nunosousa/TelescopeMirrorTester/CAD/CAD files/UM90S.png

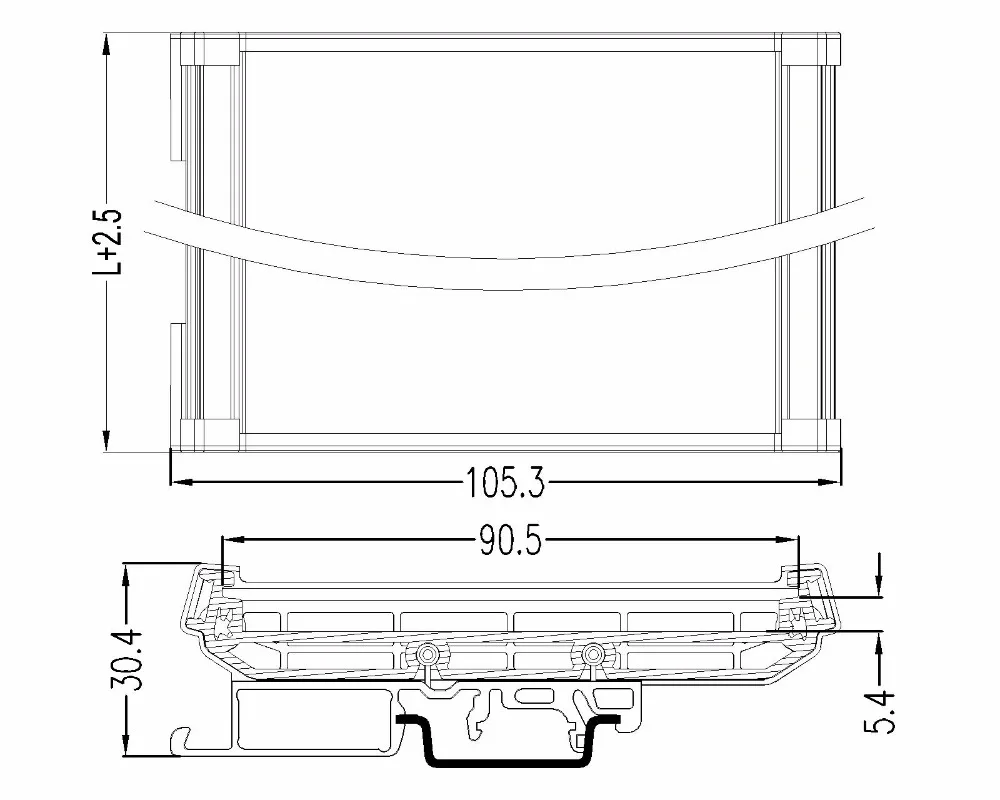
CAD/CAD files/UM90S.png
