nunosousa/TelescopeMirrorTester/CAD/Rail support/H54447d9d5b0a41b6863aeb1bf7cac8f4W.webp

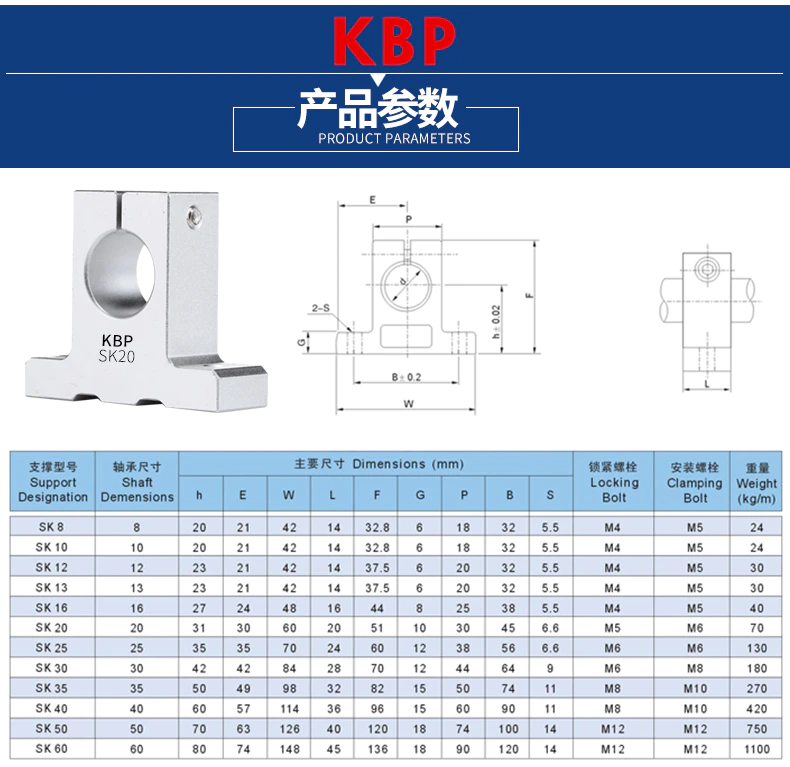
CAD/Rail support/H54447d9d5b0a41b6863aeb1bf7cac8f4W.webp
