nunosousa/TelescopeMirrorTester/CAD/Rail support/HTB1I.vIcCWD3KVjSZSgq6ACxVXax.webp

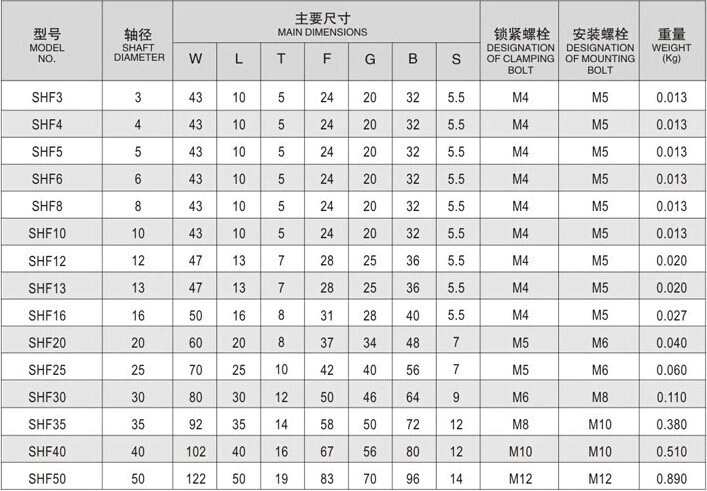
CAD/Rail support/HTB1I.vIcCWD3KVjSZSgq6ACxVXax.webp
