nunosousa/TelescopeMirrorTester/CAD/Rail support/HTB1lkTEcvWG3KVjSZPcq6zkbXXaa.webp

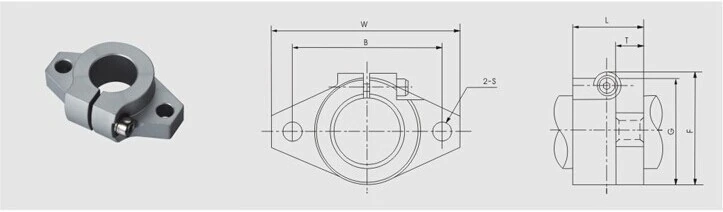
CAD/Rail support/HTB1lkTEcvWG3KVjSZPcq6zkbXXaa.webp
