nunosousa/TelescopeMirrorTester/Software/Jupyter Notebooks/Shadowgram analysis/Datasets/(165) 13_06_2019/1/Image_0.3.png

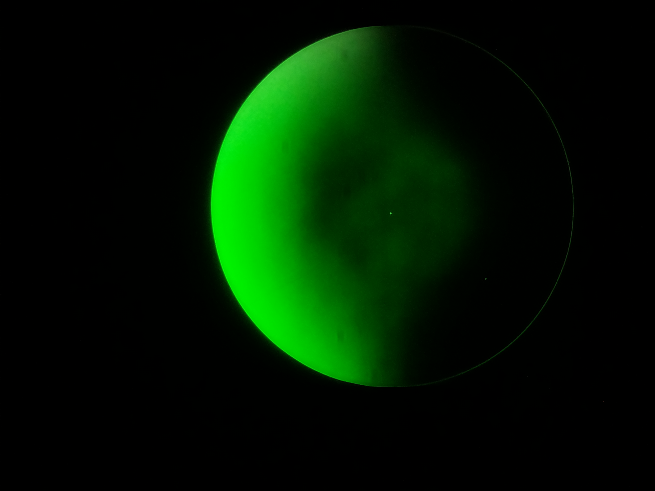
Software/Jupyter Notebooks/Shadowgram analysis/Datasets/(165) 13_06_2019/1/Image_0.3.png
