nunosousa/TelescopeMirrorTester/Tester/CAD/3D_Stage_Assembly.FCStd

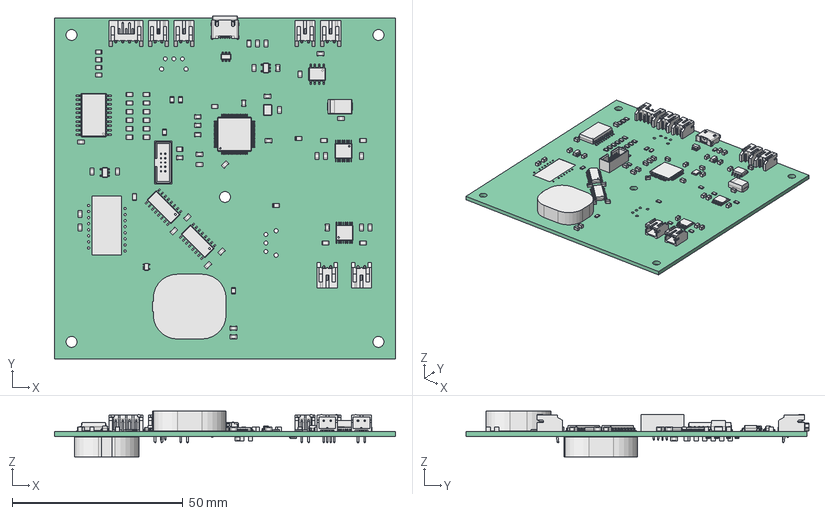
[picture p14: CAD file, 2021-06-24]
Tester/CAD/3D_Stage_Assembly.FCStd
100.0 x 100.5 x 13.4 mm
Pcb_7b95
U9_Body_5EACCE19 x 2
J6_3220-10-0100-00_5EB1DA68
J9_629105150521_5EAFFDDF[2]
U15_TQFP_64_10x10mm_P05mm_5EB077FD
R32_R_0805_2012Metric_5EACCCC9 x 32
Y2_Crystal_SMD_3225-4Pin_3.2x2.5mm_HandSoldering_5EACF838
C44_C_0805_2012Metric_5EACF763 x 44
U14_TSSOP_16_44x5mm_P065mm_5EACCE9F x 2
U13_SOT_353_SC_70_5_5EACCE7F
U12_SOIC_16_39x99mm_P127mm_5EAE1148 x 2
U11_SOT_23_5_5EACCE48 x 2
U6_SOIC_8_39x49mm_P127mm_5EACCDB5
U5_SO_20_128x75mm_P127mm_5EAE9272
U2_SOT_23_6_5EB04936
J13_JST_S4B_PH_K_5EACCA7D
J12_JST_S2B_PH_K_5EACCA4C x 6
FB2_L_0805_2012Metric_5EACF6C7 x 2
C11_CP_EIA_7343_31_Kemet_D_5EACC65A
