nunosousa/TelescopeMirrorTester/CAD/Assemblies/Elevation_Plate_Assembly.FCStd

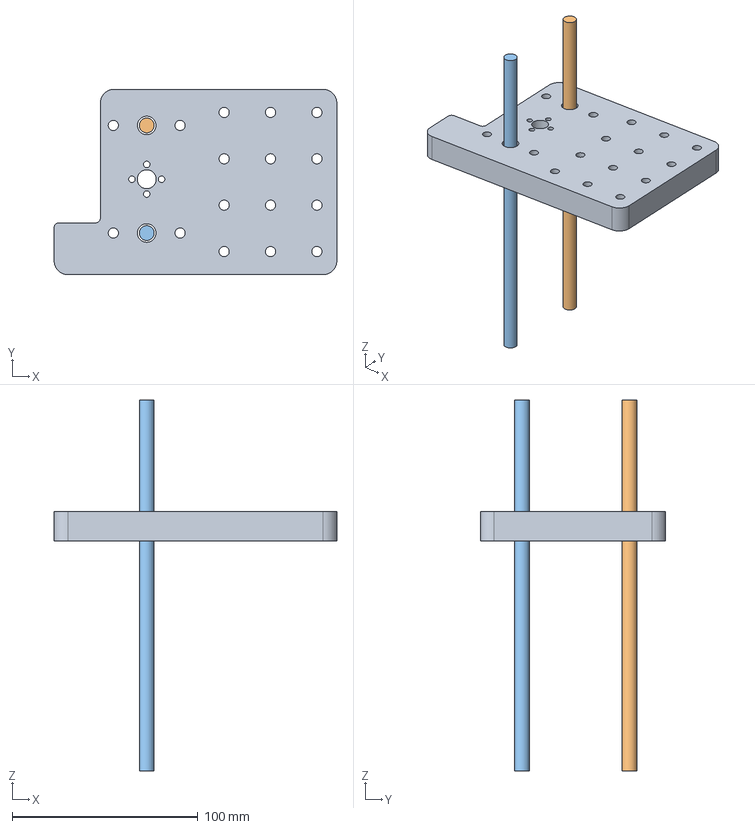
[picture p15: CAD file, 2025-04-18]
CAD/Assemblies/Elevation_Plate_Assembly.FCStd
152.4 x 100.0 x 200.0 mm
Translation_Stage_XYZ_b-Elevation_PlatePad003_001
Rod_200mm_001
Rod_200mm_002
