nunosousa/TelescopeMirrorTester/CAD/Micrometer/Micrometer_Assembly_25mm.FCStd

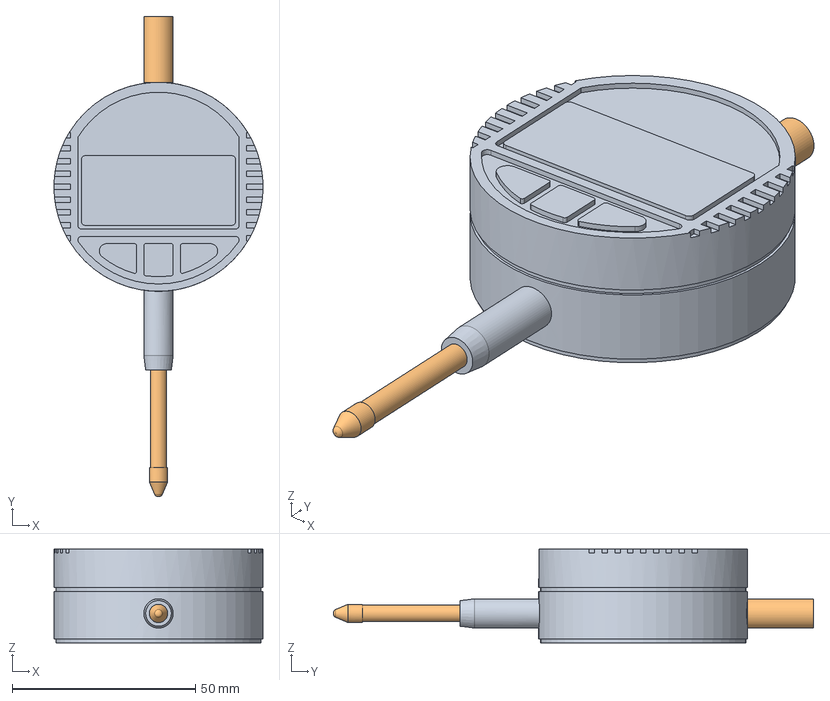
[picture p16: CAD file, 2022-04-01]
CAD/Micrometer/Micrometer_Assembly_25mm.FCStd
57.0 x 131.0 x 25.5 mm
Micrometer_Body_001
Micrometer_Plunger_001
