nunosousa/TelescopeMirrorTester/CAD/Assemblies/Z_Translation_Assembly.FCStd

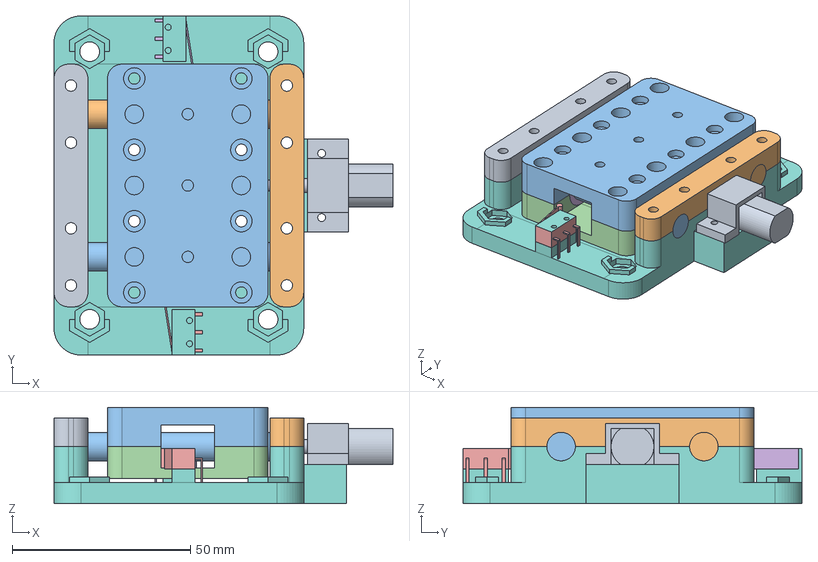
[picture p17: CAD file, 2022-08-31]
CAD/Assemblies/Z_Translation_Assembly.FCStd
95.0 x 95.0 x 27.0 mm
DC_Motor_Assembly_001
Rod_70mm_001
Rod_70mm_002
Bushing_001
Bushing_002
Bushing_003
Bushing_004
Base
Brace_front
Brace_back
Top
Brace_top
Limit_Switch_001
Limit_Switch_002
