nunosousa/TelescopeMirrorTester/CAD/Assemblies/Foucault_Assembly.FCStd

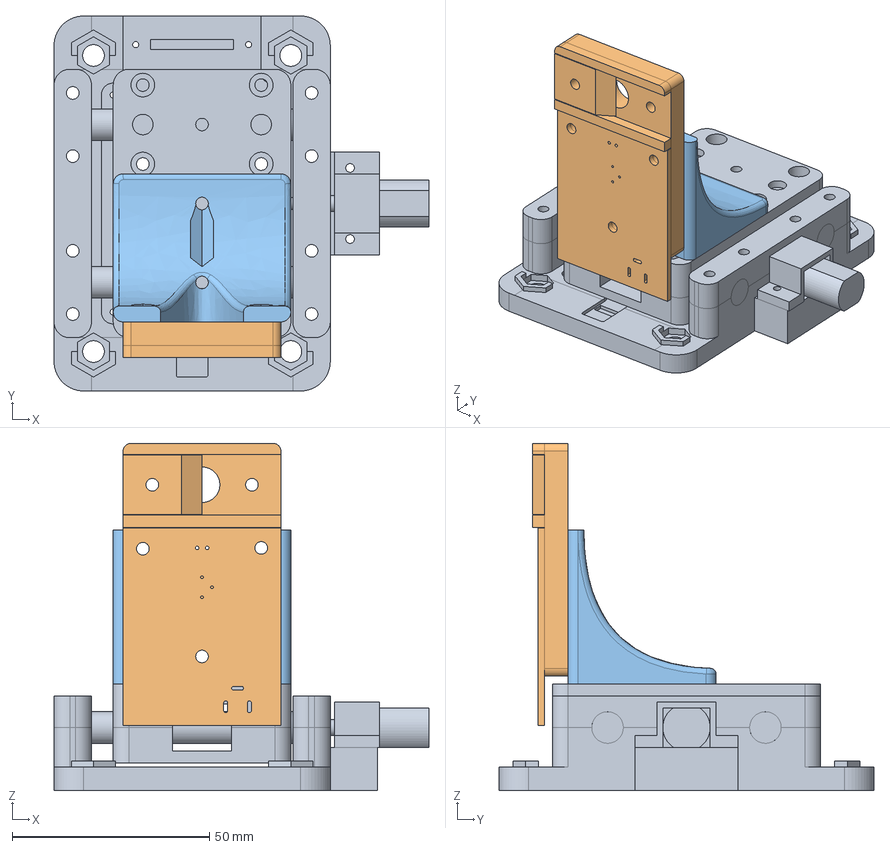
[picture p18: CAD file, 2022-07-24]
CAD/Assemblies/Foucault_Assembly.FCStd
95.0 x 95.0 x 88.0 mm
Z_Translation_Assembly_001
Foucault_test_head_001
Test_head_support
