nunosousa/TelescopeMirrorTester/CAD/Assemblies/X_Translation_Assembly_w_Micrometer.FCStd

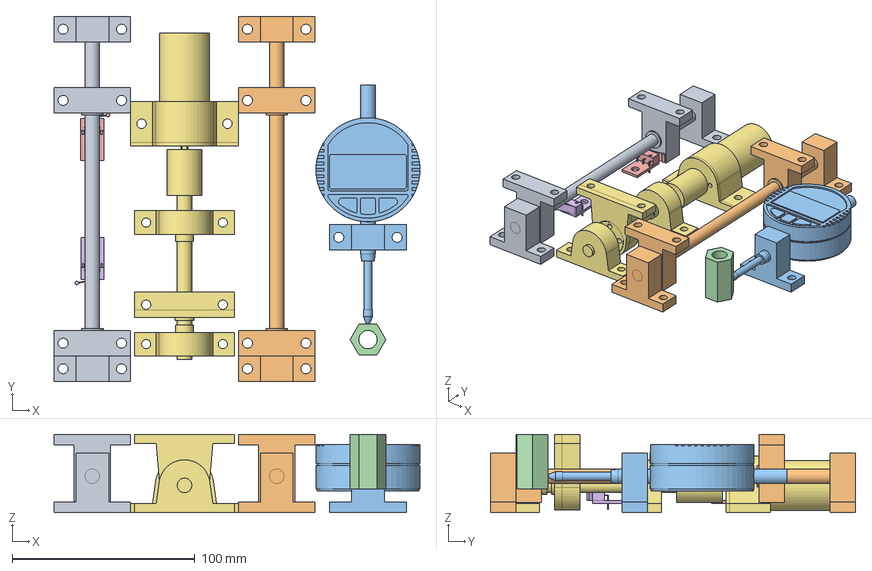
[picture p19: CAD file, 2022-06-13]
CAD/Assemblies/X_Translation_Assembly_w_Micrometer.FCStd
200.5 x 200.0 x 43.0 mm
Translation_axis_200mm_25mm_001
Translation_axis_200mm_25mm_002
Monted_Micrometer_001
Hex_Spacer_Nut_001
Limit_Switch_Board_001
Limit_Switch_Board_002
Position_screw_assembly_w_Motor_001
