nunosousa/TelescopeMirrorTester/CAD/Assemblies/Y_Translation_Assembly.FCStd

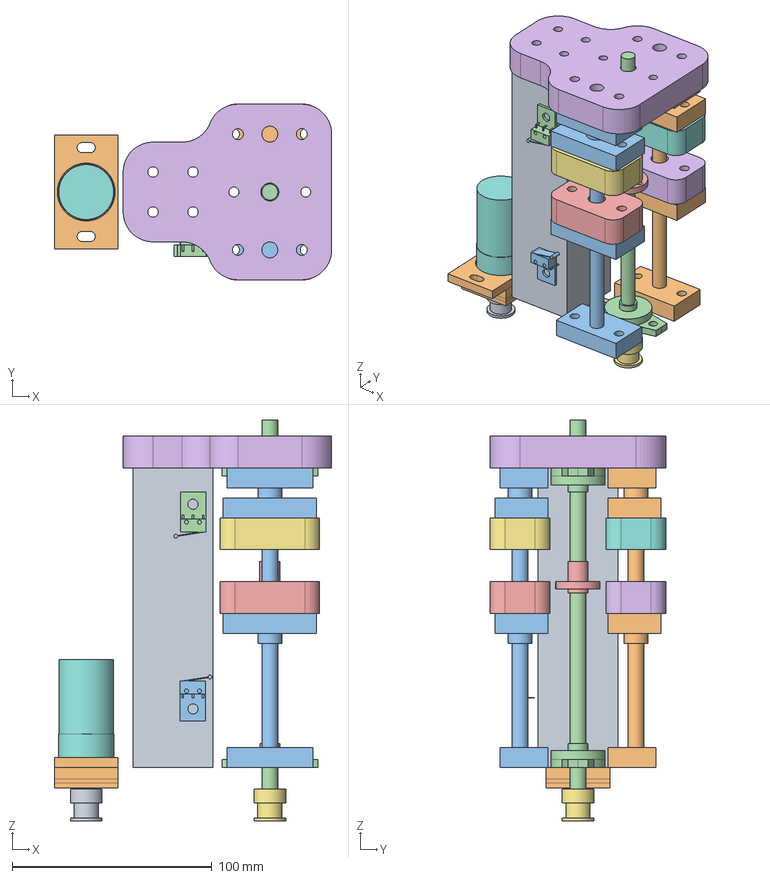
[picture p20: CAD file, 2022-06-13]
CAD/Assemblies/Y_Translation_Assembly.FCStd
139.0 x 88.0 x 200.9 mm
4040_profile_001
Translation_axis_150mm_vertical_001
Translation_axis_150mm_vertical_002
Position_screw_assembly_vertical_001
T8_nut_001
Top
GT2_20_pulley_001
DC_Motor_001
GT2_20_pulley_002
Motor_Mount
Limit_Switch_Board_001
Limit_Switch_Board_002
Stabilizer
Stabilizer001
Stabilizer002
Stabilizer003
