nunosousa/TelescopeMirrorTester/CAD/CAD files/Y_Translation_Assembly-Stabilizer003.iges

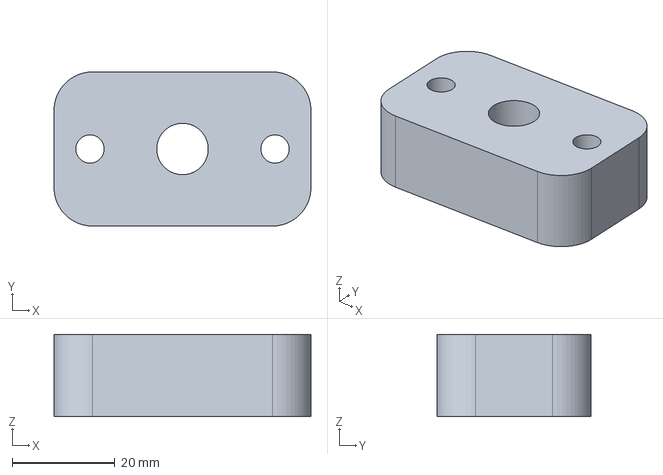
[picture p21: CAD file, 2022-06-13]
CAD/CAD files/Y_Translation_Assembly-Stabilizer003.iges
50.0 x 30.0 x 16.0 mm
