nunosousa/TelescopeMirrorTester/CAD/Assemblies/Base_X_Translation_Assembly_w_Motor.FCStd

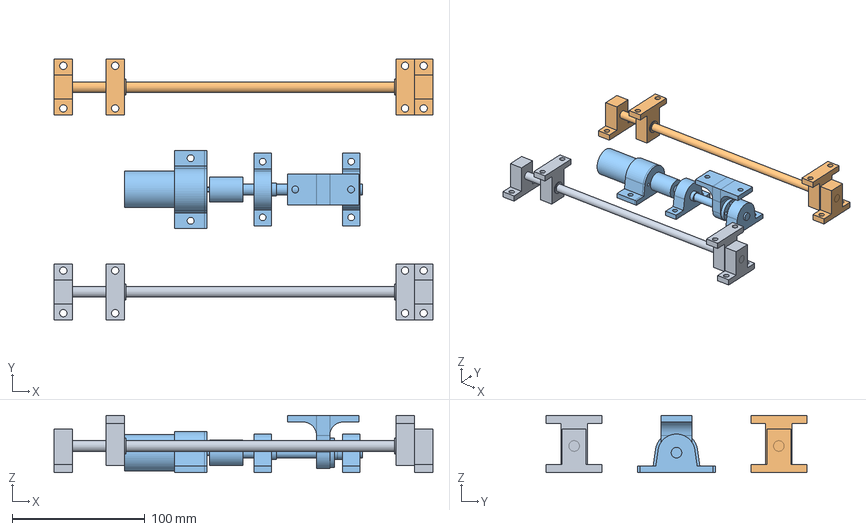
[picture p22: CAD file, 2022-06-04]
CAD/Assemblies/Base_X_Translation_Assembly_w_Motor.FCStd
285.0 x 196.0 x 43.0 mm
Translation_axis_285mm_25mm_001
Translation_axis_285mm_25mm_002
Position_screw_assembly_001
