nunosousa/TelescopeMirrorTester/CAD/Assemblies/DC_Motor_Assembly.FCStd

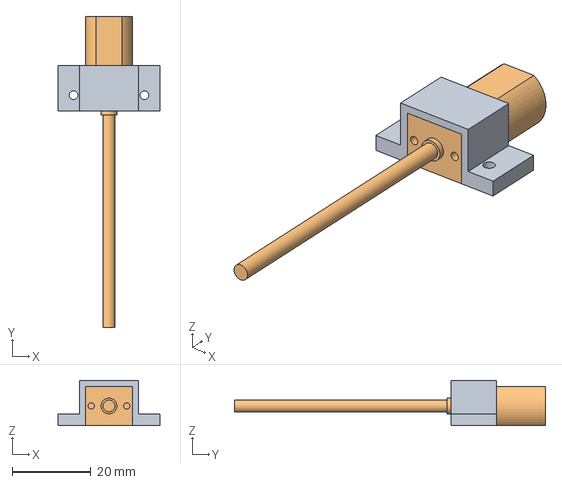
[picture p23: CAD file, 2022-05-07]
CAD/Assemblies/DC_Motor_Assembly.FCStd
26.0 x 79.0 x 11.5 mm
Motor mount
Motor
