nunosousa/TelescopeMirrorTester/CAD/CAD files/Y_Translation_Assembly-Motor_Mount.iges

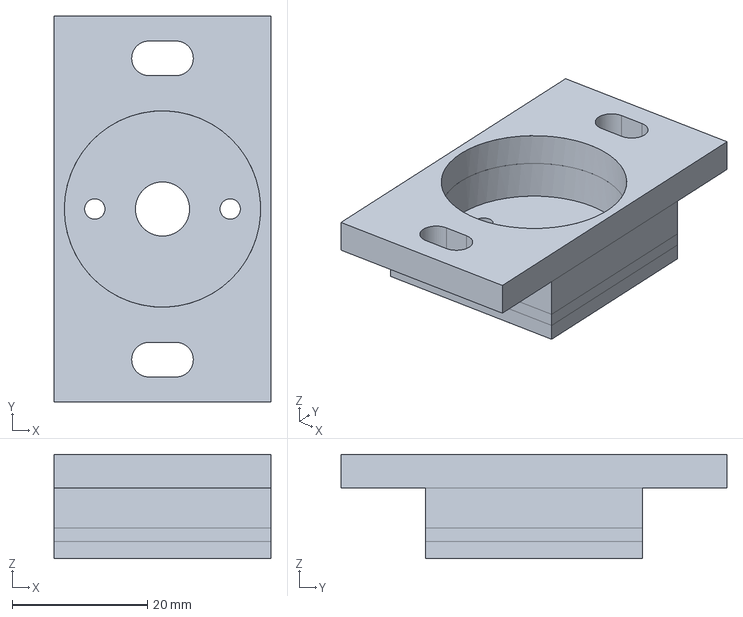
[picture p24: CAD file, 2022-06-13]
CAD/CAD files/Y_Translation_Assembly-Motor_Mount.iges
32.0 x 57.0 x 15.4 mm
