nunosousa/TelescopeMirrorTester/CAD/CAD files/Y_Translation_Assembly-Top.iges

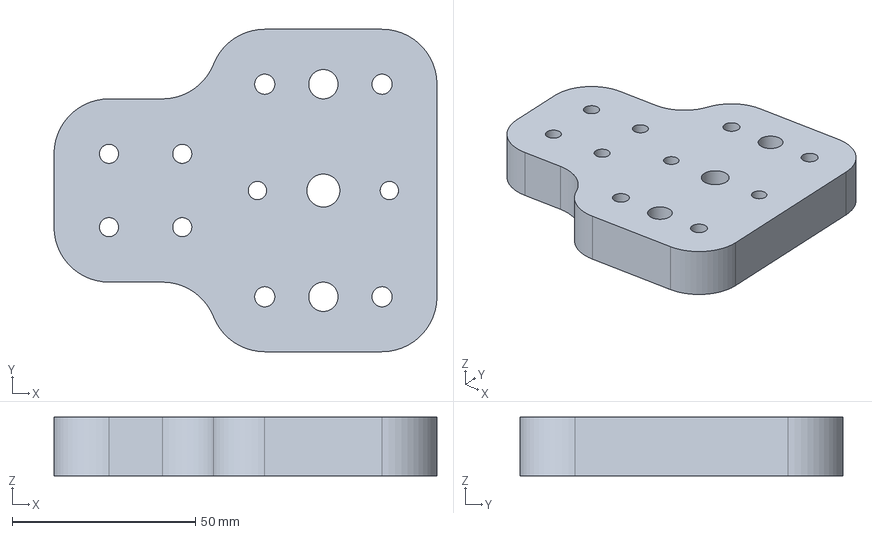
[picture p25: CAD file, 2022-06-13]
CAD/CAD files/Y_Translation_Assembly-Top.iges
104.5 x 88.0 x 16.0 mm
