nunosousa/TelescopeMirrorTester/CAD/Assemblies/Arduino_Mega_mount.FCStd

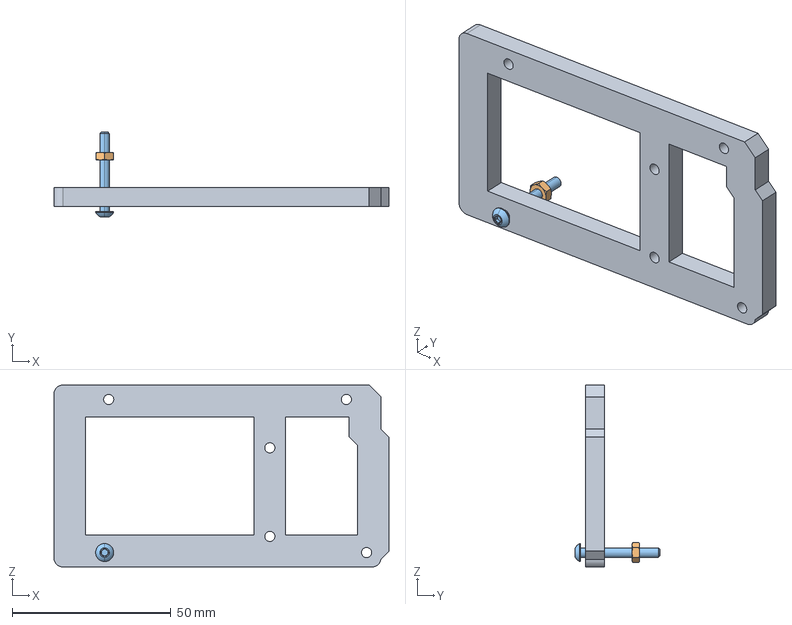
[picture p26: CAD file, 2025-05-03]
CAD/Assemblies/Arduino_Mega_mount.FCStd
105.6 x 26.7 x 57.3 mm
ArduinoMount
90591A250_NO THREADS_Zinc-Plated Steel Hex Nut1_001
97763A457_NO THREADS_18-8 Stainless Steel Button Head Hex Drive Screws1_001
