nunosousa/TelescopeMirrorTester/CAD/CAD files/Connectors/EP501A.STEP

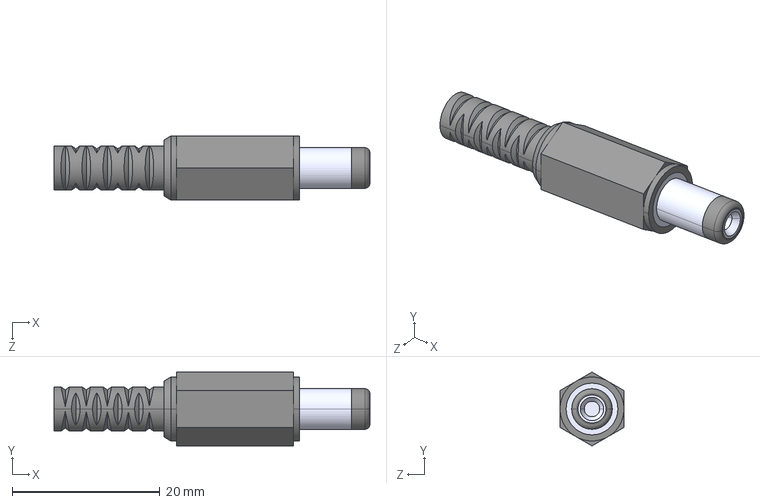
[picture p27: CAD file, 2025-05-03]
CAD/CAD files/Connectors/EP501A.STEP
42.8 x 10.0 x 8.66 mm
