nunosousa/TelescopeMirrorTester/CAD/CAD files/Couplers/CXJJ-D-D16-d3-e8.step

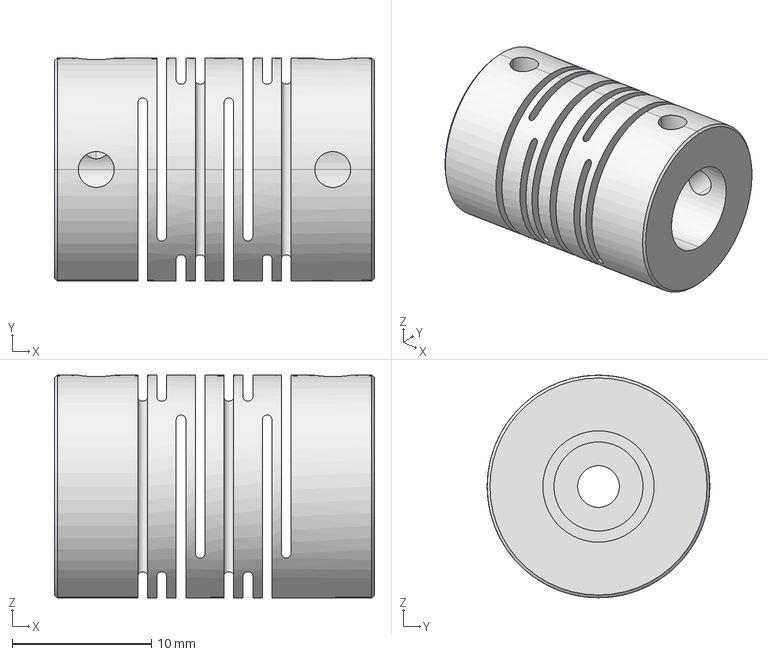
[picture p28: CAD file, 2025-05-02]
CAD/CAD files/Couplers/CXJJ-D-D16-d3-e8.step
23.0 x 16.0 x 16.0 mm
