nunosousa/TelescopeMirrorTester/CAD/CAD files/Motors/Micro_DC_Gearmotor-90_Degree.step

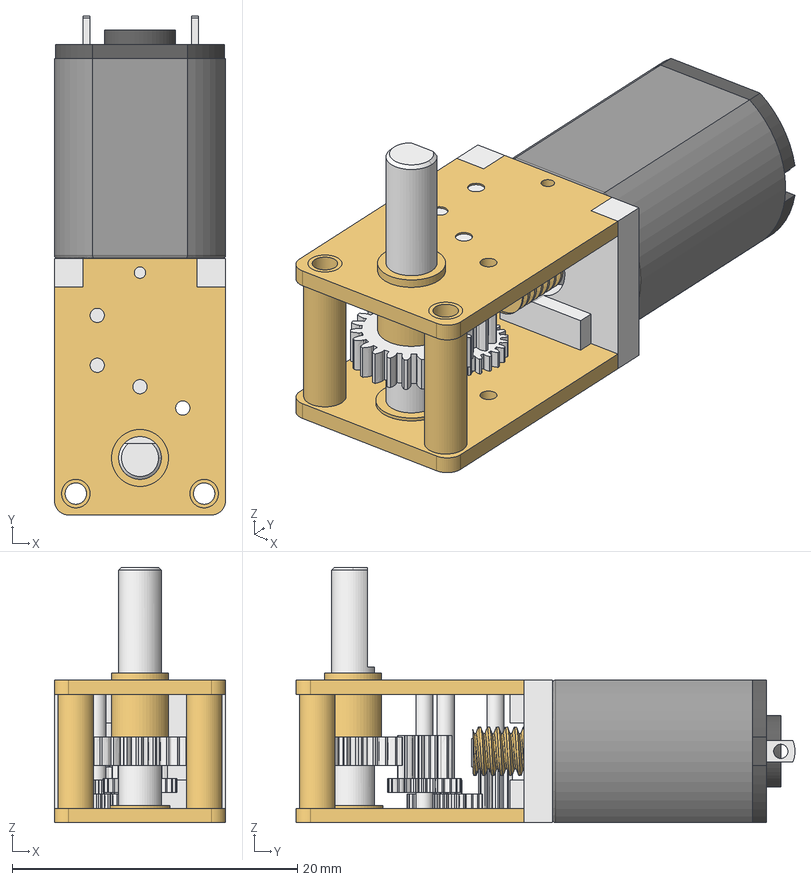
[picture p29: CAD file, 2025-05-03]
CAD/CAD files/Motors/Micro_DC_Gearmotor-90_Degree.step
12.0 x 35.0 x 17.9 mm
Körper
Lager
Kontakt
Kontakt001
MotorPlate
GearCase_Top
GearCase_Bot
Welle
Welle_001
Welle_002
Welle_003
WormGear
InvoluteGear
InvoluteGear001
InvoluteGear002
InvoluteGear003
InvoluteGear004
InvoluteGear005
InvoluteGear006
Huelse
Huelse001
Tube006
