nunosousa/TelescopeMirrorTester/CAD/Micrometer/Micrometer_Plunger.FCStd

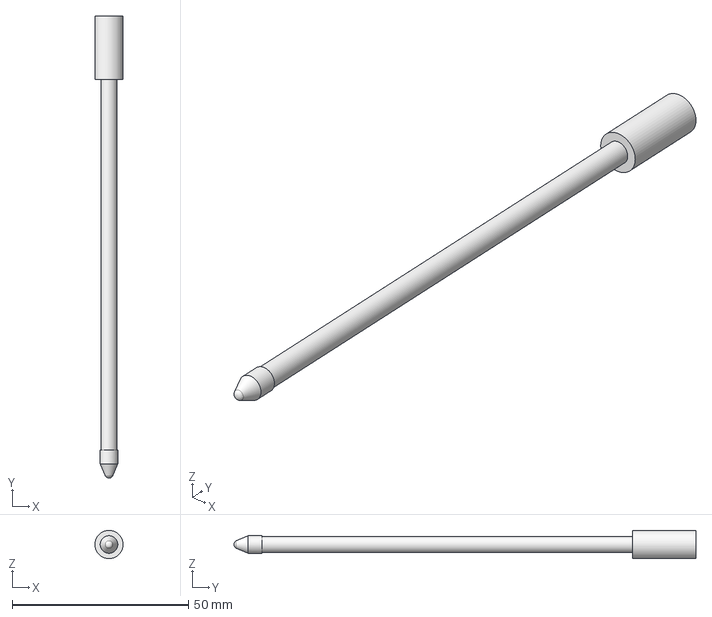
[picture p30: CAD file, 2022-04-01]
CAD/Micrometer/Micrometer_Plunger.FCStd
7.99 x 131.0 x 8.00 mm
