nunosousa/TelescopeMirrorTester/CAD/Misc/Disc_Magnet_6x3.FCStd

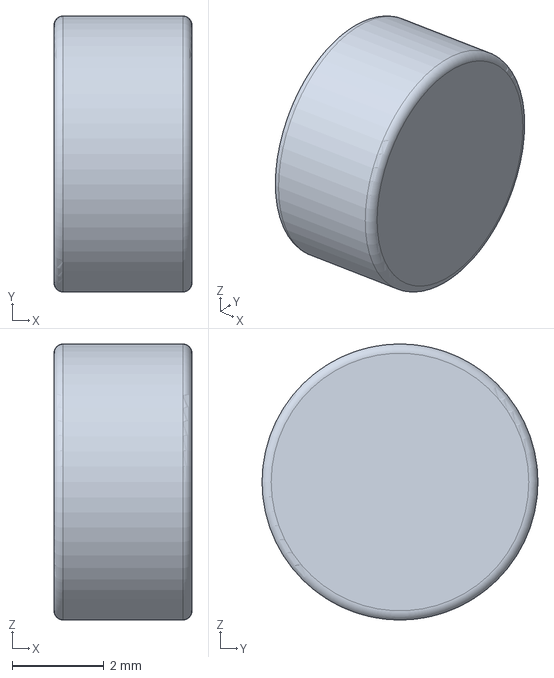
[picture p31: CAD file, 2025-04-09]
CAD/Misc/Disc_Magnet_6x3.FCStd
3.00 x 6.00 x 6.00 mm
