nunosousa/TelescopeMirrorTester/CAD/Rail support/Rod_70mm.FCStd

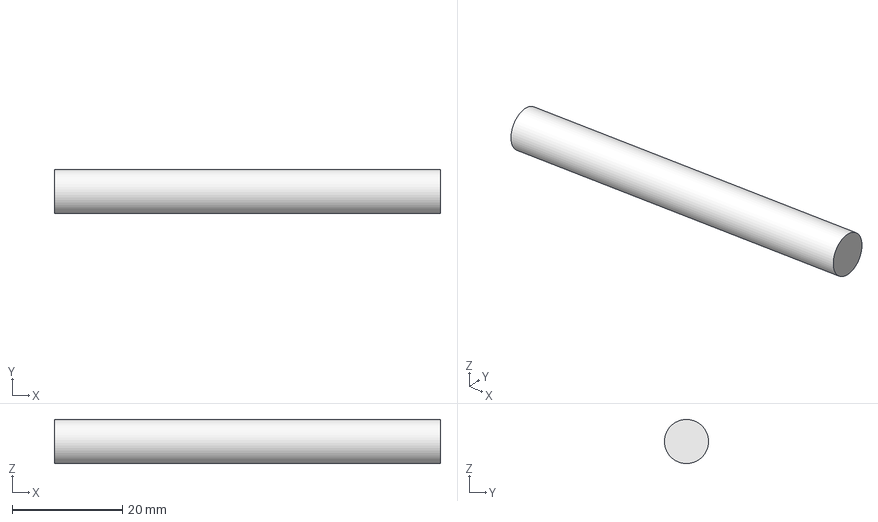
[picture p32: CAD file, 2022-07-12]
CAD/Rail support/Rod_70mm.FCStd
70.0 x 7.99 x 8.00 mm
