nunosousa/TelescopeMirrorTester/CAD/Translation_Stage_XYZ.FCStd

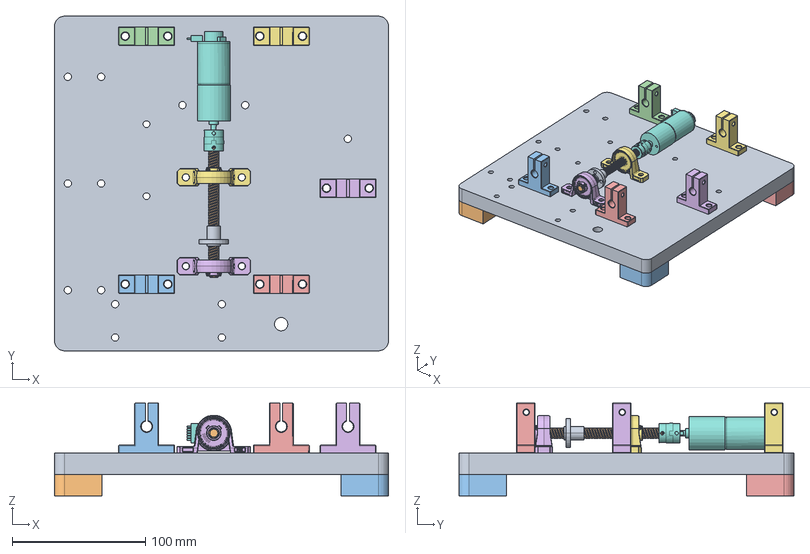
[picture p33: CAD file, 2025-05-02]
CAD/Translation_Stage_XYZ.FCStd
250.5 x 251.0 x 69.5 mm
Translation_Stage_XYZ_b-Base_Plate1_001
Translation_Stage_XYZ_b-Foot1_001
Translation_Stage_XYZ_b-Foot1_002
Translation_Stage_XYZ_b-Foot1_003
Translation_Stage_XYZ_b-Foot1_004
KP08_001
KP08_002
JGA25-371_12VDC_18RPM1_001
T8 nut1_001
Linear_rod_100mm1_001
SK8_001
SK8_002
SK8_003
SK8_004
SK8_005
CXHY-15-d4-e9_001
