nunosousa/TelescopeMirrorTester/ECAD/BDCMotorControlBoard/BDCMotorControlBoard.step

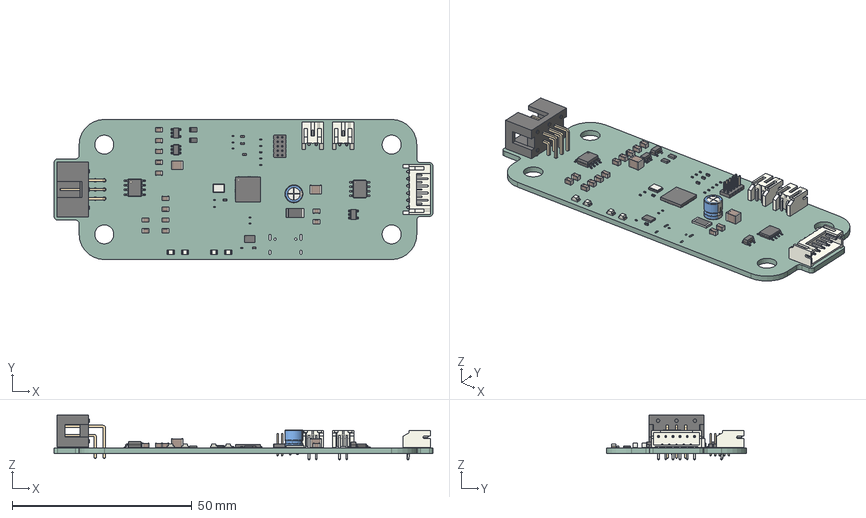
[picture p34: CAD file, 2025-05-23]
ECAD/BDCMotorControlBoard/BDCMotorControlBoard.step
105.5 x 39.0 x 12.5 mm
C_0805_2012Metric x 13
JST_PH_S2B-PH-K_1x02_P2.00mm_Horizontal x 2
C_0201_0603Metric x 11
Crystal_SMD_3225-4Pin_3.2x2.5mm
C_0402_1005Metric x 4
PinHeader_2x05_P1.27mm_Vertical
C_1210_3225Metric x 2
SOIC-8_3.9x4.9mm_P1.27mm
R_2010_5025Metric
R_0201_0603Metric x 2
IDC-Header_2x03_P2.54mm_Horizontal
LED_0805_2012Metric x 4
SOT-23-5 x 2
Texas_HTSOP-8-1EP_3.9x4.9mm_P1.27mm_EP2.85x4.9mm_Mask2.4x3.1mm_ ThermalVias
R_0805_2012Metric x 2
JST_PH_S6B-PH-K_1x06_P2.00mm_Horizontal
CP_Radial_D5.0mm_P2.00mm
R_0402_1005Metric
SOT-23-6
Winbond_USON-8-1EP_3x2mm_P0.5mm_EP0.2x1.6mm
QFN-56-1EP_7x7mm_P0.4mm_EP3.2x3.2mm
BDCMotorControlBoard_PCB
