nunosousa/TelescopeMirrorTester/ECAD/LightSource/LightSource.step

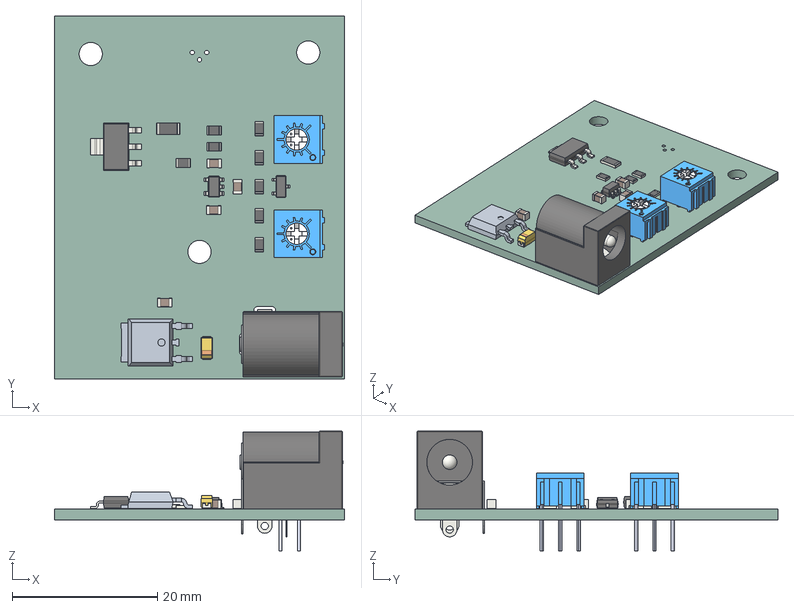
[picture p35: CAD file, 2025-04-15]
ECAD/LightSource/LightSource.step
40.0 x 50.0 x 16.5 mm
C_0805_2012Metric x 4
CP_EIA-3216-18_Kemet-A
BarrelJack_Horizontal
R_0805_2012Metric x 8
R_1206_3216Metric
3362P-1-501LF x 2
LightSource 1.10.1
SOT-223
SOT-23
SOT-23-5
LightSource_PCB
