nunosousa/TelescopeMirrorTester/ECAD/LimitSwitchBoard/LimitSwitchBoard.step

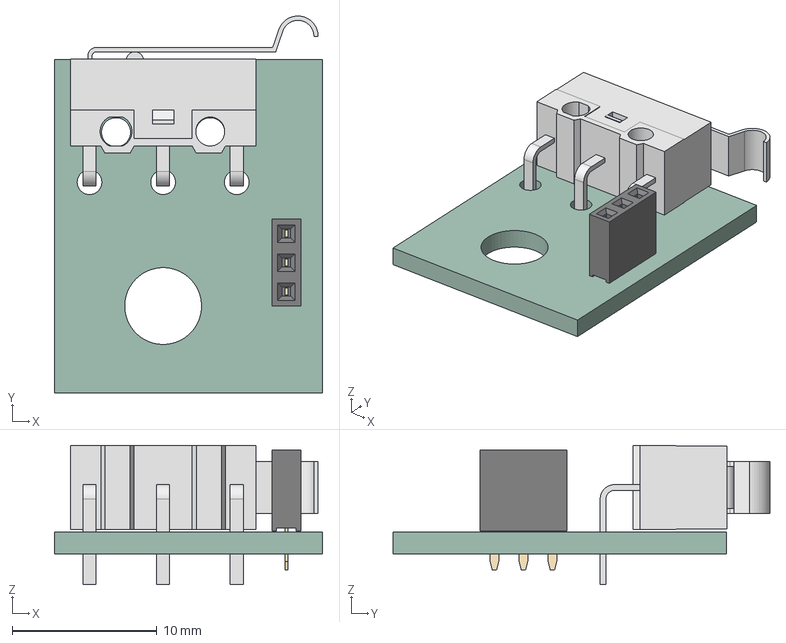
[picture p36: CAD file, 2025-04-19]
ECAD/LimitSwitchBoard/LimitSwitchBoard.step
18.5 x 26.0 x 9.60 mm
PinSocket_1x03_P2.00mm_Vertical
LimitSwitchBoard_PCB
