nunosousa/TelescopeMirrorTester/ECAD/PowerDeliveryBoard/PowerDeliveryBoard.step

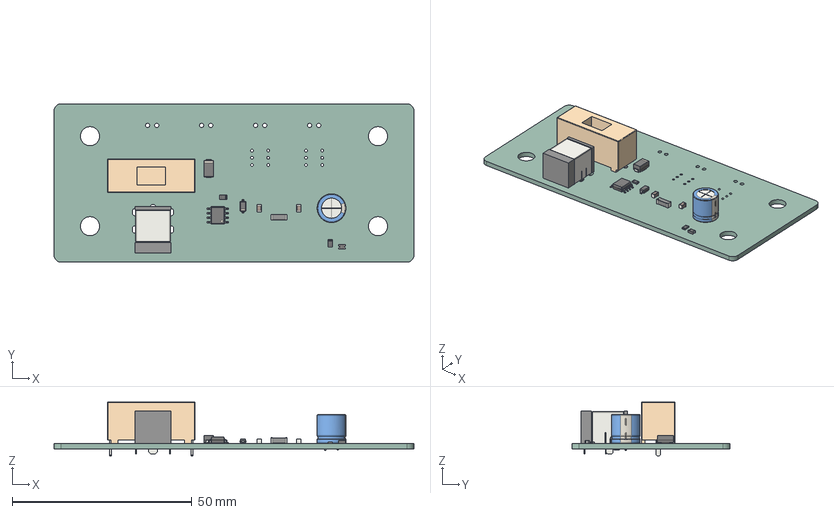
[picture p37: CAD file, 2025-05-01]
ECAD/PowerDeliveryBoard/PowerDeliveryBoard.step
100.0 x 44.0 x 15.0 mm
C_0805_2012Metric x 2
D_0805_2012Metric
CP_Radial_D8.0mm_P3.50mm
Fuseholder_Cylinder-5x20mm_Stelvio-Kontek_PTF78_Horizontal_Open
R_0805_2012Metric x 2
BarrelJack_CUI_PJ-063AH_Horizontal
D_SMA
L_1806_4516Metric
SOIC-8_3.9x4.9mm_P1.27mm
D_SOD-123
PowerDeliveryBoard_PCB
