nunosousa/TelescopeMirrorTester/ECAD/RotationEncoder/RotationEncoder.step

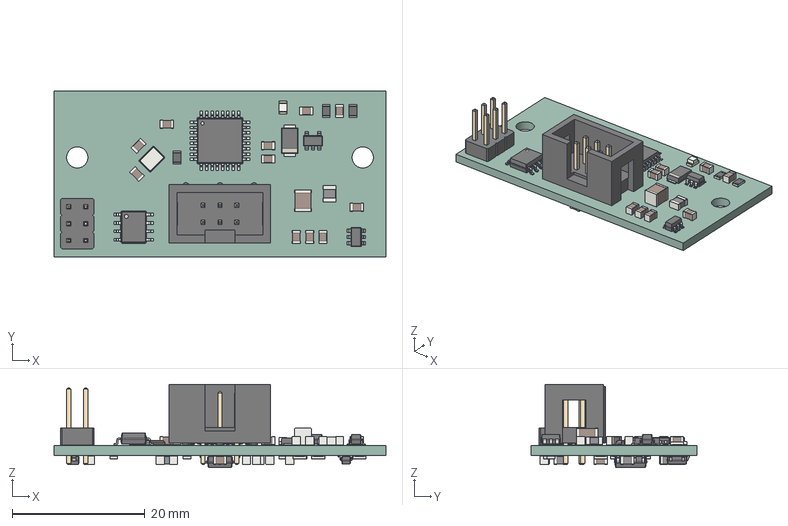
[picture p38: CAD file, 2025-04-09]
ECAD/RotationEncoder/RotationEncoder.step
50.0 x 25.0 x 12.5 mm
C_0805_2012Metric x 17
LED_0805_2012Metric
SOT-23-6
L_1008_2520Metric
SOIC-8_3.9x4.9mm_P1.27mm x 2
IDC-Header_2x03_P2.54mm_Vertical
SOT-23-5
R_0805_2012Metric x 11
TQFP-32_7x7mm_P0.8mm
D_SOD-128
Crystal_SMD_3225-4Pin_3.2x2.5mm
PinHeader_2x03_P2.54mm_Vertical
C_1210_3225Metric
L_0805_2012Metric x 4
SOT-23
D_SOD-123
RotationEncoder_PCB
