nunosousa/TelescopeMirrorTester/ECAD/RS232Board/RS232Board.step

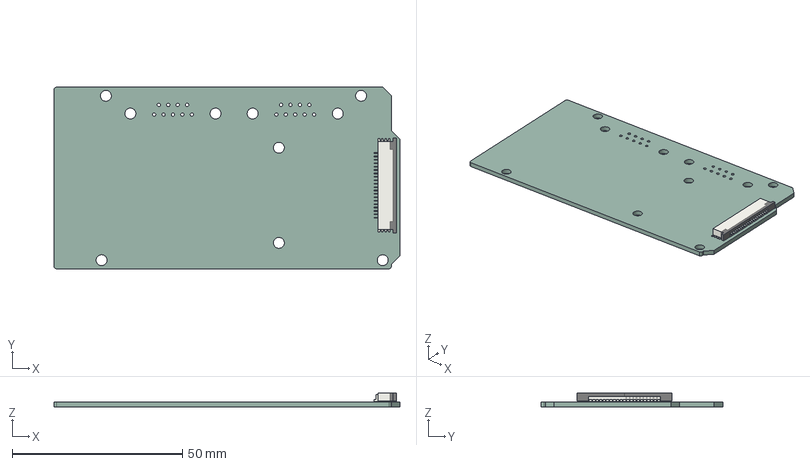
[picture p39: CAD file, 2025-05-01]
ECAD/RS232Board/RS232Board.step
101.6 x 53.3 x 4.16 mm
TE_2-84952-0_1x20-1MP_P1.0mm_Horizontal
RS232Board_PCB
