nunosousa/TelescopeMirrorTester/CAD/ArduinoMount.FCStd

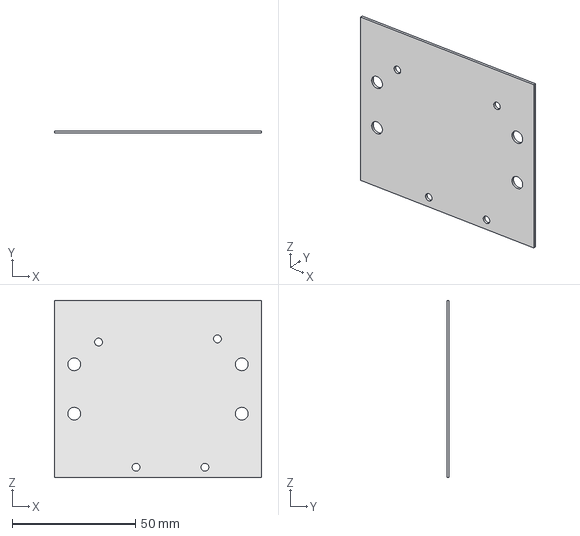
[picture p40: CAD file, 2023-01-05]
CAD/ArduinoMount.FCStd
84.0 x 1.00 x 72.0 mm
