nunosousa/TelescopeMirrorTester/CAD/CAD files/Couplers/CXHY-15-d4-e8.step

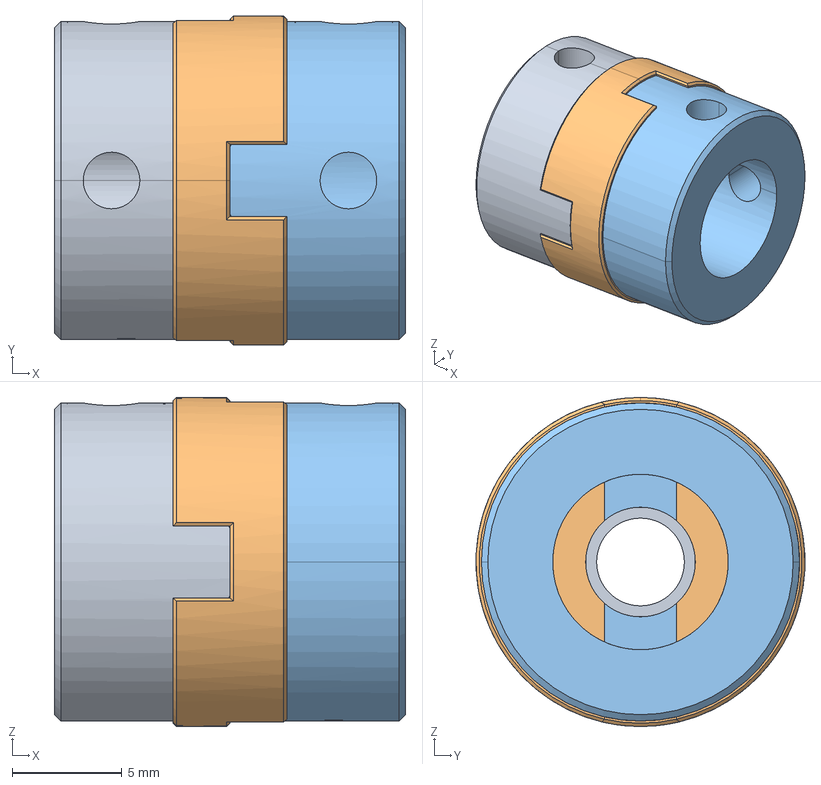
[picture p41: CAD file, 2025-05-02]
CAD/CAD files/Couplers/CXHY-15-d4-e8.step
16.0 x 15.0 x 15.0 mm
11^1746181201219
22^1746181201219
33^1746181201219
