nunosousa/TelescopeMirrorTester/CAD/CAD files/Motors/JGA25-371_12VDC_18RPM.stp

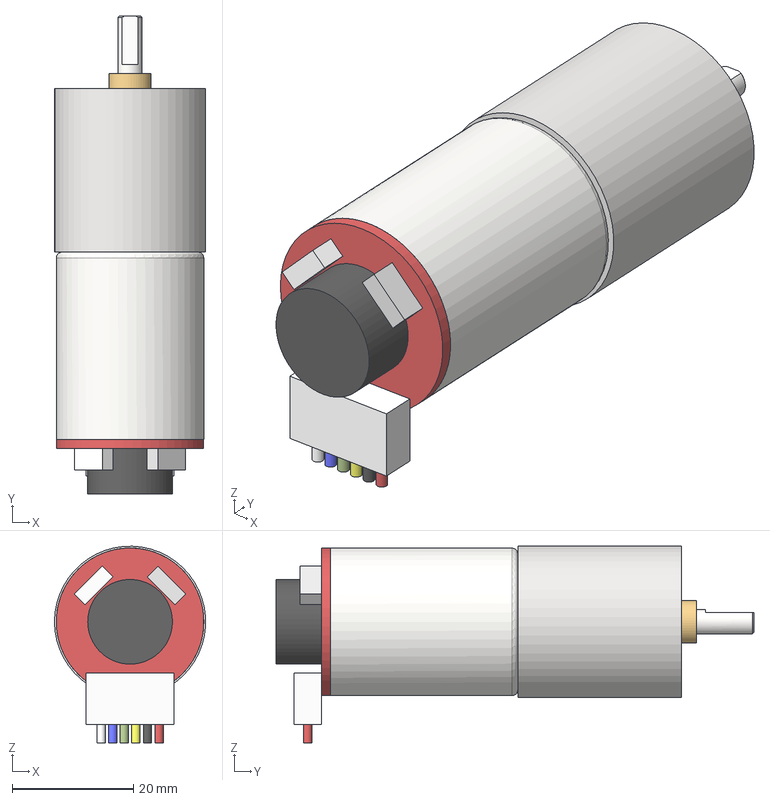
[picture p42: CAD file, 2025-05-01]
CAD/CAD files/Motors/JGA25-371_12VDC_18RPM.stp
25.0 x 79.0 x 32.5 mm
