nunosousa/TelescopeMirrorTester/CAD/CAD files/Translation_Stage_XYZ_b-Elevation_PlatePad002.step

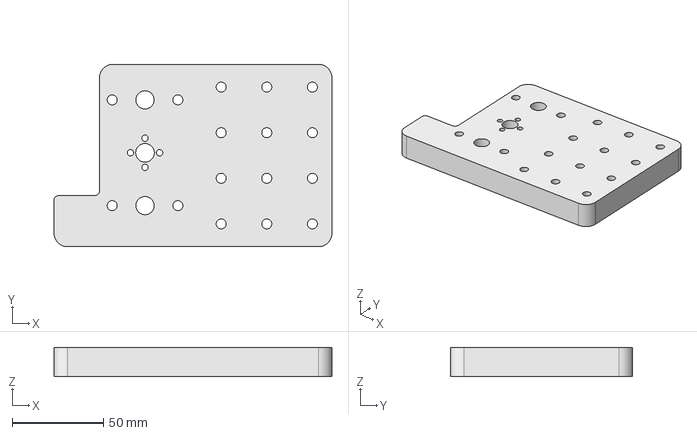
[picture p43: CAD file, 2025-05-02]
CAD/CAD files/Translation_Stage_XYZ_b-Elevation_PlatePad002.step
152.4 x 100.0 x 16.0 mm
