nunosousa/TelescopeMirrorTester/CAD/Micrometer/Micrometer_Body.FCStd

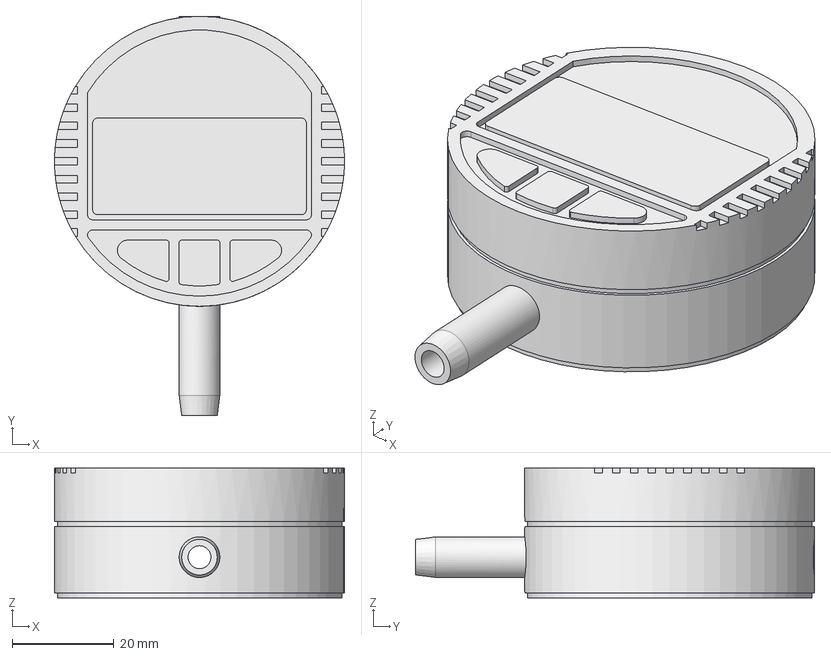
[picture p44: CAD file, 2022-04-01]
CAD/Micrometer/Micrometer_Body.FCStd
57.0 x 78.5 x 25.5 mm
