nunosousa/TelescopeMirrorTester/CAD/Misc/Knife.FCStd

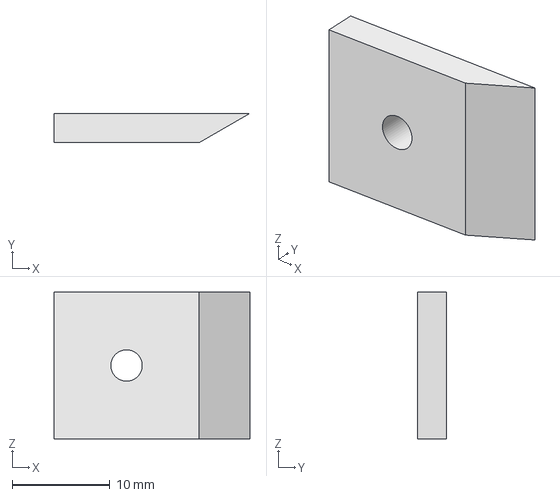
[picture p45: CAD file, 2023-07-04]
CAD/Misc/Knife.FCStd
20.0 x 3.00 x 15.0 mm
