nunosousa/TelescopeMirrorTester/CAD/Rail support/Rod_50mm.FCStd

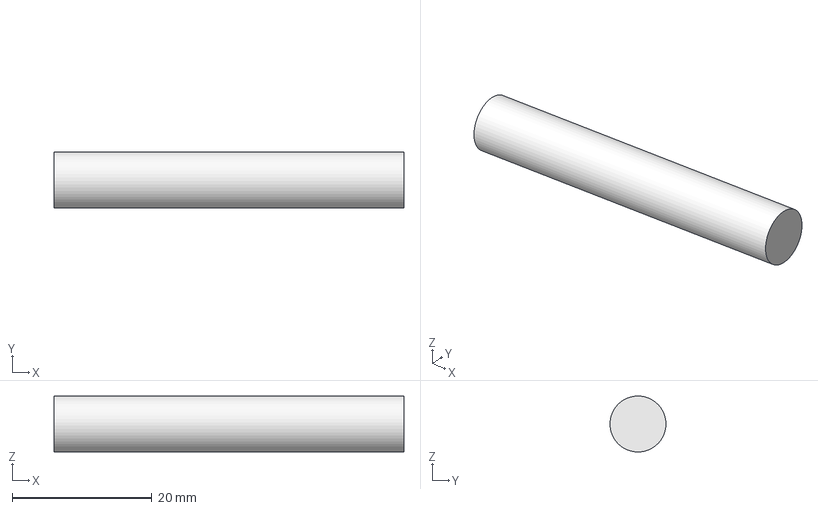
[picture p46: CAD file, 2022-07-11]
CAD/Rail support/Rod_50mm.FCStd
50.0 x 7.99 x 8.00 mm
