nunosousa/TelescopeMirrorTester/CAD/Assemblies/Encoder_KFL08.FCStd

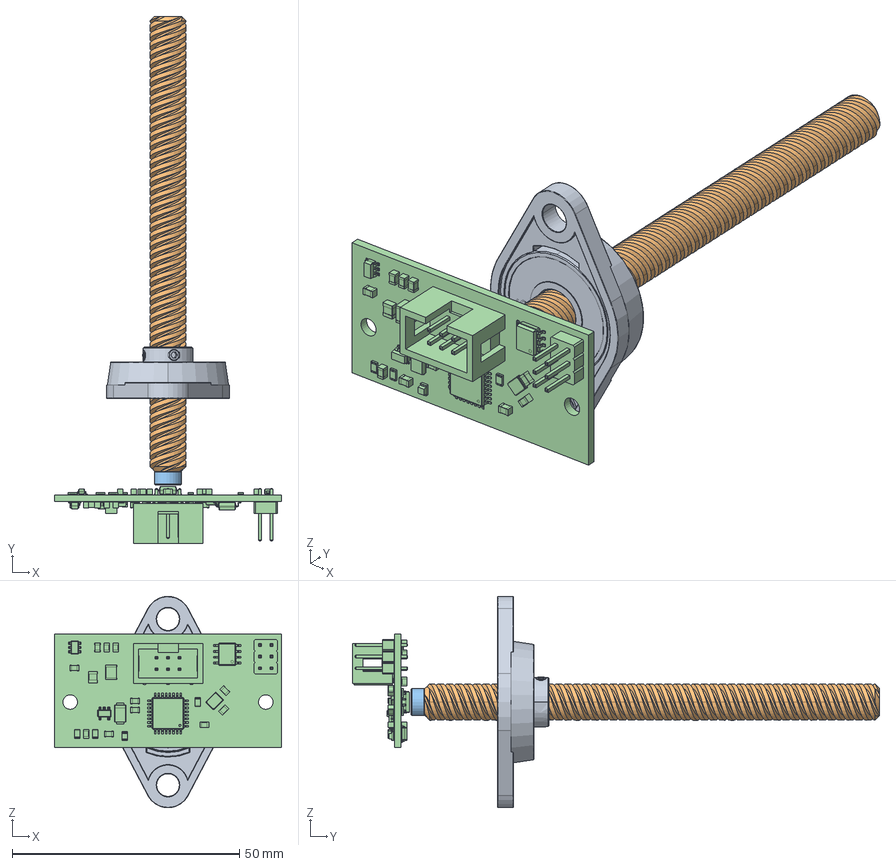
[picture p47: CAD file, 2025-04-12]
CAD/Assemblies/Encoder_KFL08.FCStd
50.0 x 115.9 x 46.5 mm
KFL08_
Linear_rod_100mm1_001
Disc_Magnet_6x3_001
RotationEncoder1_001
