nunosousa/TelescopeMirrorTester/CAD/CAD files/Translation_Stage_XYZ_b-Foot.step

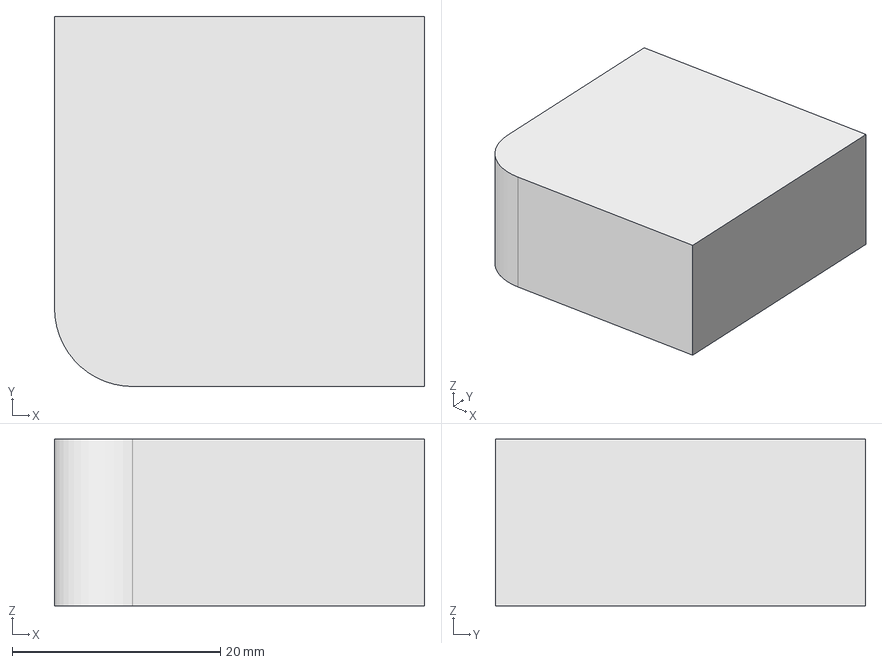
[picture p48: CAD file, 2025-05-01]
CAD/CAD files/Translation_Stage_XYZ_b-Foot.step
35.5 x 35.5 x 16.0 mm
