nunosousa/TelescopeMirrorTester/CAD/Misc/Knife_long.FCStd

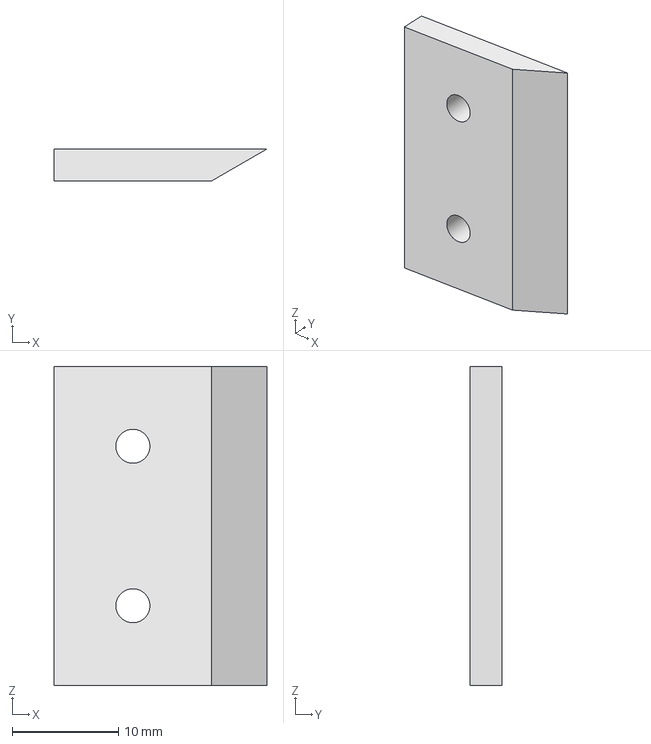
[picture p49: CAD file, 2023-07-04]
CAD/Misc/Knife_long.FCStd
20.0 x 3.00 x 30.0 mm
