nunosousa/TelescopeMirrorTester/CAD/Rail support/KFL008.FCStd

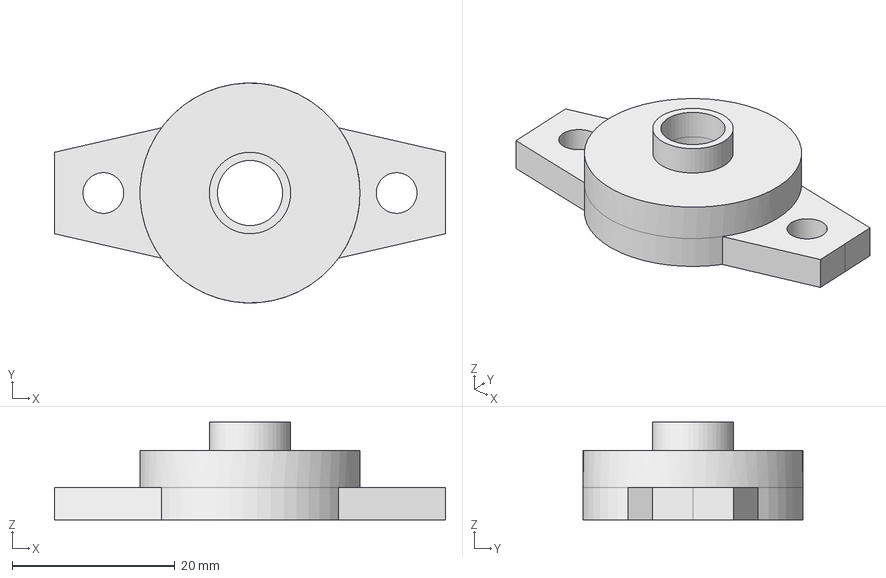
[picture p50: CAD file, 2022-06-04]
CAD/Rail support/KFL008.FCStd
48.0 x 27.0 x 12.0 mm
