nunosousa/TelescopeMirrorTester/CAD/Translation_Stage_XYZ_b.FCStd

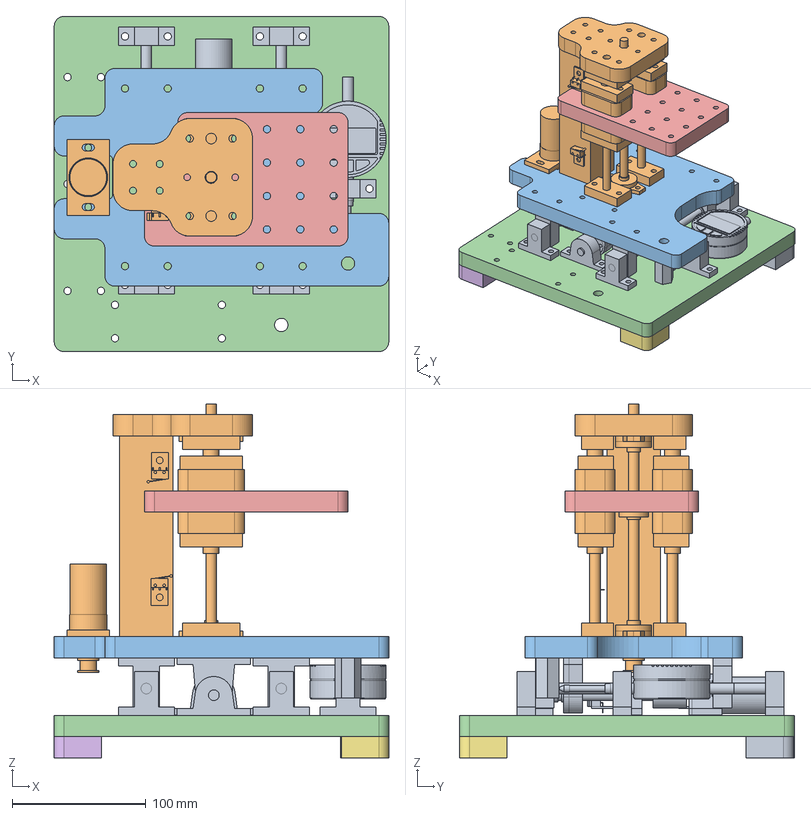
[picture p51: CAD file, 2022-06-13]
CAD/Translation_Stage_XYZ_b.FCStd
250.5 x 251.0 x 265.0 mm
X_Translation_Assembly_w_Micrometer_001
Y_Translation_Assembly_001
Mid_Plate
Base_Plate
Elevation_Plate
Foot
Foot001
Foot002
Foot003
