nunosousa/TelescopeMirrorTester/CAD/CAD files/SK12 Linear shaft holder.STEP

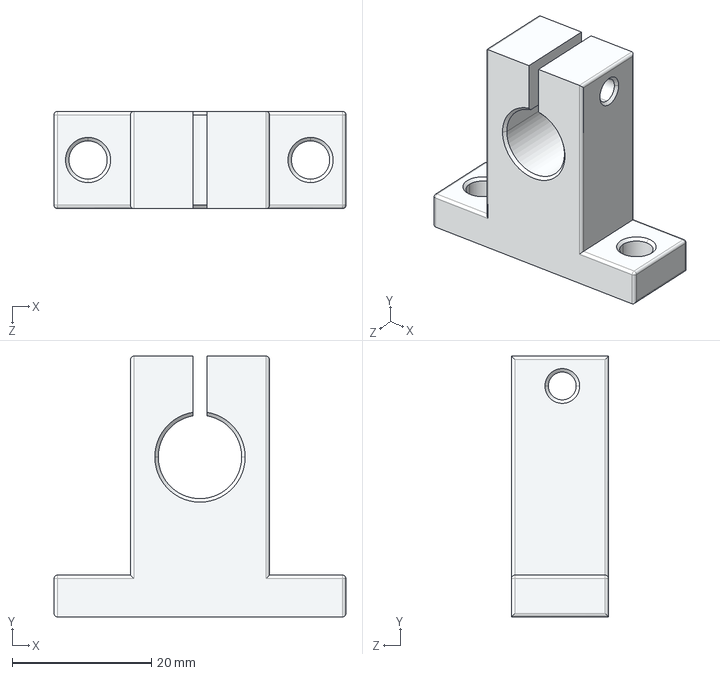
[picture p52: CAD file, 2025-05-01]
CAD/CAD files/SK12 Linear shaft holder.STEP
42.0 x 37.5 x 14.0 mm
