nunosousa/TelescopeMirrorTester/CAD/Misc/Camera_Mount.FCStd

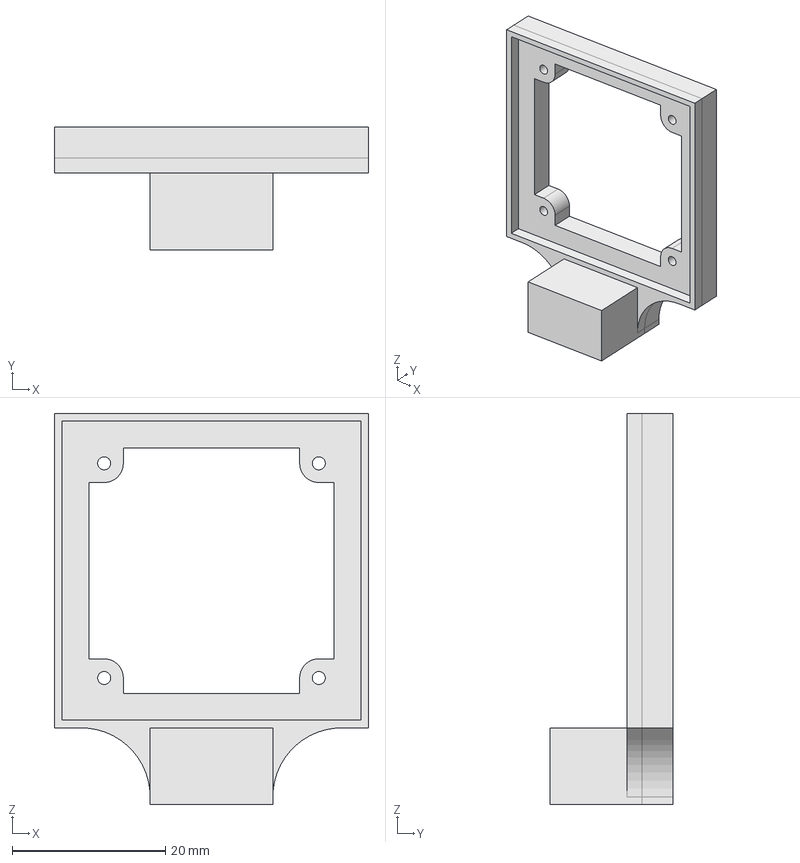
[picture p53: CAD file, 2022-08-31]
CAD/Misc/Camera_Mount.FCStd
41.0 x 16.0 x 51.0 mm
