nunosousa/TelescopeMirrorTester/CAD/Rail support/Coupler.FCStd

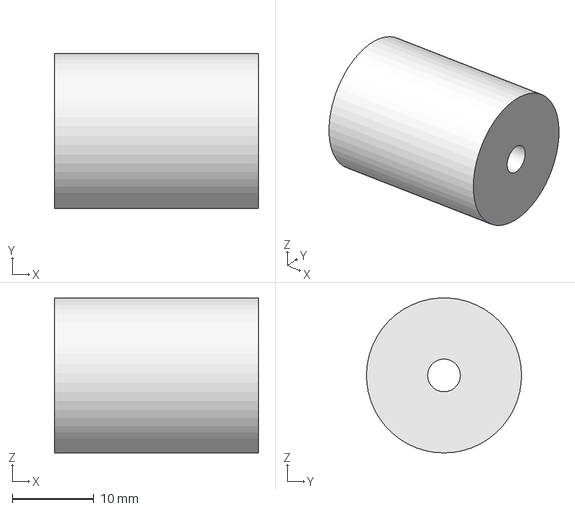
[picture p54: CAD file, 2022-05-28]
CAD/Rail support/Coupler.FCStd
25.0 x 19.0 x 19.0 mm
