nunosousa/TelescopeMirrorTester/CAD/Assemblies/Foucault_test_head_extra_improved.FCStd

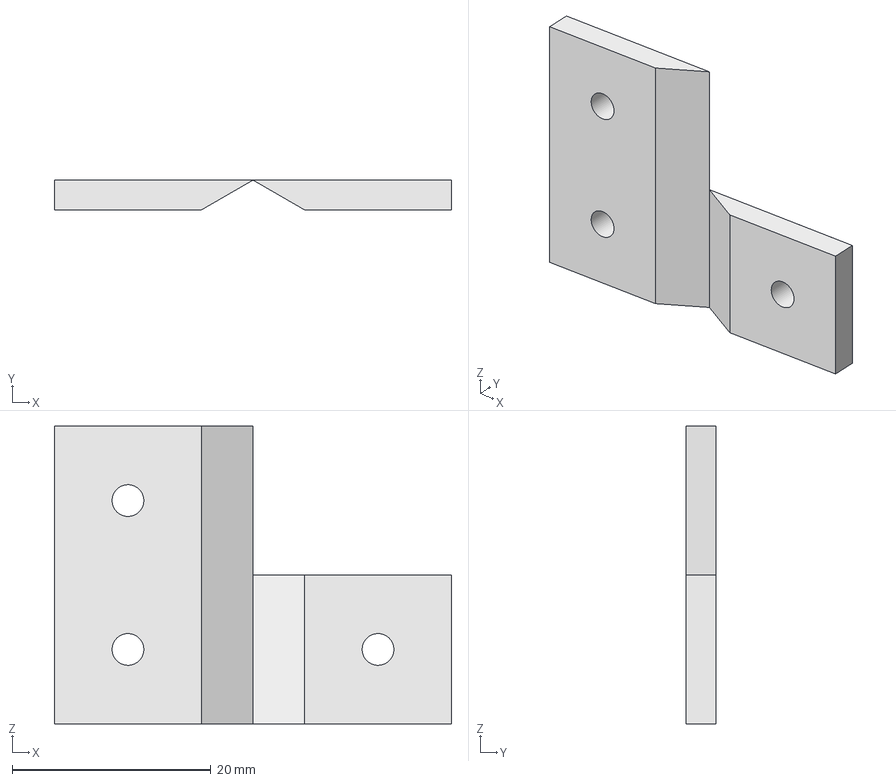
[picture p55: CAD file, 2023-07-15]
CAD/Assemblies/Foucault_test_head_extra_improved.FCStd
40.0 x 3.00 x 30.0 mm
Knife_long_001
Knife_001
ShapeBinder001
