nunosousa/TelescopeMirrorTester/CAD/CAD files/Translation_Stage_XYZ_b-Base_Plate.step

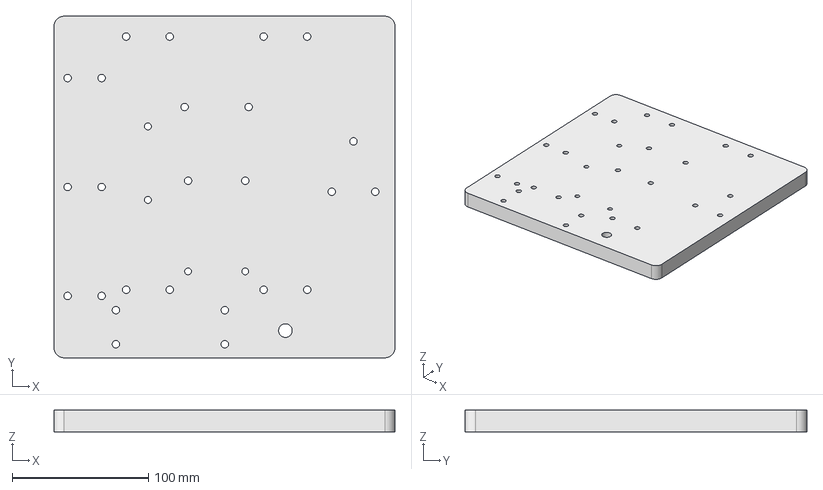
[picture p56: CAD file, 2025-05-01]
CAD/CAD files/Translation_Stage_XYZ_b-Base_Plate.step
250.5 x 251.0 x 16.0 mm
