nunosousa/TelescopeMirrorTester/CAD/Misc/Light_source_laser_pcb.FCStd

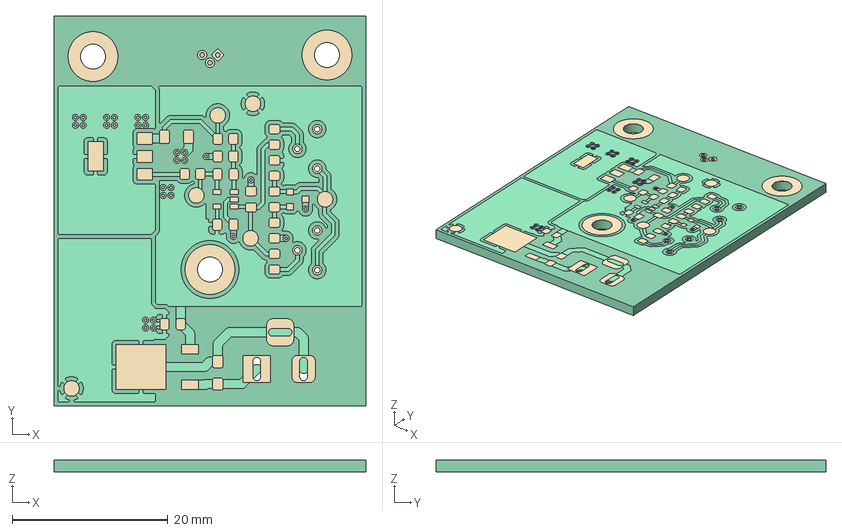
[picture p57: CAD file, 2022-07-23]
CAD/Misc/Light_source_laser_pcb.FCStd
40.0 x 50.0 x 1.64 mm
Pcb_ae3d
topPads_ae3d
topTracks_ae3d
topZones_ae3d
botPads_ae3d
botTracks_ae3d
