nunosousa/TelescopeMirrorTester/CAD/Assemblies/Foucault_test_head_improved.FCStd

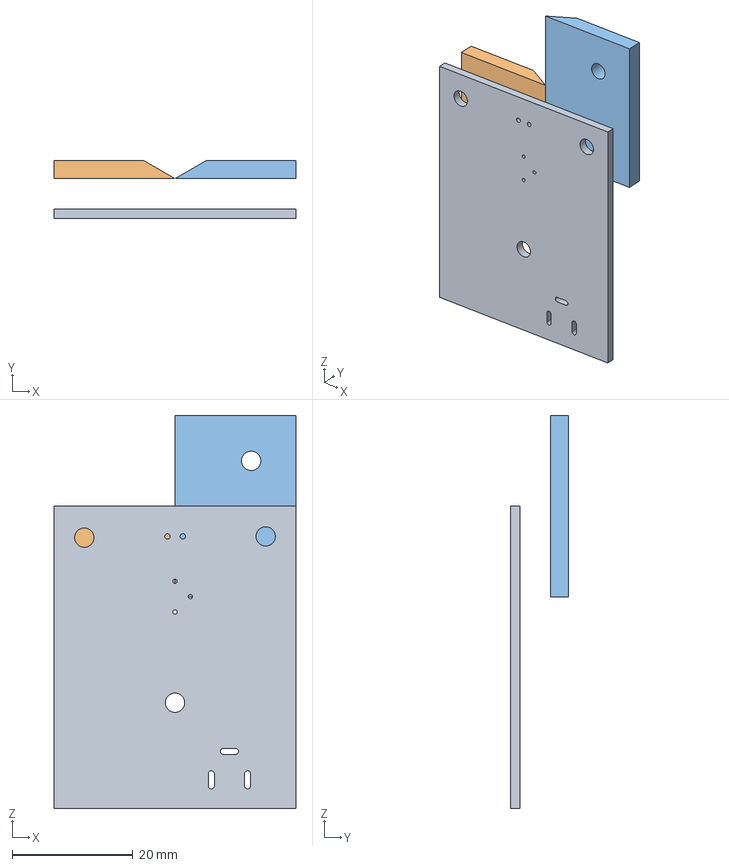
[picture p58: CAD file, 2023-07-04]
CAD/Assemblies/Foucault_test_head_improved.FCStd
40.0 x 9.60 x 65.0 mm
Light_source_pcb_001
Knife_001
Knife_long_001
