nunosousa/TelescopeMirrorTester/CAD/Misc/Camera.FCStd

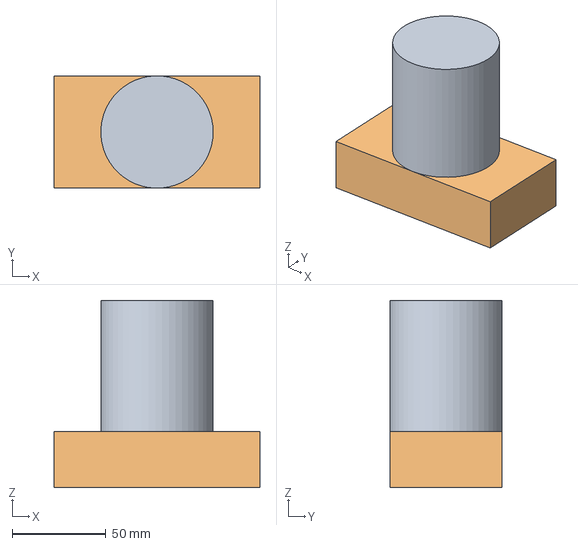
[picture p59: CAD file, 2022-07-22]
CAD/Misc/Camera.FCStd
110.0 x 60.0 x 100.0 mm
