nunosousa/TelescopeMirrorTester/CAD/Rail support/KFL08.FCStd

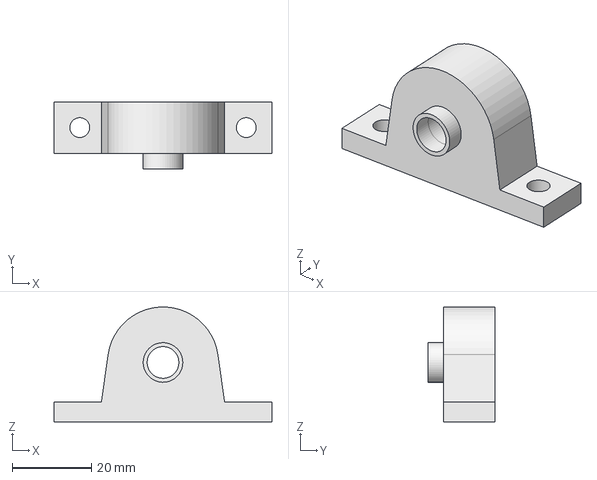
[picture p60: CAD file, 2022-05-22]
CAD/Rail support/KFL08.FCStd
55.0 x 17.0 x 29.0 mm
