nunosousa/TelescopeMirrorTester/CAD/Misc/Light_source_pcb.FCStd

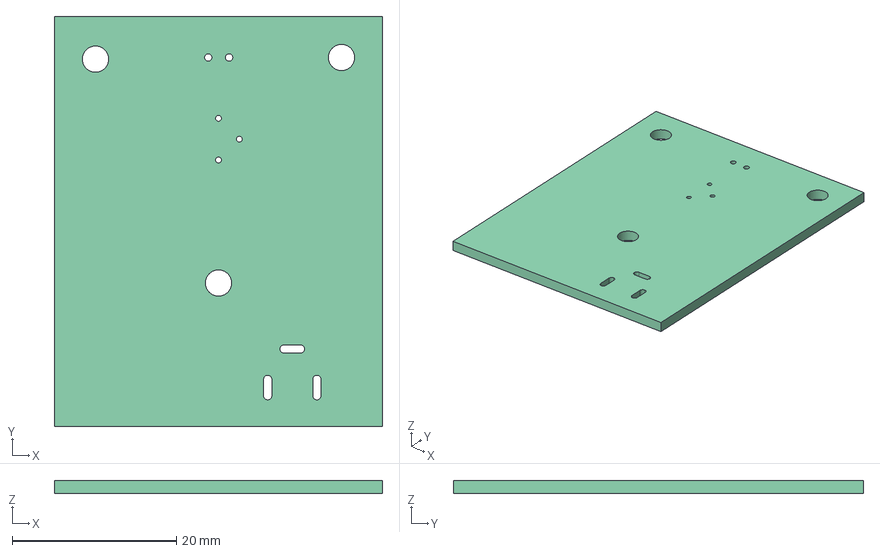
[picture p61: CAD file, 2022-07-13]
CAD/Misc/Light_source_pcb.FCStd
40.0 x 50.0 x 1.60 mm
