nunosousa/TelescopeMirrorTester/CAD/Rail support/Rod_100mm.FCStd

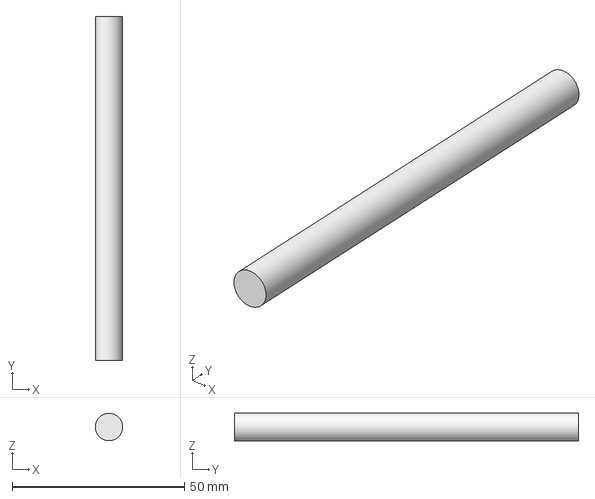
[picture p62: CAD file, 2022-04-15]
CAD/Rail support/Rod_100mm.FCStd
7.99 x 100.0 x 8.00 mm
