nunosousa/TelescopeMirrorTester/CAD/CAD files/KP08.stp

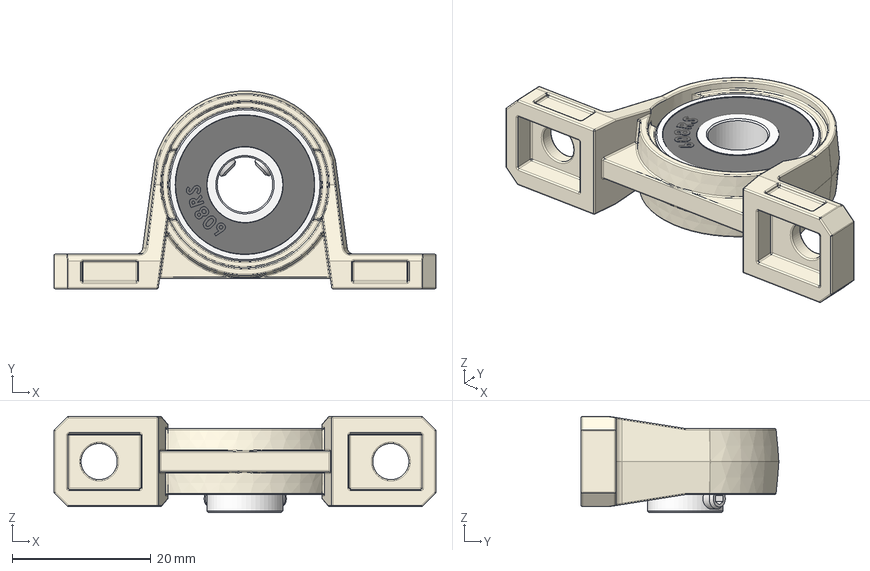
[picture p63: CAD file, 2025-05-01]
CAD/CAD files/KP08.stp
55.0 x 28.5 x 13.8 mm
KP081
608RS
AS 1421 - M3 x 4 Flat Point x 2
