nunosousa/TelescopeMirrorTester/CAD/Misc/Rod_3mm_70mm.FCStd

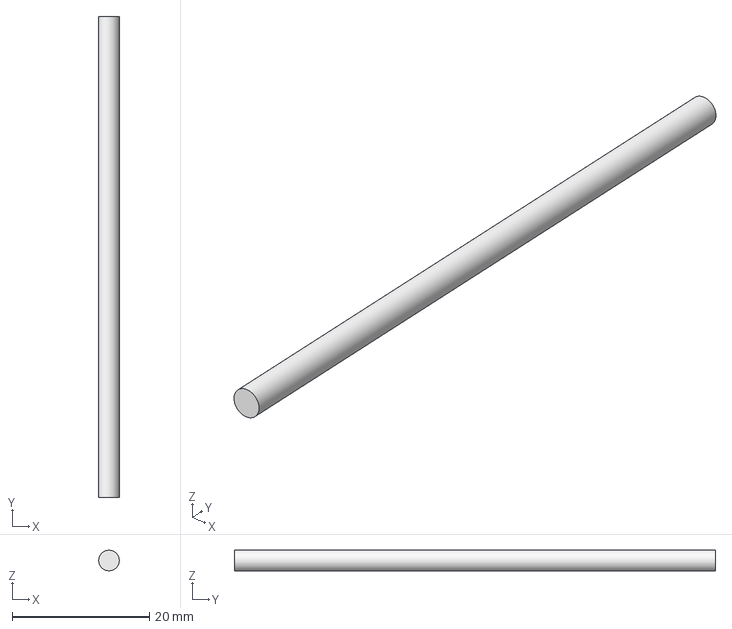
[picture p64: CAD file, 2022-07-13]
CAD/Misc/Rod_3mm_70mm.FCStd
3.00 x 70.0 x 3.00 mm
