nunosousa/TelescopeMirrorTester/CAD/Rail support/Rod_150mm.FCStd

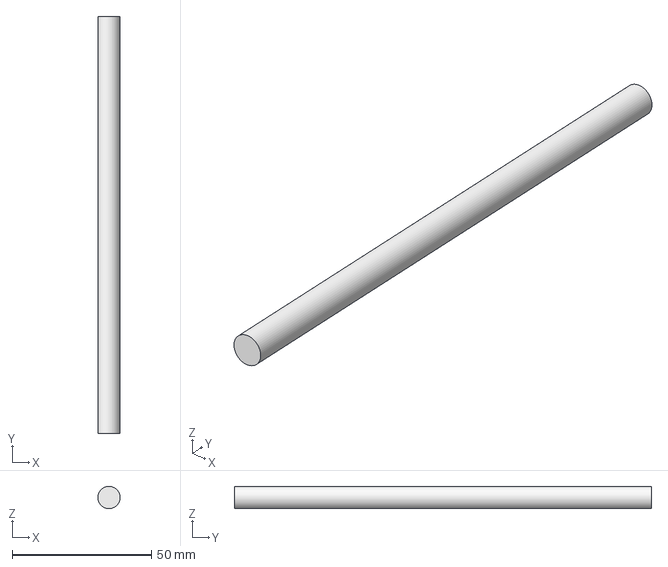
[picture p65: CAD file, 2022-04-15]
CAD/Rail support/Rod_150mm.FCStd
7.99 x 150.0 x 8.00 mm
