nunosousa/TelescopeMirrorTester/CAD/CAD files/Encoder_KP08-EncoderMountBack.step

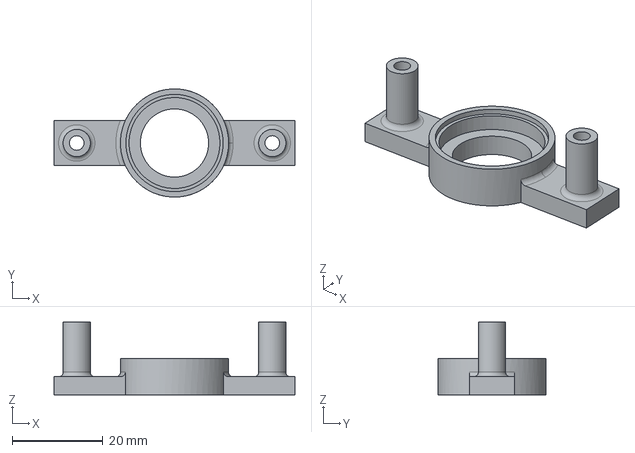
[picture p66: CAD file, 2025-04-12]
CAD/CAD files/Encoder_KP08-EncoderMountBack.step
53.0 x 23.8 x 16.0 mm
