nunosousa/TelescopeMirrorTester/CAD/Misc/Rod_3mm_lock.FCStd

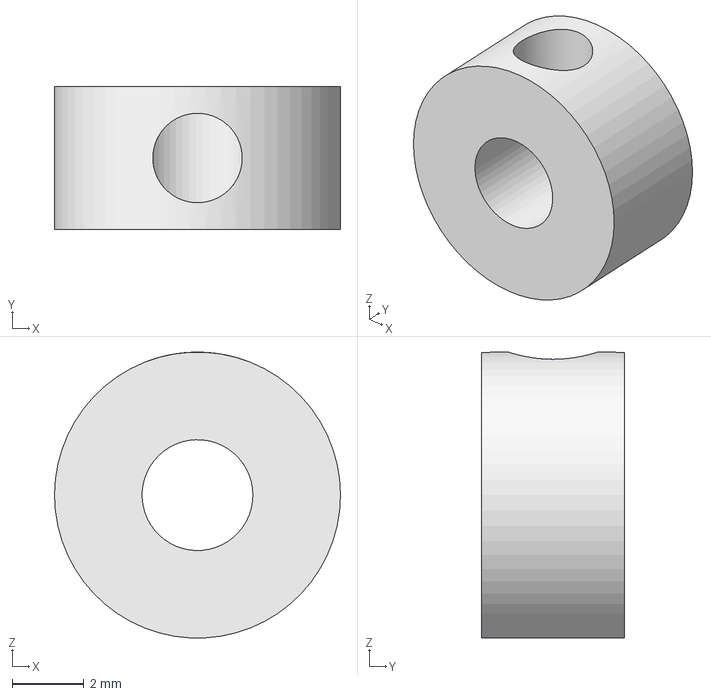
[picture p67: CAD file, 2022-07-13]
CAD/Misc/Rod_3mm_lock.FCStd
8.00 x 4.00 x 7.99 mm
