nunosousa/TelescopeMirrorTester/CAD/Rail support/Rod_285mm.FCStd

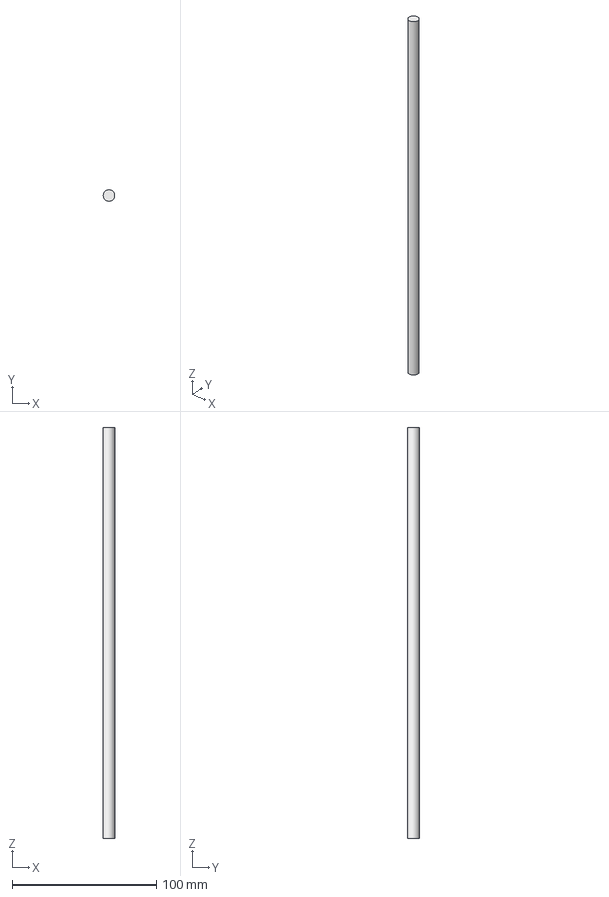
[picture p68: CAD file, 2022-04-09]
CAD/Rail support/Rod_285mm.FCStd
7.99 x 8.00 x 285.0 mm
