nunosousa/TelescopeMirrorTester/CAD/Assemblies/Foucault_test_head.FCStd

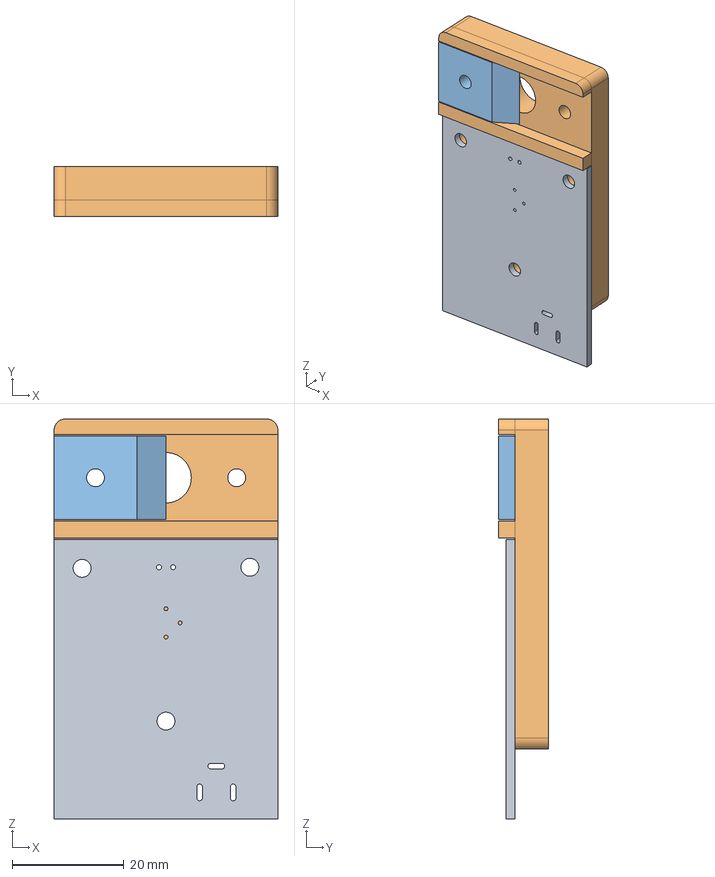
[picture p69: CAD file, 2022-07-23]
CAD/Assemblies/Foucault_test_head.FCStd
40.0 x 9.00 x 71.5 mm
Light_source_pcb_001
Face_plate
Knife_001
