nunosousa/TelescopeMirrorTester/CAD/CAD files/Encoder_KP08-EncoderMountFront.step

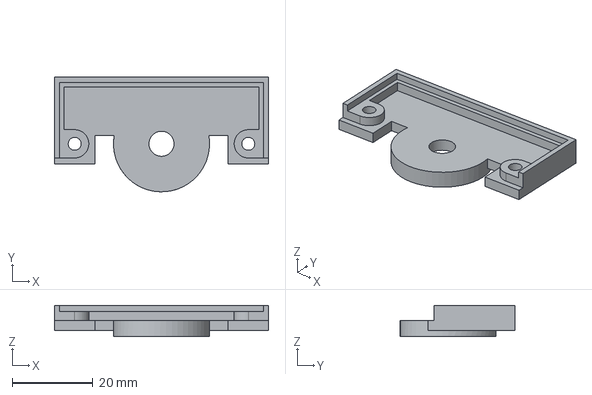
[picture p70: CAD file, 2025-04-12]
CAD/CAD files/Encoder_KP08-EncoderMountFront.step
53.0 x 28.4 x 7.78 mm
