nunosousa/TelescopeMirrorTester/CAD/Misc/Bushing_3mm.FCStd

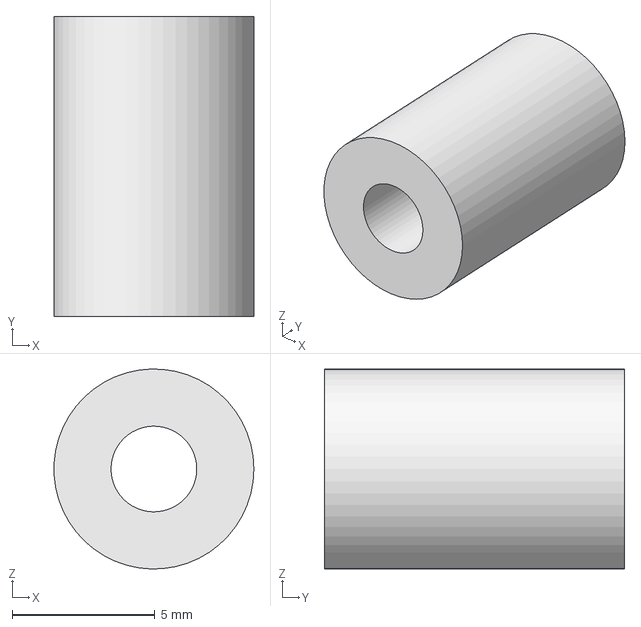
[picture p71: CAD file, 2022-07-13]
CAD/Misc/Bushing_3mm.FCStd
6.99 x 10.5 x 7.00 mm
