nunosousa/TelescopeMirrorTester/CAD/Rail support/Rod_200mm.FCStd

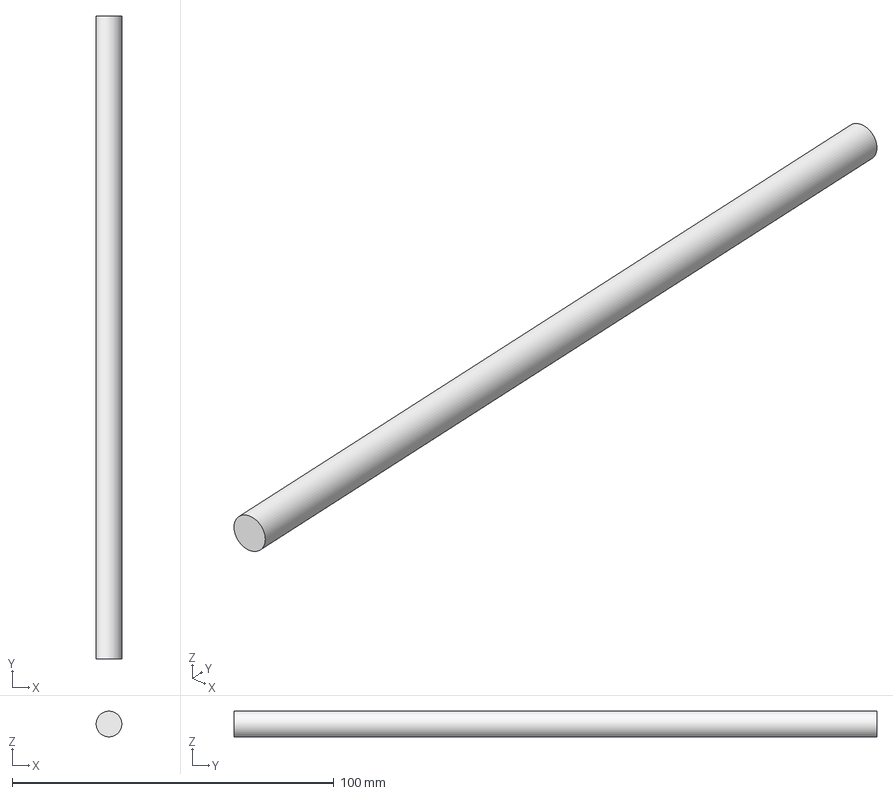
[picture p72: CAD file, 2022-03-31]
CAD/Rail support/Rod_200mm.FCStd
7.99 x 200.0 x 8.00 mm
