nunosousa/TelescopeMirrorTester/CAD/Assemblies/Bushing_support.FCStd

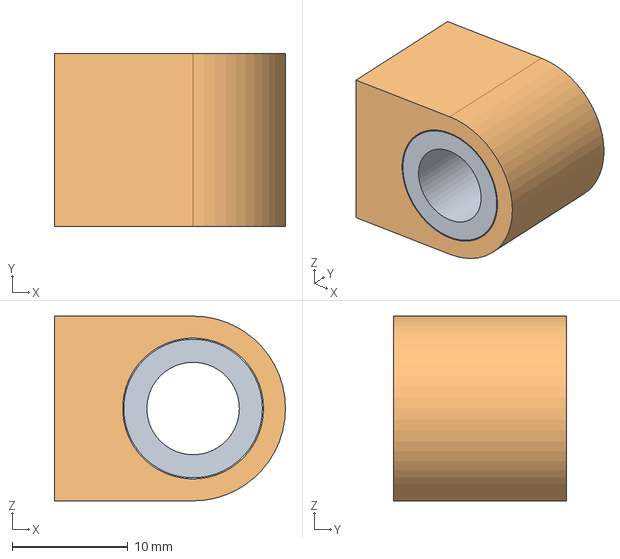
[picture p73: CAD file, 2022-07-11]
CAD/Assemblies/Bushing_support.FCStd
20.0 x 15.0 x 16.0 mm
Bushing_001
