nunosousa/TelescopeMirrorTester/CAD/Misc/Limit_Switch.FCStd

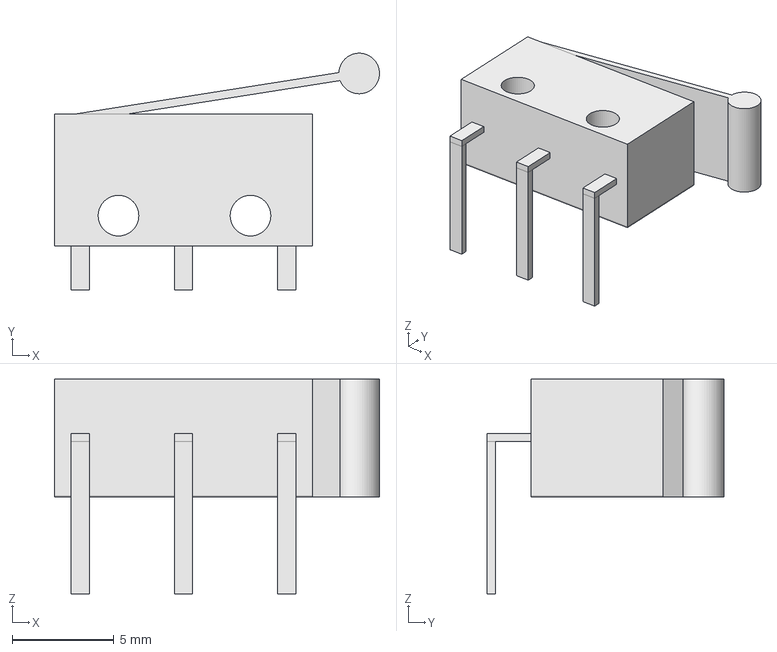
[picture p74: CAD file, 2022-06-12]
CAD/Misc/Limit_Switch.FCStd
16.0 x 11.6 x 10.6 mm
