nunosousa/TelescopeMirrorTester/CAD/Rail support/SHF8.FCStd

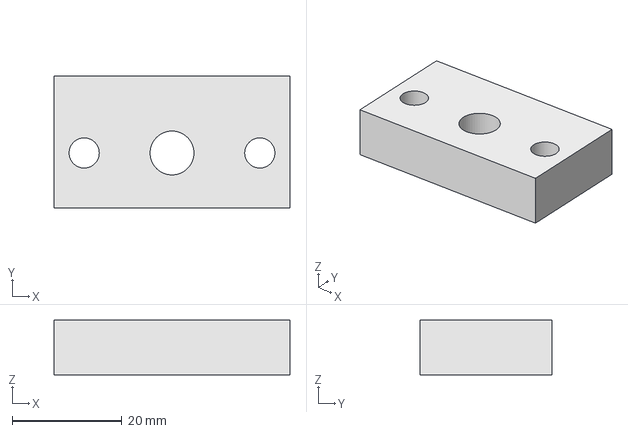
[picture p75: CAD file, 2022-02-22]
CAD/Rail support/SHF8.FCStd
43.0 x 24.0 x 10.0 mm
