nunosousa/TelescopeMirrorTester/CAD/Misc/Nema 11.FCStd

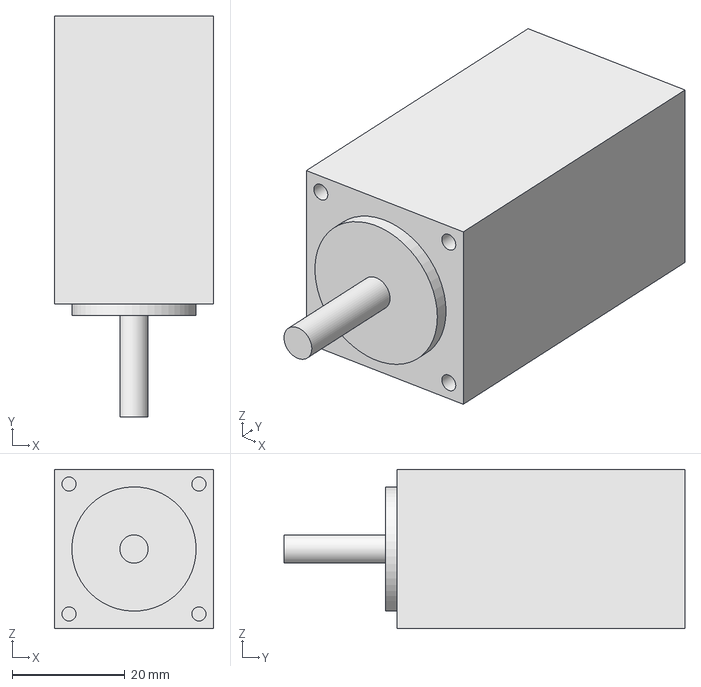
[picture p76: CAD file, 2022-06-12]
CAD/Misc/Nema 11.FCStd
28.2 x 71.0 x 28.2 mm
