nunosousa/TelescopeMirrorTester/CAD/Rail support/SHF12.FCStd

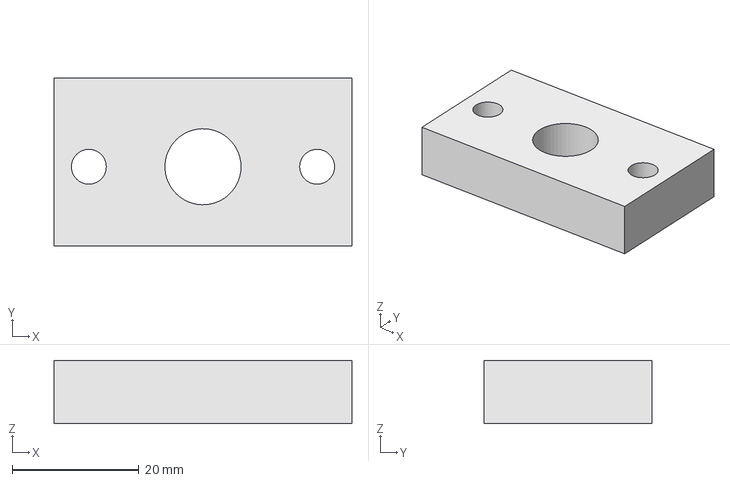
[picture p77: CAD file, 2022-02-22]
CAD/Rail support/SHF12.FCStd
47.0 x 26.5 x 10.0 mm
