nunosousa/TelescopeMirrorTester/CAD/Assemblies/Limit_Switch_Board.FCStd

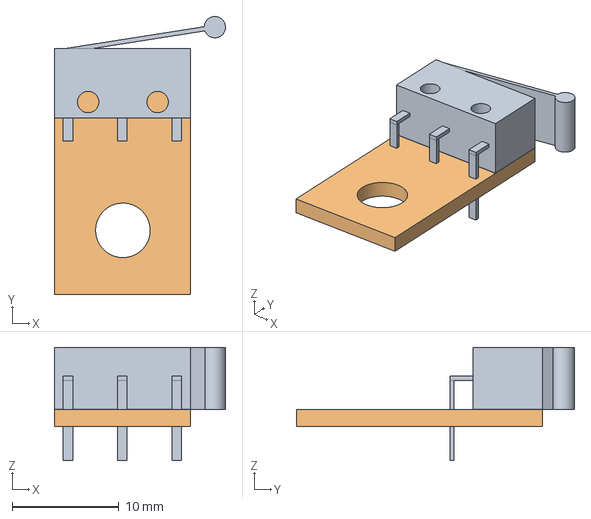
[picture p78: CAD file, 2022-06-13]
CAD/Assemblies/Limit_Switch_Board.FCStd
16.0 x 26.0 x 10.6 mm
Limit_Switch_001
