nunosousa/TelescopeMirrorTester/CAD/Misc/GT2_40_pulley.FCStd

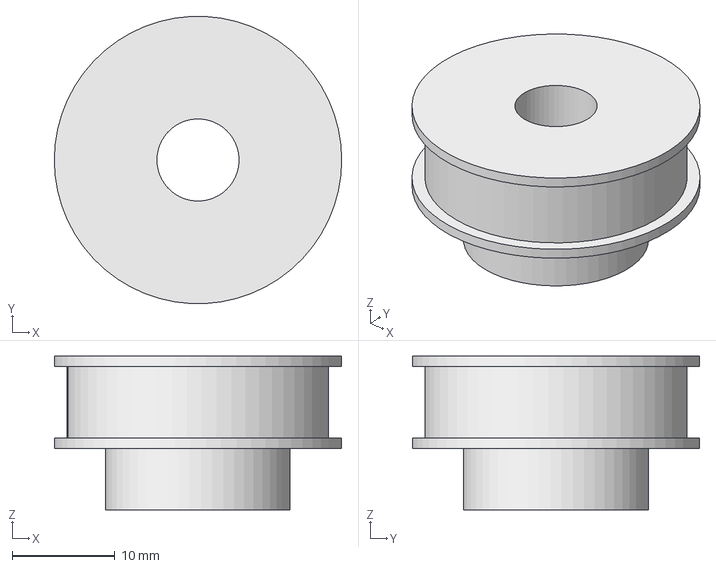
[picture p79: CAD file, 2022-06-12]
CAD/Misc/GT2_40_pulley.FCStd
28.0 x 28.0 x 15.0 mm
