nunosousa/TelescopeMirrorTester/CAD/Rail support/SK8.FCStd

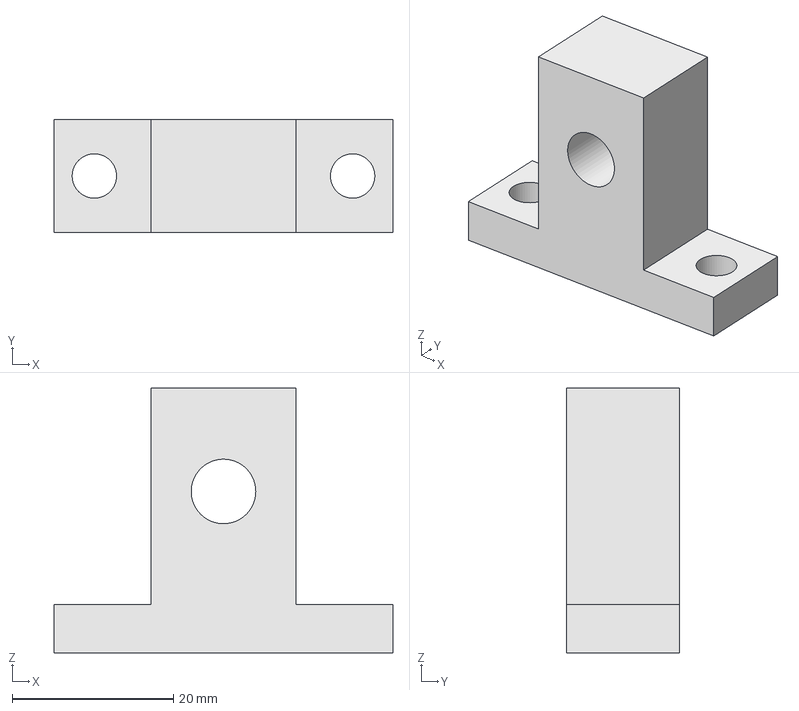
[picture p80: CAD file, 2022-01-31]
CAD/Rail support/SK8.FCStd
42.0 x 14.0 x 32.8 mm
