nunosousa/TelescopeMirrorTester/CAD/Misc/GT2_16_pulley.FCStd

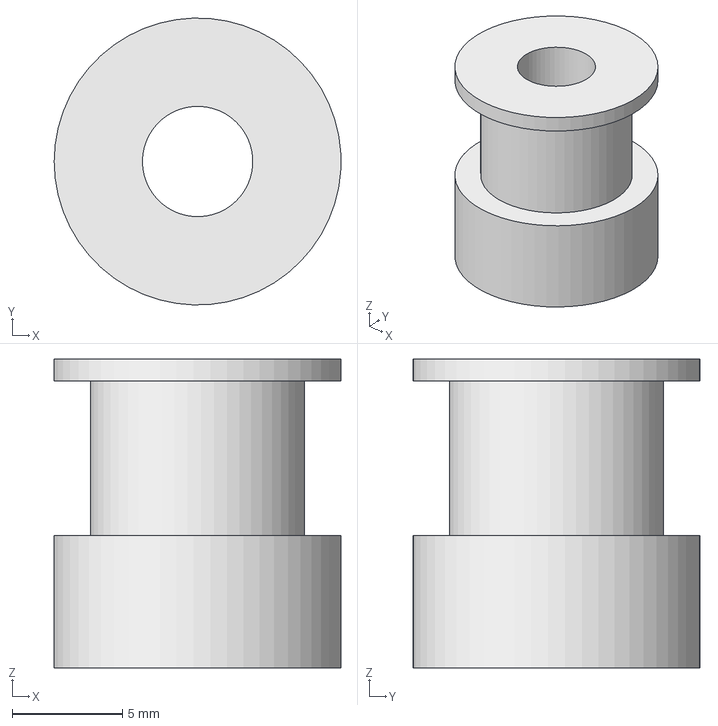
[picture p81: CAD file, 2022-06-12]
CAD/Misc/GT2_16_pulley.FCStd
13.0 x 13.0 x 14.0 mm
