nunosousa/TelescopeMirrorTester/CAD/Rail support/SK12.FCStd

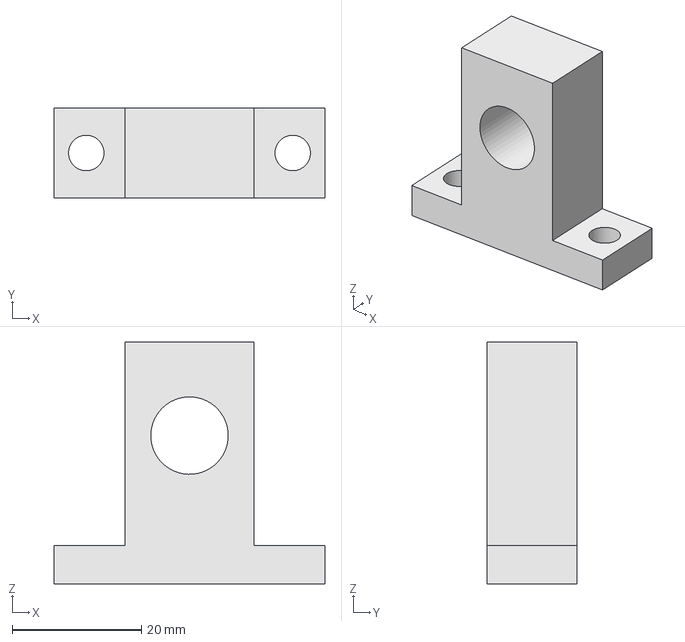
[picture p82: CAD file, 2022-01-31]
CAD/Rail support/SK12.FCStd
42.0 x 14.0 x 37.5 mm
