nunosousa/TelescopeMirrorTester/CAD/Misc/GT2_20_pulley.FCStd

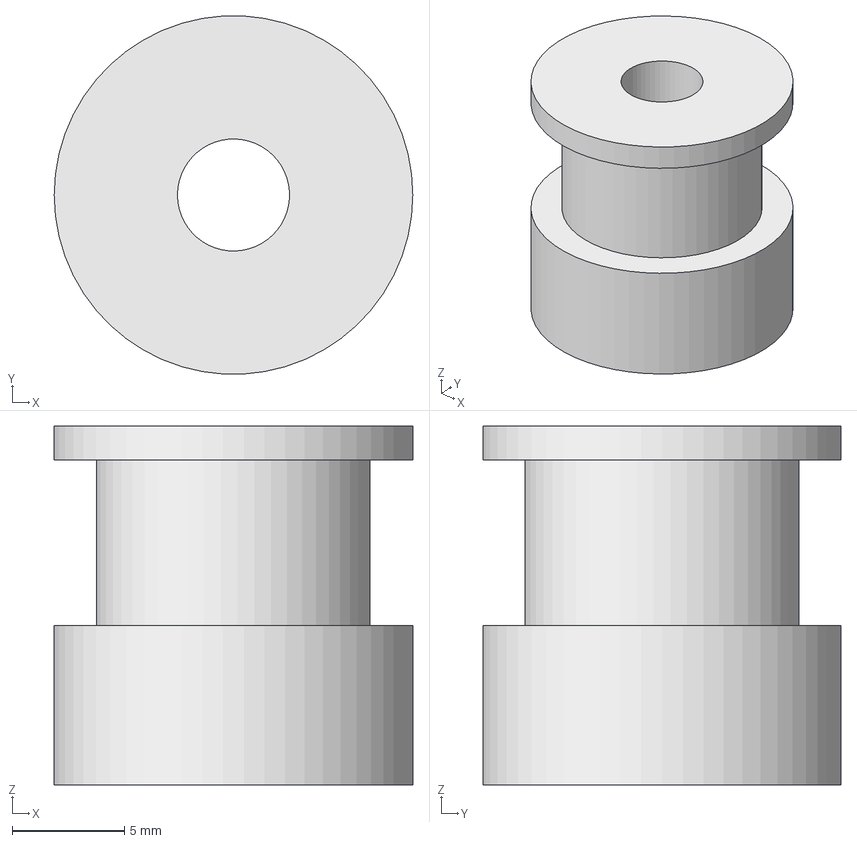
[picture p83: CAD file, 2022-06-12]
CAD/Misc/GT2_20_pulley.FCStd
16.0 x 16.0 x 16.0 mm
