nunosousa/TelescopeMirrorTester/CAD/Misc/4040_profile.FCStd

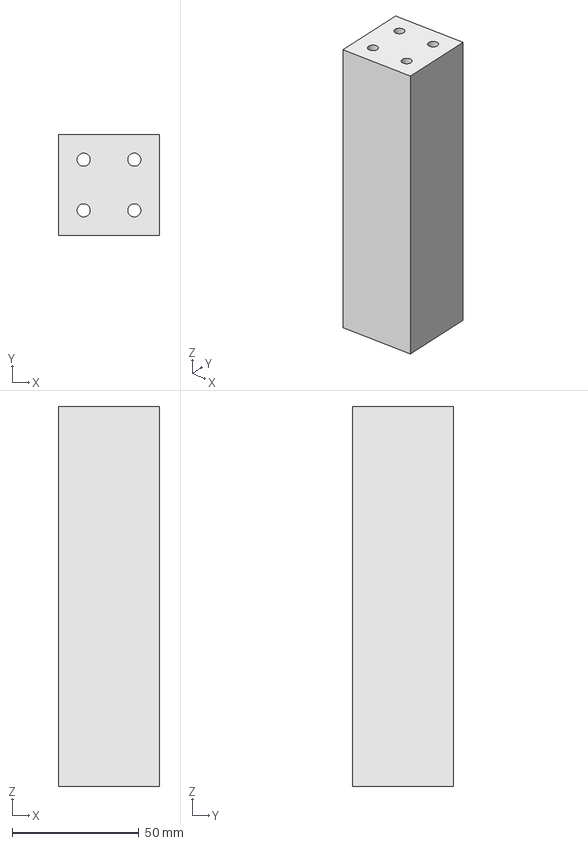
[picture p84: CAD file, 2022-06-04]
CAD/Misc/4040_profile.FCStd
40.0 x 40.0 x 150.0 mm
