nunosousa/TelescopeMirrorTester/CAD/Misc/DC_Motor.FCStd

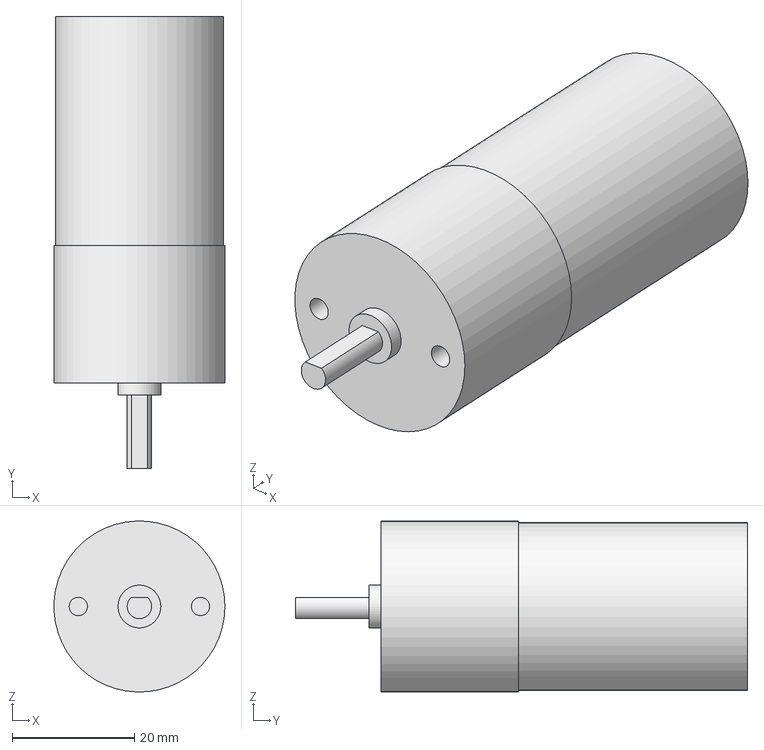
[picture p85: CAD file, 2022-05-28]
CAD/Misc/DC_Motor.FCStd
28.0 x 74.0 x 28.0 mm
