nunosousa/TelescopeMirrorTester/CAD/Assemblies/Translation_axis_150mm_vertical.FCStd

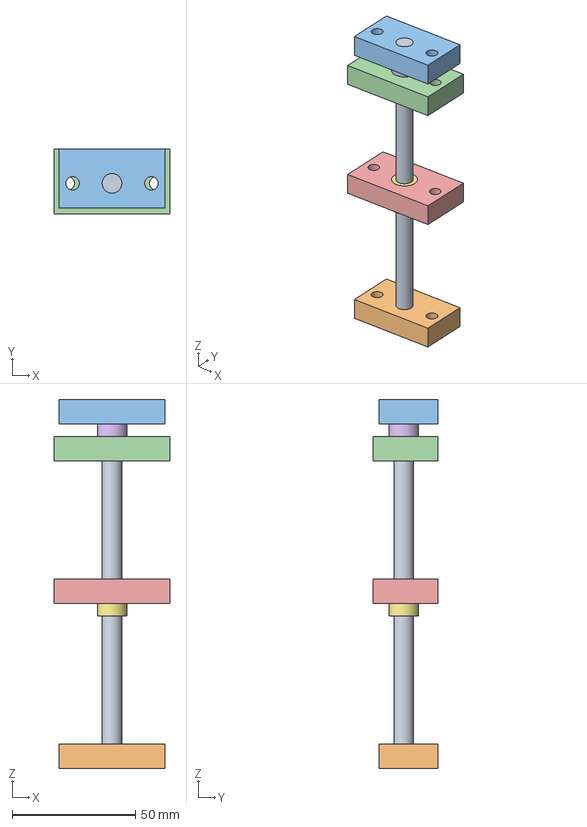
[picture p86: CAD file, 2022-06-04]
CAD/Assemblies/Translation_axis_150mm_vertical.FCStd
47.0 x 26.5 x 150.0 mm
Rod_150mm_001
SHF8_001
SHF8_002
SHF12_001
SHF12_002
Bushing_001
Bushing_002
