nunosousa/TelescopeMirrorTester/CAD/Misc/35mm_slide.FCStd

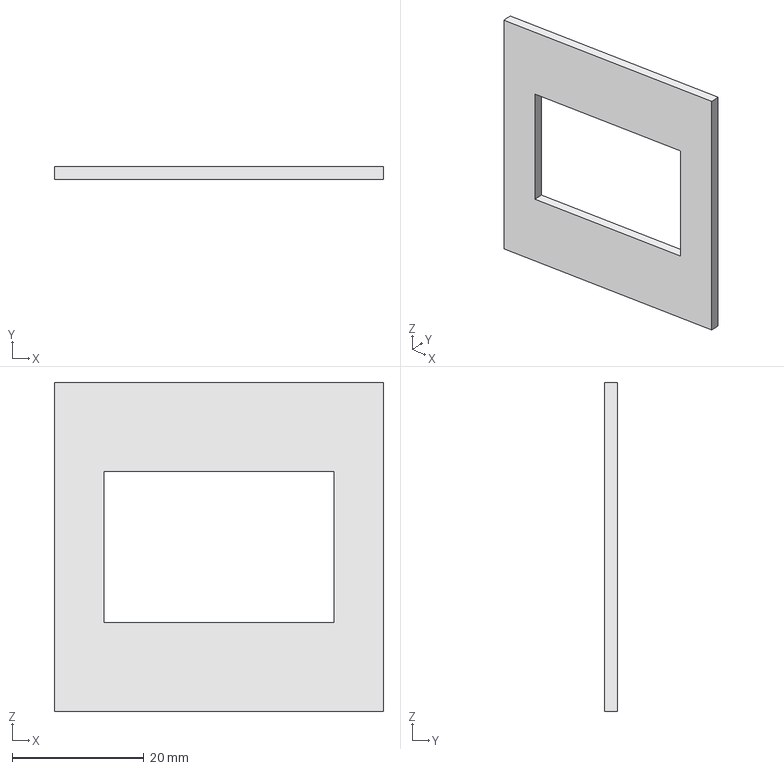
[picture p87: CAD file, 2022-05-08]
CAD/Misc/35mm_slide.FCStd
50.0 x 2.00 x 50.0 mm
