nunosousa/TelescopeMirrorTester/CAD/Assemblies/Translation_axis_150mm.FCStd

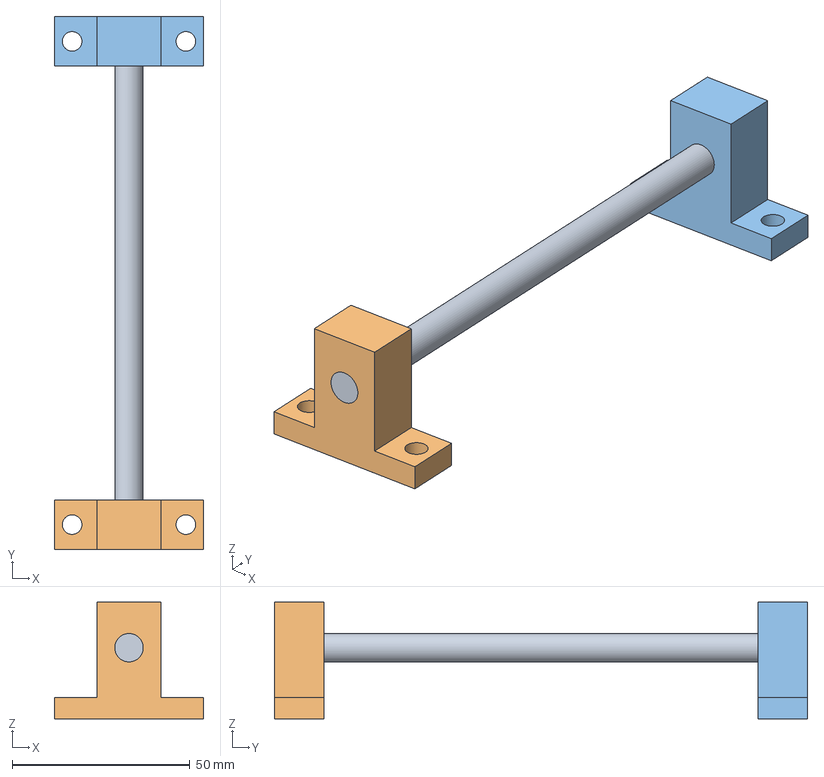
[picture p88: CAD file, 2022-05-03]
CAD/Assemblies/Translation_axis_150mm.FCStd
42.0 x 150.0 x 32.8 mm
Rod_150mm_001
SK8_001
SK8_002
