nunosousa/TelescopeMirrorTester/CAD/Assemblies/Bearing_support_vertical.FCStd

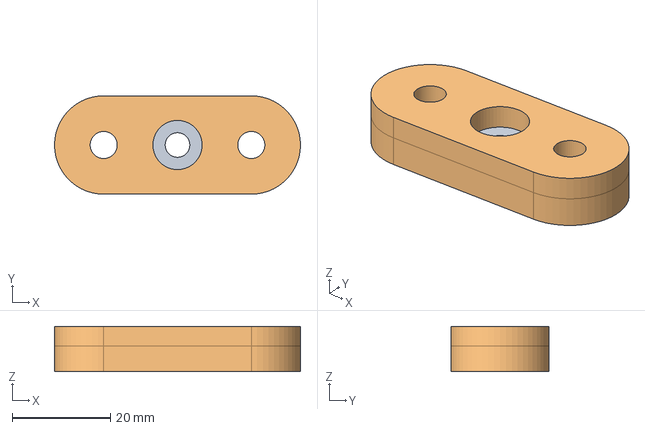
[picture p89: CAD file, 2022-04-30]
CAD/Assemblies/Bearing_support_vertical.FCStd
50.0 x 20.0 x 9.20 mm
Bearing_001
