nunosousa/TelescopeMirrorTester/CAD/CAD files/Limit_Switch_Board-Limit_Switch_PCB_Body.iges

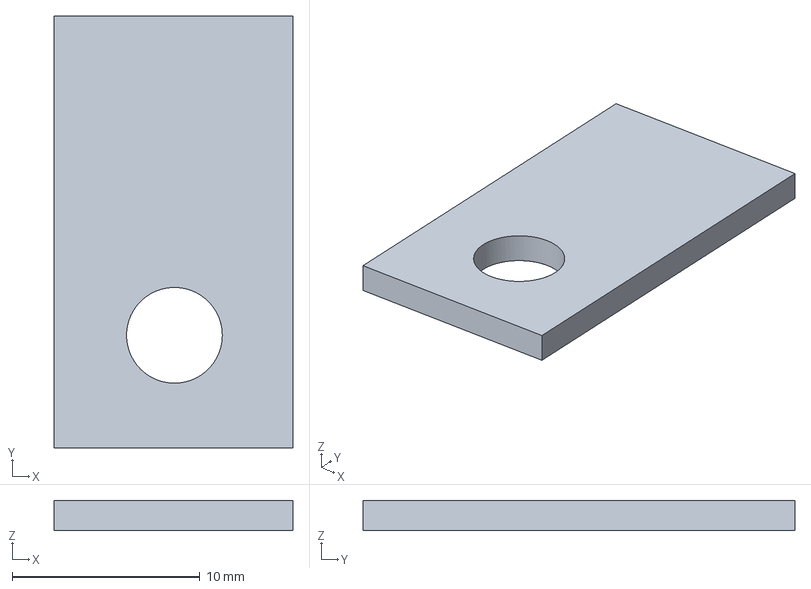
[picture p90: CAD file, 2022-06-13]
CAD/CAD files/Limit_Switch_Board-Limit_Switch_PCB_Body.iges
12.7 x 23.0 x 1.60 mm
