nunosousa/TelescopeMirrorTester/CAD/Assemblies/Knob_support_alternative.FCStd

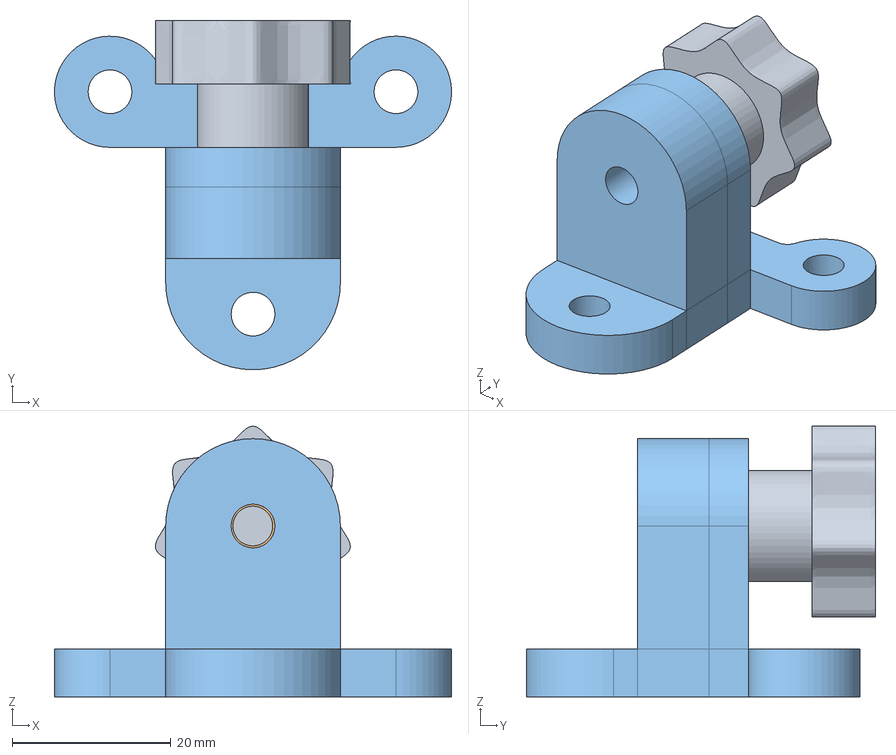
[picture p91: CAD file, 2022-04-23]
CAD/Assemblies/Knob_support_alternative.FCStd
50.0 x 44.0 x 34.1 mm
Knob_001
Bearing_001
Knob Support
