nunosousa/TelescopeMirrorTester/CAD/CAD files/Translation_Stage_XYZ_b-Mid_Plate.iges

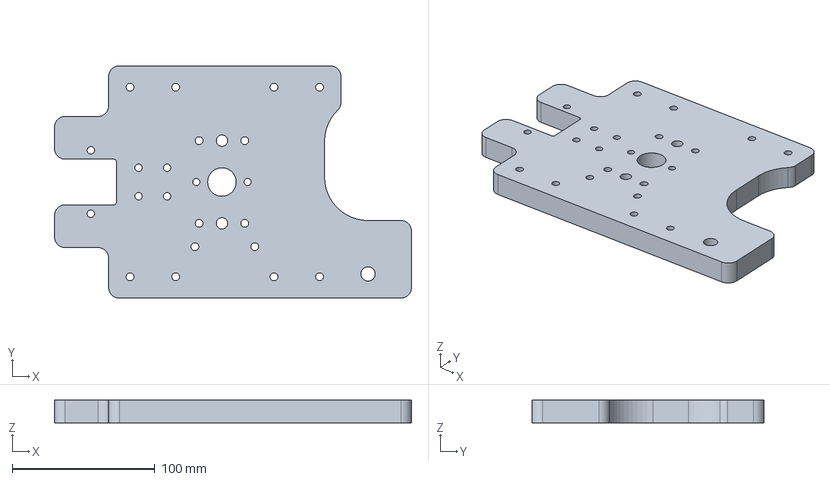
[picture p92: CAD file, 2022-06-13]
CAD/CAD files/Translation_Stage_XYZ_b-Mid_Plate.iges
250.5 x 163.0 x 16.0 mm
