nunosousa/TelescopeMirrorTester/CAD/Misc/Knob.FCStd

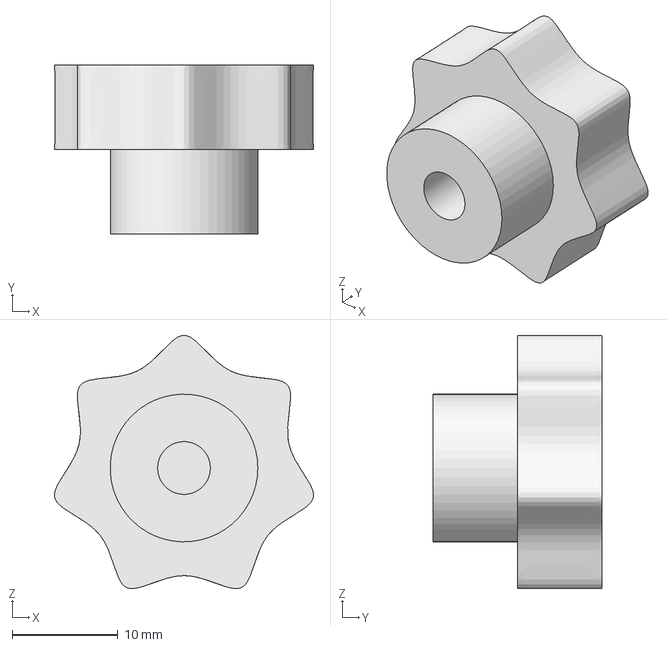
[picture p93: CAD file, 2022-04-02]
CAD/Misc/Knob.FCStd
24.6 x 16.0 x 24.0 mm
