nunosousa/TelescopeMirrorTester/CAD/Assemblies/Knob_support.FCStd

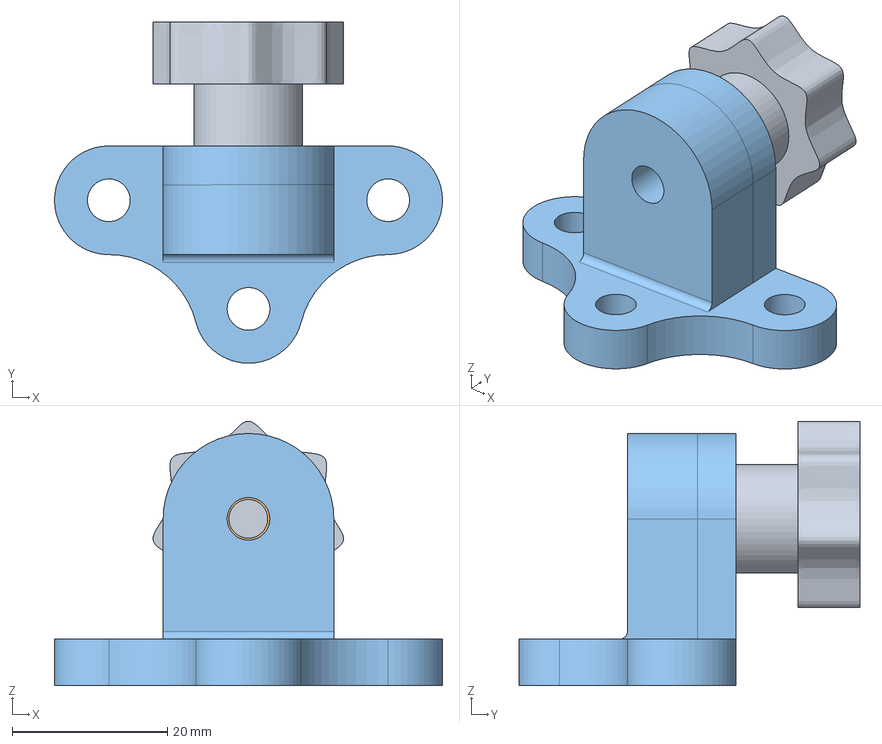
[picture p94: CAD file, 2022-04-20]
CAD/Assemblies/Knob_support.FCStd
50.0 x 44.0 x 34.1 mm
Knob_001
Bearing_001
Knob Support
