nunosousa/TelescopeMirrorTester/CAD/Misc/Bushing.FCStd

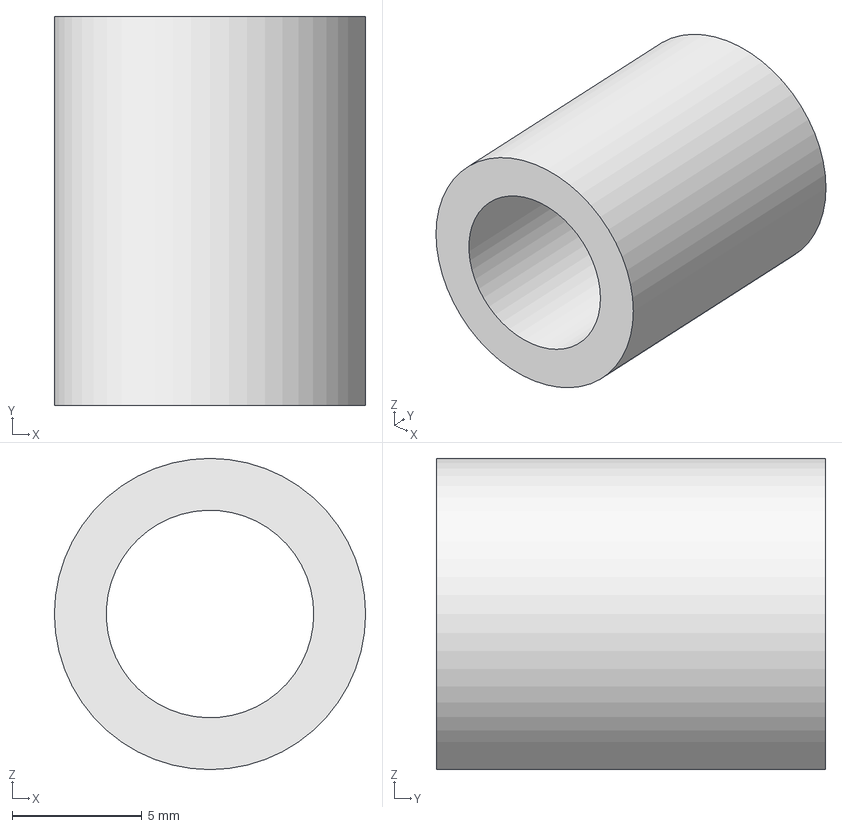
[picture p95: CAD file, 2022-03-31]
CAD/Misc/Bushing.FCStd
12.0 x 15.0 x 12.0 mm
