nunosousa/TelescopeMirrorTester/CAD/Assemblies/Translation_axis_150mm_12_7mm.FCStd

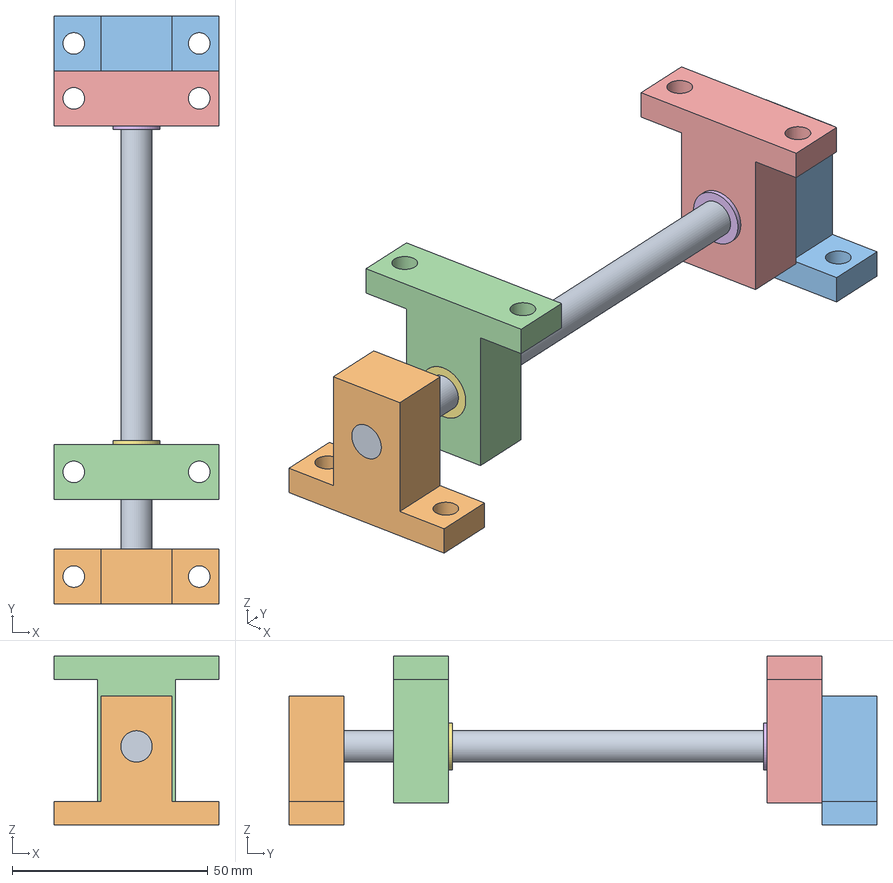
[picture p96: CAD file, 2022-04-20]
CAD/Assemblies/Translation_axis_150mm_12_7mm.FCStd
42.0 x 150.0 x 43.0 mm
Rod_150mm_001
SK8_001
SK8_002
SK12_001
SK12_002
Bushing_001
Bushing_002
