nunosousa/TelescopeMirrorTester/CAD/Assemblies/Translation_axis_285mm_25mm.FCStd

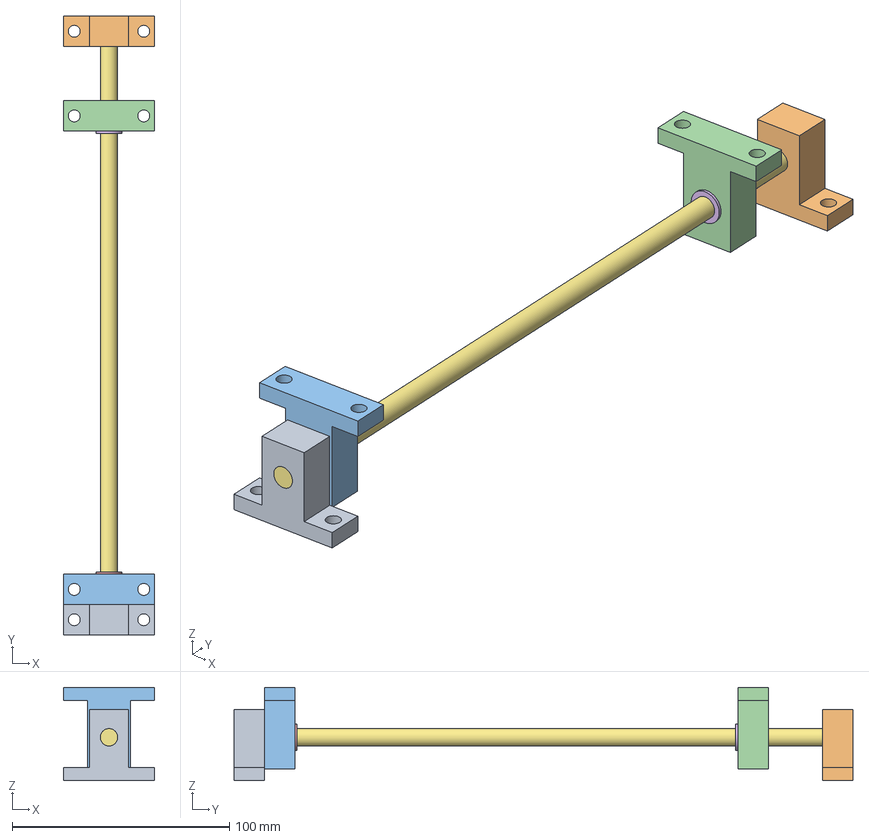
[picture p97: CAD file, 2022-04-09]
CAD/Assemblies/Translation_axis_285mm_25mm.FCStd
42.0 x 285.0 x 43.0 mm
SK8_001
SK8_002
SK12_001
SK12_002
Bushing_001
Bushing_002
Rod_285mm_001
