nunosousa/TelescopeMirrorTester/CAD/Assemblies/Translation_axis_200mm_25mm.FCStd

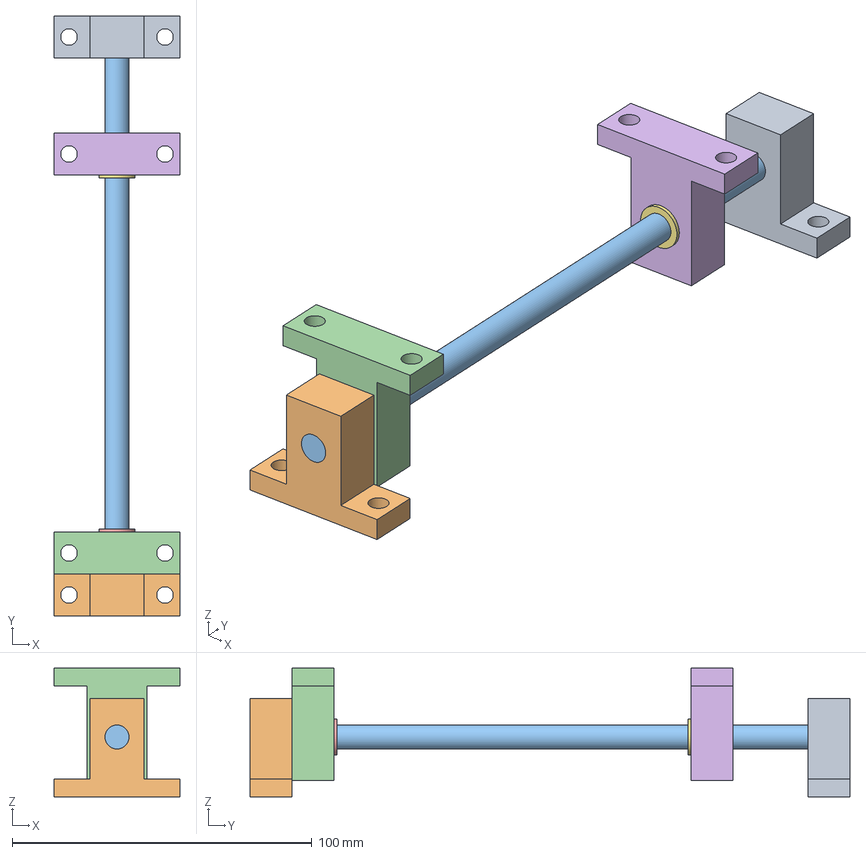
[picture p98: CAD file, 2022-04-09]
CAD/Assemblies/Translation_axis_200mm_25mm.FCStd
42.0 x 200.0 x 43.0 mm
SK8_001
SK8_002
Rod_200mm_001
SK12_001
Bushing_001
SK12_002
Bushing_002
