nunosousa/TelescopeMirrorTester/CAD/Assemblies/Monted_Micrometer.FCStd

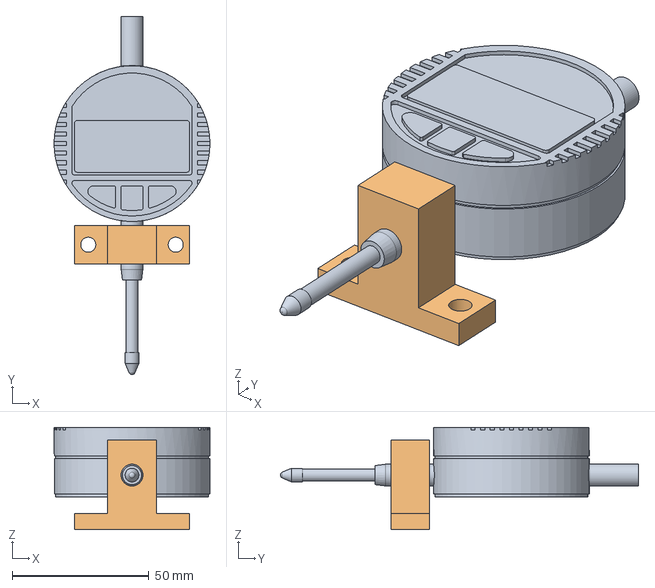
[picture p99: CAD file, 2022-04-01]
CAD/Assemblies/Monted_Micrometer.FCStd
57.0 x 131.0 x 37.5 mm
Micrometer_Assembly_25mm_001
SK8_001
