nunosousa/TelescopeMirrorTester/(list of files, cad)

Other CAD files:
CAD/CAD files/Y_Translation_Assembly-Stabilizer.iges
CAD/CAD files/Y_Translation_Assembly-Stabilizer002.iges
CAD/Assemblies/Base_Z_Translation_Assembly_w_Micrometer_Motor.FCStd
CAD/CAD files/Y_Translation_Assembly-Stabilizer001.iges
CAD/CAD files/UM90S.FCStd
CAD/CAD files/SK8 Linear shaft holder.STEP
CAD/CAD files/Translation_Stage_XYZ_b-Foot001.iges
CAD/CAD files/Translation_Stage_XYZ_b-Foot003.iges
CAD/CAD files/Translation_Stage_XYZ_b-Foot002.iges
CAD/CAD files/Translation_Stage_XYZ_b-Elevation_Plate.iges
CAD/Assemblies/Translation_axis_150mm_25mm.FCStd
CAD/Assemblies/Adjusting_screw_assembly.FCStd
CAD/Assemblies/Adjusting_screw_assembly_Colapsed.FCStd
CAD/Assemblies/Position_screw_assembly_vertical.FCStd
CAD/Assemblies/Position_screw_assembly_w_Motor.FCStd
CAD/Assemblies/Position_screw_assembly_w_Motor_Improved.FCStd
CAD/Assemblies/Position_screw_assembly_w_Stepper_Motor.FCStd
CAD/Assemblies/Supported_Nut.FCStd
CAD/Assemblies/Supported_Nut_Horizontal.FCStd
CAD/Assemblies/Supported_Nut_Horizontal_alternative.FCStd
CAD/CAD files/Encoder_KP08-EncoderMountBack.iges
CAD/CAD files/Encoder_KP08-EncoderMountFront.iges
CAD/CAD files/Fasteners/90264A806_NO THREADS_Zinc-Plated Steel Coupling Nut.STEP
CAD/CAD files/Fasteners/90591A250_NO THREADS_Zinc-Plated Steel Hex Nut.STEP
CAD/CAD files/Fasteners/90591A260_NO THREADS_Zinc-Plated Steel Hex Nut.STEP
CAD/CAD files/Fasteners/91280A225_NO THREADS_Medium-Strength Class 8.8 Steel Hex Head Screw.STEP
CAD/CAD files/Fasteners/91280A234_NO THREADS_Medium-Strength Class 8.8 Steel Hex Head Screw.STEP
CAD/CAD files/Fasteners/91455A110_Steel General Purpose Washer for Class 8.8.STEP
CAD/CAD files/Fasteners/97763A456_NO THREADS_18-8 Stainless Steel Button Head Hex Drive Screws.STEP
CAD/CAD files/Fasteners/97763A457_NO THREADS_18-8 Stainless Steel Button Head Hex Drive Screws.STEP
CAD/CAD files/Fasteners/TPBT-G-M5-L16.step
CAD/CAD files/Position_screw_assembly_w_Motor-Motor_support.iges
CAD/CAD files/Position_screw_assembly_w_Motor-Translation_support.iges
CAD/CAD files/Position_screw_assembly_w_Motor_Improved-Translation_support.iges
CAD/CAD files/T8 nut.STEP
CAD/CAD files/Translation_Stage_XYZ_b-Base_Plate.iges
CAD/CAD files/Translation_Stage_XYZ_b-Foot.iges
CAD/Misc/Hex_Nut_Small.FCStd
CAD/Misc/Hex_Spacer_Nut.FCStd
CAD/Misc/Hex_Spacer_Nut_Small.FCStd
CAD/Misc/M5_Hex_Spacer_Nut.FCStd
CAD/Misc/M5_Washer.FCStd
CAD/Rail support/T8_nut.FCStd
Tester/ECAD/ControllerBoard/Gerbers/ControllerBoard-B_SilkS.dxf
Tester/ECAD/ControllerBoard/Gerbers/ControllerBoard-F_SilkS.dxf
_Deprecated/ECAD/ControllerBoard/Gerbers/ControllerBoard-B_SilkS.dxf
_Deprecated/ECAD/ControllerBoard/Gerbers/ControllerBoard-F_SilkS.dxf
