nunosousa/TelescopeMirrorTester/CAD/Assemblies/HTB1AsO_RFXXXXchXXXXq6xXFXXXx.jpg

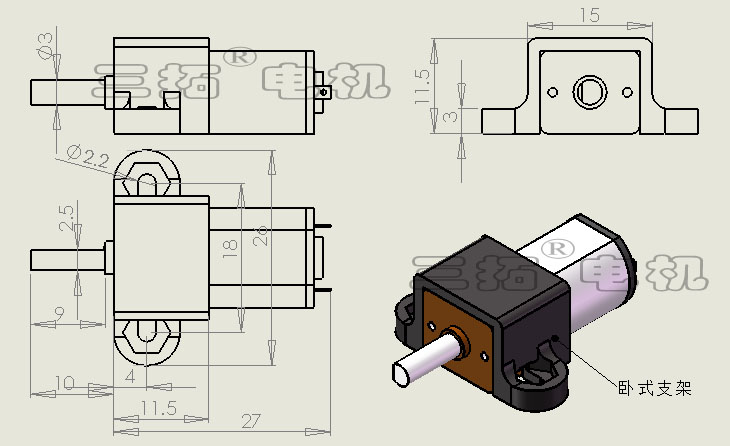
CAD/Assemblies/HTB1AsO_RFXXXXchXXXXq6xXFXXXx.jpg
