nunosousa/TelescopeMirrorTester/Tester/ECAD/ControllerBoard/MCU_PIN_MAPPING.ods

Sheet: SAMD21
Side | Pin | PIN | FUNCTION | Pin function
W | 1 | PA00 |  | XIN32
W | 2 | PA01 |  | XOUT32
W | 3 | PA02 |  | ~POS1_NCS
W | 4 | PA03 |  | ~POS2_NCS
W | 7 | PB08 |  | ~POS2_NRESET
W | 8 | PB09 |  | ~POS1_NRESET
W | 9 | PA04 | SERCOM0/PAD[0] | POS_MISO
W | 10 | PA05 |  | POS_MOTION
W | 11 | PA06 | SERCOM0/PAD[2] | POS_MOSI
W | 12 | PA07 | SERCOM0/PAD[3] | POS_SCLK
S | 13 | PA08 | SERCOM2/PAD[0] | LASER_SDA
S | 14 | PA09 | SERCOM2/PAD[1] | LASER_SCL
S | 15 | PA10 |  | MOTOR_SLEEP_12
S | 16 | PA11 | EXTINT[11] | MOTOR_FAULT_12
S | 19 | PB10 | EXTINT[10] | MOTOR_FAULT_34
S | 20 | PB11 |  | MOTOR_SLEEP_34
S | 21 | PA12 | TCC0/WO[6] | MOTOR_CTRL_1B
S | 22 | PA13 | TCC0/WO[7] | MOTOR_CTRL_1A
S | 23 | PA14 | TCC0/WO[4] | MOTOR_CTRL_2B
S | 24 | PA15 | TCC0/WO[5] | MOTOR_CTRL_2A
E | 25 | PA16 | EXTINT[0] | END_STOP_X+
E | 26 | PA17 | EXTINT[1] | END_STOP_X-
E | 27 | PA18 | EXTINT[2] | END_STOP_Y+
E | 28 | PA19 | EXTINT[3] | END_STOP_Y-
E | 29 | PA20 | EXTINT[4] | END_STOP_Z+
E | 30 | PA21 | EXTINT[5] | END_STOP_Z-
E | 31 | PA22 | EXTINT[6] | OC_DLOADS
E | 32 | PA23 | EXTINT[7] | OC_ALOADS
E | 33 | PA24 |  | USB_D-
E | 34 | PA25 |  | USB_D+
N | 37 | PB22 | TCC3/WO[0] | MOTOR_CTRL_3B
N | 38 | PB23 | TCC3/WO[1] | MOTOR_CTRL_3A
N | 39 | PA27 | TCC3/WO[6] | MOTOR_CTRL_4B
N | 41 | PA28 | TCC3/WO[7] | MOTOR_CTRL_4A
N | 45 | PA30 |  | SWCLK
N | 46 | PA31 |  | SWDIO
N | 47 | PB02 |  | ~PS_ALOADS
N | 48 | PB03 |  | ~PS_DLOADS

Sheet: SAMD51
Pin | Name | Side | Function
1 | PA00 | W | XIN32
2 | PA01 | W | XOUT32
3 | PA02 | W |  | ~PS_DLOADS
4 | PA03 | W |  | ~PS_ALOADS
5 | PB04 | W
6 | PB05 | W
7 | GNDANA | W
8 | VDDANA | W
9 | PB06 | W |  | ~POS1_NCS
10 | PB07 | W |  | ~POS2_NCS
11 | PB08 | W |  | ~POS2_NRESET
12 | PB09 | W |  | ~POS1_NRESET
13 | PA04 | W | SERCOM0/PAD[0] | POS_MOSI
14 | PA05 | W | SERCOM0/PAD[1] | POS_SCLK
15 | PA06 | W | SERCOM0/PAD[2] | POS_MISO
16 | PA07 | W | EIC/EXTINT[7] | POS_MOTION
17 | PA08 | S | TCC0/WO[0] | MOTOR_CTRL_1A
18 | PA09 | S | TCC0/WO[1] | MOTOR_CTRL_1B
19 | PA10 | S | TCC0/WO[2] | MOTOR_CTRL_2B
20 | PA11 | S | TCC0/WO[3] | MOTOR_CTRL_2A
21 | VDDIOB | S
22 | GNDANA | S
23 | PB10 | S | TCC0/WO[4] | MOTOR_CTRL_3A
24 | PB11 | S | TCC0/WO[5] | MOTOR_CTRL_3B
25 | PB12 | S | TCC3/WO[0] | MOTOR_CTRL_4B
26 | PB13 | S | TCC3/WO[1] | MOTOR_CTRL_4A
27 | PB14 | S | EIC/EXTINT[14] | MOTOR_FAULT_34
28 | PB15 | S |  | MOTOR_SLEEP_34
29 | PA12 | S |  | MOTOR_SLEEP_12
30 | PA13 | S | EIC/EXTINT[13] | MOTOR_FAULT_12
31 | PA14 | S | XIN
32 | PA15 | S | XOUT
33 | GND | E
34 | VDDIO | E
35 | PA16 | E | EIC/EXTINT[0] | END_STOP_X+
36 | PA17 | E | EIC/EXTINT[1] | END_STOP_X-
37 | PA18 | E | EIC/EXTINT[2] | END_STOP_Y+
38 | PA19 | E | EIC/EXTINT[3] | END_STOP_Y-
39 | PB16 | E
40 | PB17 | E
41 | PA20 | E | EIC/EXTINT[4] | END_STOP_Z+
42 | PA21 | E | EIC/EXTINT[5] | END_STOP_Z-
43 | PA22 | E
44 | PA23 | E
45 | PA24 | E | USB/DM | USB_D-
46 | PA25 | E | USB/DP | USB_D+
47 | GND | E
48 | VDDIO | E
49 | PB22 | N | EIC/EXTINT[6] | OC_ALOADS
50 | PB23 | N
51 | PA27 | N | EIC/EXTINT[11] | OC_DLOADS
52 | RESETN | N
53 | VDDCORE | N
54 | GND | N
55 | VSW | N
56 | VDDIO | N
57 | PA30 | N | CORTEX_CM4/SWCLK
58 | PA31 | N | CORTEX_CM4/SWDIO
59 | PB30 | N | SERCOM5/PAD[1] | LASER_SCL
60 | PB31 | N | SERCOM5/PAD[0] | LASER_SDA
61 | PB00 | N
62 | PB01 | N
63 | PB02 | N
