nunosousa/TelescopeMirrorTester/Tester/ECAD/ControllerBoard/Crystal.xlsx

CLEXT | 23.90655738 | pF | Capacitance of the external capacitors
inputs
CL | 20 | pF | crystal load capacitance
CPARA | 3.0 | pF | internal load capacitor parasitic between XIN and XOUT
CPCB | 5 | pF | capacitance of the PCB
CSHUNT | 0 | pF | shunt capacitance of the crystal as specified by the crystal manufacturer
CPARA | 3.0 | pF | internal load capacitor parasitic between XIN and XOUT
inputs
CXIN | 6.3 | pF
CXOUT | 5.9 | pF
XTAL F | Max ESR
16 MHz | 180 | ohm
XTAL F | Max Crystal Load
16 Mhz | 20 | pF
