nunosousa/TelescopeMirrorTester/Software/Jupyter Notebooks/Exploratory Foucault test data reduction/figures/diagram_3.pdf

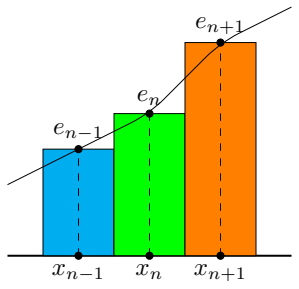
[picture p101: figure]
