nunosousa/TelescopeMirrorTester/Software/Jupyter Notebooks/Exploratory Foucault test data reduction/figures/diagram_2.pdf

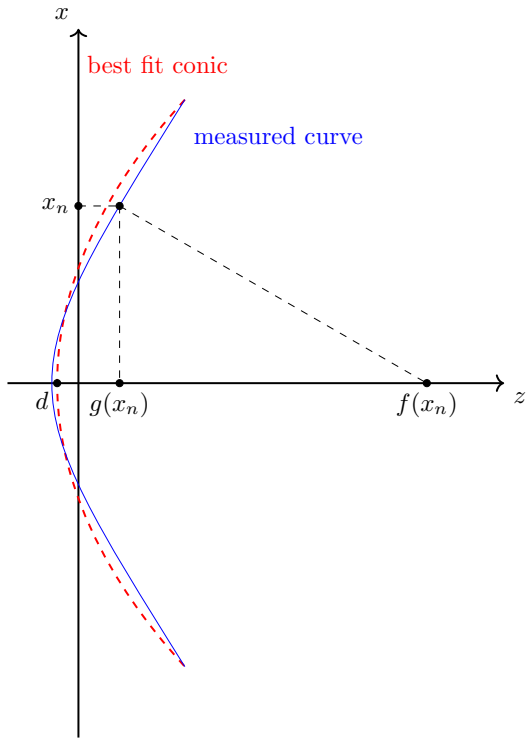
[picture p102: figure]
best fit conic; measured curve
