nunosousa/TelescopeMirrorTester/Software/Jupyter Notebooks/Exploratory Foucault test data reduction/formula derivation notes/dx.pdf

x*x

Volume of a cylinder? Piece of cake.

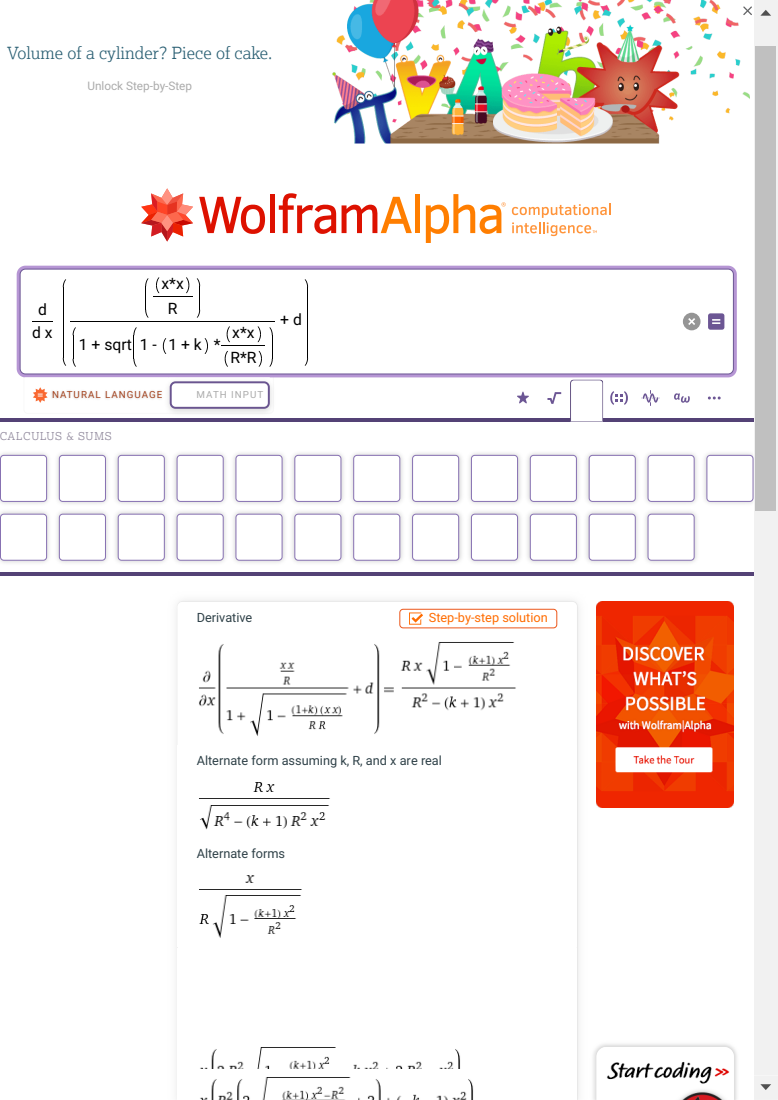
[picture p103: page 1]
1 + sqrt; CALCULUS & SUMS; Derivative; Step-by-step solution; Alternate forms; NATURAL LANGUAGE; MATH INPUT

Unlock Step-by-Step (https://www.wolframalpha.com/pro/pricing/students)

Alternate form assuming k, R, and x are real
