nunosousa/TelescopeMirrorTester/ECAD/LightSource/Schematic.pdf

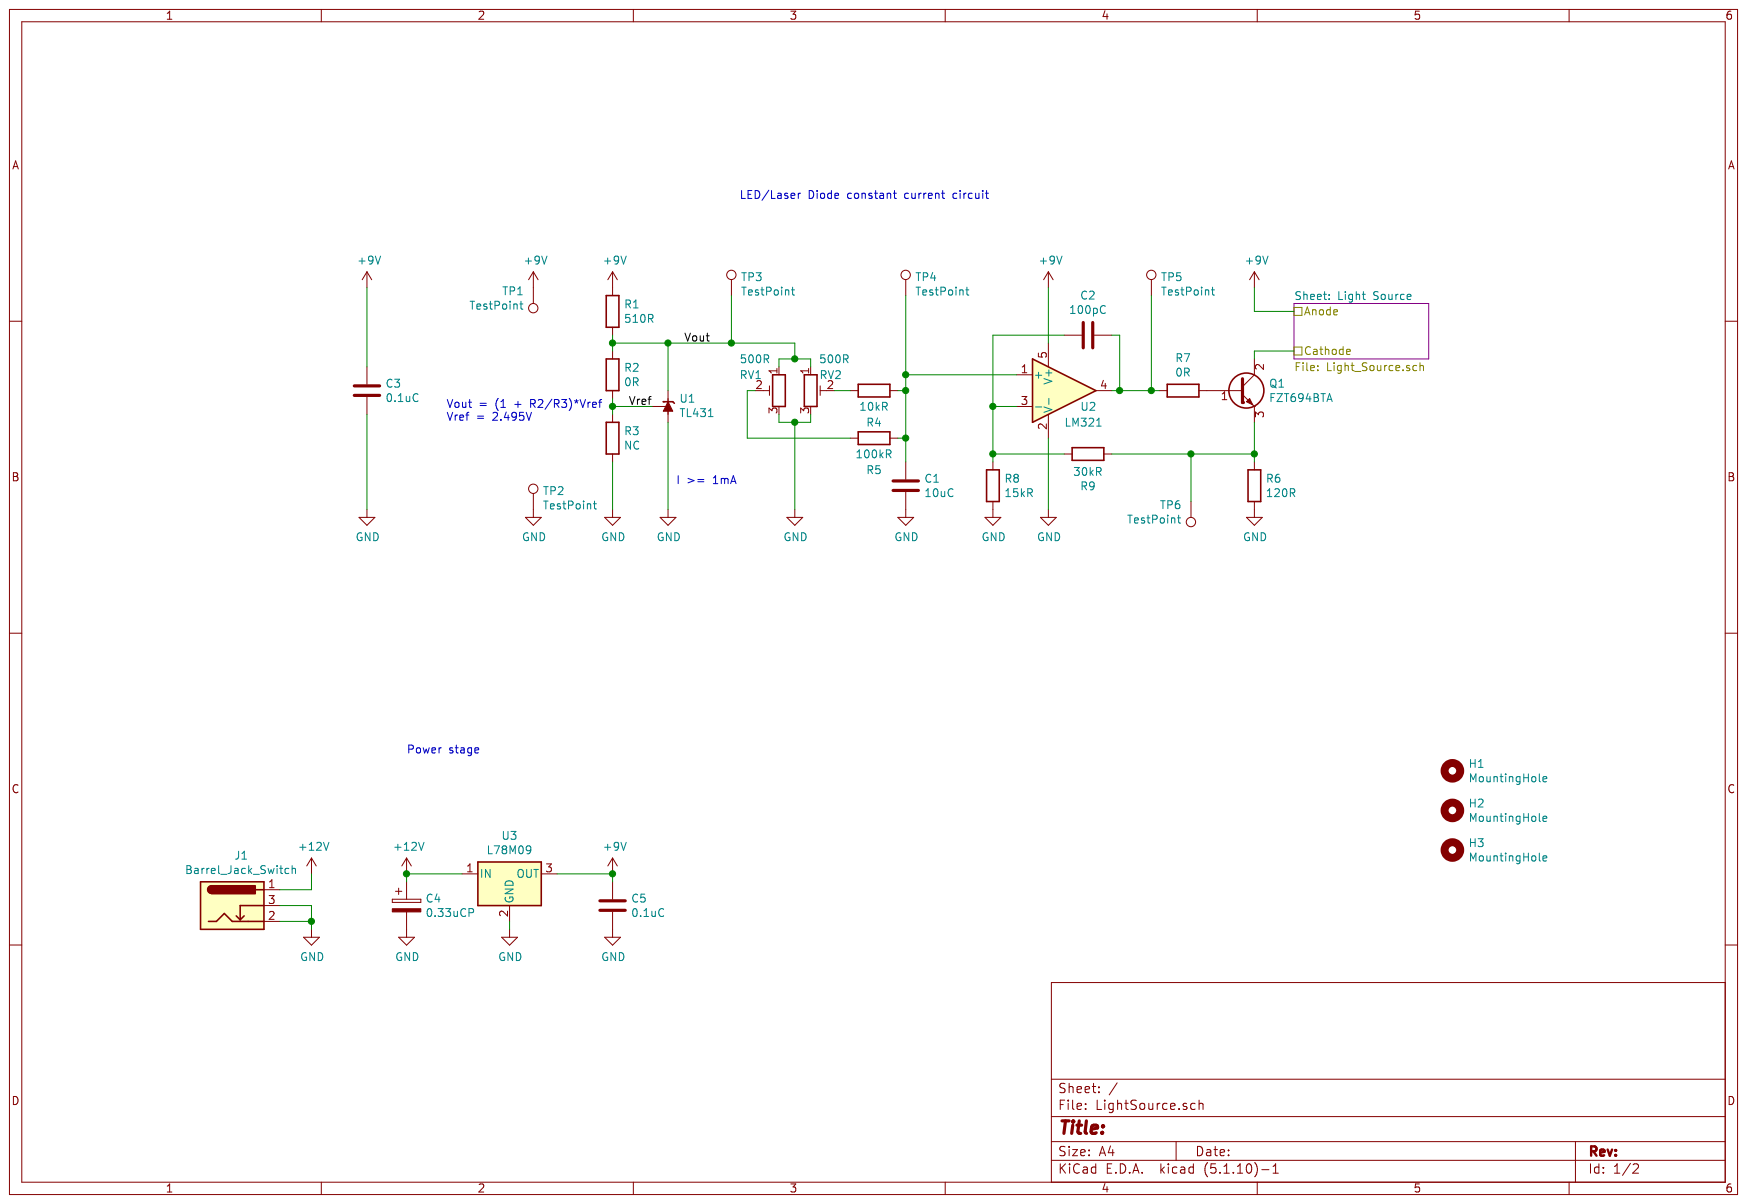
[picture p104: page 1]

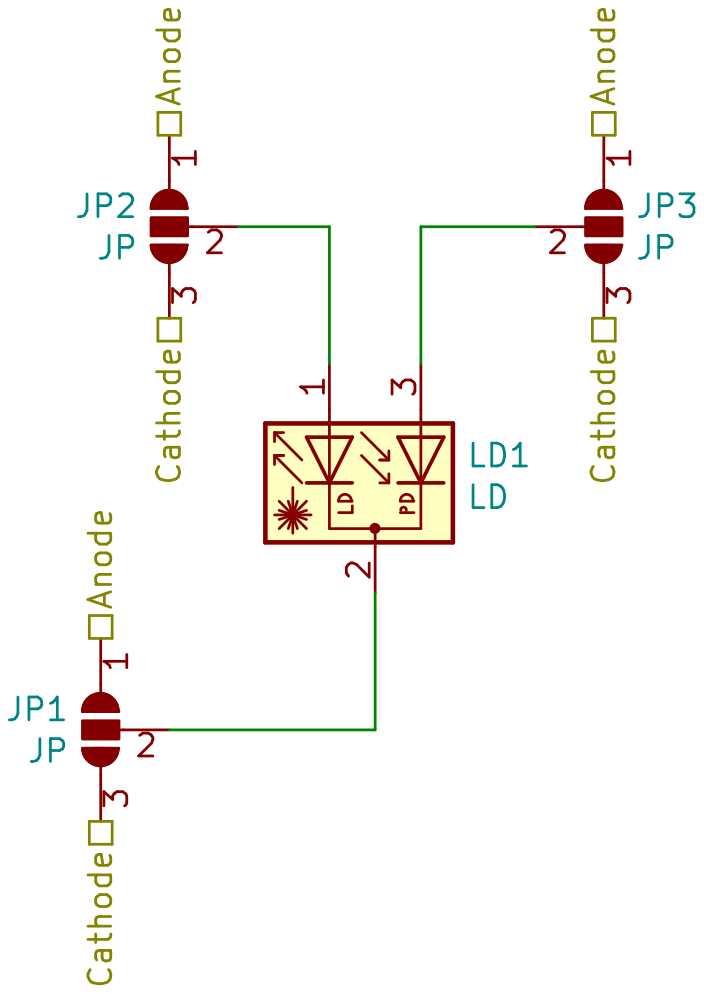
[picture p105: page 2]
