nunosousa/TelescopeMirrorTester/ECAD/LightSourceLED/Schematic.pdf

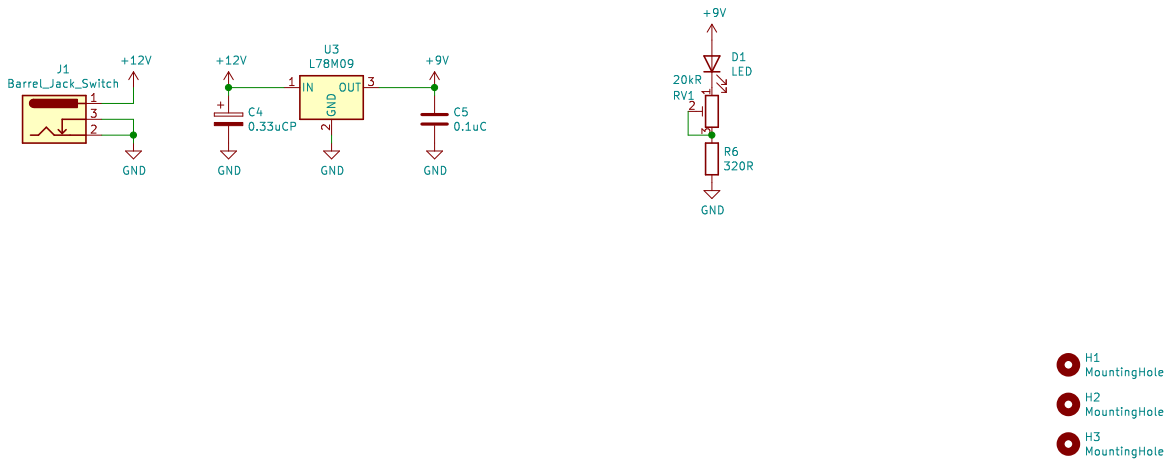
[picture p106: page 1]
