nunosousa/TelescopeMirrorTester/Software/Jupyter Notebooks/Exploratory Foucault test data reduction/figures/diagram_4.pdf

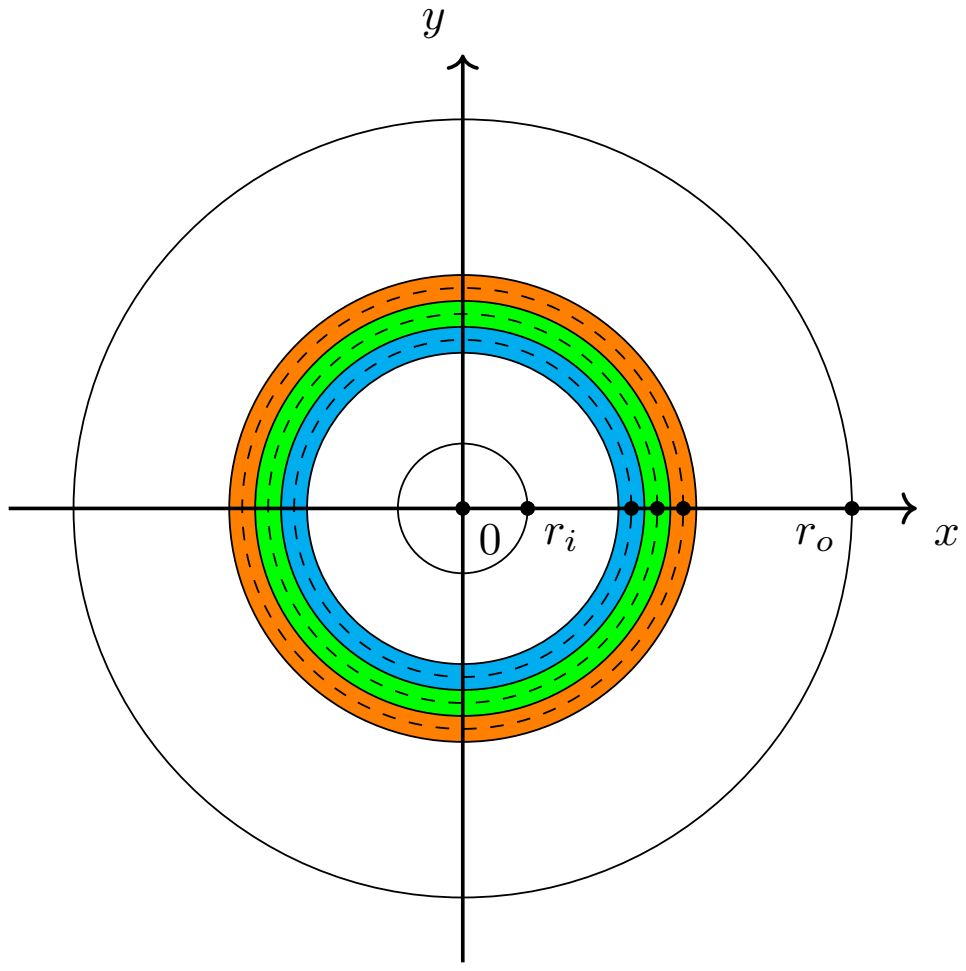
[picture p107: page 1]
