nunosousa/TelescopeMirrorTester/Software/Jupyter Notebooks/Exploratory Foucault test data reduction/figures/diagram_1.pdf

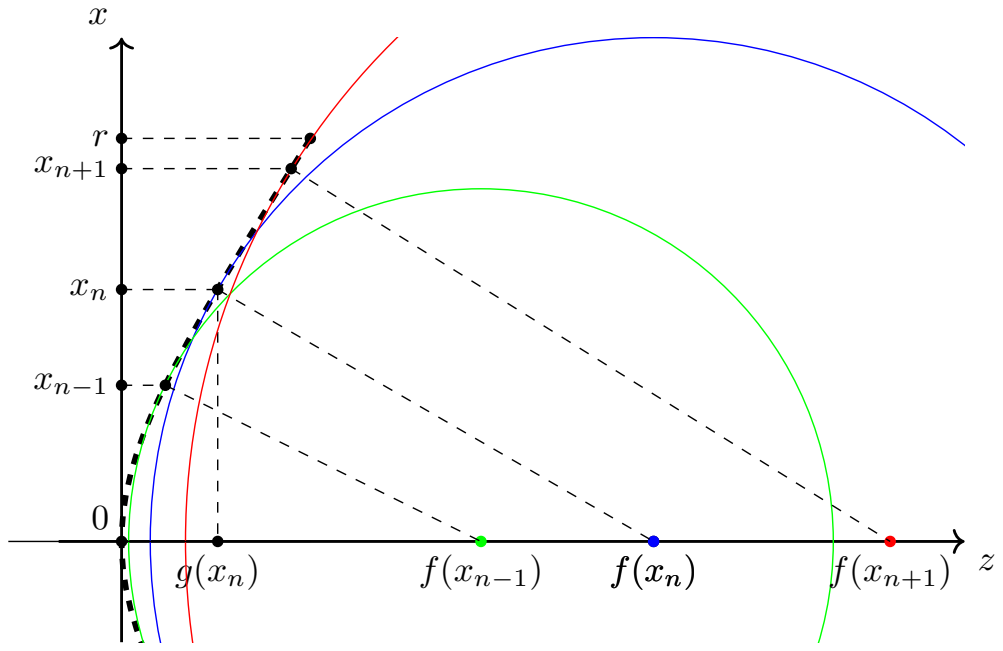
[picture p108: page 1]
