nunosousa/TelescopeMirrorTester/Software/Jupyter Notebooks/Exploratory Foucault test data reduction/formula derivation notes/dd.pdf

## 1 + sqrt 1 - 1 + k *

R*R

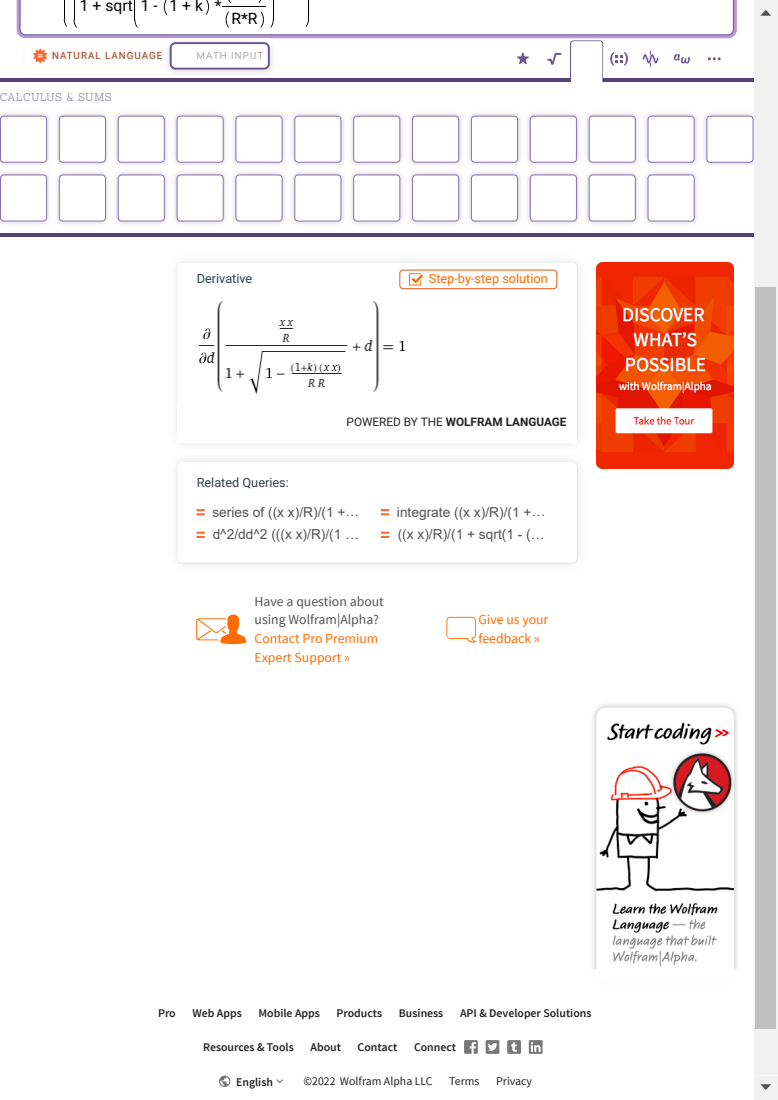
[picture p109: page 1]
CALCULUS & SUMS; Related Queries:; series of ((x x)/R)/(1 +…; integrate ((x x)/R)/(1 +…; ((x x)/R)/(1 + sqrt(1 - (…; Derivative; Step-by-step solution; Pro; Web Apps; Mobile Apps; Products; Business; API & Developer Solutions; Resources & Tools; About; Contact; Connect; English; ©2022 Wolfram Alpha LLC; Terms; Privacy; NATURAL LANGUAGE; MATH INPUT

POWERED BY THE WOLFRAM LANGUAGE (https://www.wolfram.com/language/index.html.en)

Have a question about
using Wolfram|Alpha?
Contact Pro Premium
Expert Support » (https://www.wolframalpha.com/pro-premium-expert-support)

Give us your
feedback » (https://www.wolframalpha.com/feedback)
