nunosousa/TelescopeMirrorTester/Software/Jupyter Notebooks/Exploratory Foucault test data reduction/formula derivation notes/dk.pdf

R*R

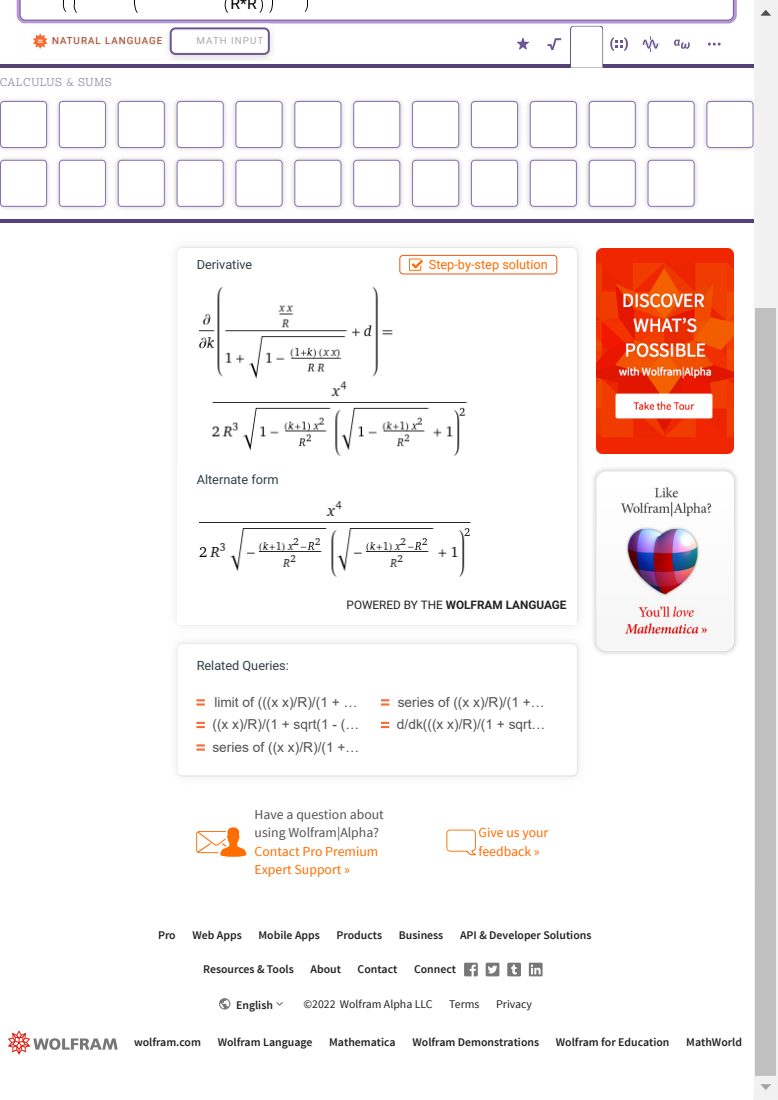
[picture p110: page 1]
CALCULUS & SUMS; Related Queries:; limit of (((x x)/R)/(1 + …; series of ((x x)/R)/(1 +…; ((x x)/R)/(1 + sqrt(1 - (…; d/dk(((x x)/R)/(1 + sqrt…; Derivative; Step-by-step solution; Alternate form; Pro; Web Apps; Mobile Apps; Products; Business; API & Developer Solutions; Resources & Tools; About; Contact; Connect; ©2022 Wolfram Alpha LLC; Terms; Privacy; wolfram.com; Wolfram Language; Mathematica; Wolfram Demonstrations; Wolfram for Education; MathWorld; English; NATURAL LANGUAGE; MATH INPUT

POWERED BY THE WOLFRAM LANGUAGE (https://www.wolfram.com/language/index.html.en)

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

Give us your
feedback » (https://www.wolframalpha.com/feedback)
