nunosousa/TelescopeMirrorTester/Software/Jupyter Notebooks/Exploratory Foucault test data reduction/formula derivation notes/dR.pdf

d R

d

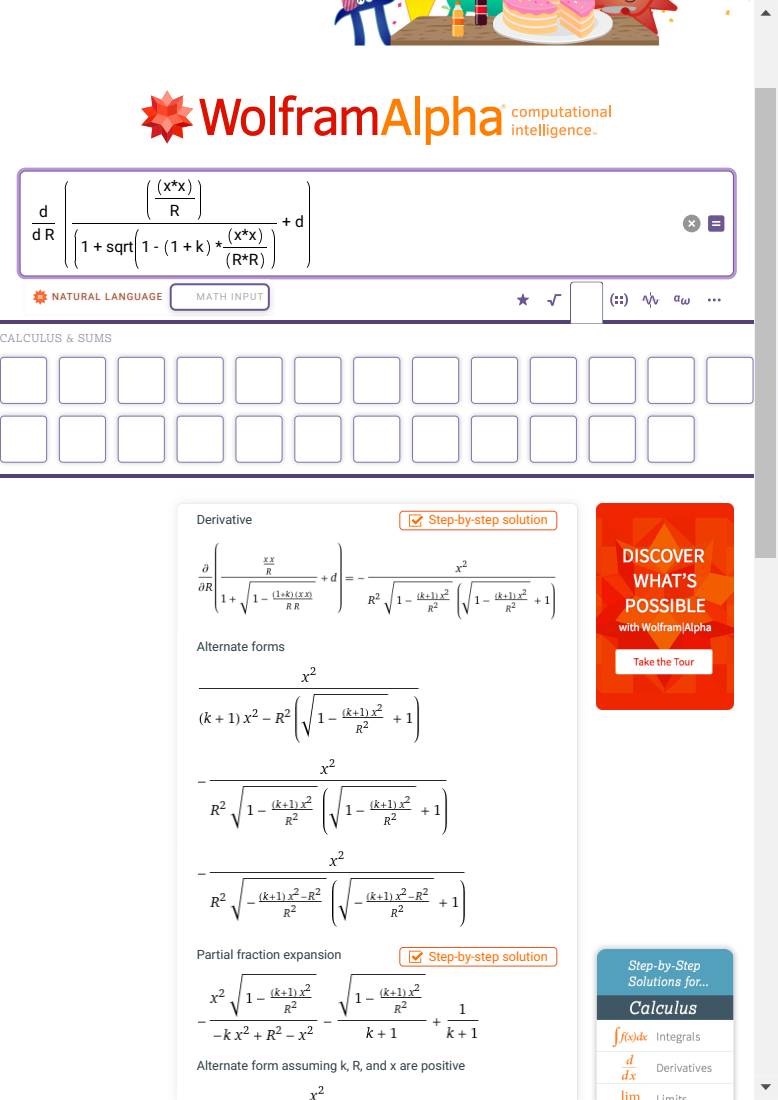
[picture p111: page 1]
1 + sqrt; CALCULUS & SUMS; Derivative; Step-by-step solution; Alternate forms; Partial fraction expansion; NATURAL LANGUAGE; MATH INPUT

Alternate form assuming k, R, and x are positive
