nunosousa/TelescopeMirrorTester/ECAD/PowerDeliveryBoard/PowerDeliveryBoard.pdf

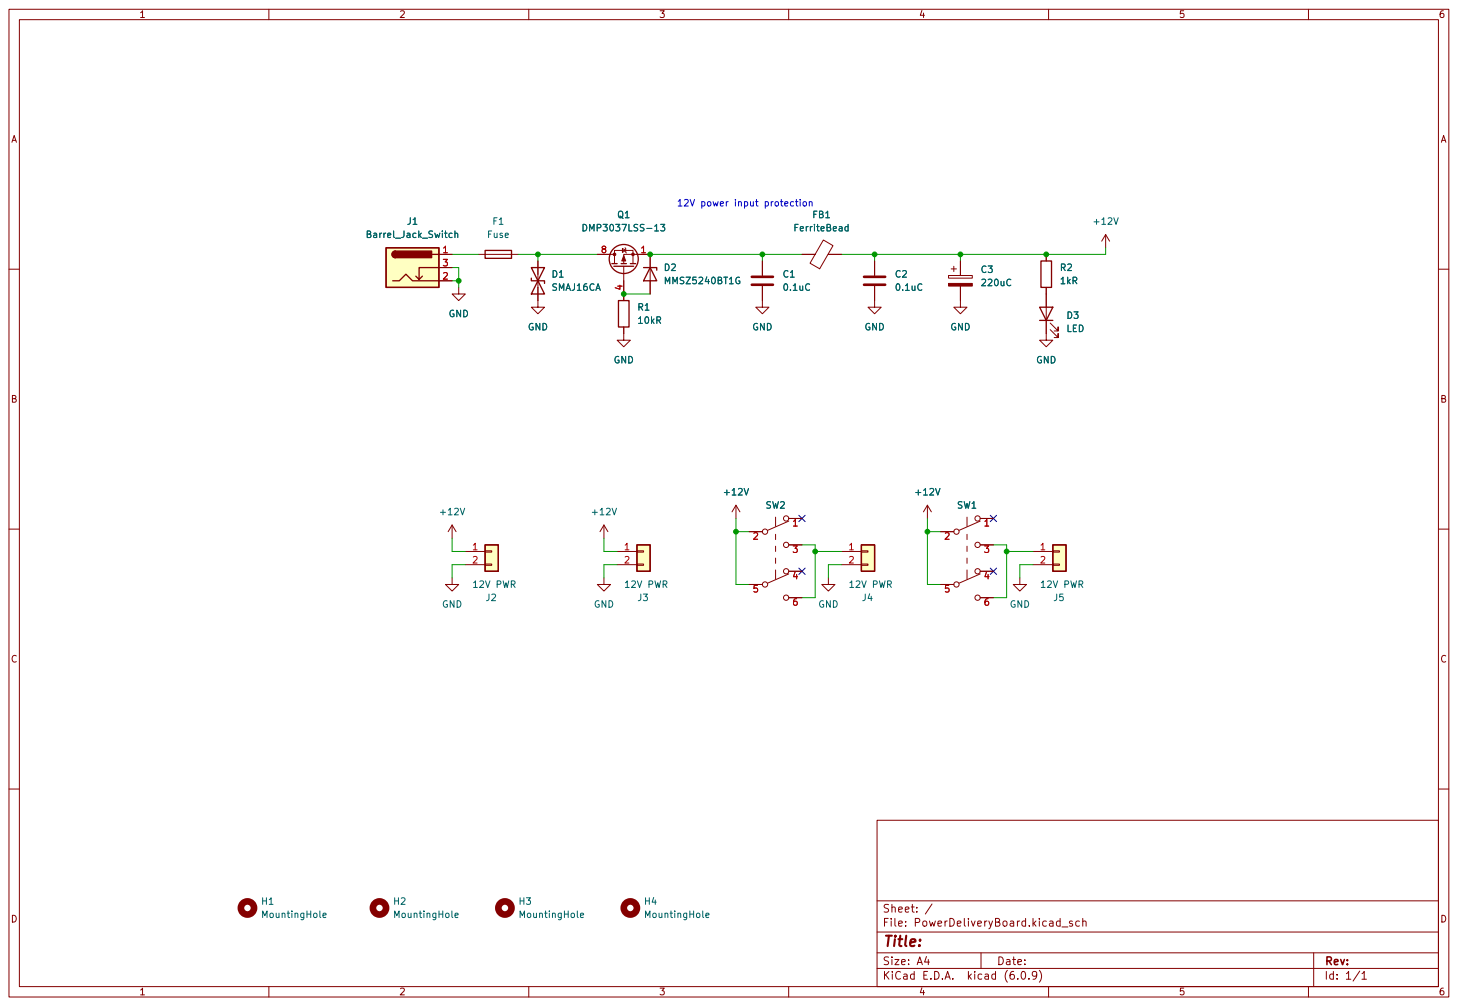
[picture p112: page 1]
