nunosousa/TelescopeMirrorTester/ECAD/BDCMotorControlShieldMega/Circuit Simulation/ADC clipper.asc

D4: diode; BAV99HY
D5: diode; BAV99HY
R1: res; 1kR
R2: res; 1kR
R3: res; 10kR
R5: res; 1kR
R6: res; 1kR
R7: res; 1kR
R8: res; 1kR
R9: res; 1kR
R11: res; 1kR
U5: AD8648
U6: AD8648
U7: AD8648
U8: AD8648
V1: voltage; 0
V2: voltage; 5
V4: voltage; -5
V10: voltage; 3
V11: voltage; SINE(2.5 2.5 300k)
Named nets: 0
.tran 0.0001
