nunosousa/TelescopeMirrorTester/ECAD/BDCMotorController/BDCMotorController.kicad_pcb

## KiCad design ECAD/BDCMotorController/BDCMotorController.kicad_pcb (2026-01-04)

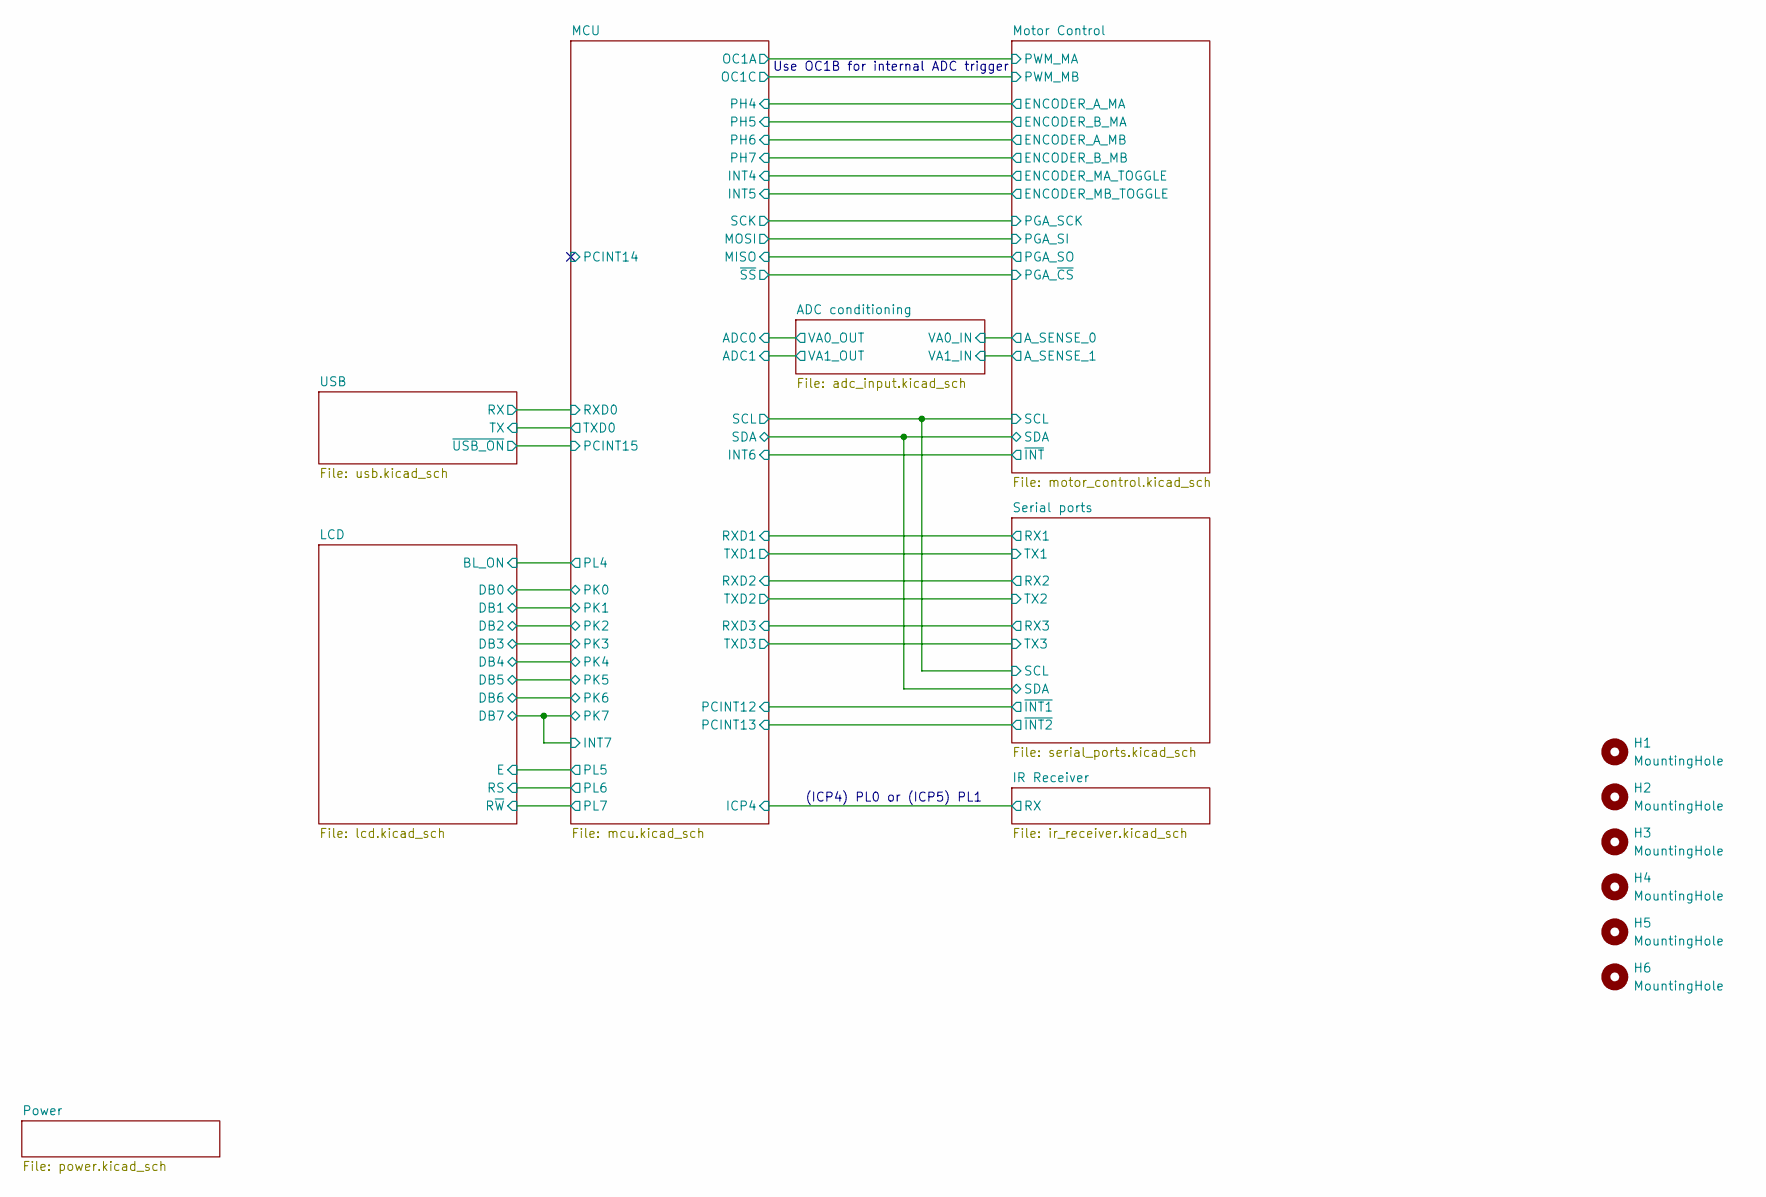
[picture p113: schematic BDCMotorController.kicad_sch]

Parts:
H1, H2, H3, H4, H5, H6: MountingHole; MountingHole_3.2mm_M3

Notes on the sheet:
Use OC1B for internal ADC trigger
(ICP4) PL0 or (ICP5) PL1

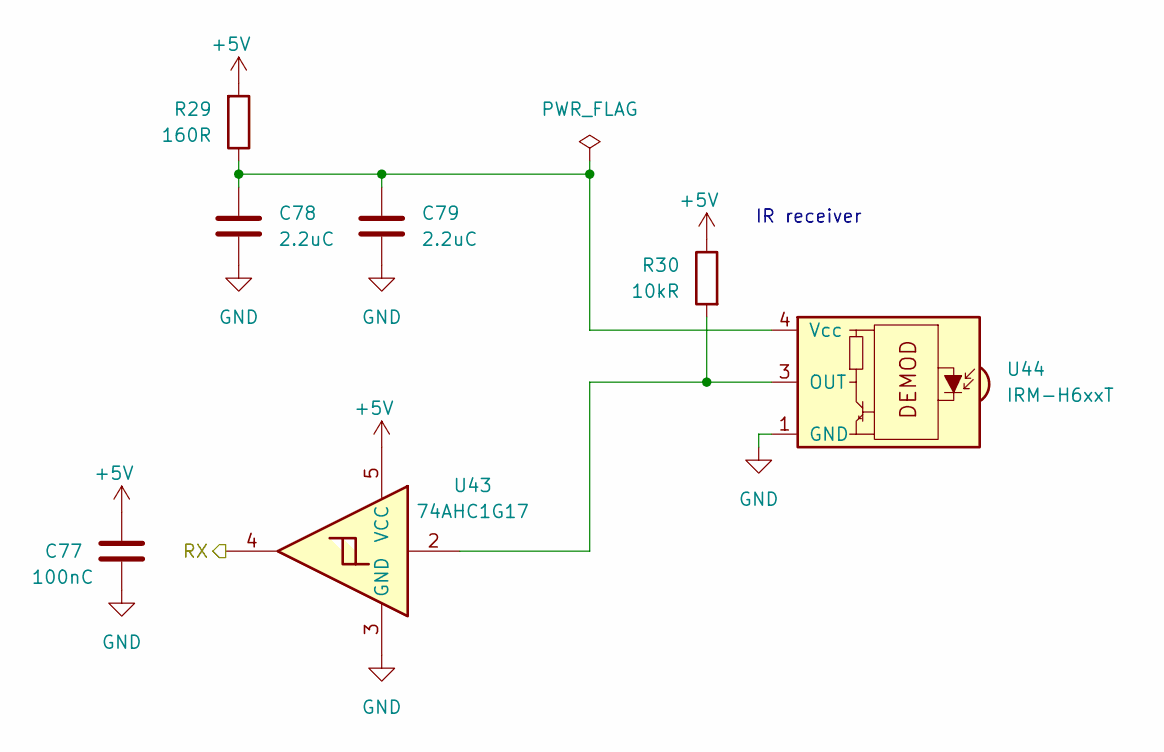
[picture p114: schematic ir_receiver.kicad_sch]

Parts:
C77: 100nC; C_0805_2012Metric
C78, C79: 2.2uC; C_0805_2012Metric
R29: 160R; R_0805_2012Metric; MPN AC0805FR-7W160RL
R30: 10kR; R_0805_2012Metric
U43: 74AHC1G17; SC-74A-5_1.55x2.9mm_P0.95mm; MPN 74AHC1G17GVH
U44: IRM-H6xxT; Everlight_IRM-H6xxT; MPN IRM-H638J7/TR2(CLW)

Connections:
+5V: C77.1, R29.2, R30.1, U43.5 (VCC); also elsewhere on the board
/IR Receiver/RX: U43.4; also elsewhere on the board
GND: C77.2, C78.2, C79.2, U43.3 (GND), U44.1 (GND), U44.2 (GND); also elsewhere on the board
unnamed: R30.2, U43.2, U44.3 (OUT)
unnamed: C78.1, C79.1, R29.1, U44.4 (Vcc)

Notes on the sheet:
IR receiver

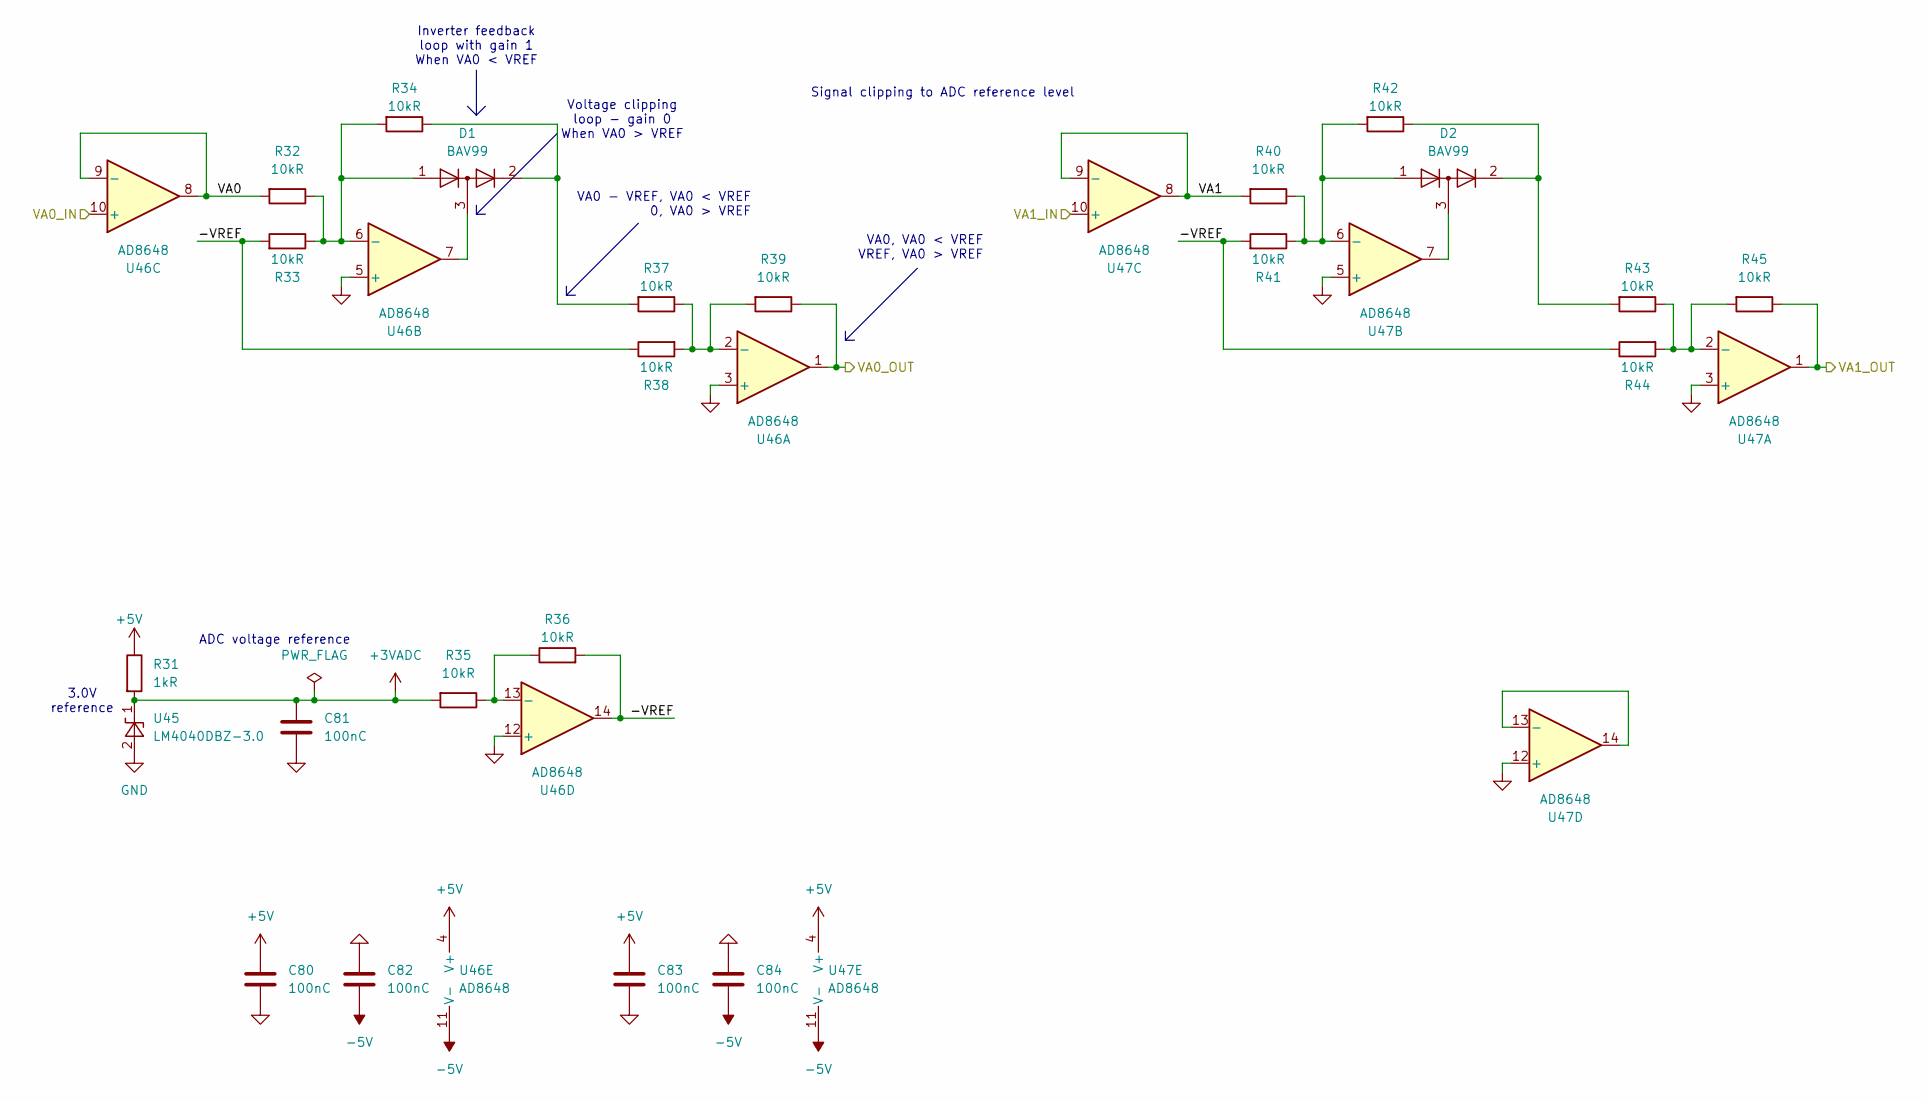
[picture p115: schematic adc_input.kicad_sch]

Parts:
C80, C81, C82, C83, C84: 100nC; C_0805_2012Metric
D1, D2: BAV99; SOT-23; MPN BAV99,215
R31: 1kR; R_0805_2012Metric
R32, R33, R34, R35, R36, R37, R38, R39, R40, R41, R42, R43, R44, R45: 10kR; R_0805_2012Metric
U45: LM4040DBZ-3.0; SOT-23; MPN LM4040B30IDBZR
U46, U47: AD8648; TSSOP-14_4.4x5mm_P0.65mm; MPN AD8648ARUZ

Connections:
+3VADC: C81.1, R31.2, R35.2, U45.1 (K); also elsewhere on the board
+5V: C80.1, C83.1, R31.1, U46.4 (V+), U47.4 (V+); also elsewhere on the board
-5V: C82.2, C84.2, U46.11 (V-), U47.11 (V-); also elsewhere on the board
/ADC conditioning/-VREF: R33.2, R36.2, R38.1, R41.2, R44.1, U46.14
/ADC conditioning/VA0: R32.2, U46.8, U46.9 (-)
/ADC conditioning/VA0_IN: U46.10 (+); also elsewhere on the board
/ADC conditioning/VA0_OUT: R39.1, U46.1; also elsewhere on the board
/ADC conditioning/VA1: R40.2, U47.8, U47.9 (-)
/ADC conditioning/VA1_IN: U47.10 (+); also elsewhere on the board
/ADC conditioning/VA1_OUT: R45.1, U47.1; also elsewhere on the board
GND: C80.2, C81.2, C82.1, C83.2, C84.1, U45.2 (A), U46.3 (+), U46.5 (+), U46.12 (+), U47.3 (+), U47.5 (+), U47.12 (+); also elsewhere on the board
unnamed: D1.2 (A), R34.1, R37.2
unnamed: D1.3 (K), U46.7
unnamed: D2.2 (A), R42.1, R43.2
unnamed: D2.3 (K), U47.7
unnamed: R37.1, R38.2, R39.2, U46.2 (-)
unnamed: D1.1 (K), R32.1, R33.1, R34.2, U46.6 (-)
unnamed: R35.1, R36.1, U46.13 (-)
unnamed: R43.1, R44.2, R45.2, U47.2 (-)
unnamed: D2.1 (K), R40.1, R41.1, R42.2, U47.6 (-)
unnamed: U47.13 (-), U47.14

Notes on the sheet:
Inverter feedback loop with gain 1 When VA0 < VREF
3.0V reference
ADC voltage reference
Signal clipping to ADC reference level
Voltage clipping loop - gain 0 When VA0 > VREF
VA0, VA0 < VREF VREF, VA0 > VREF
VA0 - VREF, VA0 < VREF 0, VA0 > VREF

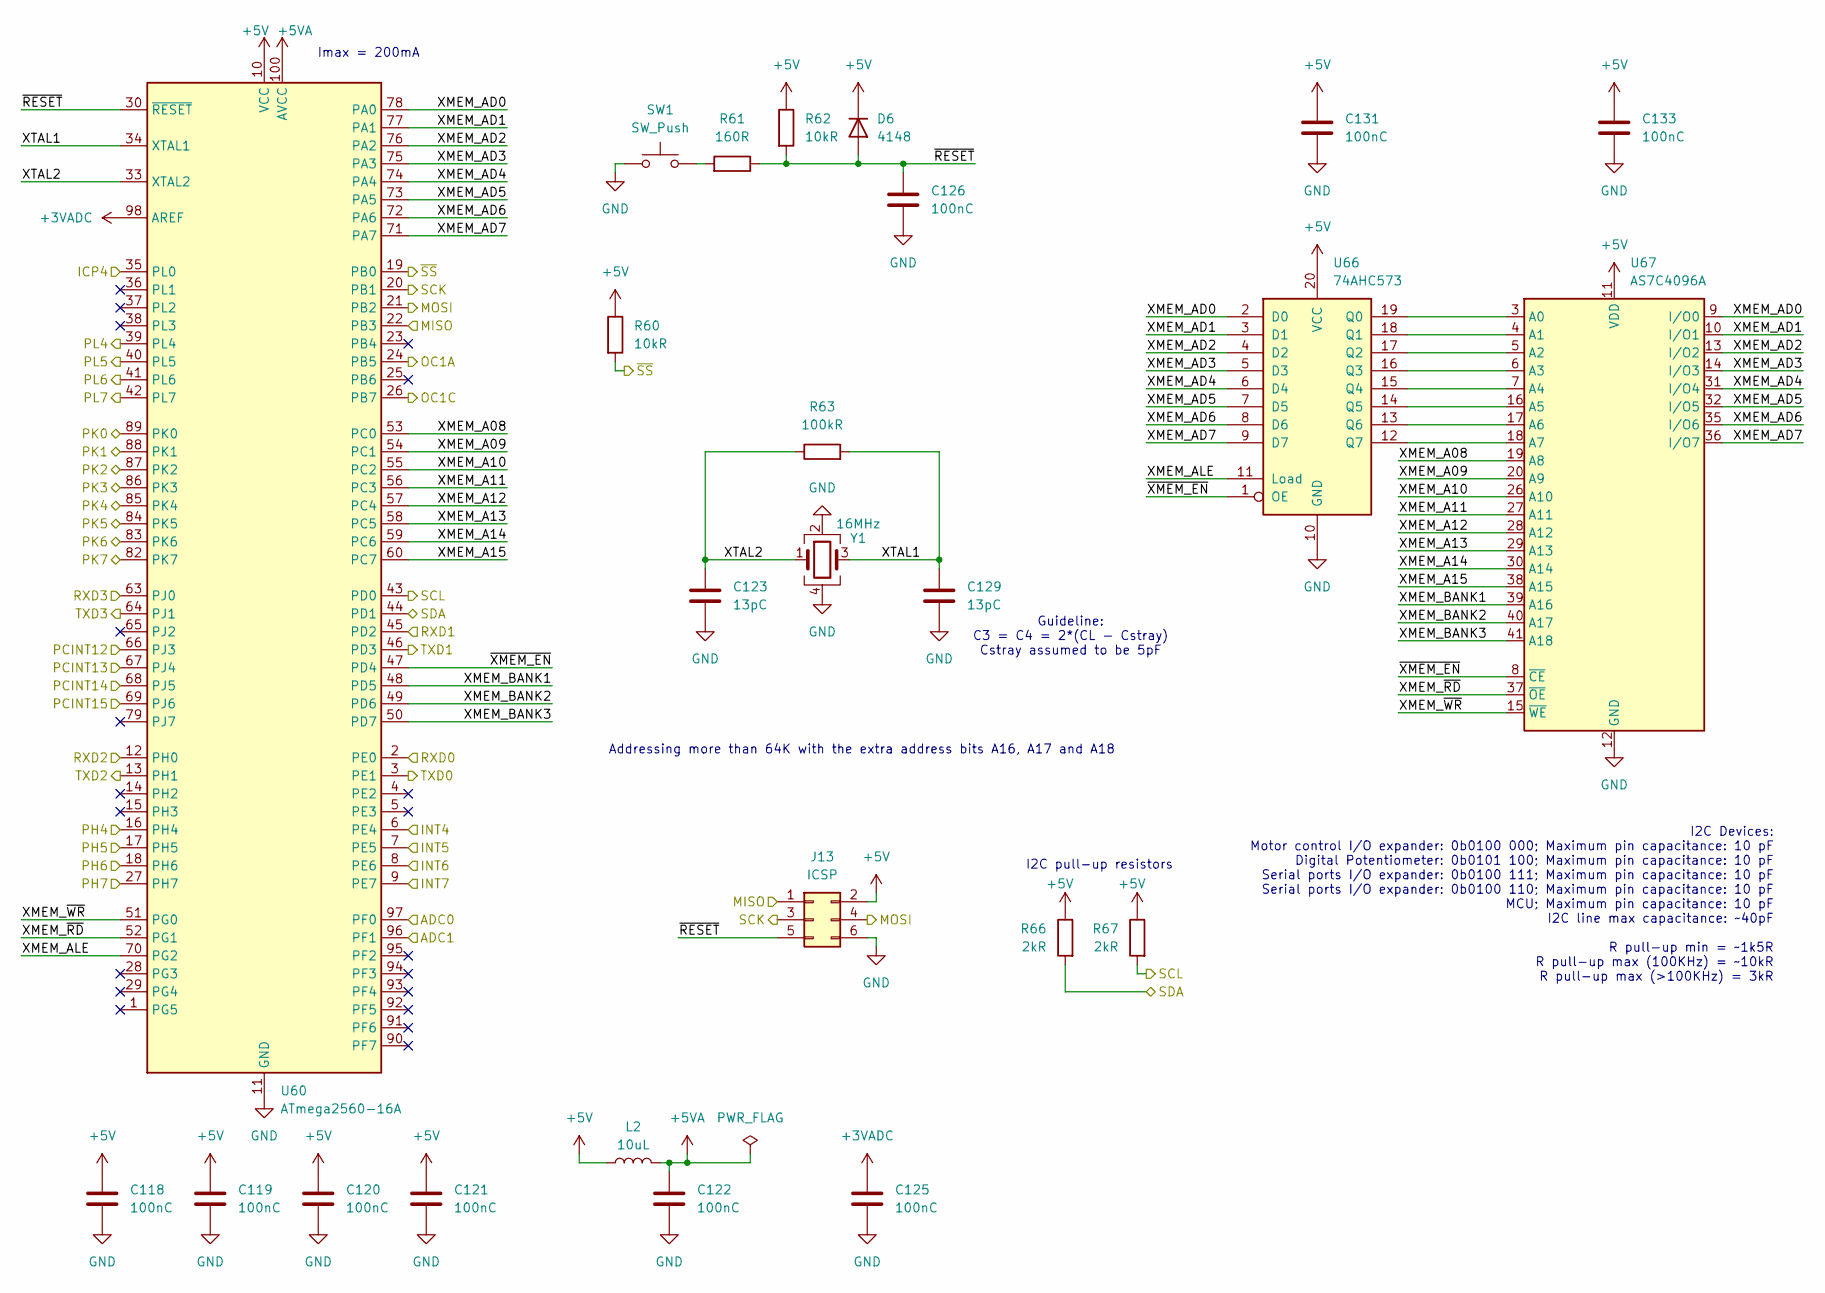
[picture p116: schematic mcu.kicad_sch]

Parts:
C118, C119, C120, C121, C122, C125, C126, C131, C133: 100nC; C_0805_2012Metric
C123, C129: 13pC; C_0805_2012Metric; MPN 0805CG130J500NT
D6: 4148; D_SOD-123; MPN MMSD4148T1G
J13: ICSP; PinHeader_2x03_P2.54mm_Vertical; MPN PZ254-2-03-Z-8.5
L2: 10uL; L_1210_3225Metric; MPN NLV32T-100J-EF
R60, R62: 10kR; R_0805_2012Metric
R61: 160R; R_0805_2012Metric; MPN AC0805FR-7W160RL
R63: 100kR; R_0805_2012Metric; MPN RT0805BRD07100KL
R66, R67: 2kR; R_0805_2012Metric
SW1: SW_Push; SW_PUSH_6mm_H13mm
U60: ATmega2560-16A; TQFP-100_14x14mm_P0.5mm; MPN ATMEGA2560-16AU
U66: 74AHC573; TSSOP-20_4.4x6.5mm_P0.65mm; MPN 74AHC573PW,118
U67: AS7C4096A; TSOP-II-44_10.16x18.41mm_P0.8mm; MPN AS7C4096A-12TIN
Y1: 16MHz; Crystal_SMD_3225-4Pin_3.2x2.5mm; MPN X1E0000210119

Connections:
+3VADC: C125.1, U60.98 (AREF); also elsewhere on the board
+5V: C118.1, C119.1, C120.1, C121.1, C131.1, C133.1, D6.1 (K), J13.2, L2.1, R60.1, R62.1, R66.1, R67.1, U60.10 (VCC), U60.31 (VCC), U60.61 (VCC), U60.80 (VCC), U66.20 (VCC), U67.11 (VDD), U67.33 (VDD); also elsewhere on the board
+5VA: C122.1, L2.2, U60.100 (AVCC)
/ADC conditioning/VA0_OUT: U60.97 (PF0); also elsewhere on the board
/ADC conditioning/VA1_OUT: U60.96 (PF1); also elsewhere on the board
/IR Receiver/RX: U60.35 (PL0); also elsewhere on the board
/LCD/BL_ON: U60.39 (PL4); also elsewhere on the board
/LCD/DB0: U60.89 (PK0); also elsewhere on the board
/LCD/DB1: U60.88 (PK1); also elsewhere on the board
/LCD/DB2: U60.87 (PK2); also elsewhere on the board
/LCD/DB3: U60.86 (PK3); also elsewhere on the board
/LCD/DB4: U60.85 (PK4); also elsewhere on the board
/LCD/DB5: U60.84 (PK5); also elsewhere on the board
/LCD/DB6: U60.83 (PK6); also elsewhere on the board
/LCD/DB7: U60.9 (PE7), U60.82 (PK7); also elsewhere on the board
/LCD/E: U60.40 (PL5); also elsewhere on the board
/LCD/RS: U60.41 (PL6); also elsewhere on the board
/LCD/R~W: U60.42 (PL7); also elsewhere on the board
/MCU/INT4: U60.6 (PE4); also elsewhere on the board
/MCU/INT5: U60.7 (PE5); also elsewhere on the board
/MCU/INT6: U60.8 (PE6); also elsewhere on the board
/MCU/MISO: J13.1, U60.22 (PB3); also elsewhere on the board
/MCU/MOSI: J13.4, U60.21 (PB2); also elsewhere on the board
/MCU/OC1A: U60.24 (PB5); also elsewhere on the board
/MCU/OC1C: U60.26 (PB7); also elsewhere on the board
/MCU/PCINT12: U60.66 (PJ3); also elsewhere on the board
/MCU/PCINT13: U60.67 (PJ4); also elsewhere on the board
/MCU/PCINT14: U60.68 (PJ5)
/MCU/PCINT15: U60.69 (PJ6); also elsewhere on the board
/MCU/PH4: U60.16 (PH4); also elsewhere on the board
/MCU/PH5: U60.17 (PH5); also elsewhere on the board
/MCU/PH6: U60.18 (PH6); also elsewhere on the board
/MCU/PH7: U60.27 (PH7); also elsewhere on the board
/MCU/RXD0: U60.2 (PE0); also elsewhere on the board
/MCU/RXD1: U60.45 (PD2); also elsewhere on the board
/MCU/RXD2: U60.12 (PH0); also elsewhere on the board
/MCU/RXD3: U60.63 (PJ0); also elsewhere on the board
/MCU/SCK: J13.3, U60.20 (PB1); also elsewhere on the board
/MCU/SCL: R67.2, U60.43 (PD0); also elsewhere on the board
/MCU/SDA: R66.2, U60.44 (PD1); also elsewhere on the board
/MCU/TXD0: U60.3 (PE1); also elsewhere on the board
/MCU/TXD1: U60.46 (PD3); also elsewhere on the board
/MCU/TXD2: U60.13 (PH1); also elsewhere on the board
/MCU/TXD3: U60.64 (PJ1); also elsewhere on the board
/MCU/XMEM_A08: U60.53 (PC0), U67.19 (A8)
/MCU/XMEM_A09: U60.54 (PC1), U67.20 (A9)
/MCU/XMEM_A10: U60.55 (PC2), U67.26 (A10)
/MCU/XMEM_A11: U60.56 (PC3), U67.27 (A11)
/MCU/XMEM_A12: U60.57 (PC4), U67.28 (A12)
/MCU/XMEM_A13: U60.58 (PC5), U67.29 (A13)
/MCU/XMEM_A14: U60.59 (PC6), U67.30 (A14)
/MCU/XMEM_A15: U60.60 (PC7), U67.38 (A15)
/MCU/XMEM_AD0: U60.78 (PA0), U66.2 (D0), U67.9 (I/O0)
/MCU/XMEM_AD1: U60.77 (PA1), U66.3 (D1), U67.10 (I/O1)
/MCU/XMEM_AD2: U60.76 (PA2), U66.4 (D2), U67.13 (I/O2)
/MCU/XMEM_AD3: U60.75 (PA3), U66.5 (D3), U67.14 (I/O3)
/MCU/XMEM_AD4: U60.74 (PA4), U66.6 (D4), U67.31 (I/O4)
/MCU/XMEM_AD5: U60.73 (PA5), U66.7 (D5), U67.32 (I/O5)
/MCU/XMEM_AD6: U60.72 (PA6), U66.8 (D6), U67.35 (I/O6)
/MCU/XMEM_AD7: U60.71 (PA7), U66.9 (D7), U67.36 (I/O7)
/MCU/XMEM_ALE: U60.70 (PG2), U66.11 (Load)
/MCU/XMEM_BANK1: U60.48 (PD5), U67.39 (A16)
/MCU/XMEM_BANK2: U60.49 (PD6), U67.40 (A17)
/MCU/XMEM_BANK3: U60.50 (PD7), U67.41 (A18)
/MCU/XMEM_~RD: U60.52 (PG1), U67.37 (~OE)
/MCU/XMEM_~WR: U60.51 (PG0), U67.15 (~WE)
/MCU/XTAL1: C129.1, R63.2, U60.34 (XTAL1), Y1.3
/MCU/XTAL2: C123.1, R63.1, U60.33 (XTAL2), Y1.1
/MCU/~RESET: C126.1, D6.2 (A), J13.5, R61.1, R62.2, U60.30 (~RESET)
/MCU/~SS: R60.2, U60.19 (PB0); also elsewhere on the board
/MCU/~XMEM_EN: U60.47 (PD4), U66.1 (OE), U67.8 (~CE)
GND: C118.2, C119.2, C120.2, C121.2, C122.2, C123.2, C125.2, C126.2, C129.2, C131.2, C133.2, J13.6, SW1.1, U60.11 (GND), U60.32 (GND), U60.62 (GND), U60.81 (GND), U60.99 (GND), U66.10 (GND), U67.12 (GND), U67.34 (GND), Y1.2, Y1.4; also elsewhere on the board
unnamed: R61.2, SW1.2
unnamed: U66.19 (Q0), U67.3 (A0)
unnamed: U66.18 (Q1), U67.4 (A1)
unnamed: U66.17 (Q2), U67.5 (A2)
unnamed: U66.16 (Q3), U67.6 (A3)
unnamed: U66.15 (Q4), U67.7 (A4)
unnamed: U66.14 (Q5), U67.16 (A5)
unnamed: U66.13 (Q6), U67.17 (A6)
unnamed: U66.12 (Q7), U67.18 (A7)

Notes on the sheet:
Imax = 200mA
Addressing more than 64K with the extra address bits A16, A17 and A18
I2C Devices: Motor control I/O expander: 0b0100 000; Maximum pin capacitance: 10 pF Digital Potentiometer: 0b0101 100; Maximum pin capacitance: 10 pF Serial ports I/O expander: 0b0100 111; Maximum pin capacitance: 10 pF Serial ports I/O expander: 0b0100 110; Maximum pin capacitance: 10 pF MCU; Maxi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
I2C pull-up resistors
Guideline: C3 = C4 = 2*(CL - Cstray) Cstray assumed to be 5pF

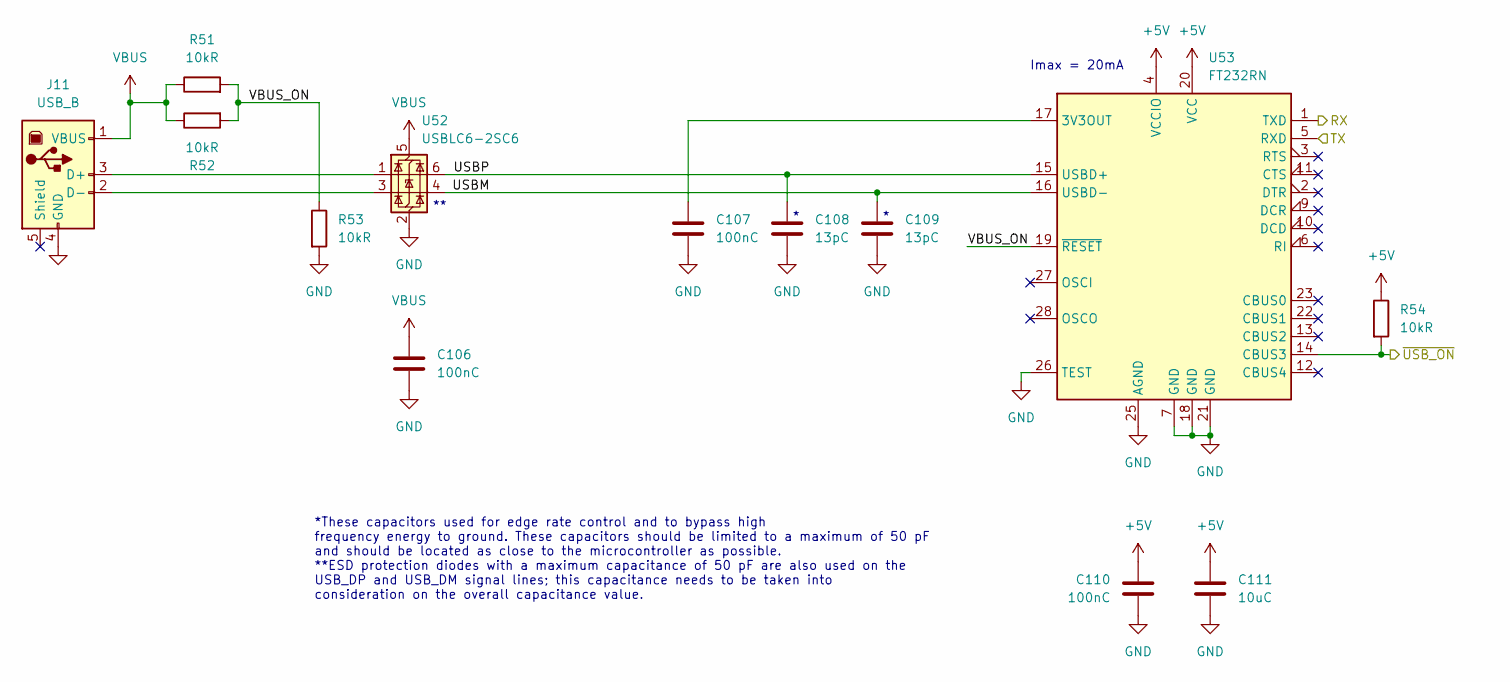
[picture p117: schematic usb.kicad_sch]

Parts:
C106, C107, C110: 100nC; C_0805_2012Metric
C108, C109: 13pC; C_0805_2012Metric; MPN 0805CG130J500NT
C111: 10uC; C_0805_2012Metric; MPN GRM21BR61E106MA73L
J11: USB_B; USB_B_TE_5787834_Vertical
R51, R52, R53, R54: 10kR; R_0805_2012Metric
U52: USBLC6-2SC6; SOT-23-6; MPN USBLC6-2SC6
U53: FT232RN; SSOP-28_5.3x10.2mm_P0.65mm; MPN FT232RNL-REEL

Connections:
+5V: C110.1, C111.1, R54.1, U53.4 (VCCIO), U53.20 (VCC); also elsewhere on the board
/MCU/PCINT15: R54.2, U53.14 (CBUS3); also elsewhere on the board
/MCU/RXD0: U53.1 (TXD); also elsewhere on the board
/MCU/TXD0: U53.5 (RXD); also elsewhere on the board
/USB/USBM: C109.1, U52.4 (I/O2), U53.16 (USBD-)
/USB/USBP: C108.1, U52.6 (I/O1), U53.15 (USBD+)
/USB/VBUS_ON: R51.2, R52.2, R53.1, U53.19 (~RESET)
GND: C106.2, C107.2, C108.2, C109.2, C110.2, C111.2, J11.4 (GND), R53.2, U52.2 (GND), U53.7 (GND), U53.18 (GND), U53.21 (GND), U53.25 (AGND), U53.26 (TEST); also elsewhere on the board
unnamed: J11.3 (D+), U52.1 (I/O1)
unnamed: J11.2 (D-), U52.3 (I/O2)
unnamed: C107.1, U53.17 (3V3OUT)
VBUS: C106.1, J11.1 (VBUS), R51.1, R52.1, U52.5 (VBUS)

Notes on the sheet:
Imax = 20mA
*These capacitors used for edge rate control and to bypass high frequency energy to ground. These capacitors should be limited to a maximum of 50 pF and should be located as close to the microcontroller as possible. **ESD protection diodes with a maximum capacitance of 50 pF are also used on the US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

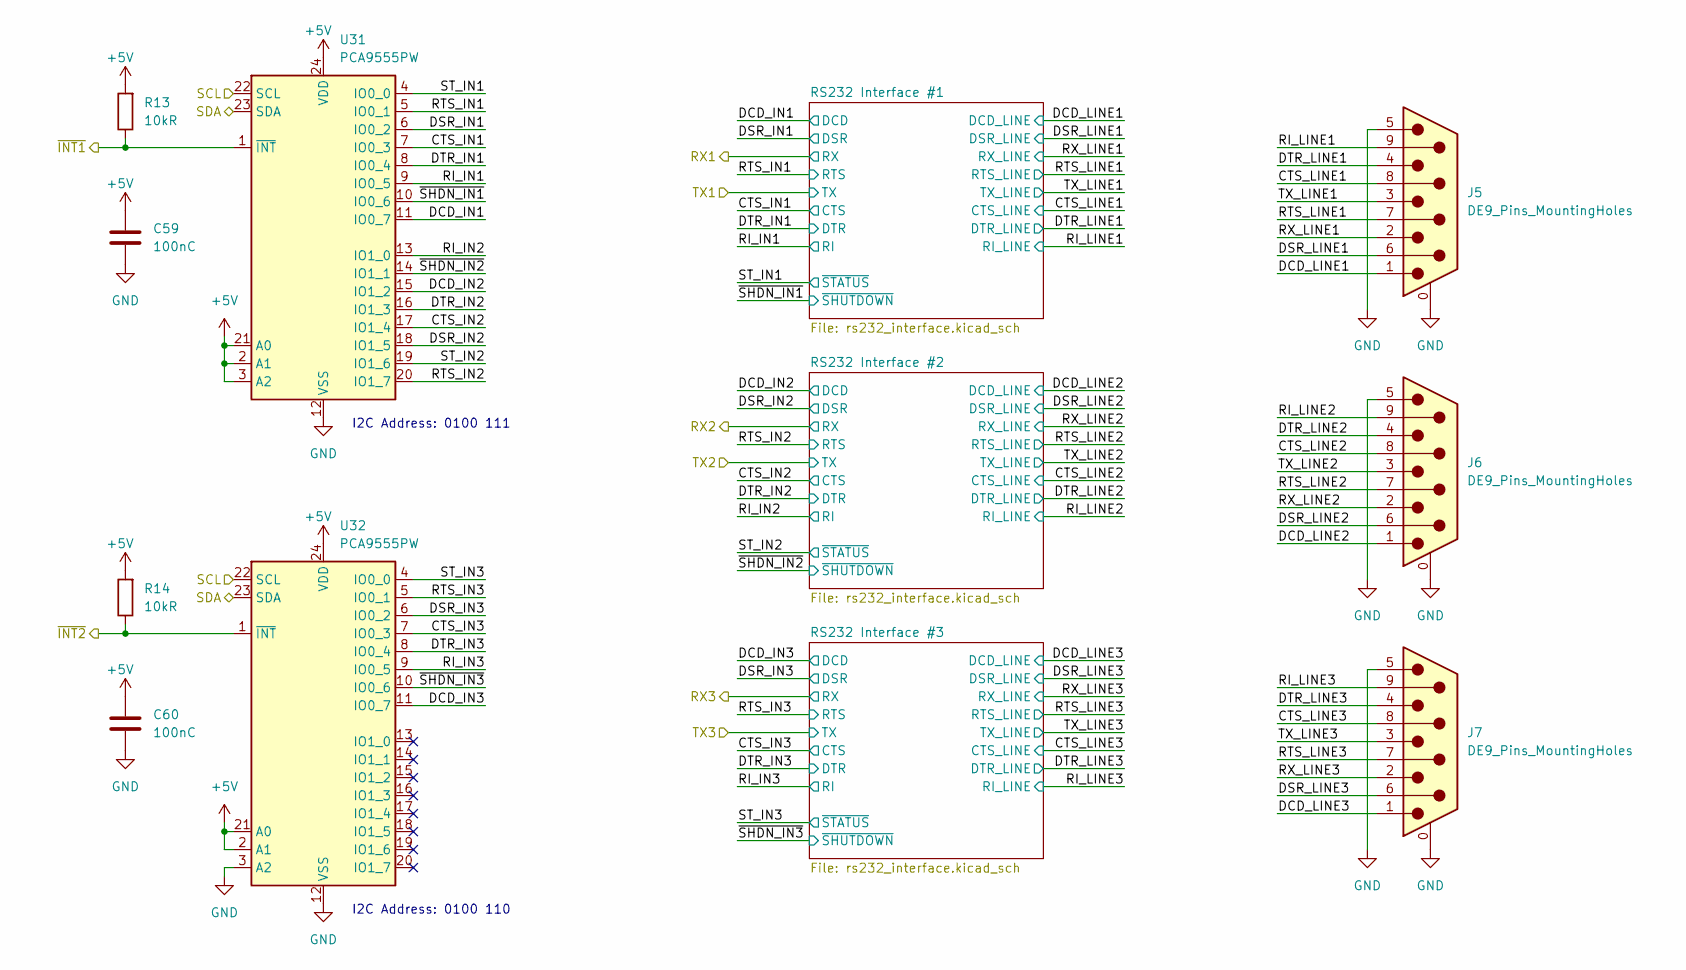
[picture p118: schematic serial_ports.kicad_sch]

Parts:
C59, C60: 100nC; C_0805_2012Metric
J5, J6, J7: DE9_Pins_MountingHoles; DSUB-9_Pins_Vertical_P2.77x2.84mm_MountingHoles
R13, R14: 10kR; R_0805_2012Metric
U31, U32: PCA9555PW; TSSOP-24_4.4x7.8mm_P0.65mm; MPN PCA9555PW,118

Connections:
+5V: C59.1, C60.1, R13.2, R14.2, U31.2 (A1), U31.3 (A2), U31.21 (A0), U31.24 (VDD), U32.2 (A1), U32.21 (A0), U32.24 (VDD); also elsewhere on the board
/MCU/PCINT12: R13.1, U31.1 (~INT); also elsewhere on the board
/MCU/PCINT13: R14.1, U32.1 (~INT); also elsewhere on the board
/MCU/SCL: U31.22 (SCL), U32.22 (SCL); also elsewhere on the board
/MCU/SDA: U31.23 (SDA), U32.23 (SDA); also elsewhere on the board
/Serial ports/CTS_IN1: U31.7 (IO0_3); also elsewhere on the board
/Serial ports/CTS_IN2: U31.17 (IO1_4); also elsewhere on the board
/Serial ports/CTS_IN3: U32.7 (IO0_3); also elsewhere on the board
/Serial ports/CTS_LINE1: J5.8; also elsewhere on the board
/Serial ports/CTS_LINE2: J6.8; also elsewhere on the board
/Serial ports/CTS_LINE3: J7.8; also elsewhere on the board
/Serial ports/DCD_IN1: U31.11 (IO0_7); also elsewhere on the board
/Serial ports/DCD_IN2: U31.15 (IO1_2); also elsewhere on the board
/Serial ports/DCD_IN3: U32.11 (IO0_7); also elsewhere on the board
/Serial ports/DCD_LINE1: J5.1; also elsewhere on the board
/Serial ports/DCD_LINE2: J6.1; also elsewhere on the board
/Serial ports/DCD_LINE3: J7.1; also elsewhere on the board
/Serial ports/DSR_IN1: U31.6 (IO0_2); also elsewhere on the board
/Serial ports/DSR_IN2: U31.18 (IO1_5); also elsewhere on the board
/Serial ports/DSR_IN3: U32.6 (IO0_2); also elsewhere on the board
/Serial ports/DSR_LINE1: J5.6; also elsewhere on the board
/Serial ports/DSR_LINE2: J6.6; also elsewhere on the board
/Serial ports/DSR_LINE3: J7.6; also elsewhere on the board
/Serial ports/DTR_IN1: U31.8 (IO0_4); also elsewhere on the board
/Serial ports/DTR_IN2: U31.16 (IO1_3); also elsewhere on the board
/Serial ports/DTR_IN3: U32.8 (IO0_4); also elsewhere on the board
/Serial ports/DTR_LINE1: J5.4; also elsewhere on the board
/Serial ports/DTR_LINE2: J6.4; also elsewhere on the board
/Serial ports/DTR_LINE3: J7.4; also elsewhere on the board
/Serial ports/RI_IN1: U31.9 (IO0_5); also elsewhere on the board
/Serial ports/RI_IN2: U31.13 (IO1_0); also elsewhere on the board
/Serial ports/RI_IN3: U32.9 (IO0_5); also elsewhere on the board
/Serial ports/RI_LINE1: J5.9; also elsewhere on the board
/Serial ports/RI_LINE2: J6.9; also elsewhere on the board
/Serial ports/RI_LINE3: J7.9; also elsewhere on the board
/Serial ports/RTS_IN1: U31.5 (IO0_1); also elsewhere on the board
/Serial ports/RTS_IN2: U31.20 (IO1_7); also elsewhere on the board
/Serial ports/RTS_IN3: U32.5 (IO0_1); also elsewhere on the board
/Serial ports/RTS_LINE1: J5.7; also elsewhere on the board
/Serial ports/RTS_LINE2: J6.7; also elsewhere on the board
/Serial ports/RTS_LINE3: J7.7; also elsewhere on the board
/Serial ports/RX_LINE1: J5.2; also elsewhere on the board
/Serial ports/RX_LINE2: J6.2; also elsewhere on the board
/Serial ports/RX_LINE3: J7.2; also elsewhere on the board
/Serial ports/ST_IN1: U31.4 (IO0_0); also elsewhere on the board
/Serial ports/ST_IN2: U31.19 (IO1_6); also elsewhere on the board
/Serial ports/ST_IN3: U32.4 (IO0_0); also elsewhere on the board
/Serial ports/TX_LINE1: J5.3; also elsewhere on the board
/Serial ports/TX_LINE2: J6.3; also elsewhere on the board
/Serial ports/TX_LINE3: J7.3; also elsewhere on the board
/Serial ports/~SHDN_IN1: U31.10 (IO0_6); also elsewhere on the board
/Serial ports/~SHDN_IN2: U31.14 (IO1_1); also elsewhere on the board
/Serial ports/~SHDN_IN3: U32.10 (IO0_6); also elsewhere on the board
GND: C59.2, C60.2, J5.0 (PAD), J5.5, J6.0 (PAD), J6.5, J7.0 (PAD), J7.5, U31.12 (VSS), U32.3 (A2), U32.12 (VSS); also elsewhere on the board

Notes on the sheet:
I2C Address: 0100 110
I2C Address: 0100 111

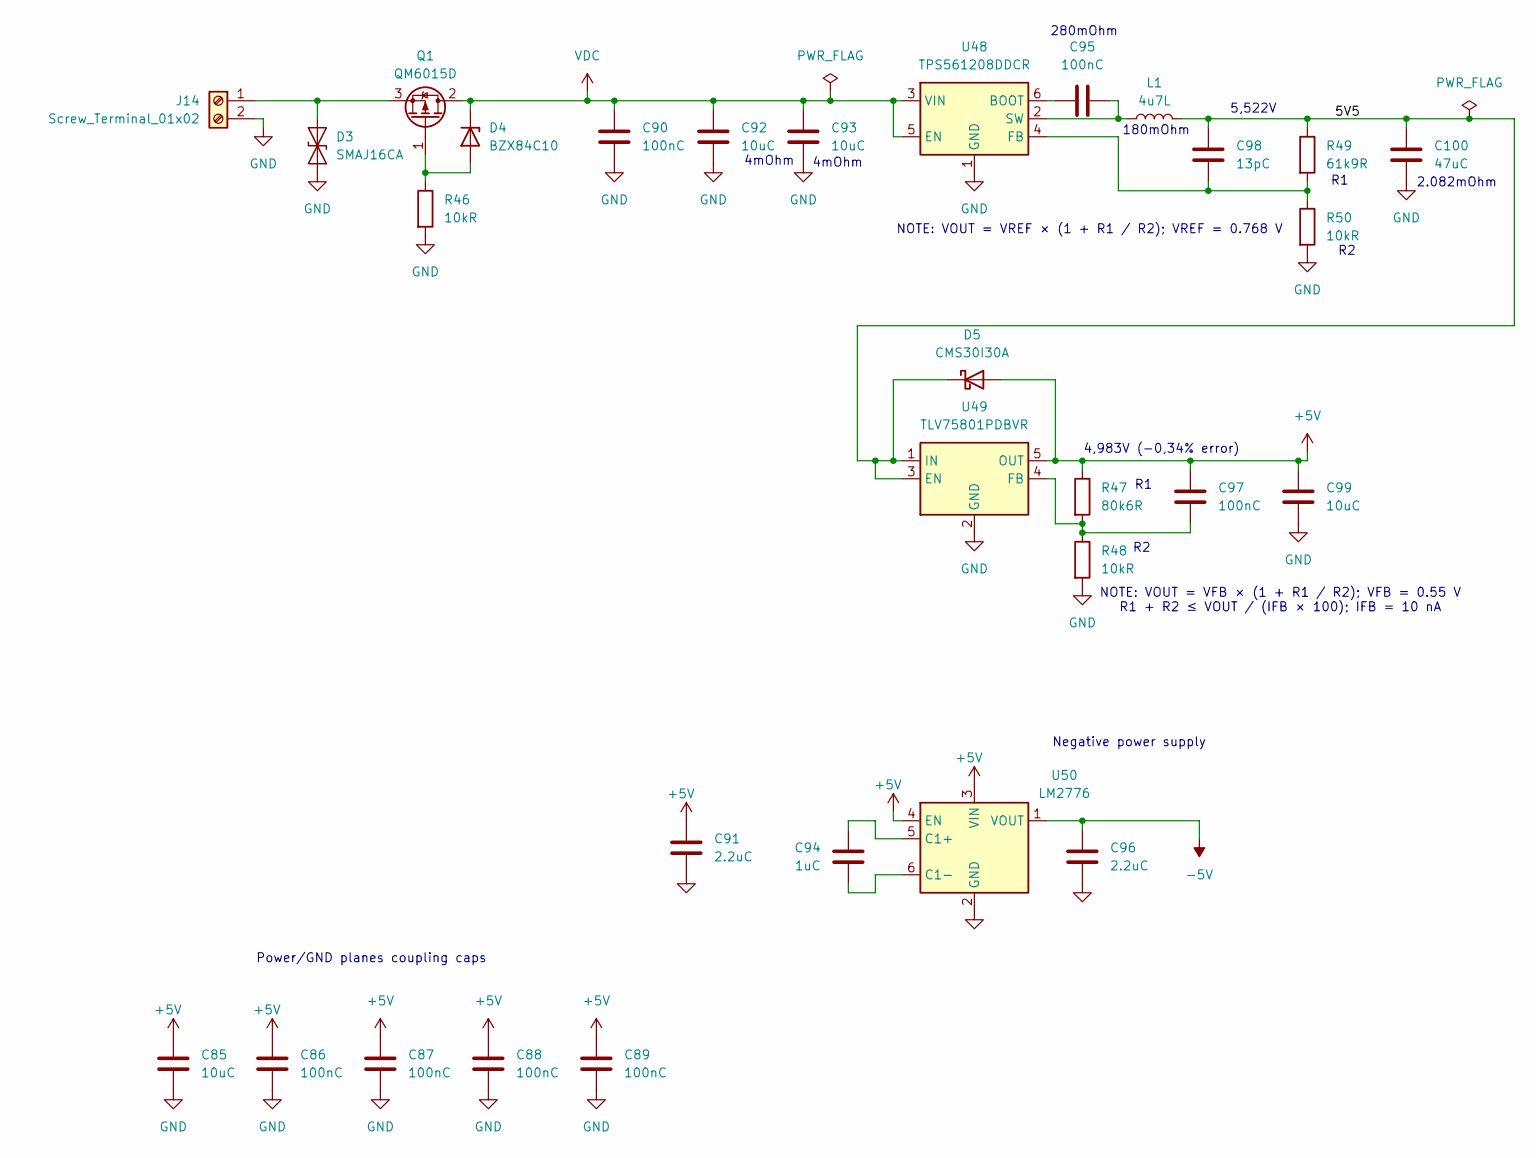
[picture p119: schematic power.kicad_sch]

Parts:
C85, C92, C93, C99: 10uC; C_0805_2012Metric; MPN GRM21BR61E106MA73L
C86, C87, C88, C89, C90, C95, C97: 100nC; C_0805_2012Metric
C91, C96: 2.2uC; C_0805_2012Metric
C94: 1uC; C_0805_2012Metric
C98: 13pC; C_0805_2012Metric; MPN 0805CG130J500NT
C100: 47uC; C_1210_3225Metric; MPN GRM32ER61C476KE15L
D3: SMAJ16CA; D_SMA
D4: BZX84C10; SOT-23; MPN BZX84C10-7-F
D5: CMS30I30A; D_SOD-128; MPN CMS30I30A(TE12L,QM
J14: Screw_Terminal_01x02; TerminalBlock_Phoenix_MPT-0,5-2-2.54_1x02_P2.54mm_Horizontal
L1: 4u7L; L_Vishay_IHLP-4040; MPN IHLP4040DZER4R7M01
Q1: QM6015D; TO-252-2
R46, R48, R50: 10kR; R_0805_2012Metric
R47: 80k6R; R_0805_2012Metric; MPN RT0805BRD0780K6L
R49: 61k9R; R_0805_2012Metric; MPN PTFR0805B61K9P9
U48: TPS561208DDCR; SOT-23-6; MPN TPS561208DDCR
U49: TLV75801PDBVR; SOT-23-5; MPN TLV75801PDBVR
U50: LM2776; SOT-23-6

Connections:
+5V: C85.1, C86.1, C87.2, C88.2, C89.2, C91.1, C97.1, C99.1, D5.2 (A), R47.1, U49.5 (OUT), U50.3 (VIN), U50.4 (EN); also elsewhere on the board
-5V: C96.1, U50.1 (VOUT); also elsewhere on the board
/Power/5V5: C98.1, C100.1, D5.1 (K), L1.2, R49.1, U49.1 (IN), U49.3 (EN)
GND: C85.2, C86.2, C87.1, C88.1, C89.1, C90.1, C91.2, C92.2, C93.2, C96.2, C99.2, C100.2, D3.1 (A1), J14.2, R46.2, R48.2, R50.2, U48.1 (GND), U49.2 (GND), U50.2 (GND); also elsewhere on the board
unnamed: D3.2 (A2), J14.1, Q1.3 (S)
unnamed: D4.1 (A), Q1.1 (G), R46.1
unnamed: C95.1, U48.6 (BOOT)
unnamed: C98.2, R49.2, R50.1, U48.4 (FB)
unnamed: C95.2, L1.1, U48.2 (SW)
unnamed: C97.2, R47.2, R48.1, U49.4 (FB)
unnamed: C94.1, U50.5 (C1+)
unnamed: C94.2, U50.6 (C1-)
VDC: C90.2, C92.1, C93.1, D4.3 (K), Q1.2 (D), U48.3 (VIN), U48.5 (EN); also elsewhere on the board

Notes on the sheet:
280mOhm
Power/GND planes coupling caps
180mOhm
4mOhm
Negative power supply
4,983V (-0,34% error)
2.082mOhm
NOTE: VOUT = VREF × (1 + R1 / R2); VREF = 0.768 V
NOTE: VOUT = VFB × (1 + R1 / R2); VFB = 0.55 V R1 + R2 ≤ VOUT / (IFB × 100); IFB = 10 nA
5,522V

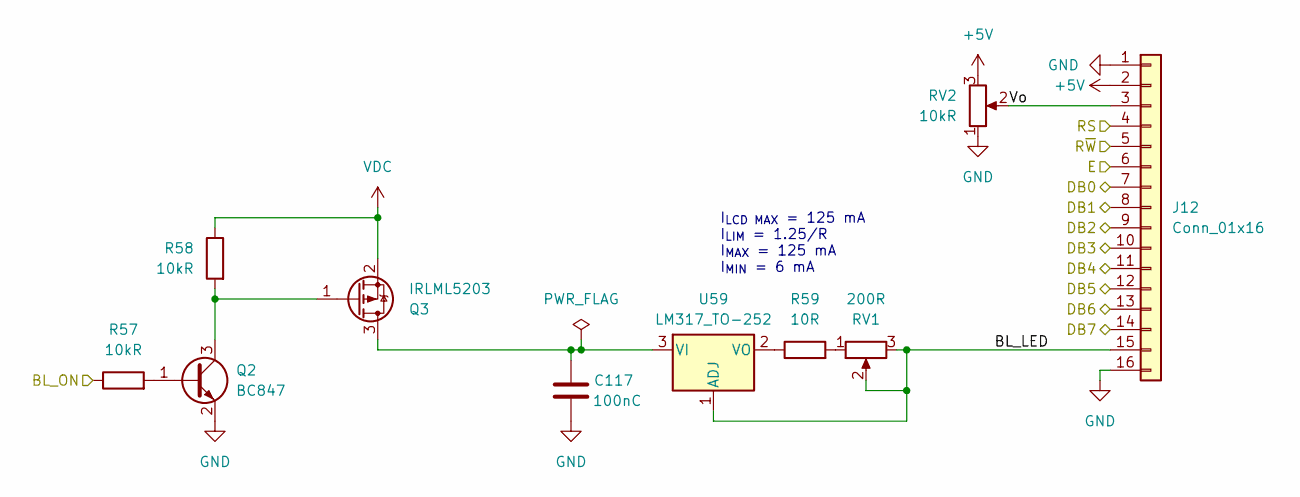
[picture p120: schematic lcd.kicad_sch]

Parts:
C117: 100nC; C_0805_2012Metric
J12: Conn_01x16; PinHeader_1x16_P2.54mm_Vertical
Q2: BC847; SOT-23; MPN BC847C,215
Q3: IRLML5203; SOT-23; MPN IRLML5203TRPBF
R57, R58: 10kR; R_0805_2012Metric
R59: 10R; R_0805_2012Metric
RV1: 200R; Potentiometer_Bourns_3296X_Horizontal; MPN 3296X-1-201LF
RV2: 10kR; Potentiometer_Bourns_3296X_Horizontal; MPN 3296X-1-103LF
U59: LM317_TO-252; TO-252-2; MPN LM317MDT-TR

Connections:
+5V: J12.2, RV2.3; also elsewhere on the board
/LCD/BL_LED: J12.15, RV1.2, RV1.3, U59.1 (ADJ)
/LCD/BL_ON: R57.1; also elsewhere on the board
/LCD/DB0: J12.7; also elsewhere on the board
/LCD/DB1: J12.8; also elsewhere on the board
/LCD/DB2: J12.9; also elsewhere on the board
/LCD/DB3: J12.10; also elsewhere on the board
/LCD/DB4: J12.11; also elsewhere on the board
/LCD/DB5: J12.12; also elsewhere on the board
/LCD/DB6: J12.13; also elsewhere on the board
/LCD/DB7: J12.14; also elsewhere on the board
/LCD/E: J12.6; also elsewhere on the board
/LCD/RS: J12.4; also elsewhere on the board
/LCD/R~W: J12.5; also elsewhere on the board
/LCD/Vo: J12.3, RV2.2
GND: C117.2, J12.1, J12.16, Q2.2 (E), RV2.1; also elsewhere on the board
unnamed: Q2.1 (B), R57.2
unnamed: Q2.3 (C), Q3.1 (G), R58.2
unnamed: C117.1, Q3.3 (D), U59.3 (VI)
unnamed: R59.2, RV1.1
unnamed: R59.1, U59.2 (VO)
VDC: Q3.2 (S), R58.1; also elsewhere on the board

Notes on the sheet:
I_{LCD MAX} = 125 mA I_{LIM} = 1.25/R I_{MAX} = 125 mA I_{MIN} = 6 mA
