nunosousa/TelescopeMirrorTester/ECAD/BDCMotorController/BDCMotorController.kicad_pcb

## KiCad design ECAD/BDCMotorController/BDCMotorController.kicad_pcb (continued)

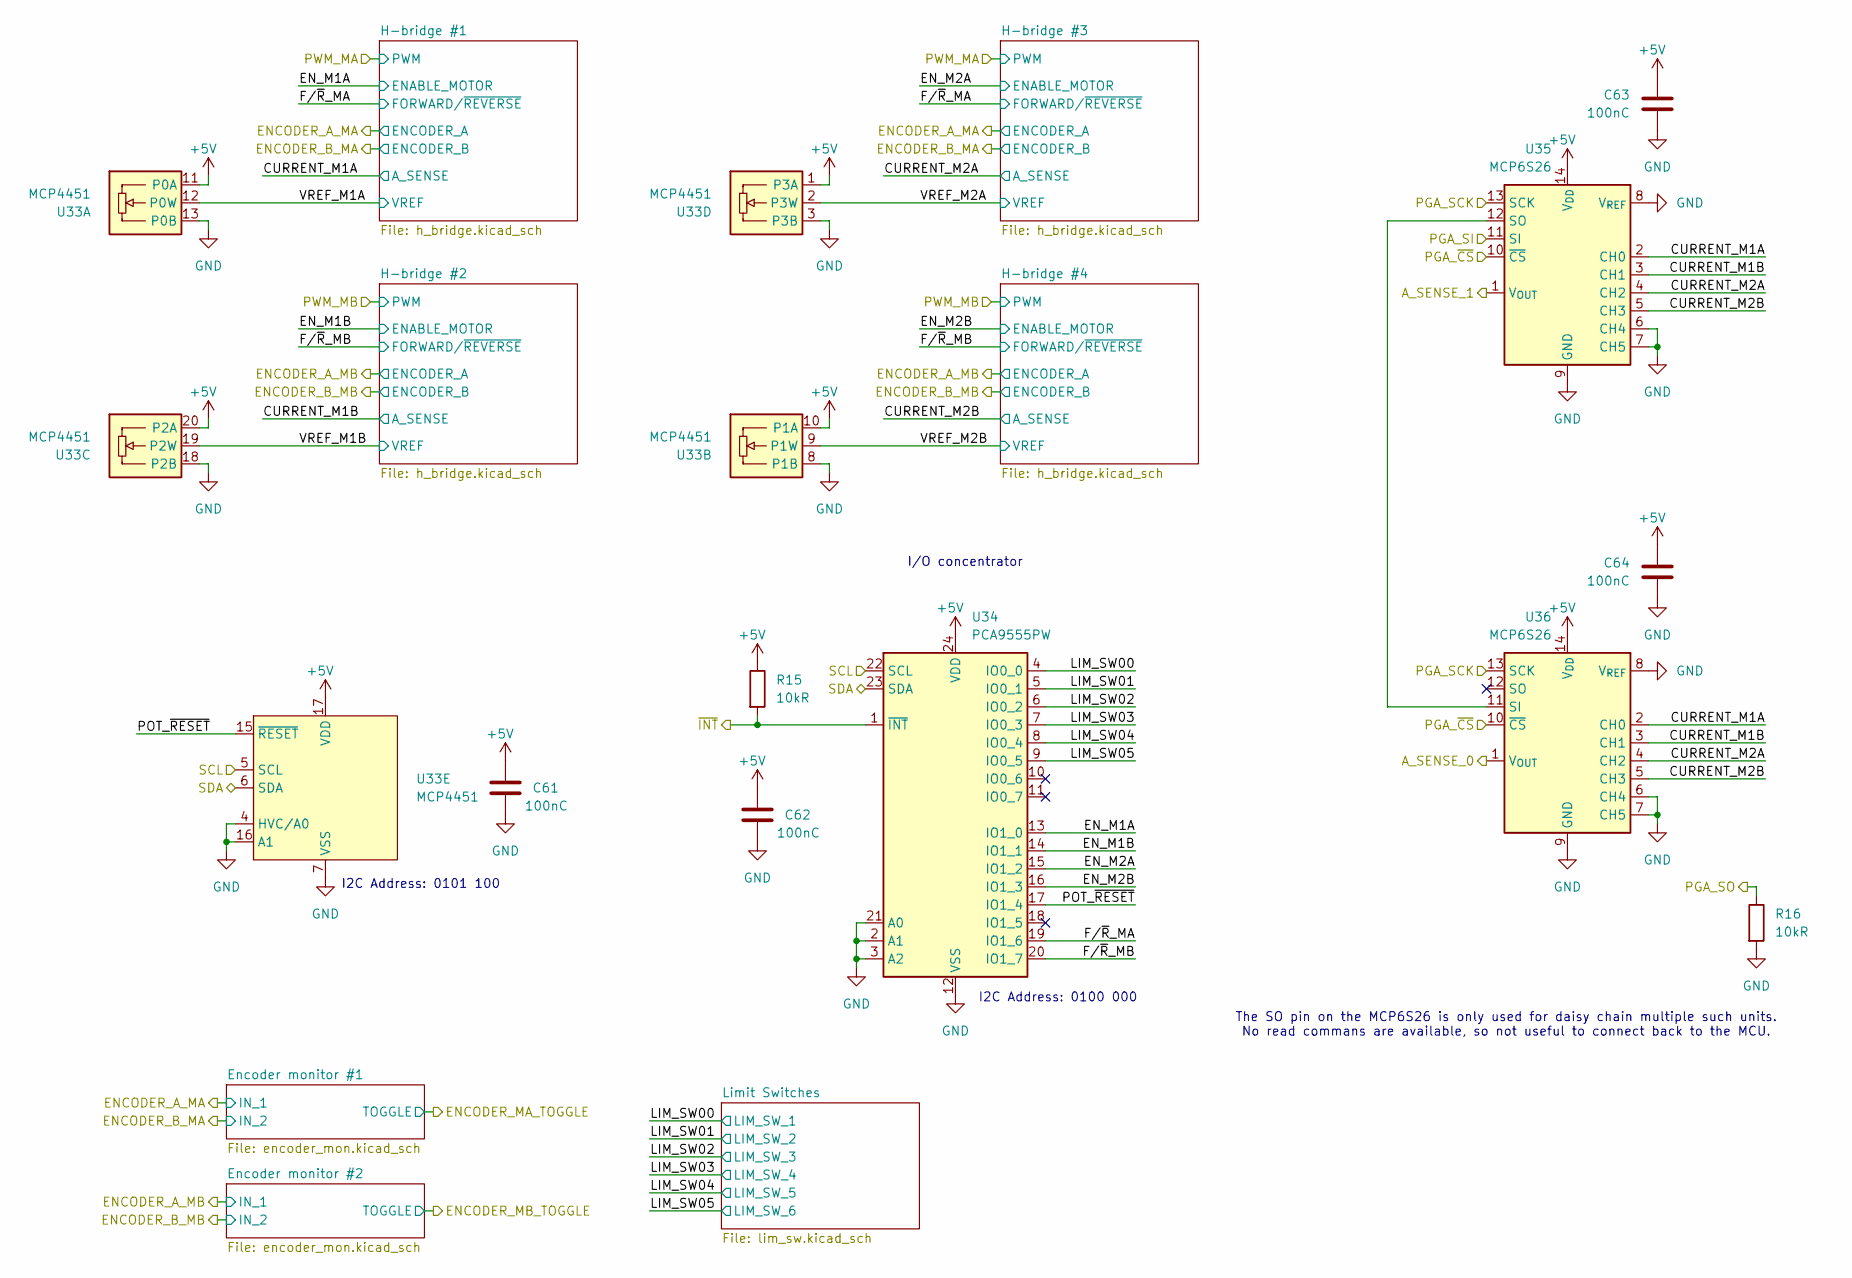
[picture p121: schematic motor_control.kicad_sch]

Parts:
C61, C62, C63, C64: 100nC; C_0805_2012Metric
R15, R16: 10kR; R_0805_2012Metric
U33: MCP4451; TSSOP-20_4.4x6.5mm_P0.65mm; MPN MCP4451-103E/ST
U34: PCA9555PW; TSSOP-24_4.4x7.8mm_P0.65mm; MPN PCA9555PW,118
U35, U36: MCP6S26; SOIC-14_3.9x8.7mm_P1.27mm; MPN MCP6S26-I/SL

Connections:
+5V: C61.1, C62.1, C63.1, C64.1, R15.1, U33.1 (P3A), U33.10 (P1A), U33.11 (P0A), U33.17 (VDD), U33.20 (P2A), U34.24 (VDD), U35.14 (V_{DD}), U36.14 (V_{DD}); also elsewhere on the board
/ADC conditioning/VA0_IN: U36.1 (V_{OUT}); also elsewhere on the board
/ADC conditioning/VA1_IN: U35.1 (V_{OUT}); also elsewhere on the board
/MCU/INT6: R15.2, U34.1 (~INT); also elsewhere on the board
/MCU/MISO: R16.1; also elsewhere on the board
/MCU/MOSI: U35.11 (SI); also elsewhere on the board
/MCU/SCK: U35.13 (SCK), U36.13 (SCK); also elsewhere on the board
/MCU/SCL: U33.5 (SCL), U34.22 (SCL); also elsewhere on the board
/MCU/SDA: U33.6 (SDA), U34.23 (SDA); also elsewhere on the board
/MCU/~SS: U35.10 (~CS), U36.10 (~CS); also elsewhere on the board
/Motor Control/CURRENT_M1A: U35.2 (CH0), U36.2 (CH0); also elsewhere on the board
/Motor Control/CURRENT_M1B: U35.3 (CH1), U36.3 (CH1); also elsewhere on the board
/Motor Control/CURRENT_M2A: U35.4 (CH2), U36.4 (CH2); also elsewhere on the board
/Motor Control/CURRENT_M2B: U35.5 (CH3), U36.5 (CH3); also elsewhere on the board
/Motor Control/EN_M1A: U34.13 (IO1_0); also elsewhere on the board
/Motor Control/EN_M1B: U34.14 (IO1_1); also elsewhere on the board
/Motor Control/EN_M2A: U34.15 (IO1_2); also elsewhere on the board
/Motor Control/EN_M2B: U34.16 (IO1_3); also elsewhere on the board
/Motor Control/F/~R_MA: U34.19 (IO1_6); also elsewhere on the board
/Motor Control/F/~R_MB: U34.20 (IO1_7); also elsewhere on the board
/Motor Control/LIM_SW00: U34.4 (IO0_0); also elsewhere on the board
/Motor Control/LIM_SW01: U34.5 (IO0_1); also elsewhere on the board
/Motor Control/LIM_SW02: U34.6 (IO0_2); also elsewhere on the board
/Motor Control/LIM_SW03: U34.7 (IO0_3); also elsewhere on the board
/Motor Control/LIM_SW04: U34.8 (IO0_4); also elsewhere on the board
/Motor Control/LIM_SW05: U34.9 (IO0_5); also elsewhere on the board
/Motor Control/POT_~RESET: U33.15 (~RESET), U34.17 (IO1_4)
/Motor Control/VREF_M1A: U33.12 (P0W); also elsewhere on the board
/Motor Control/VREF_M1B: U33.19 (P2W); also elsewhere on the board
/Motor Control/VREF_M2A: U33.2 (P3W); also elsewhere on the board
/Motor Control/VREF_M2B: U33.9 (P1W); also elsewhere on the board
GND: C61.2, C62.2, C63.2, C64.2, R16.2, U33.3 (P3B), U33.4 (HVC/A0), U33.7 (VSS), U33.8 (P1B), U33.13 (P0B), U33.16 (A1), U33.18 (P2B), U34.2 (A1), U34.3 (A2), U34.12 (VSS), U34.21 (A0), U35.6 (CH4), U35.7 (CH5), U35.8 (V_{REF}), U35.9 (GND), U36.6 (CH4), U36.7 (CH5), U36.8 (V_{REF}), U36.9 (GND); also elsewhere on the board
unnamed: U35.12 (SO), U36.11 (SI)

Notes on the sheet:
I2C Address: 0100 000
I2C Address: 0101 100
I/O concentrator
The SO pin on the MCP6S26 is only used for daisy chain multiple such units. No read commans are available, so not useful to connect back to the MCU.

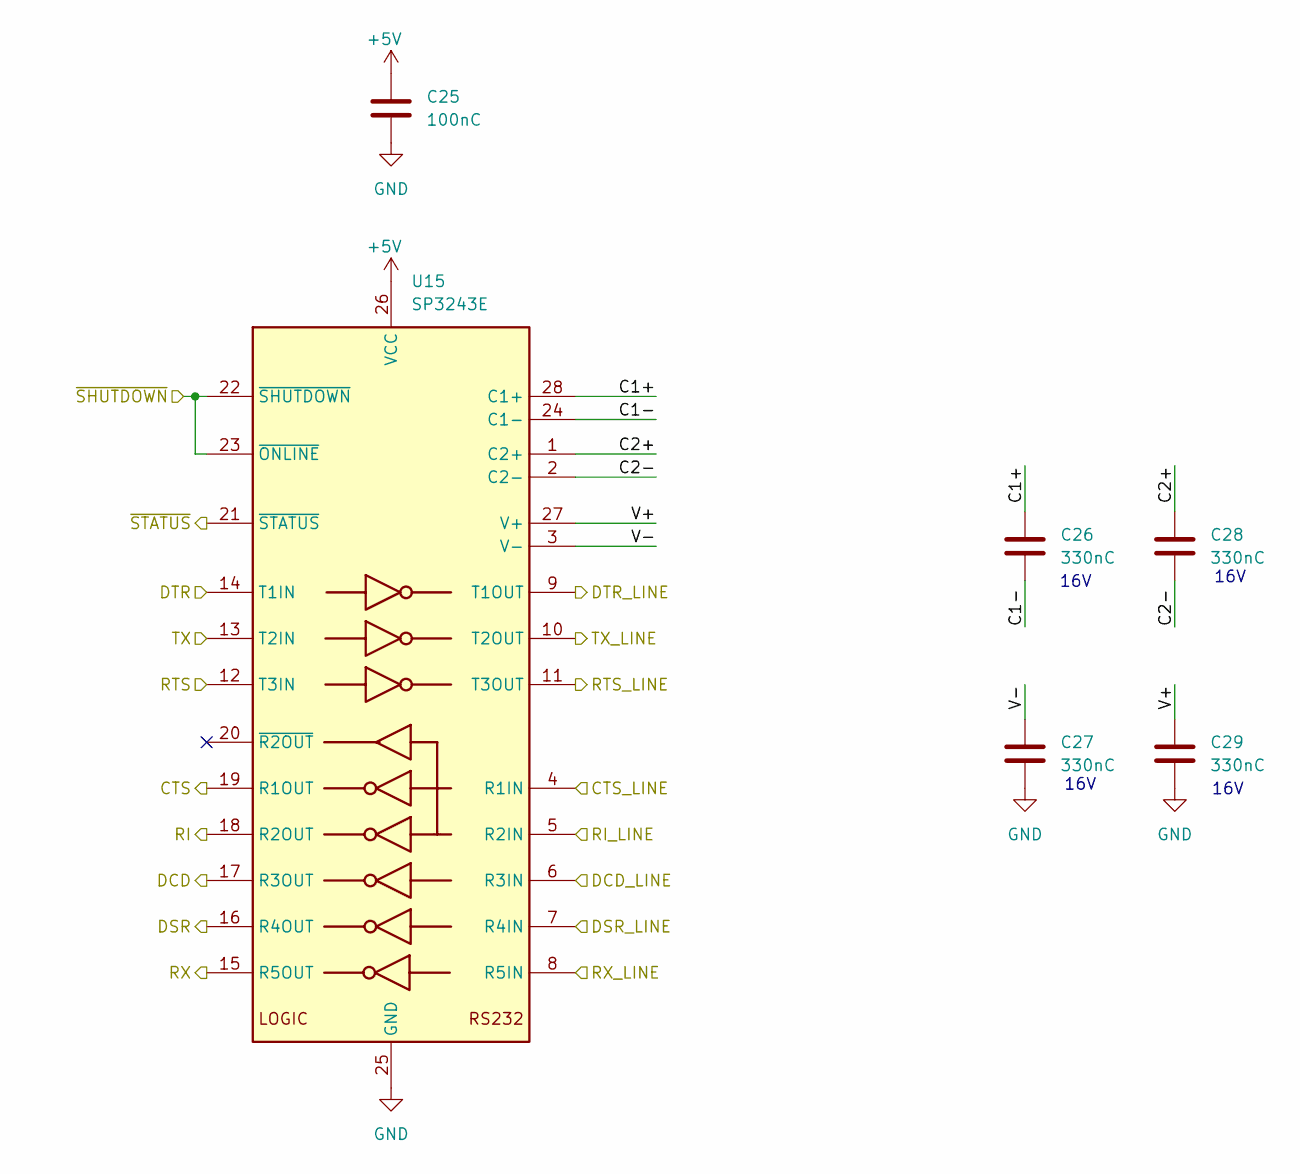
[picture p122: schematic rs232_interface.kicad_sch]

Parts:
C25: 100nC; C_0805_2012Metric
C26, C27, C28, C29: 330nC; C_0805_2012Metric
U15: SP3243E; TSSOP-28_4.4x9.7mm_P0.65mm; MPN SP3243EBEY-L/TR

Connections:
+5V: C25.1, U15.26 (VCC); also elsewhere on the board
/MCU/RXD1: U15.15 (R5OUT); also elsewhere on the board
/MCU/TXD1: U15.13 (T2IN); also elsewhere on the board
/Serial ports/CTS_IN1: U15.19 (R1OUT); also elsewhere on the board
/Serial ports/CTS_LINE1: U15.4 (R1IN); also elsewhere on the board
/Serial ports/DCD_IN1: U15.17 (R3OUT); also elsewhere on the board
/Serial ports/DCD_LINE1: U15.6 (R3IN); also elsewhere on the board
/Serial ports/DSR_IN1: U15.16 (R4OUT); also elsewhere on the board
/Serial ports/DSR_LINE1: U15.7 (R4IN); also elsewhere on the board
/Serial ports/DTR_IN1: U15.14 (T1IN); also elsewhere on the board
/Serial ports/DTR_LINE1: U15.9 (T1OUT); also elsewhere on the board
/Serial ports/RI_IN1: U15.18 (R2OUT); also elsewhere on the board
/Serial ports/RI_LINE1: U15.5 (R2IN); also elsewhere on the board
/Serial ports/RS232 Interface #1/C1+: C26.1, U15.28 (C1+)
/Serial ports/RS232 Interface #1/C1-: C26.2, U15.24 (C1-)
/Serial ports/RS232 Interface #1/C2+: C28.1, U15.1 (C2+)
/Serial ports/RS232 Interface #1/C2-: C28.2, U15.2 (C2-)
/Serial ports/RS232 Interface #1/V+: C29.1, U15.27 (V+)
/Serial ports/RS232 Interface #1/V-: C27.1, U15.3 (V-)
/Serial ports/RTS_IN1: U15.12 (T3IN); also elsewhere on the board
/Serial ports/RTS_LINE1: U15.11 (T3OUT); also elsewhere on the board
/Serial ports/RX_LINE1: U15.8 (R5IN); also elsewhere on the board
/Serial ports/ST_IN1: U15.21 (~STATUS); also elsewhere on the board
/Serial ports/TX_LINE1: U15.10 (T2OUT); also elsewhere on the board
/Serial ports/~SHDN_IN1: U15.22 (~SHUTDOWN), U15.23 (~ONLINE); also elsewhere on the board
GND: C25.2, C27.2, C29.2, U15.25 (GND); also elsewhere on the board

Parts of its further copies:
C30, C101: 100nC; C_0805_2012Metric
C31, C32, C33, C34, C102, C103, C104, C105: 330nC; C_0805_2012Metric
U16, U51: SP3243E; TSSOP-28_4.4x9.7mm_P0.65mm; MPN SP3243EBEY-L/TR

Connections of its further copies:
+5V: C30.1, C101.1, U16.26 (VCC), U51.26 (VCC); also elsewhere on the board
/MCU/RXD2: U16.15 (R5OUT); also elsewhere on the board
/MCU/RXD3: U51.15 (R5OUT); also elsewhere on the board
/MCU/TXD2: U16.13 (T2IN); also elsewhere on the board
/MCU/TXD3: U51.13 (T2IN); also elsewhere on the board
/Serial ports/CTS_IN2: U16.19 (R1OUT); also elsewhere on the board
/Serial ports/CTS_IN3: U51.19 (R1OUT); also elsewhere on the board
/Serial ports/CTS_LINE2: U16.4 (R1IN); also elsewhere on the board
/Serial ports/CTS_LINE3: U51.4 (R1IN); also elsewhere on the board
/Serial ports/DCD_IN2: U16.17 (R3OUT); also elsewhere on the board
/Serial ports/DCD_IN3: U51.17 (R3OUT); also elsewhere on the board
/Serial ports/DCD_LINE2: U16.6 (R3IN); also elsewhere on the board
/Serial ports/DCD_LINE3: U51.6 (R3IN); also elsewhere on the board
/Serial ports/DSR_IN2: U16.16 (R4OUT); also elsewhere on the board
/Serial ports/DSR_IN3: U51.16 (R4OUT); also elsewhere on the board
/Serial ports/DSR_LINE2: U16.7 (R4IN); also elsewhere on the board
/Serial ports/DSR_LINE3: U51.7 (R4IN); also elsewhere on the board
/Serial ports/DTR_IN2: U16.14 (T1IN); also elsewhere on the board
/Serial ports/DTR_IN3: U51.14 (T1IN); also elsewhere on the board
/Serial ports/DTR_LINE2: U16.9 (T1OUT); also elsewhere on the board
/Serial ports/DTR_LINE3: U51.9 (T1OUT); also elsewhere on the board
/Serial ports/RI_IN2: U16.18 (R2OUT); also elsewhere on the board
/Serial ports/RI_IN3: U51.18 (R2OUT); also elsewhere on the board
/Serial ports/RI_LINE2: U16.5 (R2IN); also elsewhere on the board
/Serial ports/RI_LINE3: U51.5 (R2IN); also elsewhere on the board
/Serial ports/RS232 Interface #2/C1+: C31.1, U16.28 (C1+)
/Serial ports/RS232 Interface #2/C1-: C31.2, U16.24 (C1-)
/Serial ports/RS232 Interface #2/C2+: C33.1, U16.1 (C2+)
/Serial ports/RS232 Interface #2/C2-: C33.2, U16.2 (C2-)
/Serial ports/RS232 Interface #2/V+: C34.1, U16.27 (V+)
/Serial ports/RS232 Interface #2/V-: C32.1, U16.3 (V-)
/Serial ports/RS232 Interface #3/C1+: C102.1, U51.28 (C1+)
/Serial ports/RS232 Interface #3/C1-: C102.2, U51.24 (C1-)
/Serial ports/RS232 Interface #3/C2+: C104.1, U51.1 (C2+)
/Serial ports/RS232 Interface #3/C2-: C104.2, U51.2 (C2-)
/Serial ports/RS232 Interface #3/V+: C105.1, U51.27 (V+)
/Serial ports/RS232 Interface #3/V-: C103.1, U51.3 (V-)
/Serial ports/RTS_IN2: U16.12 (T3IN); also elsewhere on the board
/Serial ports/RTS_IN3: U51.12 (T3IN); also elsewhere on the board
/Serial ports/RTS_LINE2: U16.11 (T3OUT); also elsewhere on the board
/Serial ports/RTS_LINE3: U51.11 (T3OUT); also elsewhere on the board
/Serial ports/RX_LINE2: U16.8 (R5IN); also elsewhere on the board
/Serial ports/RX_LINE3: U51.8 (R5IN); also elsewhere on the board
/Serial ports/ST_IN2: U16.21 (~STATUS); also elsewhere on the board
/Serial ports/ST_IN3: U51.21 (~STATUS); also elsewhere on the board
/Serial ports/TX_LINE2: U16.10 (T2OUT); also elsewhere on the board
/Serial ports/TX_LINE3: U51.10 (T2OUT); also elsewhere on the board
/Serial ports/~SHDN_IN2: U16.22 (~SHUTDOWN), U16.23 (~ONLINE); also elsewhere on the board
/Serial ports/~SHDN_IN3: U51.22 (~SHUTDOWN), U51.23 (~ONLINE); also elsewhere on the board
GND: C30.2, C32.2, C34.2, C101.2, C103.2, C105.2, U16.25 (GND), U51.25 (GND); also elsewhere on the board

Notes on the sheet:
16V

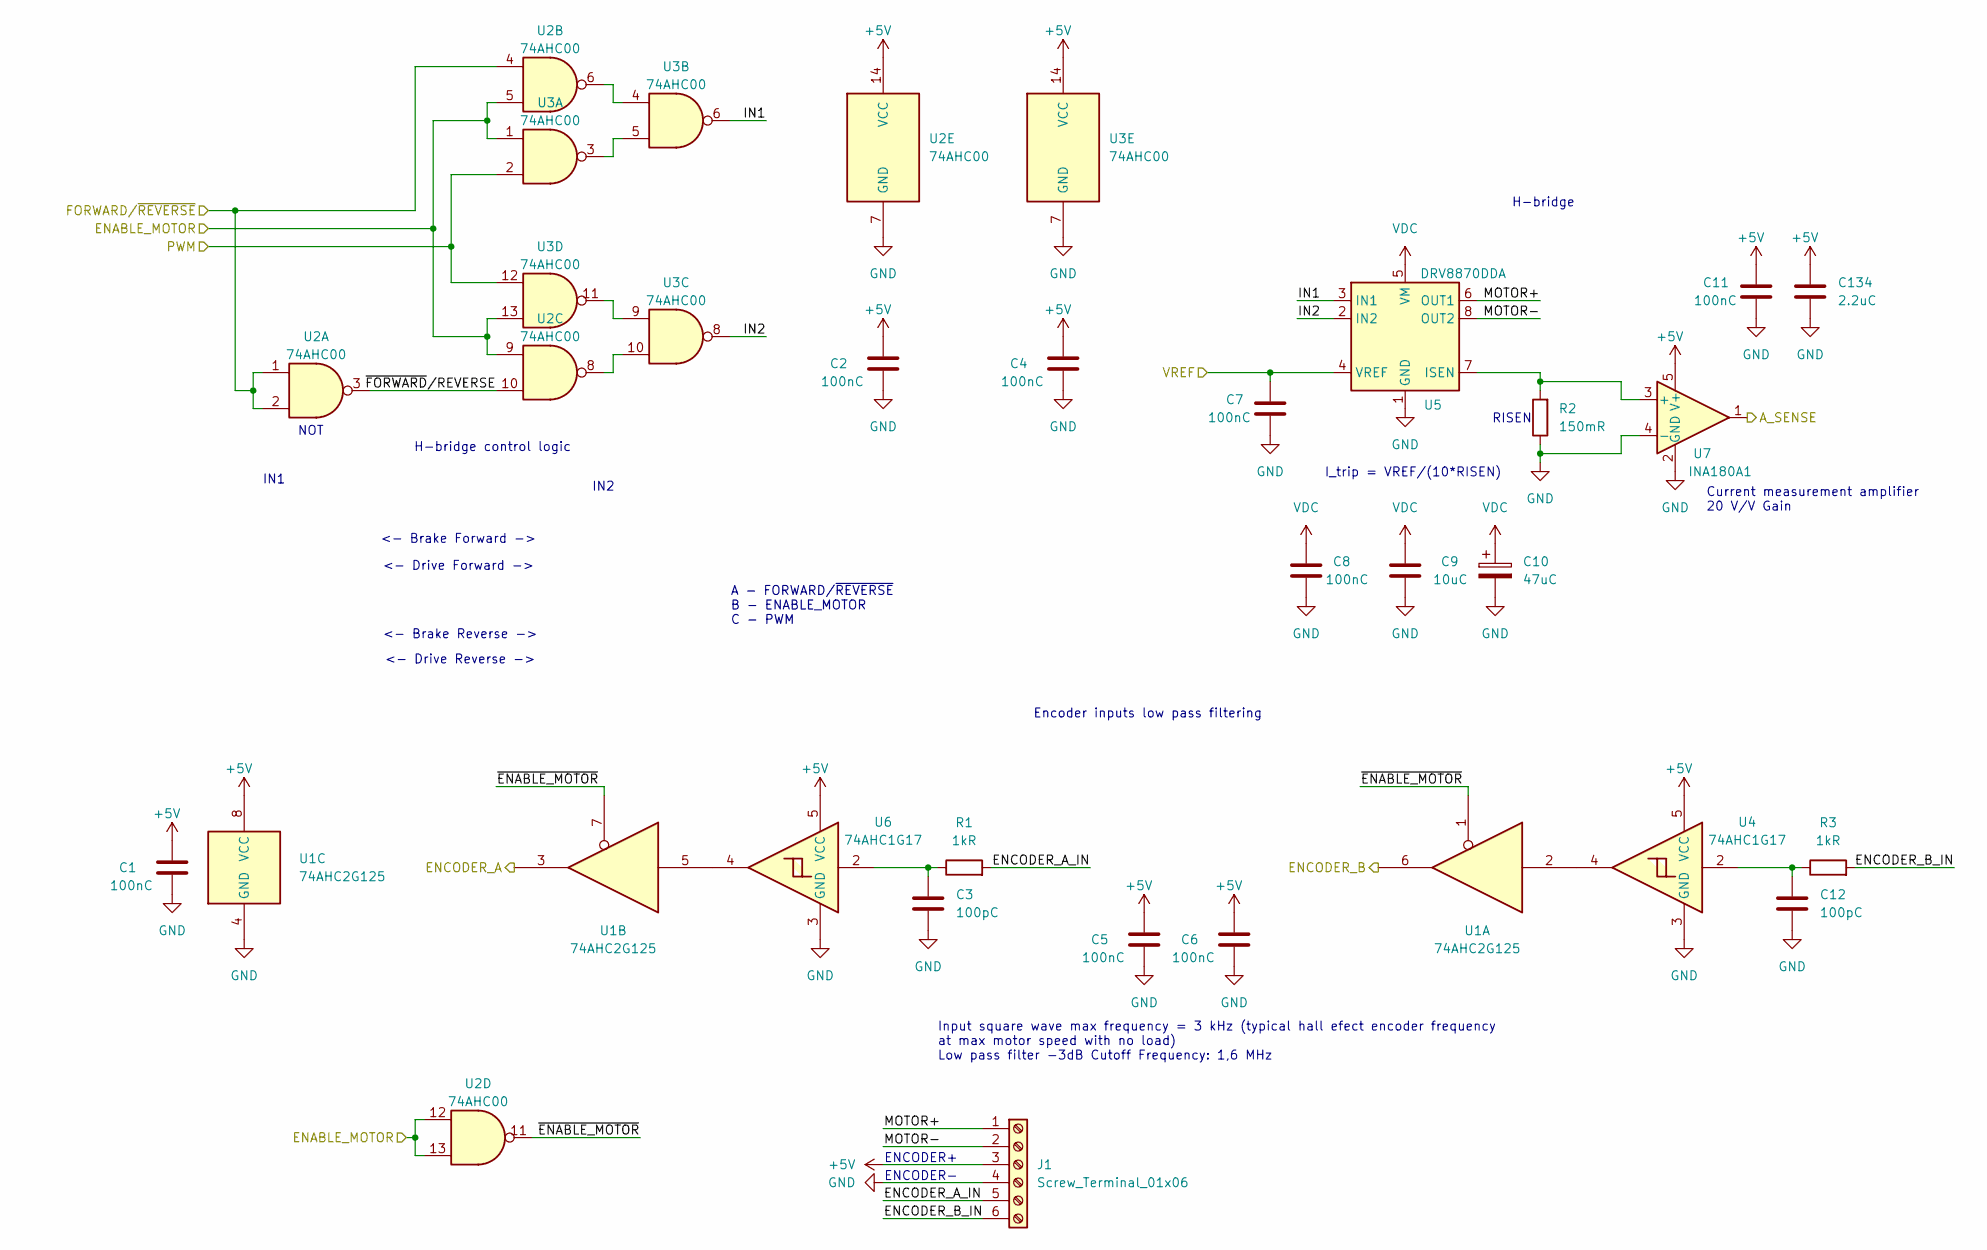
[picture p123: schematic h_bridge.kicad_sch]

Parts:
C1, C2, C4, C5, C6, C7, C8, C11: 100nC; C_0805_2012Metric
C3, C12: 100pC; C_0805_2012Metric; MPN CC0805KRX7R9BB101
C9: 10uC; C_0805_2012Metric; MPN GRM21BR61E106MA73L
C10: 47uC; C_1210_3225Metric; MPN GRM32ER61C476KE15L
C134: 2.2uC; C_0805_2012Metric
J1: Screw_Terminal_01x06; TerminalBlock_Phoenix_MPT-0,5-6-2.54_1x06_P2.54mm_Horizontal
R1, R3: 1kR; R_0805_2012Metric
R2: 150mR; R_1206_3216Metric; MPN RLH12FTCR150
U1: 74AHC2G125; TSSOP-8_3x3mm_P0.65mm; MPN 74AHC2G125DP,125
U2, U3: 74AHC00; TSSOP-14_4.4x5mm_P0.65mm; MPN SN74AHC00PWR
U4, U6: 74AHC1G17; SC-74A-5_1.55x2.9mm_P0.95mm; MPN 74AHC1G17GVH
U5: DRV8870DDA; Texas_HTSOP-8-1EP_3.9x4.9mm_P1.27mm_EP2.95x4.9mm_Mask2.4x3.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; MPN DRV8870DDAR
U7: INA180A1; SOT-23-5; MPN INA180A1IDBVR

Connections:
+5V: C1.1, C2.1, C4.1, C5.1, C6.1, C11.1, C134.1, J1.3, U1.8 (VCC), U2.14 (VCC), U3.14 (VCC), U4.5 (VCC), U6.5 (VCC), U7.5 (V+); also elsewhere on the board
/MCU/OC1A: U3.2, U3.12; also elsewhere on the board
/MCU/PH4: U1.3; also elsewhere on the board
/MCU/PH5: U1.6; also elsewhere on the board
/Motor Control/CURRENT_M1A: U7.1; also elsewhere on the board
/Motor Control/EN_M1A: U2.5, U2.9, U2.12, U2.13, U3.1, U3.13; also elsewhere on the board
/Motor Control/F/~R_MA: U2.1, U2.2, U2.4; also elsewhere on the board
/Motor Control/H-bridge #1/ENCODER_A_IN: J1.5, R1.2
/Motor Control/H-bridge #1/ENCODER_B_IN: J1.6, R3.2
/Motor Control/H-bridge #1/IN1: U3.6, U5.3 (IN1)
/Motor Control/H-bridge #1/IN2: U3.8, U5.2 (IN2)
/Motor Control/H-bridge #1/MOTOR+: J1.1, U5.6 (OUT1)
/Motor Control/H-bridge #1/MOTOR-: J1.2, U5.8 (OUT2)
/Motor Control/H-bridge #1/~ENABLE_MOTOR: U1.1, U1.7, U2.11
/Motor Control/H-bridge #1/~FORWARD/REVERSE: U2.3, U2.10
/Motor Control/VREF_M1A: C7.1, U5.4 (VREF); also elsewhere on the board
GND: C1.2, C2.2, C3.2, C4.2, C5.2, C6.2, C7.2, C8.2, C9.2, C10.2, C11.2, C12.2, C134.2, J1.4, R2.1, U1.4 (GND), U2.7 (GND), U3.7 (GND), U4.3 (GND), U5.1 (GND), U5.9 (GND), U6.3 (GND), U7.2 (GND), U7.4 (-); also elsewhere on the board
unnamed: C3.1, R1.1, U6.2
unnamed: C12.1, R3.1, U4.2
unnamed: U1.2, U4.4
unnamed: U1.5, U6.4
unnamed: U2.6, U3.4
unnamed: U2.8, U3.10
unnamed: U3.3, U3.5
unnamed: U3.9, U3.11
unnamed: R2.2, U5.7 (ISEN), U7.3 (+)
VDC: C8.1, C9.1, C10.1, U5.5 (VM); also elsewhere on the board

Parts of its further copies:
C13, C14, C16, C17, C18, C19, C20, C23, C35, C36, C38, C39, C40, C41, C42, C45, C47, C48, C50, C51, C52, C53, C54, C57: 100nC; C_0805_2012Metric
C15, C24, C37, C46, C49, C58: 100pC; C_0805_2012Metric; MPN CC0805KRX7R9BB101
C21, C43, C55: 10uC; C_0805_2012Metric; MPN GRM21BR61E106MA73L
C22, C44, C56: 47uC; C_1210_3225Metric; MPN GRM32ER61C476KE15L
C135, C136, C137: 2.2uC; C_0805_2012Metric
J2, J3, J4: Screw_Terminal_01x06; TerminalBlock_Phoenix_MPT-0,5-6-2.54_1x06_P2.54mm_Horizontal
R4, R6, R7, R9, R10, R12: 1kR; R_0805_2012Metric
R5, R8, R11: 150mR; R_1206_3216Metric; MPN RLH12FTCR150
U8, U17, U24: 74AHC2G125; TSSOP-8_3x3mm_P0.65mm; MPN 74AHC2G125DP,125
U9, U10, U18, U19, U25, U26: 74AHC00; TSSOP-14_4.4x5mm_P0.65mm; MPN SN74AHC00PWR
U11, U13, U20, U22, U27, U29: 74AHC1G17; SC-74A-5_1.55x2.9mm_P0.95mm; MPN 74AHC1G17GVH
U12, U21, U28: DRV8870DDA; Texas_HTSOP-8-1EP_3.9x4.9mm_P1.27mm_EP2.95x4.9mm_Mask2.4x3.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; MPN DRV8870DDAR
U14, U23, U30: INA180A1; SOT-23-5; MPN INA180A1IDBVR

Connections of its further copies:
+5V: C13.1, C14.1, C16.1, C17.1, C18.1, C23.1, C35.1, C36.1, C38.1, C39.1, C40.1, C45.1, C47.1, C48.1, C50.1, C51.1, C52.1, C57.1, C135.1, C136.1, C137.1, J2.3, J3.3, J4.3, U8.8 (VCC), U9.14 (VCC), U10.14 (VCC), U11.5 (VCC), U13.5 (VCC), U14.5 (V+), U17.8 (VCC), U18.14 (VCC), U19.14 (VCC), U20.5 (VCC), U22.5 (VCC), U23.5 (V+), U24.8 (VCC), U25.14 (VCC), U26.14 (VCC), U27.5 (VCC), U29.5 (VCC), U30.5 (V+); also elsewhere on the board
/MCU/OC1A: U19.2, U19.12; also elsewhere on the board
/MCU/OC1C: U10.2, U10.12, U26.2, U26.12; also elsewhere on the board
/MCU/PH4: U17.3; also elsewhere on the board
/MCU/PH5: U17.6; also elsewhere on the board
/MCU/PH6: U8.3, U24.3; also elsewhere on the board
/MCU/PH7: U8.6, U24.6; also elsewhere on the board
/Motor Control/CURRENT_M1B: U14.1; also elsewhere on the board
/Motor Control/CURRENT_M2A: U23.1; also elsewhere on the board
/Motor Control/CURRENT_M2B: U30.1; also elsewhere on the board
/Motor Control/EN_M1B: U9.5, U9.9, U9.12, U9.13, U10.1, U10.13; also elsewhere on the board
/Motor Control/EN_M2A: U18.5, U18.9, U18.12, U18.13, U19.1, U19.13; also elsewhere on the board
/Motor Control/EN_M2B: U25.5, U25.9, U25.12, U25.13, U26.1, U26.13; also elsewhere on the board
/Motor Control/F/~R_MA: U18.1, U18.2, U18.4; also elsewhere on the board
/Motor Control/F/~R_MB: U9.1, U9.2, U9.4, U25.1, U25.2, U25.4; also elsewhere on the board
/Motor Control/H-bridge #2/ENCODER_A_IN: J2.5, R4.2
/Motor Control/H-bridge #2/ENCODER_B_IN: J2.6, R6.2
/Motor Control/H-bridge #2/IN1: U10.6, U12.3 (IN1)
/Motor Control/H-bridge #2/IN2: U10.8, U12.2 (IN2)
/Motor Control/H-bridge #2/MOTOR+: J2.1, U12.6 (OUT1)
/Motor Control/H-bridge #2/MOTOR-: J2.2, U12.8 (OUT2)
/Motor Control/H-bridge #2/~ENABLE_MOTOR: U8.1, U8.7, U9.11
/Motor Control/H-bridge #2/~FORWARD/REVERSE: U9.3, U9.10
/Motor Control/H-bridge #3/ENCODER_A_IN: J3.5, R7.2
/Motor Control/H-bridge #3/ENCODER_B_IN: J3.6, R9.2
/Motor Control/H-bridge #3/IN1: U19.6, U21.3 (IN1)
/Motor Control/H-bridge #3/IN2: U19.8, U21.2 (IN2)
/Motor Control/H-bridge #3/MOTOR+: J3.1, U21.6 (OUT1)
/Motor Control/H-bridge #3/MOTOR-: J3.2, U21.8 (OUT2)
/Motor Control/H-bridge #3/~ENABLE_MOTOR: U17.1, U17.7, U18.11
/Motor Control/H-bridge #3/~FORWARD/REVERSE: U18.3, U18.10
/Motor Control/H-bridge #4/ENCODER_A_IN: J4.5, R10.2
/Motor Control/H-bridge #4/ENCODER_B_IN: J4.6, R12.2
/Motor Control/H-bridge #4/IN1: U26.6, U28.3 (IN1)
/Motor Control/H-bridge #4/IN2: U26.8, U28.2 (IN2)
/Motor Control/H-bridge #4/MOTOR+: J4.1, U28.6 (OUT1)
/Motor Control/H-bridge #4/MOTOR-: J4.2, U28.8 (OUT2)
/Motor Control/H-bridge #4/~ENABLE_MOTOR: U24.1, U24.7, U25.11
/Motor Control/H-bridge #4/~FORWARD/REVERSE: U25.3, U25.10
/Motor Control/VREF_M1B: C19.1, U12.4 (VREF); also elsewhere on the board
/Motor Control/VREF_M2A: C41.1, U21.4 (VREF); also elsewhere on the board
/Motor Control/VREF_M2B: C53.1, U28.4 (VREF); also elsewhere on the board
GND: C13.2, C14.2, C15.2, C16.2, C17.2, C18.2, C19.2, C20.2, C21.2, C22.2, C23.2, C24.2, C35.2, C36.2, C37.2, C38.2, C39.2, C40.2, C41.2, C42.2, C43.2, C44.2, C45.2, C46.2, C47.2, C48.2, C49.2, C50.2, C51.2, C52.2, C53.2, C54.2, C55.2, C56.2, C57.2, C58.2, C135.2, C136.2, C137.2, J2.4, J3.4, J4.4, R5.1, R8.1, R11.1, U8.4 (GND), U9.7 (GND), U10.7 (GND), U11.3 (GND), U12.1 (GND), U12.9 (GND), U13.3 (GND), U14.2 (GND), U14.4 (-), U17.4 (GND), U18.7 (GND), U19.7 (GND), U20.3 (GND), U21.1 (GND), U21.9 (GND), U22.3 (GND), U23.2 (GND), U23.4 (-), U24.4 (GND), U25.7 (GND), U26.7 (GND), U27.3 (GND), U28.1 (GND), U28.9 (GND), U29.3 (GND), U30.2 (GND), U30.4 (-); also elsewhere on the board
unnamed: C15.1, R4.1, U13.2
unnamed: C24.1, R6.1, U11.2
unnamed: C37.1, R7.1, U22.2
unnamed: C46.1, R9.1, U20.2
unnamed: C49.1, R10.1, U29.2
unnamed: C58.1, R12.1, U27.2
unnamed: U10.3, U10.5
unnamed: U9.6, U10.4
unnamed: U9.8, U10.10
unnamed: U10.9, U10.11
unnamed: U8.2, U11.4
unnamed: R5.2, U12.7 (ISEN), U14.3 (+)
unnamed: U8.5, U13.4
unnamed: U17.2, U20.4
unnamed: U17.5, U22.4
unnamed: U18.6, U19.4
unnamed: U18.8, U19.10
unnamed: U19.3, U19.5
unnamed: U19.9, U19.11
unnamed: R8.2, U21.7 (ISEN), U23.3 (+)
unnamed: U24.2, U27.4
unnamed: U24.5, U29.4
unnamed: U25.6, U26.4
unnamed: U25.8, U26.10
unnamed: U26.3, U26.5
unnamed: U26.9, U26.11
unnamed: R11.2, U28.7 (ISEN), U30.3 (+)
VDC: C20.1, C21.1, C22.1, C42.1, C43.1, C44.1, C54.1, C55.1, C56.1, U12.5 (VM), U21.5 (VM), U28.5 (VM); also elsewhere on the board

Notes on the sheet:
<- Brake Forward ->
RISEN
H-bridge control logic
ENCODER+
IN2
Input square wave max frequency = 3 kHz (typical hall efect encoder frequency at max motor speed with no load) Low pass filter -3dB Cutoff Frequency: 1,6 MHz
IN1
Current measurement amplifier 20 V/V Gain
ENCODER-
NOT
Encoder inputs low pass filtering
I_trip = VREF/(10*RISEN)
<- Drive Reverse ->
<- Drive Forward ->
A - FORWARD/~{REVERSE} B - ENABLE_MOTOR C - PWM
H-bridge
<- Brake Reverse ->

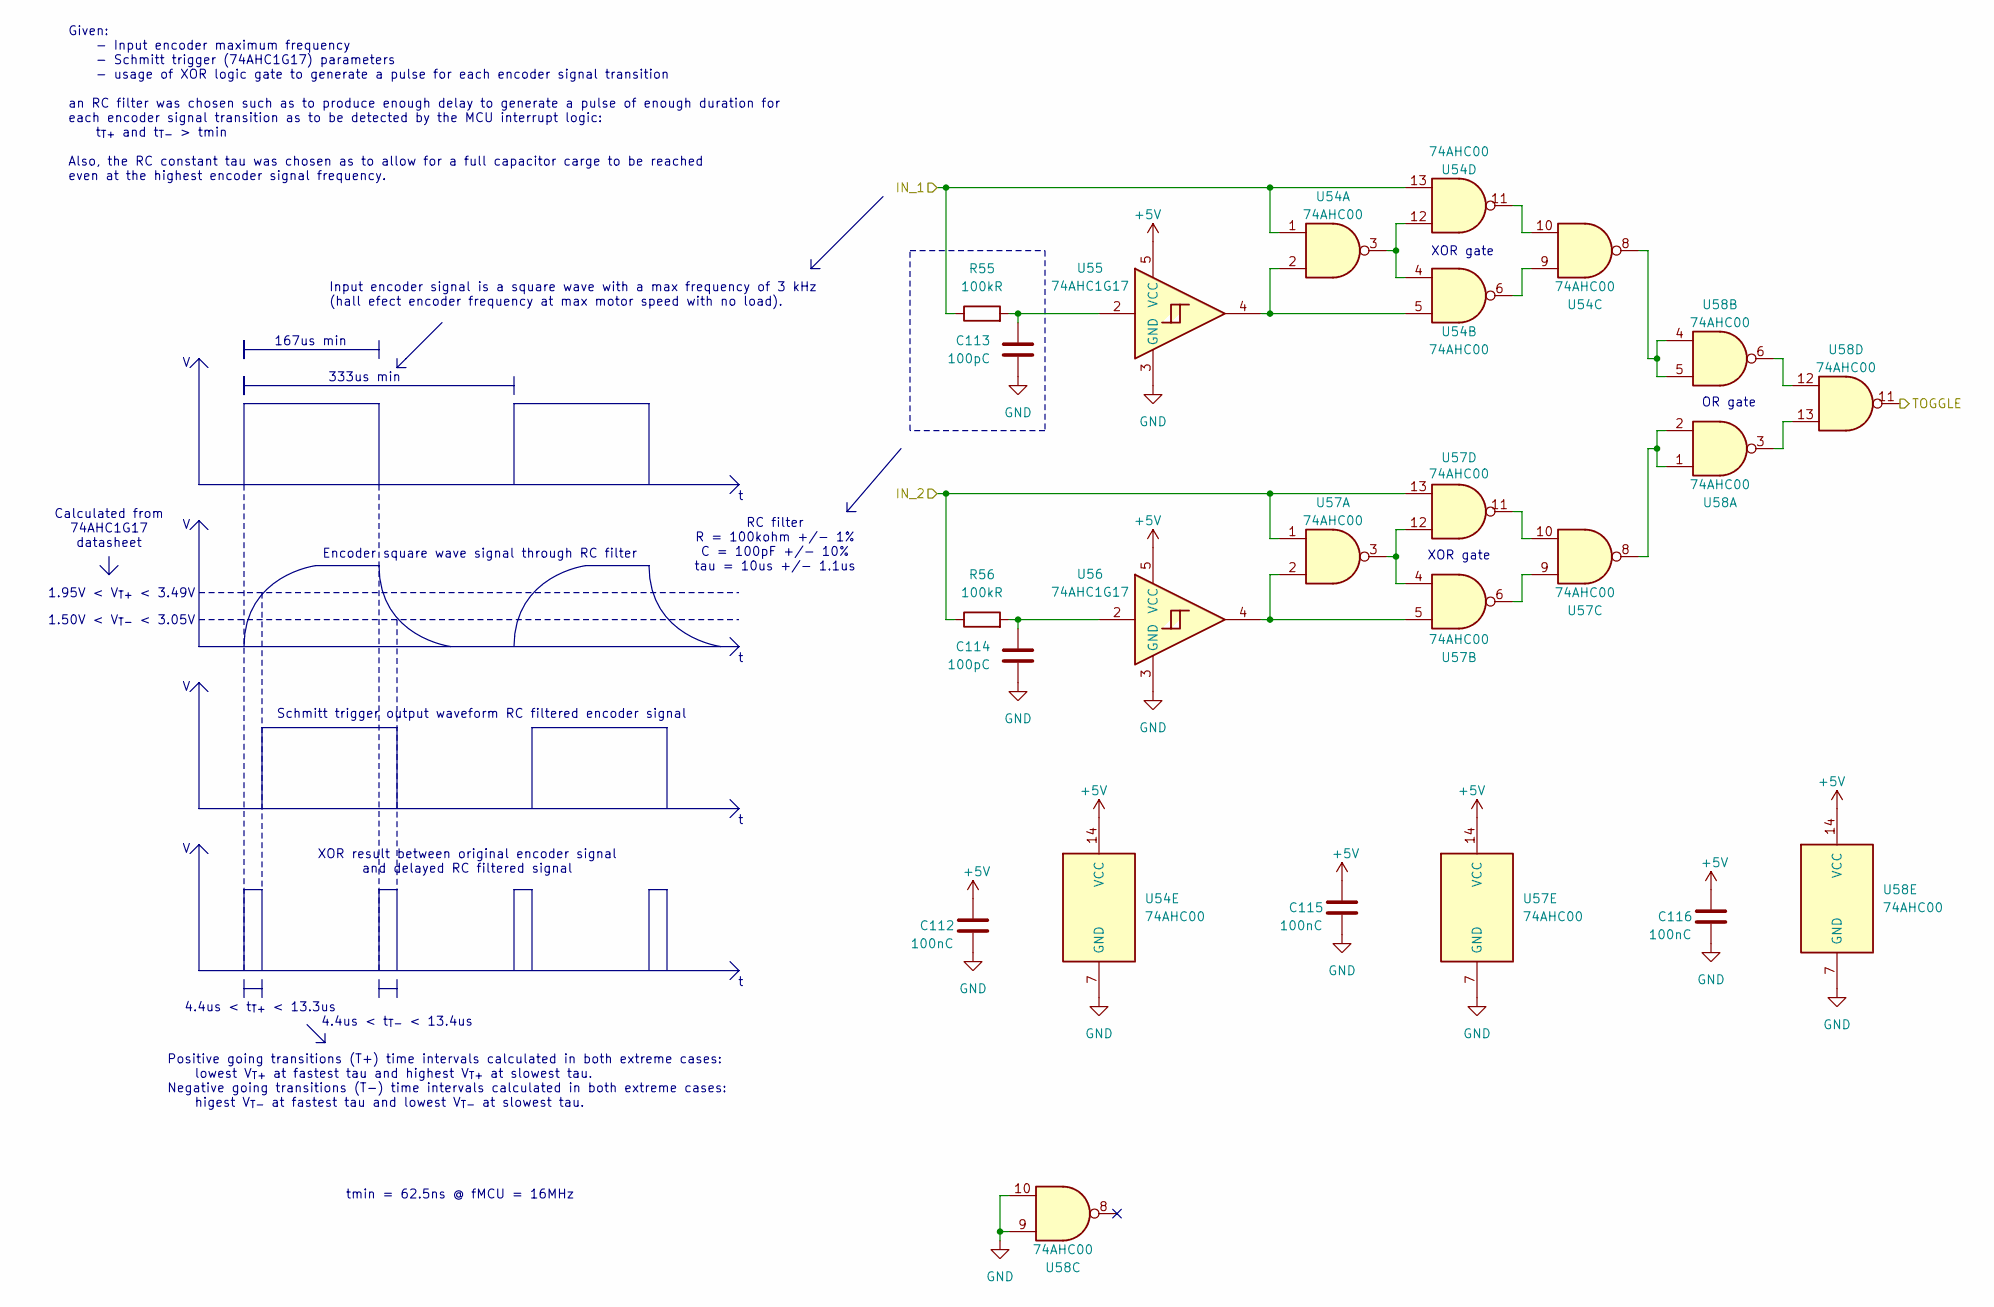
[picture p124: schematic encoder_mon.kicad_sch]

Parts:
C112, C115, C116: 100nC; C_0805_2012Metric
C113, C114: 100pC; C_0805_2012Metric; MPN CC0805KRX7R9BB101
R55, R56: 100kR; R_0805_2012Metric; MPN RT0805BRD07100KL
U54, U57, U58: 74AHC00; TSSOP-14_4.4x5mm_P0.65mm; MPN SN74AHC00PWR
U55, U56: 74AHC1G17; SC-74A-5_1.55x2.9mm_P0.95mm; MPN 74AHC1G17GVH

Connections:
+5V: C112.1, C115.1, C116.1, U54.14 (VCC), U55.5 (VCC), U56.5 (VCC), U57.14 (VCC), U58.14 (VCC); also elsewhere on the board
/MCU/INT5: U58.11; also elsewhere on the board
/MCU/PH6: R55.1, U54.1, U54.13; also elsewhere on the board
/MCU/PH7: R56.1, U57.1, U57.13; also elsewhere on the board
GND: C112.2, C113.2, C114.2, C115.2, C116.2, U54.7 (GND), U55.3 (GND), U56.3 (GND), U57.7 (GND), U58.7 (GND), U58.9, U58.10; also elsewhere on the board
unnamed: C113.1, R55.2, U55.2
unnamed: C114.1, R56.2, U56.2
unnamed: U54.2, U54.5, U55.4
unnamed: U54.6, U54.9
unnamed: U54.8, U58.4, U58.5
unnamed: U54.10, U54.11
unnamed: U54.3, U54.4, U54.12
unnamed: U56.4, U57.2, U57.5
unnamed: U57.6, U57.9
unnamed: U57.8, U58.1, U58.2
unnamed: U57.10, U57.11
unnamed: U57.3, U57.4, U57.12
unnamed: U58.6, U58.12
unnamed: U58.3, U58.13

Parts of its further copies:
C124, C130, C132: 100nC; C_0805_2012Metric
C127, C128: 100pC; C_0805_2012Metric; MPN CC0805KRX7R9BB101
R64, R65: 100kR; R_0805_2012Metric; MPN RT0805BRD07100KL
U61, U64, U65: 74AHC00; TSSOP-14_4.4x5mm_P0.65mm; MPN SN74AHC00PWR
U62, U63: 74AHC1G17; SC-74A-5_1.55x2.9mm_P0.95mm; MPN 74AHC1G17GVH

Connections of its further copies:
+5V: C124.1, C130.1, C132.1, U61.14 (VCC), U62.5 (VCC), U63.5 (VCC), U64.14 (VCC), U65.14 (VCC); also elsewhere on the board
/MCU/INT4: U65.11; also elsewhere on the board
/MCU/PH4: R64.1, U61.1, U61.13; also elsewhere on the board
/MCU/PH5: R65.1, U64.1, U64.13; also elsewhere on the board
GND: C124.2, C127.2, C128.2, C130.2, C132.2, U61.7 (GND), U62.3 (GND), U63.3 (GND), U64.7 (GND), U65.7 (GND), U65.9, U65.10; also elsewhere on the board
unnamed: C127.1, R64.2, U62.2
unnamed: C128.1, R65.2, U63.2
unnamed: U61.2, U61.5, U62.4
unnamed: U61.6, U61.9
unnamed: U61.8, U65.4, U65.5
unnamed: U61.10, U61.11
unnamed: U61.3, U61.4, U61.12
unnamed: U63.4, U64.2, U64.5
unnamed: U64.6, U64.9
unnamed: U64.8, U65.1, U65.2
unnamed: U64.10, U64.11
unnamed: U64.3, U64.4, U64.12
unnamed: U65.6, U65.12
unnamed: U65.3, U65.13

Notes on the sheet:
RC filter R = 100kohm +/- 1% C = 100pF +/- 10% tau = 10us +/- 1.1us
1.50V < V_{T-} < 3.05V
tmin = 62.5ns @ fMCU = 16MHz
4.4us < t_{T+} < 13.3us
333us min
Calculated from 74AHC1G17 datasheet
Input encoder signal is a square wave with a max frequency of 3 kHz (hall efect encoder frequency at max motor speed with no load).
Given: - Input encoder maximum frequency - Schmitt trigger (74AHC1G17) parameters - usage of XOR logic gate to generate a pulse for each encoder signal transition an RC filter was chosen such as to produce enough delay to generate a pulse of enough duration for each encoder signal transition as to 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
167us min
XOR gate
Positive going transitions (T+) time intervals calculated in both extreme cases: lowest V_{T+} at fastest tau and highest V_{T+} at slowest tau. Negative going transitions (T-) time intervals calculated in both extreme cases: higest V_{T-} at fastest tau and lowest V_{T-} at slowest tau.
1.95V < V_{T+} < 3.49V
Encoder square wave signal through RC filter
OR gate
Schmitt trigger output waveform RC filtered encoder signal
XOR result between original encoder signal and delayed RC filtered signal
4.4us < t_{T-} < 13.4us
