nunosousa/TelescopeMirrorTester/ECAD/BDCMotorController/BDCMotorController.kicad_pcb

## KiCad design ECAD/BDCMotorController/BDCMotorController.kicad_pcb (continued)

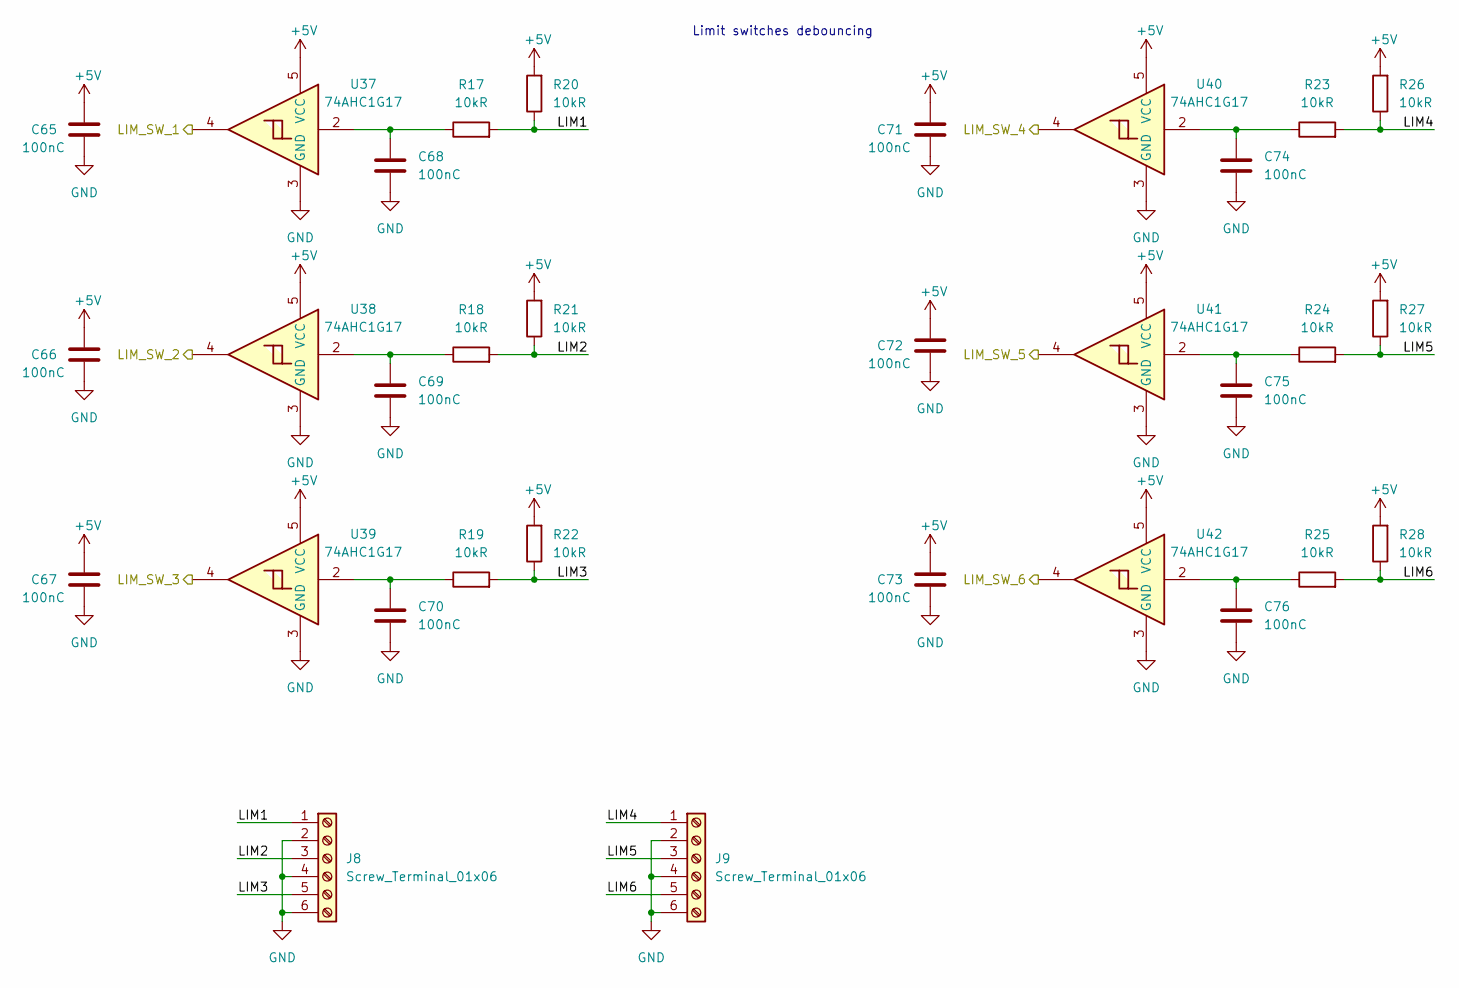
[picture p125: schematic lim_sw.kicad_sch]

Parts:
C65, C66, C67, C68, C69, C70, C71, C72, C73, C74, C75, C76: 100nC; C_0805_2012Metric
J8, J9: Screw_Terminal_01x06; TerminalBlock_Phoenix_MPT-0,5-6-2.54_1x06_P2.54mm_Horizontal
R17, R18, R19, R20, R21, R22, R23, R24, R25, R26, R27, R28: 10kR; R_0805_2012Metric
U37, U38, U39, U40, U41, U42: 74AHC1G17; SC-74A-5_1.55x2.9mm_P0.95mm; MPN 74AHC1G17GVH

Connections:
+5V: C65.1, C66.1, C67.1, C71.1, C72.1, C73.1, R20.2, R21.2, R22.2, R26.2, R27.2, R28.2, U37.5 (VCC), U38.5 (VCC), U39.5 (VCC), U40.5 (VCC), U41.5 (VCC), U42.5 (VCC); also elsewhere on the board
/Motor Control/LIM_SW00: U37.4; also elsewhere on the board
/Motor Control/LIM_SW01: U38.4; also elsewhere on the board
/Motor Control/LIM_SW02: U39.4; also elsewhere on the board
/Motor Control/LIM_SW03: U40.4; also elsewhere on the board
/Motor Control/LIM_SW04: U41.4; also elsewhere on the board
/Motor Control/LIM_SW05: U42.4; also elsewhere on the board
/Motor Control/Limit Switches/LIM1: J8.1, R17.2, R20.1
/Motor Control/Limit Switches/LIM2: J8.3, R18.2, R21.1
/Motor Control/Limit Switches/LIM3: J8.5, R19.2, R22.1
/Motor Control/Limit Switches/LIM4: J9.1, R23.2, R26.1
/Motor Control/Limit Switches/LIM5: J9.3, R24.2, R27.1
/Motor Control/Limit Switches/LIM6: J9.5, R25.2, R28.1
GND: C65.2, C66.2, C67.2, C68.2, C69.2, C70.2, C71.2, C72.2, C73.2, C74.2, C75.2, C76.2, J8.2, J8.4, J8.6, J9.2, J9.4, J9.6, U37.3 (GND), U38.3 (GND), U39.3 (GND), U40.3 (GND), U41.3 (GND), U42.3 (GND); also elsewhere on the board
unnamed: C68.1, R17.1, U37.2
unnamed: C69.1, R18.1, U38.2
unnamed: C70.1, R19.1, U39.2
unnamed: C74.1, R23.1, U40.2
unnamed: C75.1, R24.1, U41.2
unnamed: C76.1, R25.1, U42.2

Notes on the sheet:
Limit switches debouncing

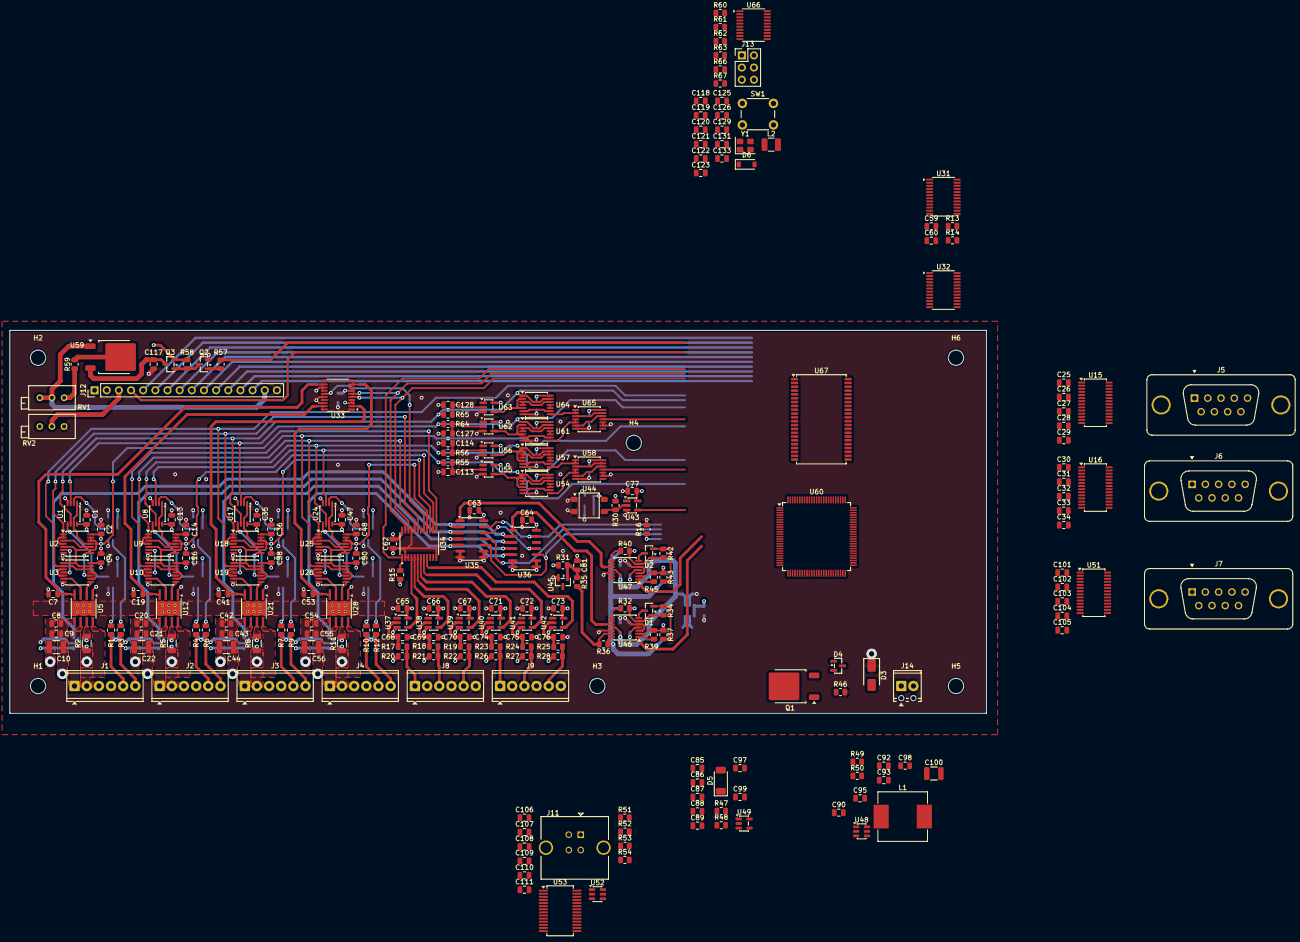
[picture p126: board BDCMotorController.kicad_pcb from above]

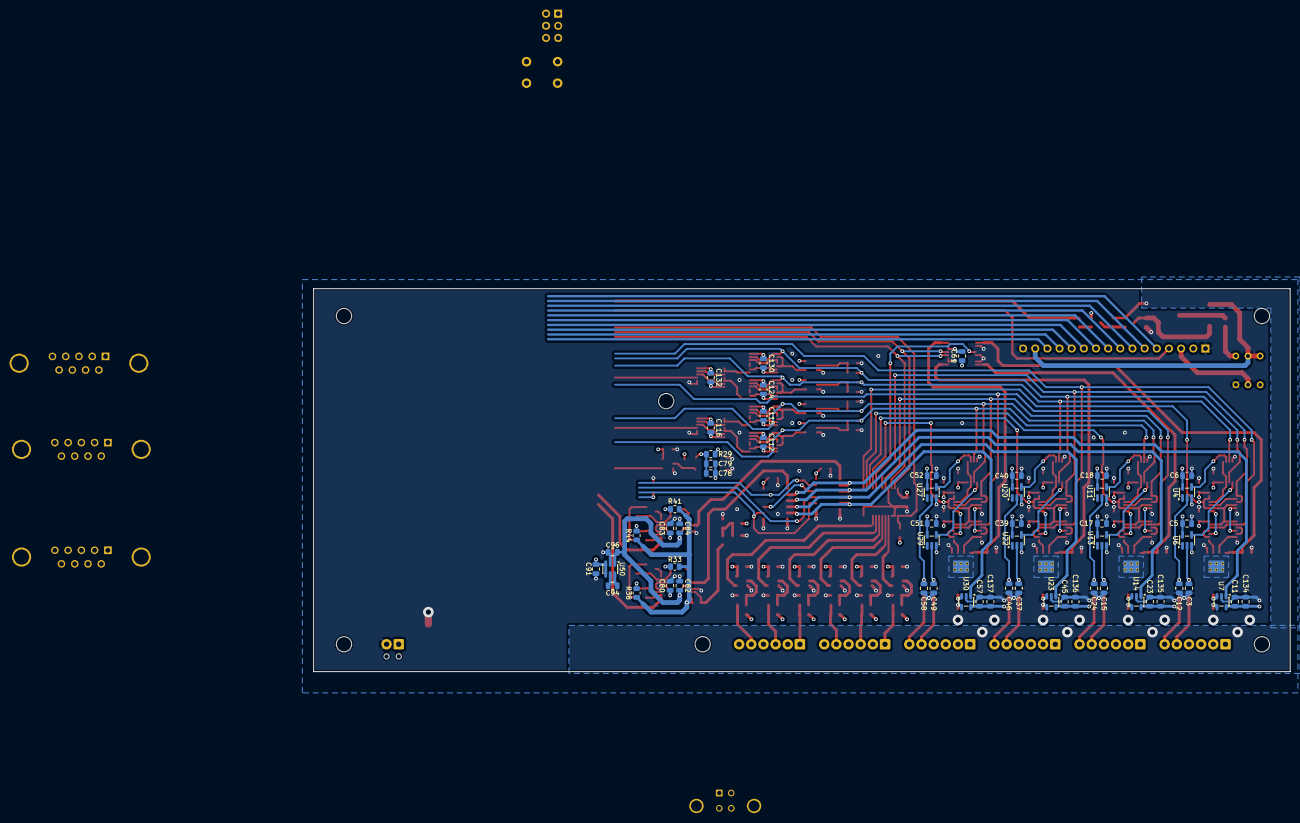
[picture p127: board BDCMotorController.kicad_pcb from below]

Board: 4 copper layers, 204.0 x 80.0 mm, 305 parts (58 on the bottom side), 318 nets.
