nunosousa/TelescopeMirrorTester/ECAD/BDCMotorControlShieldMega/BDCMotorControlShieldMega.kicad_pcb

## KiCad design ECAD/BDCMotorControlShieldMega/BDCMotorControlShieldMega.kicad_pcb (2025-09-10)

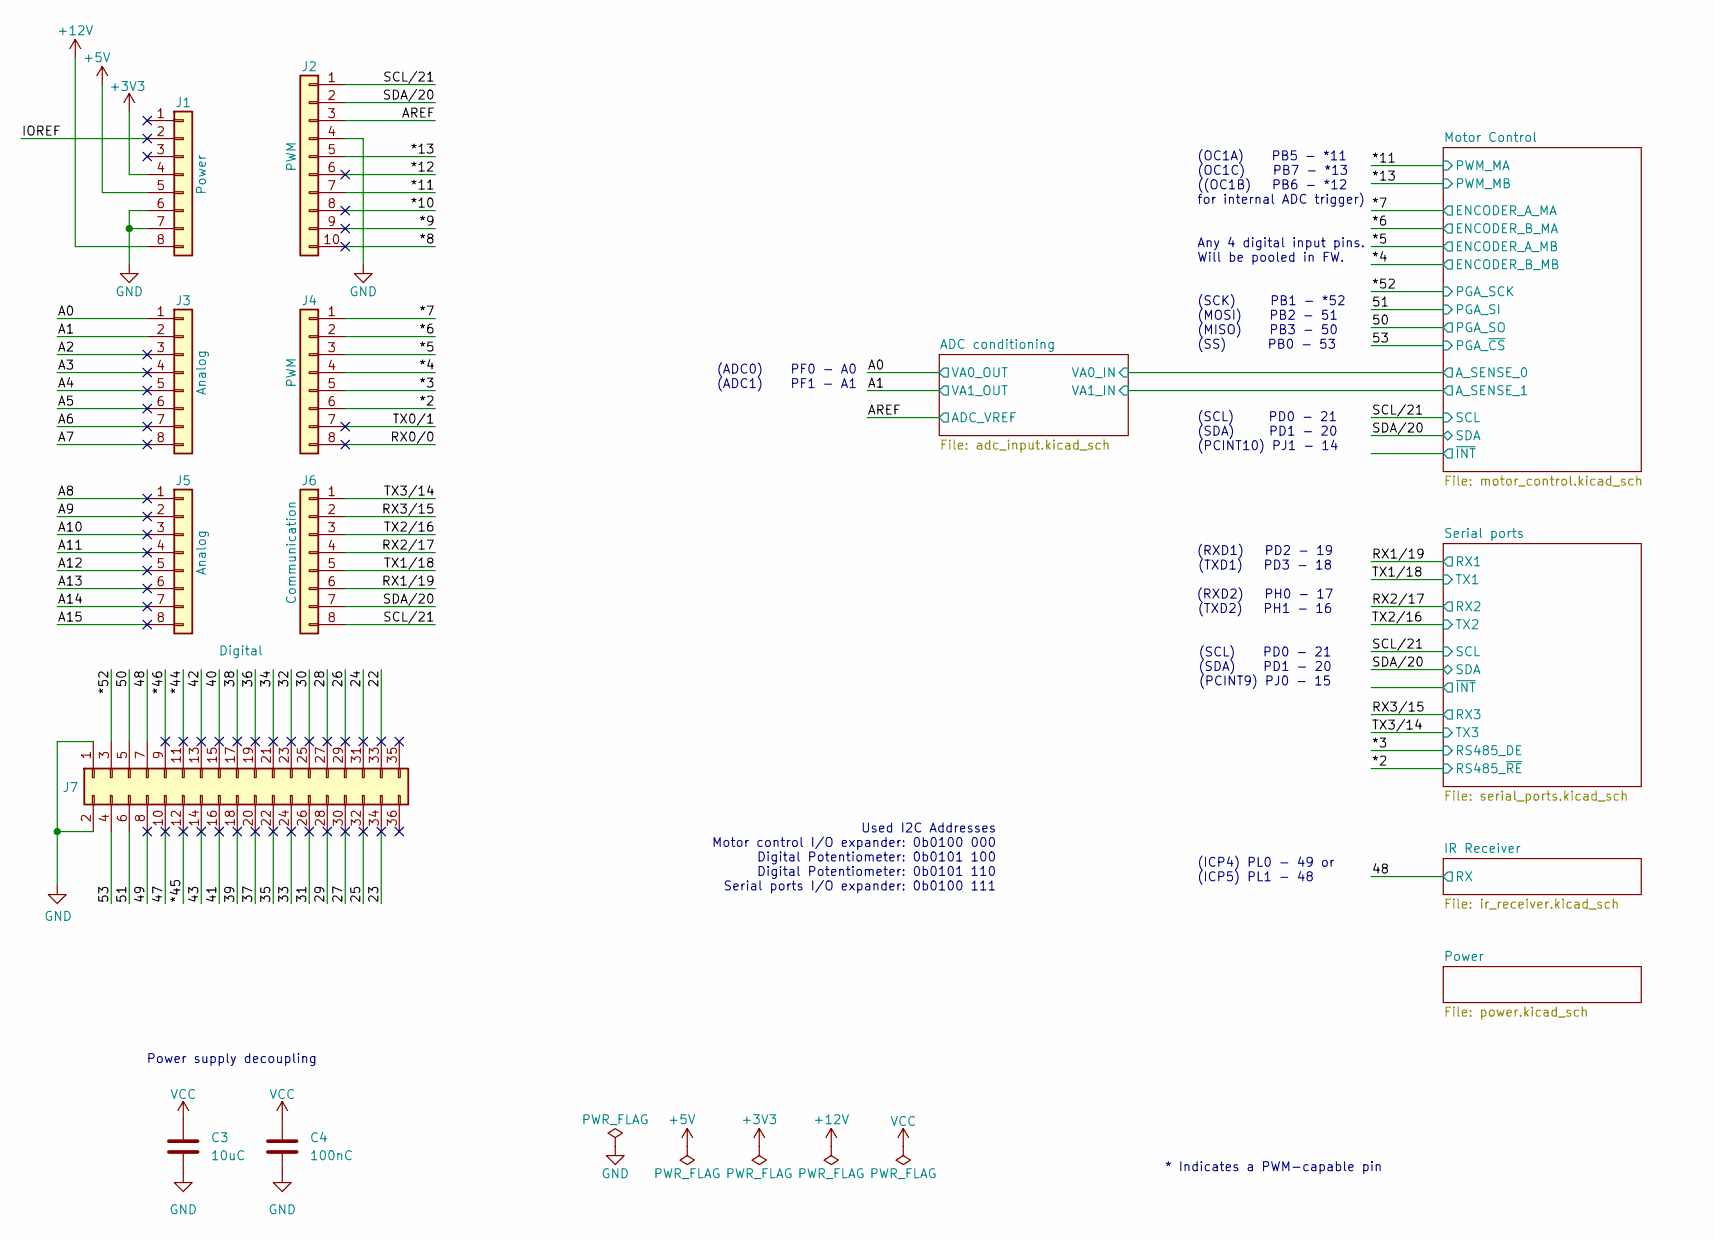
[picture p128: schematic BDCMotorControlShieldMega.kicad_sch]

Parts:
C3: 10uC; C_1210_3225Metric; MPN UMK325AB7106KM-T
C4: 100nC; C_0805_2012Metric
J1: Power; PinSocket_1x08_P2.54mm_Vertical; MPN PZ254-1-08-Z-8.5
J2: PWM; PinSocket_1x10_P2.54mm_Vertical; MPN PZ254-1-10-Z-8.5
J3, J5: Analog; PinSocket_1x08_P2.54mm_Vertical; MPN PZ254-1-08-Z-8.5
J4: PWM; PinSocket_1x08_P2.54mm_Vertical; MPN PZ254-1-08-Z-8.5
J6: Communication; PinSocket_1x08_P2.54mm_Vertical; MPN PZ254-1-08-Z-8.5
J7: Digital; PinSocket_2x18_P2.54mm_Vertical; MPN PZ254-2-18-Z-8.5

Connections:
+3V3: J1.4; also elsewhere on the board
+5V: J1.5; also elsewhere on the board
+12V: J1.8; also elsewhere on the board
/22: J7.33
/23: J7.34
/24: J7.31
/25: J7.32
/26: J7.29
/27: J7.30
/28: J7.27
/29: J7.28
/30: J7.25
/31: J7.26
/32: J7.23
/33: J7.24
/34: J7.21
/35: J7.22
/36: J7.19
/37: J7.20
/38: J7.17
/39: J7.18
/40: J7.15
/41: J7.16
/42: J7.13
/43: J7.14
/47: J7.10
/48: J7.7; also elsewhere on the board
/49: J7.8
/50: J7.5; also elsewhere on the board
/51: J7.6; also elsewhere on the board
/53: J7.4; also elsewhere on the board
/*2: J4.6; also elsewhere on the board
/*3: J4.5; also elsewhere on the board
/*4: J4.4; also elsewhere on the board
/*5: J4.3; also elsewhere on the board
/*6: J4.2; also elsewhere on the board
/*7: J4.1; also elsewhere on the board
/*8: J2.10
/*9: J2.9
/*10: J2.8
/*11: J2.7; also elsewhere on the board
/*12: J2.6
/*13: J2.5; also elsewhere on the board
/*44: J7.11
/*45: J7.12
/*46: J7.9
/*52: J7.3; also elsewhere on the board
/A0: J3.1; also elsewhere on the board
/A1: J3.2; also elsewhere on the board
/A2: J3.3
/A3: J3.4
/A4: J3.5
/A5: J3.6
/A6: J3.7
/A7: J3.8
/A8: J5.1
/A9: J5.2
/A10: J5.3
/A11: J5.4
/A12: J5.5
/A13: J5.6
/A14: J5.7
/A15: J5.8
/AREF: J2.3; also elsewhere on the board
/IOREF: J1.2
/RX0/0: J4.8
/RX1/19: J6.6; also elsewhere on the board
/RX2/17: J6.4; also elsewhere on the board
/RX3/15: J6.2; also elsewhere on the board
/SCL/21: J2.1, J6.8; also elsewhere on the board
/SDA/20: J2.2, J6.7; also elsewhere on the board
/TX0/1: J4.7
/TX1/18: J6.5; also elsewhere on the board
/TX2/16: J6.3; also elsewhere on the board
/TX3/14: J6.1; also elsewhere on the board
GND: C3.2, C4.2, J1.6, J1.7, J2.4, J7.1, J7.2; also elsewhere on the board
VCC: C3.1, C4.1; also elsewhere on the board

Notes on the sheet:
Used I2C Addresses Motor control I/O expander: 0b0100 000 Digital Potentiometer: 0b0101 100 Digital Potentiometer: 0b0101 110 Serial ports I/O expander: 0b0100 111
(ADC0) PF0 - A0 (ADC1) PF1 - A1
(ICP4) PL0 - 49 or (ICP5) PL1 - 48
(RXD1) PD2 - 19 (TXD1) PD3 - 18 (RXD2) PH0 - 17 (TXD2) PH1 - 16 (SCL) PD0 - 21 (SDA) PD1 - 20 (PCINT9) PJ0 - 15
Power supply decoupling
* Indicates a PWM-capable pin
(OC1A) PB5 - *11 (OC1C) PB7 - *13 ((OC1B) PB6 - *12 for internal ADC trigger) Any 4 digital input pins. Will be pooled in FW. (SCK) PB1 - *52 (MOSI) PB2 - 51 (MISO) PB3 - 50 (SS) PB0 - 53 (SCL) PD0 - 21 (SDA) PD1 - 20 (PCINT10) PJ1 - 14

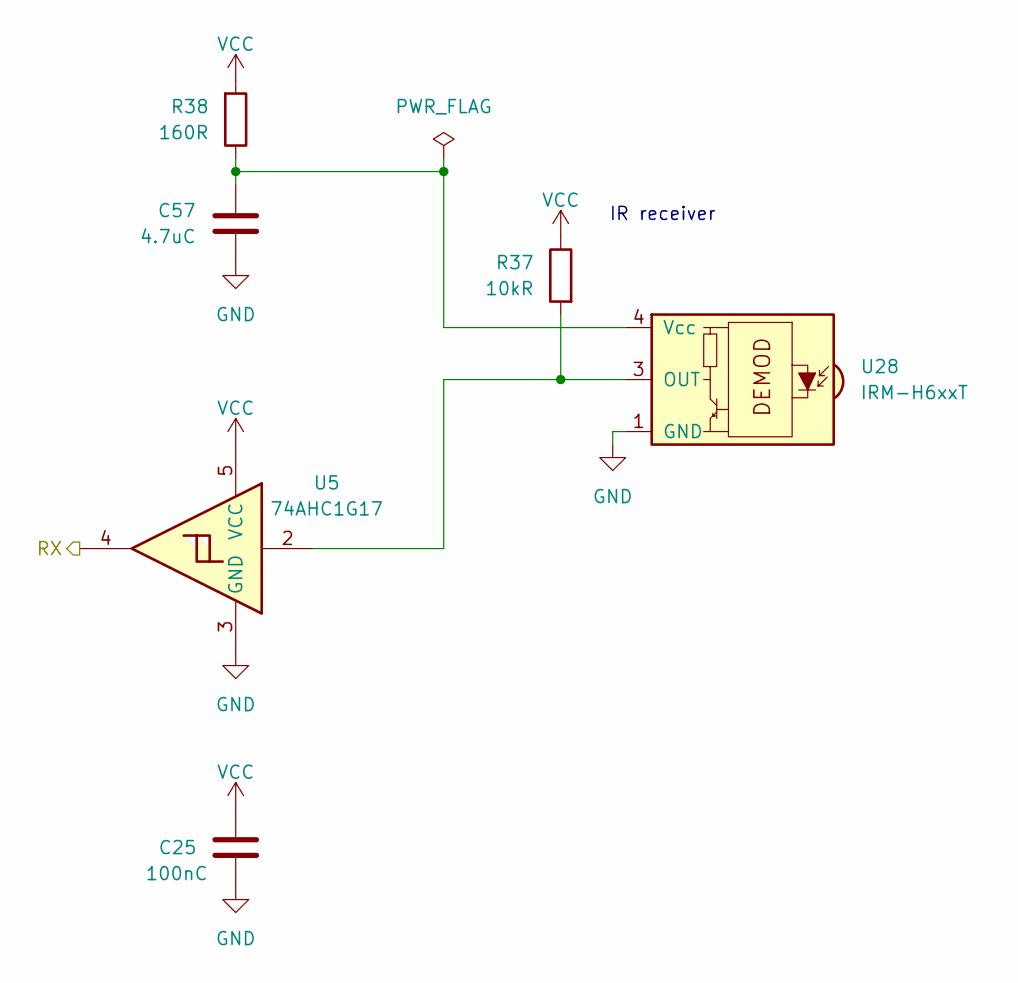
[picture p129: schematic ir_receiver.kicad_sch]

Parts:
C25: 100nC; C_0805_2012Metric
C57: 4.7uC; C_0805_2012Metric; MPN CC0805KKX7R8BB475
R37: 10kR; R_0805_2012Metric; MPN RC0805JR-0710KL
R38: 160R; R_0805_2012Metric; MPN AC0805FR-7W160RL
U5: 74AHC1G17; SC-74A-5_1.55x2.9mm_P0.95mm; MPN 74AHC1G17GVH
U28: IRM-H6xxT; Everlight_IRM-H6xxT; MPN IRM-H638J7/TR2(CLW)

Connections:
/48: U5.4; also elsewhere on the board
GND: C25.2, C57.2, U5.3 (GND), U28.1 (GND), U28.2 (GND); also elsewhere on the board
unnamed: R37.2, U5.2, U28.3 (OUT)
unnamed: C57.1, R38.1, U28.4 (Vcc)
VCC: C25.1, R37.1, R38.2, U5.5 (VCC); also elsewhere on the board

Notes on the sheet:
IR receiver

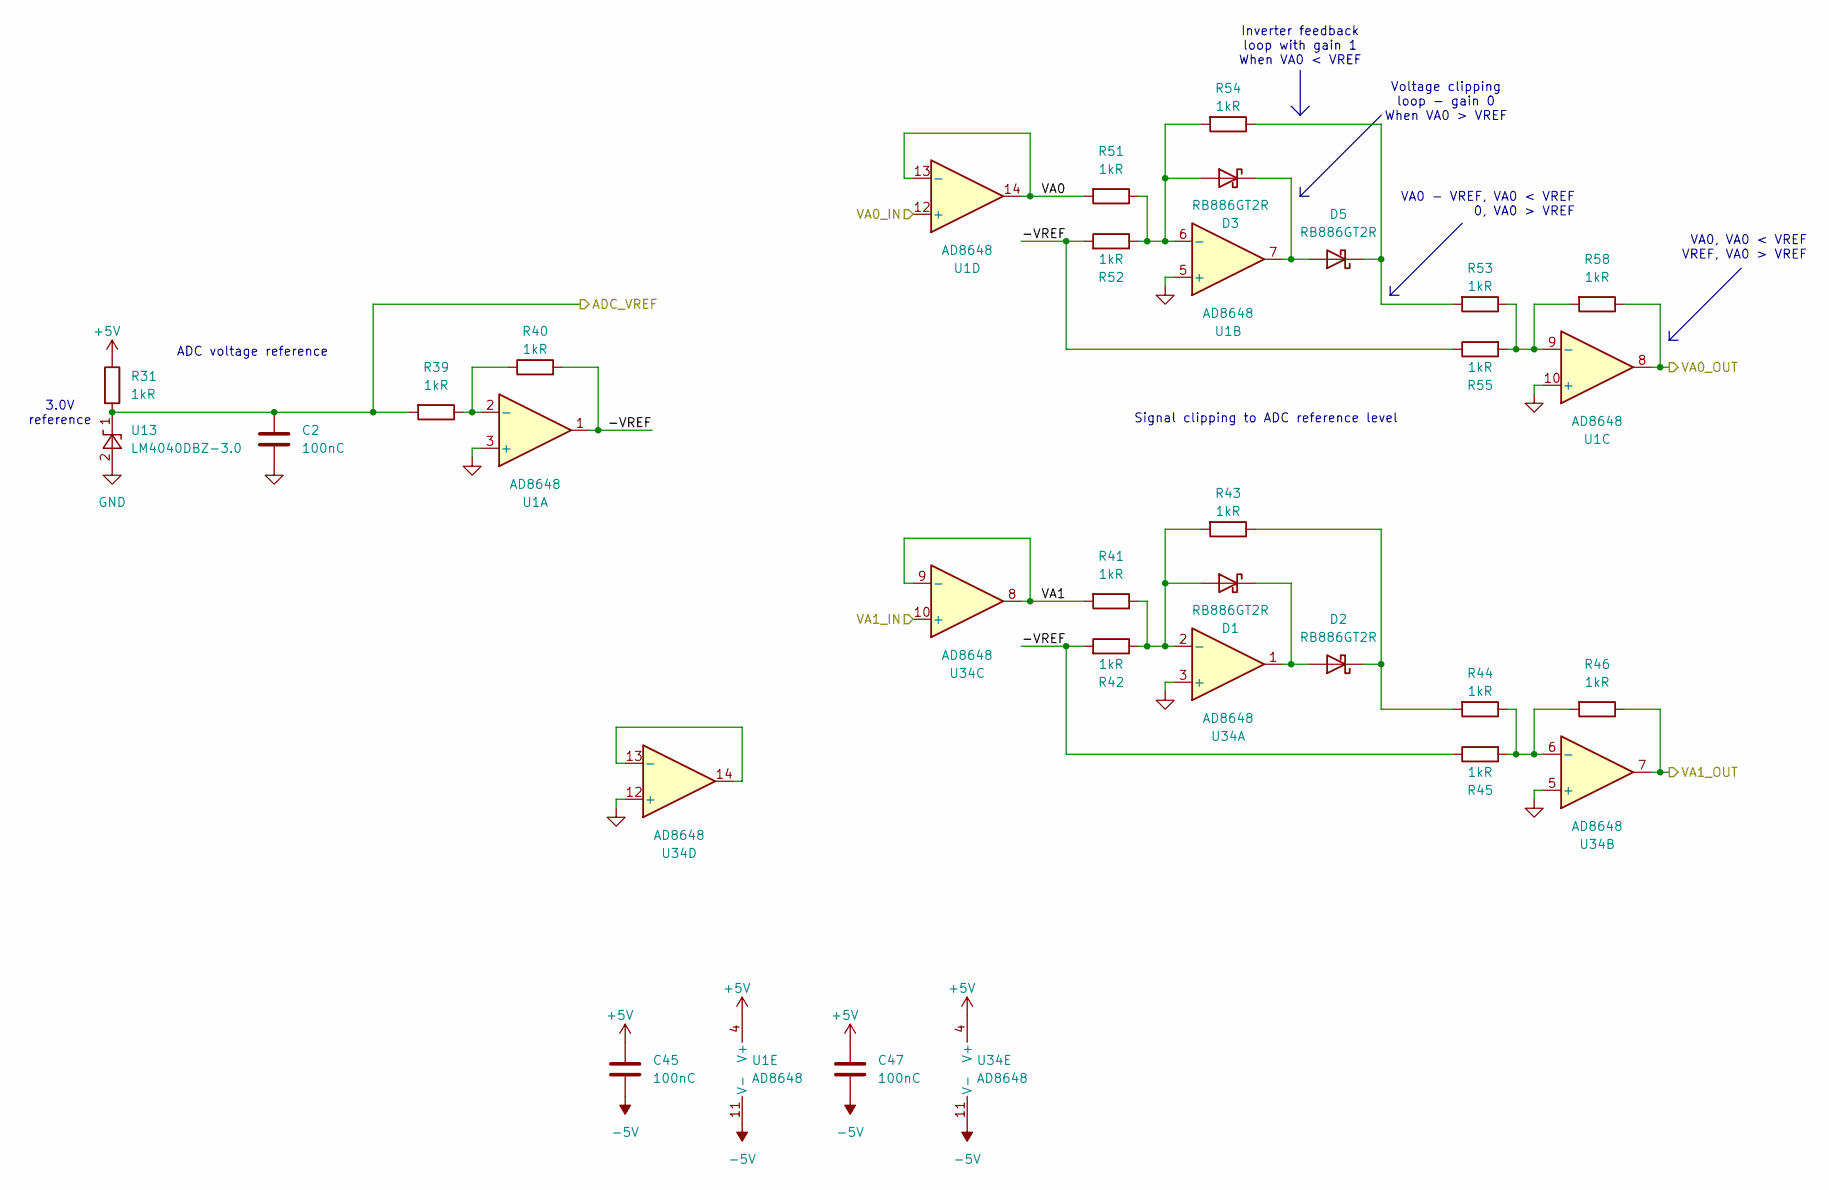
[picture p130: schematic adc_input.kicad_sch]

Parts:
C2, C45, C47: 100nC; C_0805_2012Metric
D1, D2, D3, D5: RB886GT2R; MPN RB886GT2R
R31: 1kR; R_0805_2012Metric; MPN AC0805FR-7W1KL
R39, R40, R41, R42, R43, R44, R45, R46, R51, R52, R53, R54, R55, R58: 1kR; R_0805_2012Metric
U1, U34: AD8648; TSSOP-14_4.4x5mm_P0.65mm; MPN AD8648ARUZ
U13: LM4040DBZ-3.0; SOT-23; MPN LM4040B30IDBZR

Connections:
+5V: C45.1, C47.1, R31.1, U1.4 (V+), U34.4 (V+); also elsewhere on the board
-5V: C45.2, C47.2, U1.11 (V-), U34.11 (V-); also elsewhere on the board
/A0: R58.1, U1.8; also elsewhere on the board
/A1: R46.1, U34.7; also elsewhere on the board
/ADC conditioning/-VREF: R40.2, R42.2, R45.1, R52.2, R55.1, U1.1
/ADC conditioning/VA0: R51.2, U1.13 (-), U1.14
/ADC conditioning/VA0_IN: U1.12 (+); also elsewhere on the board
/ADC conditioning/VA1: R41.2, U34.8, U34.9 (-)
/ADC conditioning/VA1_IN: U34.10 (+); also elsewhere on the board
/AREF: C2.1, R31.2, R39.2, U13.1 (K); also elsewhere on the board
GND: C2.2, U1.3 (+), U1.5 (+), U1.10 (+), U13.2 (A), U34.3 (+), U34.5 (+), U34.12 (+); also elsewhere on the board
unnamed: D1.2 (A), R41.1, R42.1, R43.2, U34.2 (-)
unnamed: D1.1 (K), D2.2 (A), U34.1
unnamed: D2.1 (K), R43.1, R44.2
unnamed: D3.2 (A), R51.1, R52.1, R54.2, U1.6 (-)
unnamed: D3.1 (K), D5.2 (A), U1.7
unnamed: D5.1 (K), R53.2, R54.1
unnamed: R39.1, R40.1, U1.2 (-)
unnamed: R53.1, R55.2, R58.2, U1.9 (-)
unnamed: R44.1, R45.2, R46.2, U34.6 (-)
unnamed: U34.13 (-), U34.14

Notes on the sheet:
Inverter feedback loop with gain 1 When VA0 < VREF
3.0V reference
ADC voltage reference
Signal clipping to ADC reference level
Voltage clipping loop - gain 0 When VA0 > VREF
VA0, VA0 < VREF VREF, VA0 > VREF
VA0 - VREF, VA0 < VREF 0, VA0 > VREF

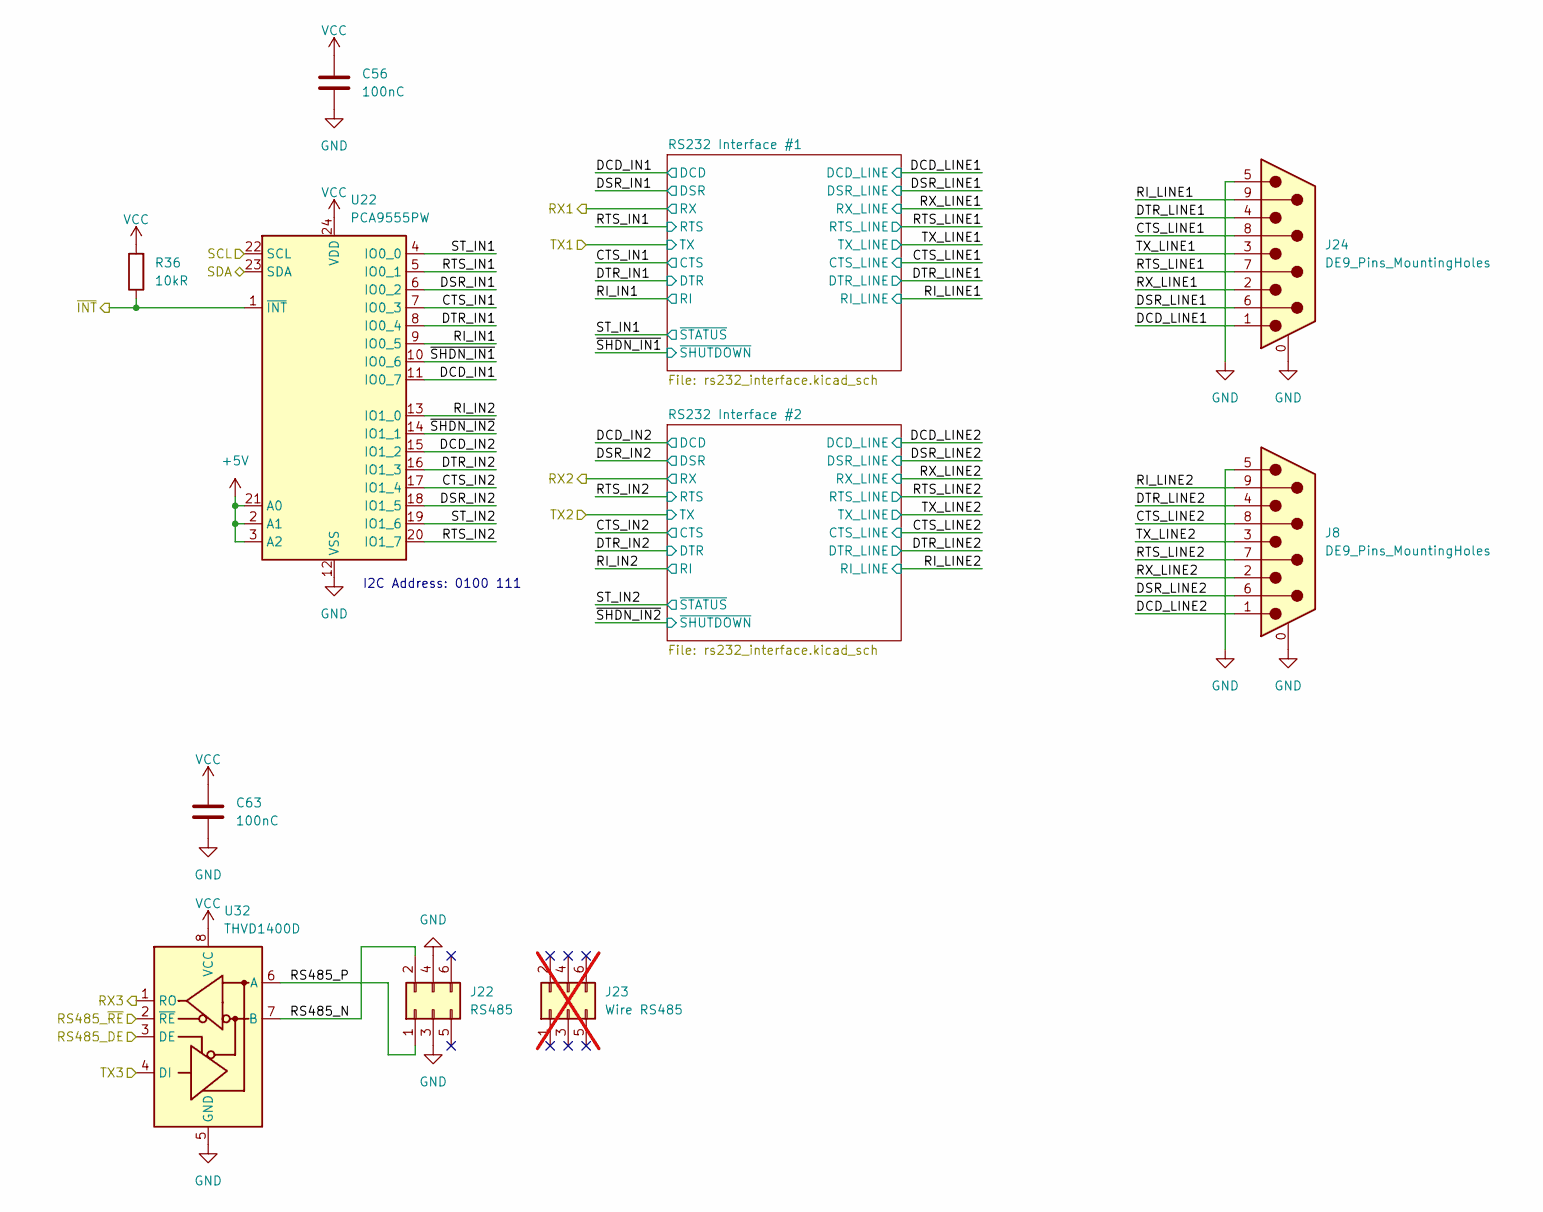
[picture p131: schematic serial_ports.kicad_sch]

Parts:
C56, C63: 100nC; C_0805_2012Metric
J8, J24: DE9_Pins_MountingHoles; DSUB-9_Pins_Vertical_P2.77x2.84mm_MountingHoles
J22: RS485; IDC-Header_2x03_P2.54mm_Vertical; MPN HC-JN254-2-03-Z
J23: Wire RS485; IDC-Header_2x03_P2.54mm_Vertical; MPN I254-2*3-G-3-B; not fitted
R36: 10kR; R_0805_2012Metric; MPN RC0805JR-0710KL
U22: PCA9555PW; TSSOP-24_4.4x7.8mm_P0.65mm; MPN PCA9555PW,118
U32: THVD1400D; SOIC-8_3.9x4.9mm_P1.27mm; MPN THVD1400DR

Connections:
+5V: U22.2 (A1), U22.3 (A2), U22.21 (A0); also elsewhere on the board
/*2: U32.2 (~RE); also elsewhere on the board
/*3: U32.3 (DE); also elsewhere on the board
/RX3/15: U32.1 (RO); also elsewhere on the board
/SCL/21: U22.22 (SCL); also elsewhere on the board
/SDA/20: U22.23 (SDA); also elsewhere on the board
/Serial ports/CTS_IN1: U22.7 (IO0_3); also elsewhere on the board
/Serial ports/CTS_IN2: U22.17 (IO1_4); also elsewhere on the board
/Serial ports/CTS_LINE1: J24.8; also elsewhere on the board
/Serial ports/CTS_LINE2: J8.8; also elsewhere on the board
/Serial ports/DCD_IN1: U22.11 (IO0_7); also elsewhere on the board
/Serial ports/DCD_IN2: U22.15 (IO1_2); also elsewhere on the board
/Serial ports/DCD_LINE1: J24.1; also elsewhere on the board
/Serial ports/DCD_LINE2: J8.1; also elsewhere on the board
/Serial ports/DSR_IN1: U22.6 (IO0_2); also elsewhere on the board
/Serial ports/DSR_IN2: U22.18 (IO1_5); also elsewhere on the board
/Serial ports/DSR_LINE1: J24.6; also elsewhere on the board
/Serial ports/DSR_LINE2: J8.6; also elsewhere on the board
/Serial ports/DTR_IN1: U22.8 (IO0_4); also elsewhere on the board
/Serial ports/DTR_IN2: U22.16 (IO1_3); also elsewhere on the board
/Serial ports/DTR_LINE1: J24.4; also elsewhere on the board
/Serial ports/DTR_LINE2: J8.4; also elsewhere on the board
/Serial ports/RI_IN1: U22.9 (IO0_5); also elsewhere on the board
/Serial ports/RI_IN2: U22.13 (IO1_0); also elsewhere on the board
/Serial ports/RI_LINE1: J24.9; also elsewhere on the board
/Serial ports/RI_LINE2: J8.9; also elsewhere on the board
/Serial ports/RS485_N: J22.2, U32.7 (B)
/Serial ports/RS485_P: J22.1, U32.6 (A)
/Serial ports/RTS_IN1: U22.5 (IO0_1); also elsewhere on the board
/Serial ports/RTS_IN2: U22.20 (IO1_7); also elsewhere on the board
/Serial ports/RTS_LINE1: J24.7; also elsewhere on the board
/Serial ports/RTS_LINE2: J8.7; also elsewhere on the board
/Serial ports/RX_LINE1: J24.2; also elsewhere on the board
/Serial ports/RX_LINE2: J8.2; also elsewhere on the board
/Serial ports/ST_IN1: U22.4 (IO0_0); also elsewhere on the board
/Serial ports/ST_IN2: U22.19 (IO1_6); also elsewhere on the board
/Serial ports/TX_LINE1: J24.3; also elsewhere on the board
/Serial ports/TX_LINE2: J8.3; also elsewhere on the board
/Serial ports/~INT: R36.1, U22.1 (~INT)
/Serial ports/~SHDN_IN1: U22.10 (IO0_6); also elsewhere on the board
/Serial ports/~SHDN_IN2: U22.14 (IO1_1); also elsewhere on the board
/TX3/14: U32.4 (DI); also elsewhere on the board
GND: C56.2, C63.2, J8.0 (PAD), J8.5, J22.3, J22.4, J24.0 (PAD), J24.5, U22.12 (VSS), U32.5 (GND); also elsewhere on the board
VCC: C56.1, C63.1, R36.2, U22.24 (VDD), U32.8 (VCC); also elsewhere on the board

Notes on the sheet:
I2C Address: 0100 111

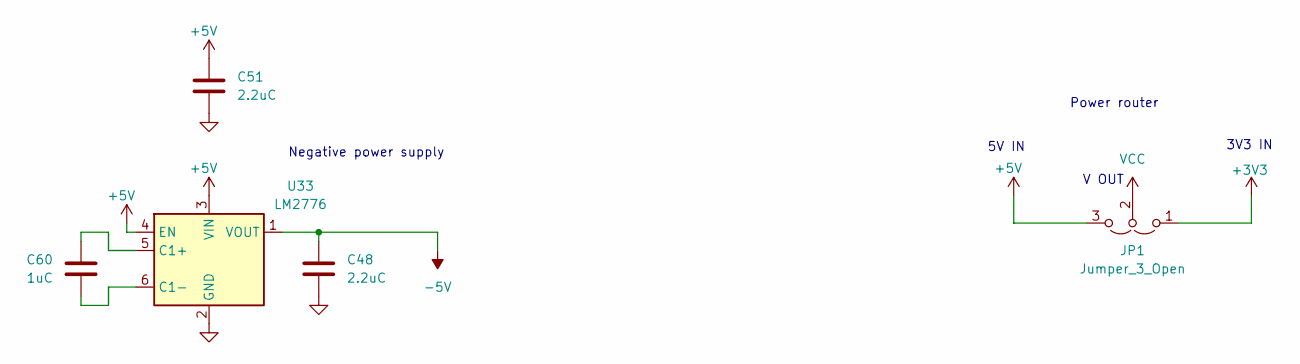
[picture p132: schematic power.kicad_sch]

Parts:
C48, C51: 2.2uC; C_0805_2012Metric
C60: 1uC; C_0805_2012Metric
JP1: Jumper_3_Open; PinHeader_1x03_P2.54mm_Vertical
U33: LM2776; SOT-23-6

Connections:
+3V3: JP1.1 (A); also elsewhere on the board
+5V: C51.1, JP1.3 (B), U33.3 (VIN), U33.4 (EN); also elsewhere on the board
-5V: C48.1, U33.1 (VOUT); also elsewhere on the board
GND: C48.2, C51.2, U33.2 (GND); also elsewhere on the board
unnamed: C60.1, U33.5 (C1+)
unnamed: C60.2, U33.6 (C1-)
VCC: JP1.2 (C); also elsewhere on the board

Notes on the sheet:
3V3 IN
Power router
Negative power supply
V OUT
5V IN

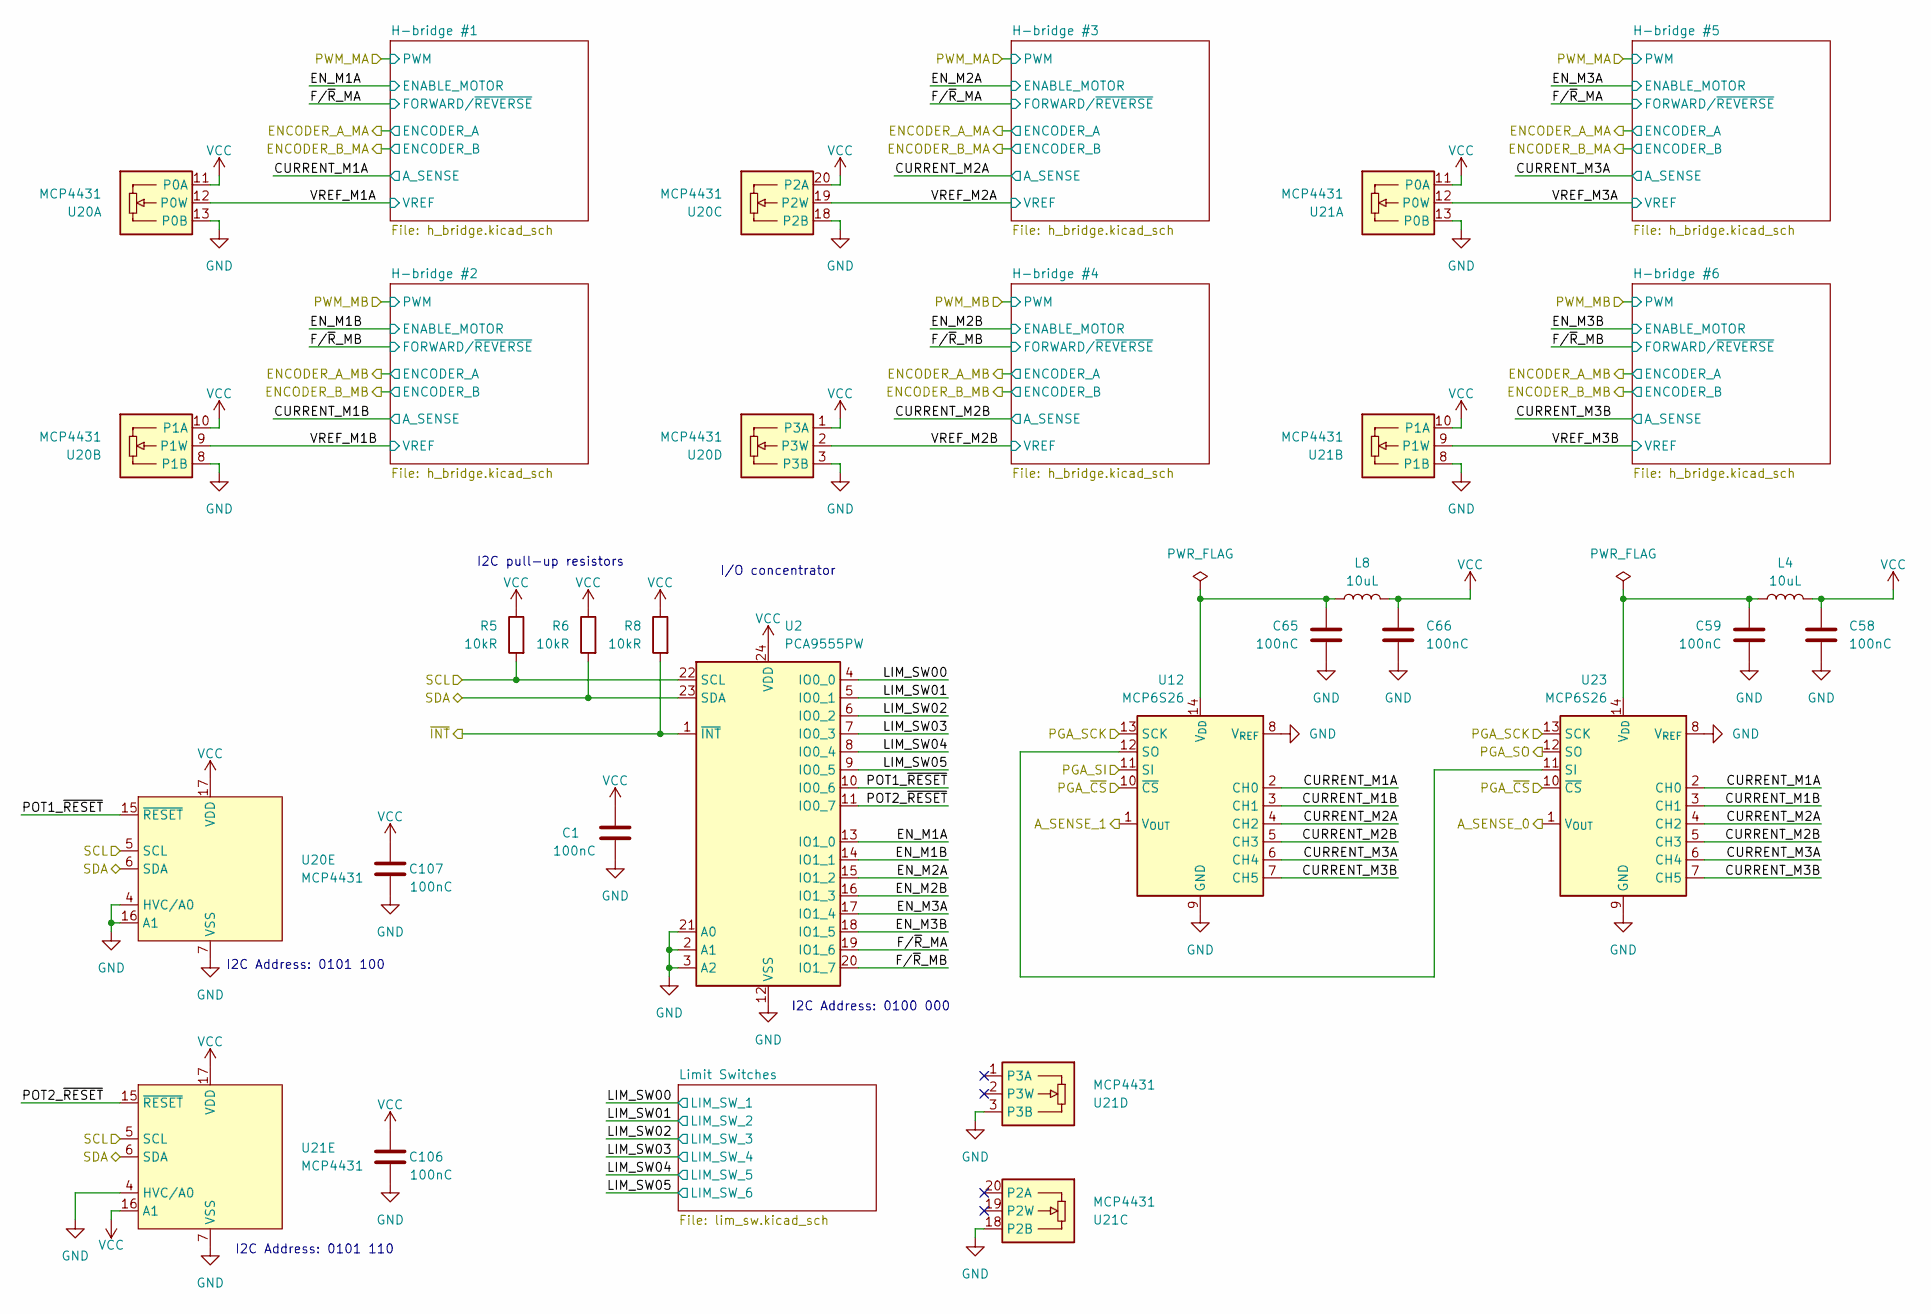
[picture p133: schematic motor_control.kicad_sch]

Parts:
C1, C58, C59, C65, C66, C106, C107: 100nC; C_0805_2012Metric
L4, L8: 10uL; L_0805_2012Metric; MPN LQM21FN100M80L
R5, R6, R8: 10kR; R_0805_2012Metric; MPN RC0805JR-0710KL
U2: PCA9555PW; TSSOP-24_4.4x7.8mm_P0.65mm; MPN PCA9555PW,118
U12, U23: MCP6S26; SOIC-14_3.9x8.7mm_P1.27mm; MPN MCP6S26-I/SL
U20, U21: MCP4431; TSSOP-20_4.4x6.5mm_P0.65mm; MPN MCP4431-103E/ST

Connections:
/50: U23.12 (SO); also elsewhere on the board
/51: U12.11 (SI); also elsewhere on the board
/53: U12.10 (~CS), U23.10 (~CS); also elsewhere on the board
/*52: U12.13 (SCK), U23.13 (SCK); also elsewhere on the board
/ADC conditioning/VA0_IN: U23.1 (V_{OUT}); also elsewhere on the board
/ADC conditioning/VA1_IN: U12.1 (V_{OUT}); also elsewhere on the board
/Motor Control/CURRENT_M1A: U12.2 (CH0), U23.2 (CH0); also elsewhere on the board
/Motor Control/CURRENT_M1B: U12.3 (CH1), U23.3 (CH1); also elsewhere on the board
/Motor Control/CURRENT_M2A: U12.4 (CH2), U23.4 (CH2); also elsewhere on the board
/Motor Control/CURRENT_M2B: U12.5 (CH3), U23.5 (CH3); also elsewhere on the board
/Motor Control/CURRENT_M3A: U12.6 (CH4), U23.6 (CH4); also elsewhere on the board
/Motor Control/CURRENT_M3B: U12.7 (CH5), U23.7 (CH5); also elsewhere on the board
/Motor Control/EN_M1A: U2.13 (IO1_0); also elsewhere on the board
/Motor Control/EN_M1B: U2.14 (IO1_1); also elsewhere on the board
/Motor Control/EN_M2A: U2.15 (IO1_2); also elsewhere on the board
/Motor Control/EN_M2B: U2.16 (IO1_3); also elsewhere on the board
/Motor Control/EN_M3A: U2.17 (IO1_4); also elsewhere on the board
/Motor Control/EN_M3B: U2.18 (IO1_5); also elsewhere on the board
/Motor Control/F/~R_MA: U2.19 (IO1_6); also elsewhere on the board
/Motor Control/F/~R_MB: U2.20 (IO1_7); also elsewhere on the board
/Motor Control/LIM_SW00: U2.4 (IO0_0); also elsewhere on the board
/Motor Control/LIM_SW01: U2.5 (IO0_1); also elsewhere on the board
/Motor Control/LIM_SW02: U2.6 (IO0_2); also elsewhere on the board
/Motor Control/LIM_SW03: U2.7 (IO0_3); also elsewhere on the board
/Motor Control/LIM_SW04: U2.8 (IO0_4); also elsewhere on the board
/Motor Control/LIM_SW05: U2.9 (IO0_5); also elsewhere on the board
/Motor Control/POT1_~RESET: U2.10 (IO0_6), U20.15 (~RESET)
/Motor Control/POT2_~RESET: U2.11 (IO0_7), U21.15 (~RESET)
/Motor Control/VREF_M1A: U20.12 (P0W); also elsewhere on the board
/Motor Control/VREF_M1B: U20.9 (P1W); also elsewhere on the board
/Motor Control/VREF_M2A: U20.19 (P2W); also elsewhere on the board
/Motor Control/VREF_M2B: U20.2 (P3W); also elsewhere on the board
/Motor Control/VREF_M3A: U21.12 (P0W); also elsewhere on the board
/Motor Control/VREF_M3B: U21.9 (P1W); also elsewhere on the board
/Motor Control/~INT: R8.2, U2.1 (~INT)
/SCL/21: R5.2, U2.22 (SCL), U20.5 (SCL), U21.5 (SCL); also elsewhere on the board
/SDA/20: R6.2, U2.23 (SDA), U20.6 (SDA), U21.6 (SDA); also elsewhere on the board
GND: C1.2, C58.2, C59.2, C65.2, C66.2, C106.2, C107.2, U2.2 (A1), U2.3 (A2), U2.12 (VSS), U2.21 (A0), U12.8 (V_{REF}), U12.9 (GND), U20.3 (P3B), U20.4 (HVC/A0), U20.7 (VSS), U20.8 (P1B), U20.13 (P0B), U20.16 (A1), U20.18 (P2B), U21.3 (P3B), U21.4 (HVC/A0), U21.7 (VSS), U21.8 (P1B), U21.13 (P0B), U21.18 (P2B), U23.8 (V_{REF}), U23.9 (GND); also elsewhere on the board
unnamed: U12.12 (SO), U23.11 (SI)
unnamed: C65.1, L8.2, U12.14 (V_{DD})
unnamed: C59.1, L4.2, U23.14 (V_{DD})
VCC: C1.1, C58.1, C66.1, C106.1, C107.1, L4.1, L8.1, R5.1, R6.1, R8.1, U2.24 (VDD), U20.1 (P3A), U20.10 (P1A), U20.11 (P0A), U20.17 (VDD), U20.20 (P2A), U21.10 (P1A), U21.11 (P0A), U21.16 (A1), U21.17 (VDD); also elsewhere on the board

Notes on the sheet:
I2C pull-up resistors
I2C Address: 0100 000
I2C Address: 0101 100
I/O concentrator
I2C Address: 0101 110
