nunosousa/TelescopeMirrorTester/ECAD/BDCMotorControlShieldMega/BDCMotorControlShieldMega.kicad_pcb

## KiCad design ECAD/BDCMotorControlShieldMega/BDCMotorControlShieldMega.kicad_pcb (continued)

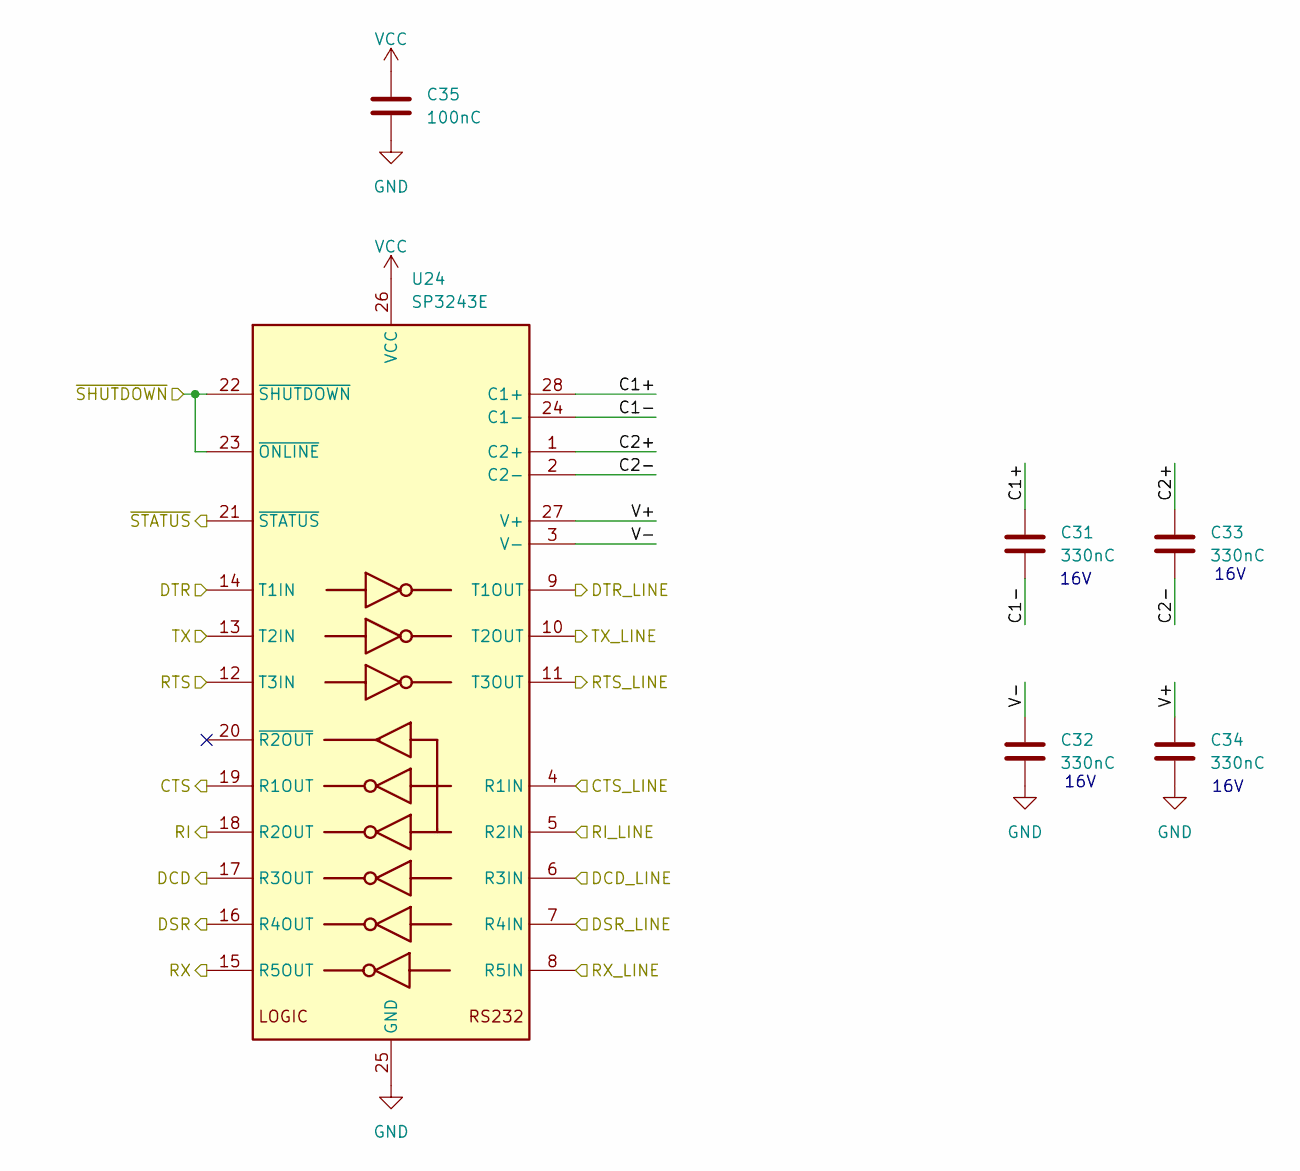
[picture p134: schematic rs232_interface.kicad_sch]

Parts:
C31, C32, C33, C34: 330nC; C_0805_2012Metric
C35: 100nC; C_0805_2012Metric
U24: SP3243E; TSSOP-28_4.4x9.7mm_P0.65mm; MPN SP3243EBEY-L/TR

Connections:
/RX1/19: U24.15 (R5OUT); also elsewhere on the board
/Serial ports/CTS_IN1: U24.19 (R1OUT); also elsewhere on the board
/Serial ports/CTS_LINE1: U24.4 (R1IN); also elsewhere on the board
/Serial ports/DCD_IN1: U24.17 (R3OUT); also elsewhere on the board
/Serial ports/DCD_LINE1: U24.6 (R3IN); also elsewhere on the board
/Serial ports/DSR_IN1: U24.16 (R4OUT); also elsewhere on the board
/Serial ports/DSR_LINE1: U24.7 (R4IN); also elsewhere on the board
/Serial ports/DTR_IN1: U24.14 (T1IN); also elsewhere on the board
/Serial ports/DTR_LINE1: U24.9 (T1OUT); also elsewhere on the board
/Serial ports/RI_IN1: U24.18 (R2OUT); also elsewhere on the board
/Serial ports/RI_LINE1: U24.5 (R2IN); also elsewhere on the board
/Serial ports/RS232 Interface #1/C1+: C31.1, U24.28 (C1+)
/Serial ports/RS232 Interface #1/C1-: C31.2, U24.24 (C1-)
/Serial ports/RS232 Interface #1/C2+: C33.1, U24.1 (C2+)
/Serial ports/RS232 Interface #1/C2-: C33.2, U24.2 (C2-)
/Serial ports/RS232 Interface #1/V+: C34.1, U24.27 (V+)
/Serial ports/RS232 Interface #1/V-: C32.1, U24.3 (V-)
/Serial ports/RTS_IN1: U24.12 (T3IN); also elsewhere on the board
/Serial ports/RTS_LINE1: U24.11 (T3OUT); also elsewhere on the board
/Serial ports/RX_LINE1: U24.8 (R5IN); also elsewhere on the board
/Serial ports/ST_IN1: U24.21 (~STATUS); also elsewhere on the board
/Serial ports/TX_LINE1: U24.10 (T2OUT); also elsewhere on the board
/Serial ports/~SHDN_IN1: U24.22 (~SHUTDOWN), U24.23 (~ONLINE); also elsewhere on the board
/TX1/18: U24.13 (T2IN); also elsewhere on the board
GND: C32.2, C34.2, C35.2, U24.25 (GND); also elsewhere on the board
VCC: C35.1, U24.26 (VCC); also elsewhere on the board

Parts of its further copies:
C36, C37, C38, C39: 330nC; C_0805_2012Metric
C40: 100nC; C_0805_2012Metric
U31: SP3243E; TSSOP-28_4.4x9.7mm_P0.65mm; MPN SP3243EBEY-L/TR

Connections of its further copies:
/RX2/17: U31.15 (R5OUT); also elsewhere on the board
/Serial ports/CTS_IN2: U31.19 (R1OUT); also elsewhere on the board
/Serial ports/CTS_LINE2: U31.4 (R1IN); also elsewhere on the board
/Serial ports/DCD_IN2: U31.17 (R3OUT); also elsewhere on the board
/Serial ports/DCD_LINE2: U31.6 (R3IN); also elsewhere on the board
/Serial ports/DSR_IN2: U31.16 (R4OUT); also elsewhere on the board
/Serial ports/DSR_LINE2: U31.7 (R4IN); also elsewhere on the board
/Serial ports/DTR_IN2: U31.14 (T1IN); also elsewhere on the board
/Serial ports/DTR_LINE2: U31.9 (T1OUT); also elsewhere on the board
/Serial ports/RI_IN2: U31.18 (R2OUT); also elsewhere on the board
/Serial ports/RI_LINE2: U31.5 (R2IN); also elsewhere on the board
/Serial ports/RS232 Interface #2/C1+: C36.1, U31.28 (C1+)
/Serial ports/RS232 Interface #2/C1-: C36.2, U31.24 (C1-)
/Serial ports/RS232 Interface #2/C2+: C38.1, U31.1 (C2+)
/Serial ports/RS232 Interface #2/C2-: C38.2, U31.2 (C2-)
/Serial ports/RS232 Interface #2/V+: C39.1, U31.27 (V+)
/Serial ports/RS232 Interface #2/V-: C37.1, U31.3 (V-)
/Serial ports/RTS_IN2: U31.12 (T3IN); also elsewhere on the board
/Serial ports/RTS_LINE2: U31.11 (T3OUT); also elsewhere on the board
/Serial ports/RX_LINE2: U31.8 (R5IN); also elsewhere on the board
/Serial ports/ST_IN2: U31.21 (~STATUS); also elsewhere on the board
/Serial ports/TX_LINE2: U31.10 (T2OUT); also elsewhere on the board
/Serial ports/~SHDN_IN2: U31.22 (~SHUTDOWN), U31.23 (~ONLINE); also elsewhere on the board
/TX2/16: U31.13 (T2IN); also elsewhere on the board
GND: C37.2, C39.2, C40.2, U31.25 (GND); also elsewhere on the board
VCC: C40.1, U31.26 (VCC); also elsewhere on the board

Notes on the sheet:
16V

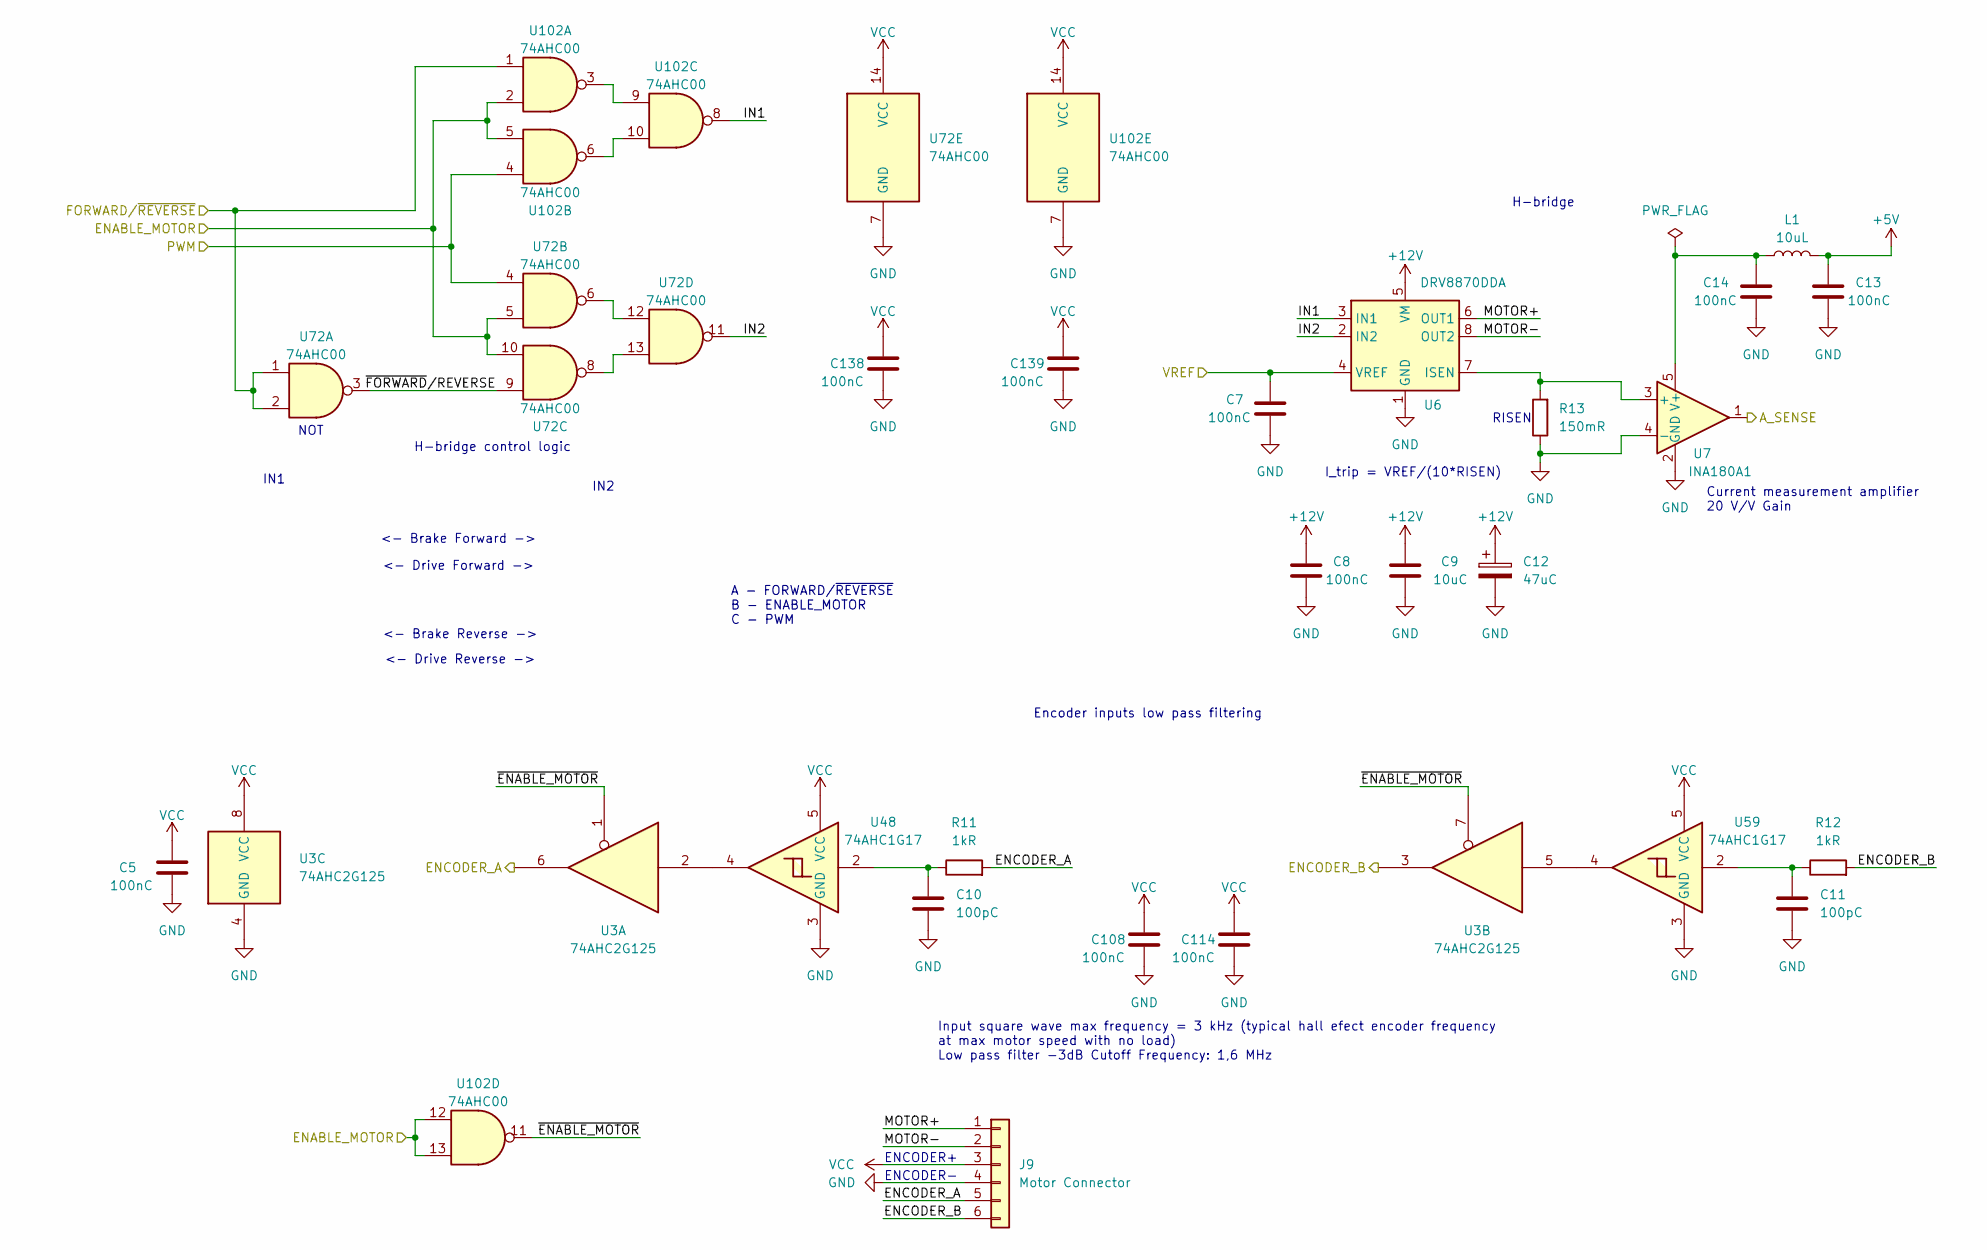
[picture p135: schematic h_bridge.kicad_sch]

Parts:
C5, C7, C8, C13, C14, C108, C114, C138, C139: 100nC; C_0805_2012Metric
C9: 10uC; C_1210_3225Metric; MPN UMK325AB7106KM-T
C10, C11: 100pC; C_0805_2012Metric; MPN CC0805KRX7R9BB101
C12: 47uC; CP_Radial_D5.0mm_P2.00mm; MPN 35YXJ47M5X11
J9: Motor Connector; JST_PH_B6B-PH-K_1x06_P2.00mm_Vertical; MPN B6B-PH-K-S(LF)(SN)
L1: 10uL; L_0805_2012Metric; MPN LQM21FN100M80L
R11, R12: 1kR; R_0805_2012Metric; MPN AC0805FR-7W1KL
R13: 150mR; R_1206_3216Metric; MPN RLH12FTCR150
U3: 74AHC2G125; TSSOP-8_3x3mm_P0.65mm; MPN 74AHC2G125DP,125
U6: DRV8870DDA; Texas_HTSOP-8-1EP_3.9x4.9mm_P1.27mm_EP2.95x4.9mm_Mask2.4x3.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; MPN DRV8870DDAR
U7: INA180A1; SOT-23-5; MPN INA180A1IDBVR
U48, U59: 74AHC1G17; SC-74A-5_1.55x2.9mm_P0.95mm; MPN 74AHC1G17GVH
U72, U102: 74AHC00; TSSOP-14_4.4x5mm_P0.65mm; MPN SN74AHC00PWR

Connections:
+5V: C13.1, L1.1; also elsewhere on the board
+12V: C8.1, C9.1, C12.1, U6.5 (VM); also elsewhere on the board
/*6: J9.6, R12.2, U3.3; also elsewhere on the board
/*7: J9.5, R11.2, U3.6; also elsewhere on the board
/*11: U72.4, U102.4; also elsewhere on the board
/Motor Control/CURRENT_M1A: U7.1; also elsewhere on the board
/Motor Control/EN_M1A: U72.5, U72.10, U102.2, U102.5, U102.12, U102.13; also elsewhere on the board
/Motor Control/F/~R_MA: U72.1, U72.2, U102.1; also elsewhere on the board
/Motor Control/H-bridge #1/IN1: U6.3 (IN1), U102.8
/Motor Control/H-bridge #1/IN2: U6.2 (IN2), U72.11
/Motor Control/H-bridge #1/MOTOR+: J9.1, U6.6 (OUT1)
/Motor Control/H-bridge #1/MOTOR-: J9.2, U6.8 (OUT2)
/Motor Control/H-bridge #1/~ENABLE_MOTOR: U3.1, U3.7, U102.11
/Motor Control/H-bridge #1/~FORWARD/REVERSE: U72.3, U72.9
/Motor Control/VREF_M1A: C7.1, U6.4 (VREF); also elsewhere on the board
GND: C5.2, C7.2, C8.2, C9.2, C10.2, C11.2, C12.2, C13.2, C14.2, C108.2, C114.2, C138.2, C139.2, J9.4, R13.1, U3.4 (GND), U6.1 (GND), U6.9 (GND), U7.2 (GND), U7.4 (-), U48.3 (GND), U59.3 (GND), U72.7 (GND), U102.7 (GND); also elsewhere on the board
unnamed: C10.1, R11.1, U48.2
unnamed: C11.1, R12.1, U59.2
unnamed: U3.2, U48.4
unnamed: U3.5, U59.4
unnamed: R13.2, U6.7 (ISEN), U7.3 (+)
unnamed: C14.1, L1.2, U7.5 (V+)
unnamed: U72.6, U72.12
unnamed: U72.8, U72.13
unnamed: U102.3, U102.9
unnamed: U102.6, U102.10
VCC: C5.1, C108.1, C114.1, C138.1, C139.1, J9.3, U3.8 (VCC), U48.5 (VCC), U59.5 (VCC), U72.14 (VCC), U102.14 (VCC); also elsewhere on the board

Parts of its further copies:
C20, C27, C28, C43, C44, C46, C53, C54, C62, C64, C68, C74, C75, C78, C79, C81, C87, C88, C91, C92, C94, C100, C101, C104, C105, C109, C110, C111, C112, C113, C115, C116, C117, C118, C119, C141, C142, C144, C145, C147, C148, C150, C151, C153, C154: 100nC; C_0805_2012Metric
C23, C24, C49, C50, C71, C72, C84, C85, C97, C98: 100pC; C_0805_2012Metric; MPN CC0805KRX7R9BB101
C29, C55, C76, C89, C102: 10uC; C_1210_3225Metric; MPN UMK325AB7106KM-T
C30, C61, C77, C90, C103: 47uC; CP_Radial_D5.0mm_P2.00mm; MPN 35YXJ47M5X11
J12, J15, J19, J20, J21: Motor Connector; JST_PH_B6B-PH-K_1x06_P2.00mm_Vertical; MPN B6B-PH-K-S(LF)(SN)
L2, L3, L5, L6, L7: 10uL; L_0805_2012Metric; MPN LQM21FN100M80L
R1, R2, R4, R9, R18, R19, R21, R22, R28, R29: 1kR; R_0805_2012Metric; MPN AC0805FR-7W1KL
R3, R10, R20, R27, R30: 150mR; R_1206_3216Metric; MPN RLH12FTCR150
U4, U8, U9, U19, U25: 74AHC2G125; TSSOP-8_3x3mm_P0.65mm; MPN 74AHC2G125DP,125
U17, U29, U37, U45, U52: DRV8870DDA; Texas_HTSOP-8-1EP_3.9x4.9mm_P1.27mm_EP2.95x4.9mm_Mask2.4x3.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; MPN DRV8870DDAR
U18, U30, U39, U46, U53: INA180A1; SOT-23-5; MPN INA180A1IDBVR
U54, U55, U56, U57, U58, U60, U61, U62, U63, U64: 74AHC1G17; SC-74A-5_1.55x2.9mm_P0.95mm; MPN 74AHC1G17GVH
U73, U74, U75, U76, U77, U103, U104, U105, U106, U107: 74AHC00; TSSOP-14_4.4x5mm_P0.65mm; MPN SN74AHC00PWR

Connections of its further copies:
+5V: C44.1, C64.1, C79.1, C92.1, C105.1, L2.1, L3.1, L5.1, L6.1, L7.1; also elsewhere on the board
+12V: C28.1, C29.1, C30.1, C54.1, C55.1, C61.1, C75.1, C76.1, C77.1, C88.1, C89.1, C90.1, C101.1, C102.1, C103.1, U17.5 (VM), U29.5 (VM), U37.5 (VM), U45.5 (VM), U52.5 (VM); also elsewhere on the board
/*4: J12.6, J19.6, J21.6, R2.2, R19.2, R29.2, U4.3, U9.3, U25.3; also elsewhere on the board
/*5: J12.5, J19.5, J21.5, R1.2, R18.2, R28.2, U4.6, U9.6, U25.6; also elsewhere on the board
/*6: J15.6, J20.6, R9.2, R22.2, U8.3, U19.3; also elsewhere on the board
/*7: J15.5, J20.5, R4.2, R21.2, U8.6, U19.6; also elsewhere on the board
/*11: U74.4, U76.4, U104.4, U106.4; also elsewhere on the board
/*13: U73.4, U75.4, U77.4, U103.4, U105.4, U107.4; also elsewhere on the board
/Motor Control/CURRENT_M1B: U18.1; also elsewhere on the board
/Motor Control/CURRENT_M2A: U30.1; also elsewhere on the board
/Motor Control/CURRENT_M2B: U39.1; also elsewhere on the board
/Motor Control/CURRENT_M3A: U46.1; also elsewhere on the board
/Motor Control/CURRENT_M3B: U53.1; also elsewhere on the board
/Motor Control/EN_M1B: U73.5, U73.10, U103.2, U103.5, U103.12, U103.13; also elsewhere on the board
/Motor Control/EN_M2A: U74.5, U74.10, U104.2, U104.5, U104.12, U104.13; also elsewhere on the board
/Motor Control/EN_M2B: U75.5, U75.10, U105.2, U105.5, U105.12, U105.13; also elsewhere on the board
/Motor Control/EN_M3A: U76.5, U76.10, U106.2, U106.5, U106.12, U106.13; also elsewhere on the board
/Motor Control/EN_M3B: U77.5, U77.10, U107.2, U107.5, U107.12, U107.13; also elsewhere on the board
/Motor Control/F/~R_MA: U74.1, U74.2, U76.1, U76.2, U104.1, U106.1; also elsewhere on the board
/Motor Control/F/~R_MB: U73.1, U73.2, U75.1, U75.2, U77.1, U77.2, U103.1, U105.1, U107.1; also elsewhere on the board
/Motor Control/H-bridge #2/IN1: U17.3 (IN1), U103.8
/Motor Control/H-bridge #2/IN2: U17.2 (IN2), U73.11
/Motor Control/H-bridge #2/MOTOR+: J12.1, U17.6 (OUT1)
/Motor Control/H-bridge #2/MOTOR-: J12.2, U17.8 (OUT2)
/Motor Control/H-bridge #2/~ENABLE_MOTOR: U4.1, U4.7, U103.11
/Motor Control/H-bridge #2/~FORWARD/REVERSE: U73.3, U73.9
/Motor Control/H-bridge #3/IN1: U29.3 (IN1), U104.8
/Motor Control/H-bridge #3/IN2: U29.2 (IN2), U74.11
/Motor Control/H-bridge #3/MOTOR+: J15.1, U29.6 (OUT1)
/Motor Control/H-bridge #3/MOTOR-: J15.2, U29.8 (OUT2)
/Motor Control/H-bridge #3/~ENABLE_MOTOR: U8.1, U8.7, U104.11
/Motor Control/H-bridge #3/~FORWARD/REVERSE: U74.3, U74.9
/Motor Control/H-bridge #4/IN1: U37.3 (IN1), U105.8
/Motor Control/H-bridge #4/IN2: U37.2 (IN2), U75.11
/Motor Control/H-bridge #4/MOTOR+: J19.1, U37.6 (OUT1)
/Motor Control/H-bridge #4/MOTOR-: J19.2, U37.8 (OUT2)
/Motor Control/H-bridge #4/~ENABLE_MOTOR: U9.1, U9.7, U105.11
/Motor Control/H-bridge #4/~FORWARD/REVERSE: U75.3, U75.9
/Motor Control/H-bridge #5/IN1: U45.3 (IN1), U106.8
/Motor Control/H-bridge #5/IN2: U45.2 (IN2), U76.11
/Motor Control/H-bridge #5/MOTOR+: J20.1, U45.6 (OUT1)
/Motor Control/H-bridge #5/MOTOR-: J20.2, U45.8 (OUT2)
/Motor Control/H-bridge #5/~ENABLE_MOTOR: U19.1, U19.7, U106.11
/Motor Control/H-bridge #5/~FORWARD/REVERSE: U76.3, U76.9
/Motor Control/H-bridge #6/IN1: U52.3 (IN1), U107.8
/Motor Control/H-bridge #6/IN2: U52.2 (IN2), U77.11
/Motor Control/H-bridge #6/MOTOR+: J21.1, U52.6 (OUT1)
/Motor Control/H-bridge #6/MOTOR-: J21.2, U52.8 (OUT2)
/Motor Control/H-bridge #6/~ENABLE_MOTOR: U25.1, U25.7, U107.11
/Motor Control/H-bridge #6/~FORWARD/REVERSE: U77.3, U77.9
/Motor Control/VREF_M1B: C27.1, U17.4 (VREF); also elsewhere on the board
/Motor Control/VREF_M2A: C53.1, U29.4 (VREF); also elsewhere on the board
/Motor Control/VREF_M2B: C74.1, U37.4 (VREF); also elsewhere on the board
/Motor Control/VREF_M3A: C87.1, U45.4 (VREF); also elsewhere on the board
/Motor Control/VREF_M3B: C100.1, U52.4 (VREF); also elsewhere on the board
GND: C20.2, C23.2, C24.2, C27.2, C28.2, C29.2, C30.2, C43.2, C44.2, C46.2, C49.2, C50.2, C53.2, C54.2, C55.2, C61.2, C62.2, C64.2, C68.2, C71.2, C72.2, C74.2, C75.2, C76.2, C77.2, C78.2, C79.2, C81.2, C84.2, C85.2, C87.2, C88.2, C89.2, C90.2, C91.2, C92.2, C94.2, C97.2, C98.2, C100.2, C101.2, C102.2, C103.2, C104.2, C105.2, C109.2, C110.2, C111.2, C112.2, C113.2, C115.2, C116.2, C117.2, C118.2, C119.2, C141.2, C142.2, C144.2, C145.2, C147.2, C148.2, C150.2, C151.2, C153.2, C154.2, J12.4, J15.4, J19.4, J20.4, J21.4, R3.1, R10.1, R20.1, R27.1, R30.1, U4.4 (GND), U8.4 (GND), U9.4 (GND), U17.1 (GND), U17.9 (GND), U18.2 (GND), U18.4 (-), U19.4 (GND), U25.4 (GND), U29.1 (GND), U29.9 (GND), U30.2 (GND), U30.4 (-), U37.1 (GND), U37.9 (GND), U39.2 (GND), U39.4 (-), U45.1 (GND), U45.9 (GND), U46.2 (GND), U46.4 (-), U52.1 (GND), U52.9 (GND), U53.2 (GND), U53.4 (-), U54.3 (GND), U55.3 (GND), U56.3 (GND), U57.3 (GND), U58.3 (GND), U60.3 (GND), U61.3 (GND), U62.3 (GND), U63.3 (GND), U64.3 (GND), U73.7 (GND), U74.7 (GND), U75.7 (GND), U76.7 (GND), U77.7 (GND), U103.7 (GND), U104.7 (GND), U105.7 (GND), U106.7 (GND), U107.7 (GND); also elsewhere on the board
unnamed: C23.1, R1.1, U54.2
unnamed: C24.1, R2.1, U60.2
unnamed: C49.1, R4.1, U55.2
unnamed: C50.1, R9.1, U61.2
unnamed: C71.1, R18.1, U56.2
unnamed: C72.1, R19.1, U62.2
unnamed: C84.1, R21.1, U57.2
unnamed: C85.1, R22.1, U63.2
unnamed: C97.1, R28.1, U58.2
unnamed: C98.1, R29.1, U64.2
unnamed: U4.2, U54.4
unnamed: U4.5, U60.4
unnamed: R3.2, U17.7 (ISEN), U18.3 (+)
unnamed: C43.1, L2.2, U18.5 (V+)
unnamed: U19.2, U57.4
unnamed: U19.5, U63.4
unnamed: U25.2, U58.4
unnamed: U25.5, U64.4
unnamed: R10.2, U29.7 (ISEN), U30.3 (+)
unnamed: C62.1, L3.2, U30.5 (V+)
unnamed: R20.2, U37.7 (ISEN), U39.3 (+)
unnamed: C78.1, L5.2, U39.5 (V+)
unnamed: R27.2, U45.7 (ISEN), U46.3 (+)
unnamed: C91.1, L6.2, U46.5 (V+)
unnamed: R30.2, U52.7 (ISEN), U53.3 (+)
unnamed: C104.1, L7.2, U53.5 (V+)
unnamed: U8.2, U55.4
unnamed: U9.2, U56.4
unnamed: U8.5, U61.4
unnamed: U9.5, U62.4
unnamed: U73.6, U73.12
unnamed: U73.8, U73.13
unnamed: U74.6, U74.12
unnamed: U74.8, U74.13
unnamed: U75.6, U75.12
unnamed: U75.8, U75.13
unnamed: U76.6, U76.12
unnamed: U76.8, U76.13
unnamed: U77.6, U77.12
unnamed: U77.8, U77.13
unnamed: U103.3, U103.9
unnamed: U103.6, U103.10
unnamed: U104.3, U104.9
unnamed: U104.6, U104.10
unnamed: U105.3, U105.9
unnamed: U105.6, U105.10
unnamed: U106.3, U106.9
unnamed: U106.6, U106.10
unnamed: U107.3, U107.9
unnamed: U107.6, U107.10
VCC: C20.1, C46.1, C68.1, C81.1, C94.1, C109.1, C110.1, C111.1, C112.1, C113.1, C115.1, C116.1, C117.1, C118.1, C119.1, C141.1, C142.1, C144.1, C145.1, C147.1, C148.1, C150.1, C151.1, C153.1, C154.1, J12.3, J15.3, J19.3, J20.3, J21.3, U4.8 (VCC), U8.8 (VCC), U9.8 (VCC), U19.8 (VCC), U25.8 (VCC), U54.5 (VCC), U55.5 (VCC), U56.5 (VCC), U57.5 (VCC), U58.5 (VCC), U60.5 (VCC), U61.5 (VCC), U62.5 (VCC), U63.5 (VCC), U64.5 (VCC), U73.14 (VCC), U74.14 (VCC), U75.14 (VCC), U76.14 (VCC), U77.14 (VCC), U103.14 (VCC), U104.14 (VCC), U105.14 (VCC), U106.14 (VCC), U107.14 (VCC); also elsewhere on the board

Notes on the sheet:
<- Brake Forward ->
RISEN
H-bridge control logic
ENCODER+
IN2
Input square wave max frequency = 3 kHz (typical hall efect encoder frequency at max motor speed with no load) Low pass filter -3dB Cutoff Frequency: 1,6 MHz
IN1
Current measurement amplifier 20 V/V Gain
ENCODER-
NOT
Encoder inputs low pass filtering
I_trip = VREF/(10*RISEN)
<- Drive Reverse ->
<- Drive Forward ->
A - FORWARD/~{REVERSE} B - ENABLE_MOTOR C - PWM
H-bridge
<- Brake Reverse ->

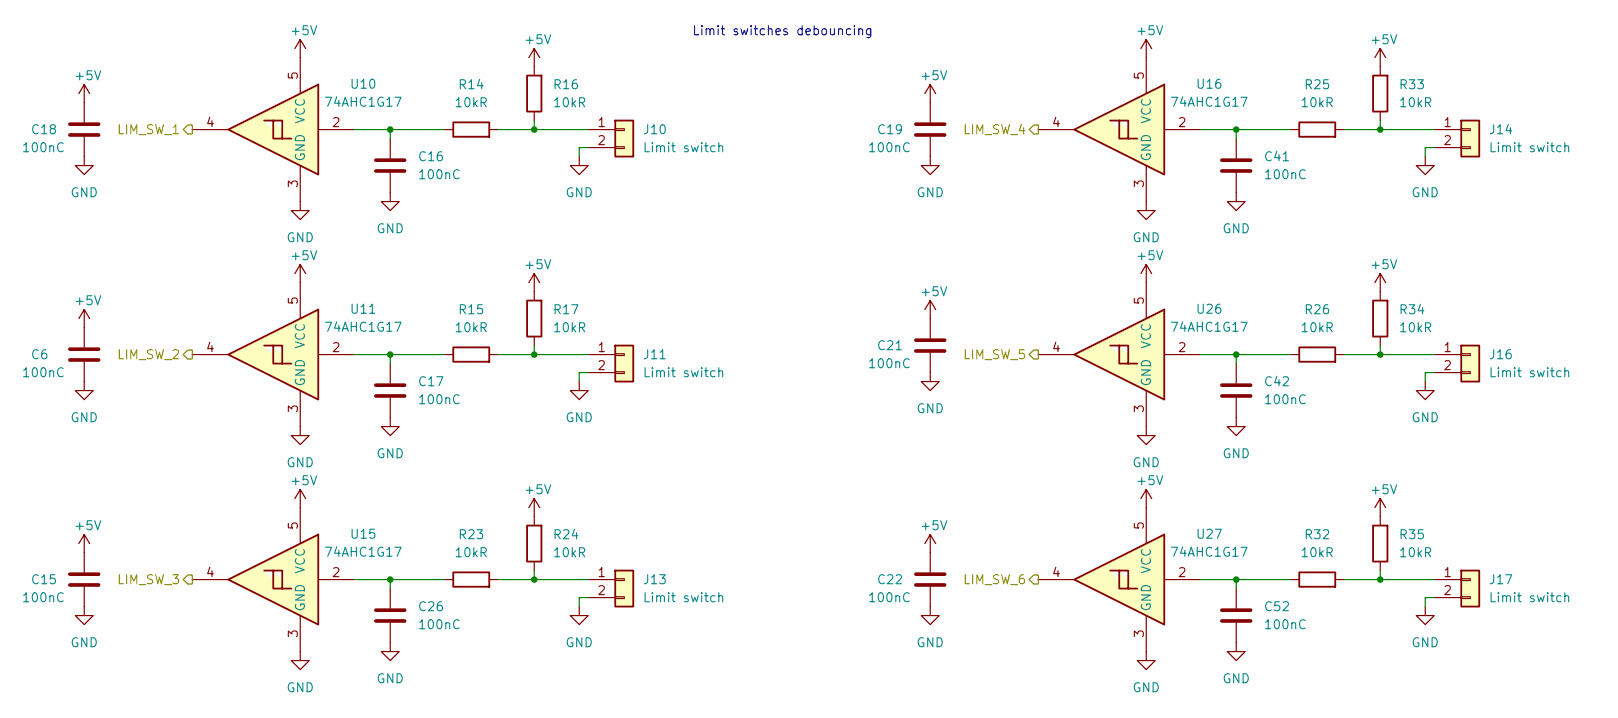
[picture p136: schematic lim_sw.kicad_sch]

Parts:
C6, C15, C16, C17, C18, C19, C21, C22, C26, C41, C42, C52: 100nC; C_0805_2012Metric
J10, J11, J13, J14, J16, J17: Limit switch; JST_PH_B2B-PH-K_1x02_P2.00mm_Vertical; MPN B2B-PH-K-S(LF)(SN)
R14, R15, R16, R17, R23, R24, R25, R26, R32, R33, R34, R35: 10kR; R_0805_2012Metric; MPN RC0805JR-0710KL
U10, U11, U15, U16, U26, U27: 74AHC1G17; SC-74A-5_1.55x2.9mm_P0.95mm; MPN 74AHC1G17GVH

Connections:
+5V: C6.1, C15.1, C18.1, C19.1, C21.1, C22.1, R16.2, R17.2, R24.2, R33.2, R34.2, R35.2, U10.5 (VCC), U11.5 (VCC), U15.5 (VCC), U16.5 (VCC), U26.5 (VCC), U27.5 (VCC); also elsewhere on the board
/Motor Control/LIM_SW00: U10.4; also elsewhere on the board
/Motor Control/LIM_SW01: U11.4; also elsewhere on the board
/Motor Control/LIM_SW02: U15.4; also elsewhere on the board
/Motor Control/LIM_SW03: U16.4; also elsewhere on the board
/Motor Control/LIM_SW04: U26.4; also elsewhere on the board
/Motor Control/LIM_SW05: U27.4; also elsewhere on the board
GND: C6.2, C15.2, C16.2, C17.2, C18.2, C19.2, C21.2, C22.2, C26.2, C41.2, C42.2, C52.2, J10.2, J11.2, J13.2, J14.2, J16.2, J17.2, U10.3 (GND), U11.3 (GND), U15.3 (GND), U16.3 (GND), U26.3 (GND), U27.3 (GND); also elsewhere on the board
unnamed: C16.1, R14.1, U10.2
unnamed: C17.1, R15.1, U11.2
unnamed: C26.1, R23.1, U15.2
unnamed: C41.1, R25.1, U16.2
unnamed: C42.1, R26.1, U26.2
unnamed: C52.1, R32.1, U27.2
unnamed: J10.1, R14.2, R16.1
unnamed: J11.1, R15.2, R17.1
unnamed: J13.1, R23.2, R24.1
unnamed: J14.1, R25.2, R33.1
unnamed: J16.1, R26.2, R34.1
unnamed: J17.1, R32.2, R35.1

Notes on the sheet:
Limit switches debouncing

Board: 2 copper layers, 279 parts (0 on the bottom side), 236 nets, no tracks yet.

Other parts of the board:
MH1, MH2, MH3, MH4, MH5, MH6: MountingHole_3.2mm
kibuzzard-68938B3A: G***; kibuzzard-68938B3A
kibuzzard-68938B4A: G***; kibuzzard-68938B4A
kibuzzard-68938B20: G***; kibuzzard-68938B20
kibuzzard-68938B29: G***; kibuzzard-68938B29
kibuzzard-68938B31: G***; kibuzzard-68938B31
kibuzzard-68938B43: G***; kibuzzard-68938B43
