nunosousa/TelescopeMirrorTester/ECAD/BDCMotorControlBoard/BDCMotorControlBoard.kicad_pcb

## KiCad design ECAD/BDCMotorControlBoard/BDCMotorControlBoard.kicad_pcb (2025-06-22)

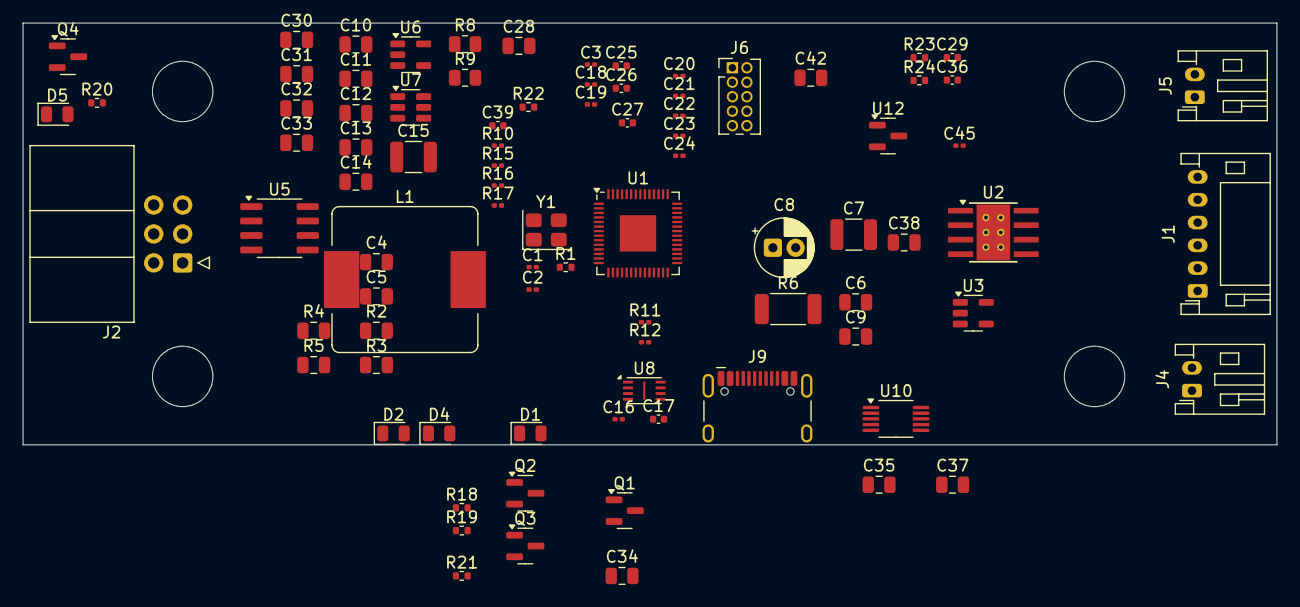
[picture p137: board BDCMotorControlBoard.kicad_pcb from above]

Board: 4 copper layers, 110.0 x 37.0 mm, 91 parts (0 on the bottom side), 51 nets, no tracks yet.

Parts:
C1, C2: 15pC; C_0201_0603Metric
C3, C16, C18, C19, C20, C21, C22, C23, C24, C45: 100nC; C_0201_0603Metric
C4, C5, C6, C9, C10, C13, C30, C32, C34, C35, C38, C42: 100nC; C_0805_2012Metric
C7: 10uC; C_1210_3225Metric
C8: 47uC; CP_Radial_D5.0mm_P2.00mm
C11, C12, C28, C31, C33, C37: 10uC; C_0805_2012Metric
C14: C; C_0805_2012Metric
C15: C; C_1210_3225Metric
C17, C25, C26, C27: 2u2C; C_0402_1005Metric
C29, C36, C39: 100pC; C_0402_1005Metric
D1, D2, D4, D5: LED; LED_0805_2012Metric
H1, H2, H3, H4: MountingHole; MountingHole_5.3mm_M5
J1: Motor Connector; JST_PH_S6B-PH-K_1x06_P2.00mm_Horizontal
J2: RS485 PCB; IDC-Header_2x03_P2.54mm_Horizontal
J4, J5: Limit switch; JST_PH_S2B-PH-K_1x02_P2.00mm_Horizontal
J6: Conn_ARM_JTAG_SWD_10; PinHeader_2x05_P1.27mm_Vertical
J9: USB_C_Receptacle_USB2.0_16P; USB_C_Receptacle_HCTL_HC-TYPE-C-16P-01A
L1: L; L_TaiTech_TMPC1265_13.5x12.5mm
Q1, Q2, Q3, Q4: BC847; SOT-23
R1, R22, R23, R24: 1kR; R_0402_1005Metric
R2, R3, R4, R5: 10kR; C_0805_2012Metric
R6: R; R_2010_5025Metric
R8, R9: R; R_0805_2012Metric
R10, R15, R16, R17: 100R; R_0201_0603Metric
R11, R12: 27R; R_0201_0603Metric
R18, R19, R20, R21: 5k1R; R_0402_1005Metric
U1: RP2040; QFN-56-1EP_7x7mm_P0.4mm_EP3.2x3.2mm
U2: DRV8870DDA; Texas_HTSOP-8-1EP_3.9x4.9mm_P1.27mm_EP2.95x4.9mm_Mask2.4x3.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
U3: INA180A1; SOT-23-5
U5: SP3485EN; SOIC-8_3.9x4.9mm_P1.27mm
U6: TLV75533PDBV; SOT-23-5
U7: TPS54202DDC; SOT-23-6
U8: W25Q16JVUXIQ; Winbond_USON-8-1EP_3x2mm_P0.5mm_EP0.2x1.6mm
U10: PGA112; VSSOP-10_3x3mm_P0.5mm
U12: REF3033; SOT-23
Y1: ABM8-272-T3; Crystal_SMD_3225-4Pin_3.2x2.5mm

Connections:
+1V1: C3.1, C19.1, C25.1, U1.23 (DVDD), U1.45 (VREG_VOUT), U1.50 (DVDD)
+3.3V: C16.1, C17.1, C18.1, C20.1, C21.1, C22.1, C23.1, C24.1, C26.1, C28.1, C34.1, C35.1, C37.1, C45.1, J1.3, J6.1 (VTref), R3.2, R5.2, R10.1, R15.1, R16.1, R17.1, U1.1 (IOVDD), U1.10 (IOVDD), U1.22 (IOVDD), U1.33 (IOVDD), U1.42 (IOVDD), U1.44 (VREG_IN), U1.48 (USB_VDD), U1.49 (IOVDD), U5.8 (VCC), U6.5 (OUT), U8.8 (VCC)
+3.3VA: C9.1, C27.1, C38.1, C42.1, U1.43 (ADC_AVDD), U2.4 (VREF), U3.5 (V+), U10.1 (AV_{DD}), U10.3 (CH0/V_{CAL}), U10.10 (DV_{DD}), U12.2 (OUT)
+12V: C6.1, C7.1, C8.1, C10.1, C11.1, C12.1, J2.5, J2.6, U2.5 (VM), U7.3 (VIN), U7.5 (EN)
/MCU/GPIO26_ADC0: C39.1, R22.1, U1.38 (GPIO26_ADC0)
/MCU/MOTOR_A_SENSE: R22.2, U10.5 (V_{OUT})
/MCU/MOTOR_LIM1: C4.1, R2.1
/MCU/MOTOR_LIM2: C5.1, R4.1
/MCU/QSPI_SCLK: U1.52 (QSPI_SCLK), U8.6 (CLK)
/MCU/QSPI_SD0: U1.53 (QSPI_SD0), U8.5 (DI/IO_{0})
/MCU/QSPI_SD1: U1.55 (QSPI_SD1), U8.2 (DO/IO_{1})
/MCU/QSPI_SD2: U1.54 (QSPI_SD2), U8.3 (~WP/IO_{2})
/MCU/QSPI_SD3: U1.51 (QSPI_SD3), U8.7 (~HOLD/~RESET/IO_{3})
/MCU/QSPI_SS: U1.56 (QSPI_SS), U8.1 (~CS)
/MCU/RUN: J6.10 (~RESET), U1.26 (RUN)
/MCU/SWCLK: J6.4 (SWCLK/TCK), U1.24 (SWCLK)
/MCU/SWD: J6.2 (SWDIO/TMS), U1.25 (SWD)
/MCU/USB_D+: R12.2, U1.47 (USB_DP)
/MCU/USB_D-: R11.2, U1.46 (USB_DM)
/MCU/XIN: C1.2, U1.20 (XIN), Y1.1
/MCU/XOUT: R1.2, U1.21 (XOUT)
/Motor Control/A_SENSE_BASE: U3.1, U10.2 (CH1)
/Motor Control/ENCODER_A: C29.1, J1.5, R23.1, R23.2
/Motor Control/ENCODER_B: C36.1, J1.6, R24.1, R24.2
/Motor Control/MOTOR+: J1.1, U2.6 (OUT1)
/Motor Control/MOTOR-: J1.2, U2.8 (OUT2)
/RS485/RS485_N: J2.2, U5.7 (B)
/RS485/RS485_P: J2.1, U5.6 (A)
GND: C1.1, C2.1, C3.2, C4.2, C5.2, C6.2, C7.2, C8.2, C9.2, C10.2, C11.2, C12.2, C15.2, C16.2, C17.2, C18.2, C19.2, C20.2, C21.2, C22.2, C23.2, C24.2, C25.2, C26.2, C27.2, C28.2, C29.2, C30.2, C31.2, C32.2, C33.2, C34.2, C35.2, C36.2, C37.2, C38.2, C39.2, C42.2, C45.2, J1.4, J2.3, J2.4, J4.2, J5.2, J6.3 (GND), J6.5 (GND), J6.9 (GNDDetect), J9.A1 (GND), J9.A12 (GND), J9.B1 (GND), J9.B12 (GND), J9.S1 (SHIELD), Q1.2 (E), Q2.2 (E), Q3.2 (E), Q4.2 (E), R6.2, R8.2, U1.19 (TESTEN), U1.57 (GND), U2.1 (GND), U2.9 (GND), U3.2 (GND), U3.4 (-), U5.5 (GND), U6.2 (GND), U7.1 (GND), U8.4 (GND), U10.4 (V_{REF}), U10.6 (GND), U12.3 (GND), Y1.2, Y1.4
unnamed: C2.2, R1.1, Y1.3
unnamed: D1.2 (A), R15.2
unnamed: D1.1 (K), Q3.3 (C)
unnamed: D2.2 (A), R16.2
unnamed: D2.1 (K), Q2.3 (C)
unnamed: D4.2 (A), R17.2
unnamed: D4.1 (K), Q1.3 (C)
unnamed: D5.2 (A), R10.2
unnamed: D5.1 (K), Q4.3 (C)
unnamed: J4.1, R2.2, R3.1
unnamed: J5.1, R4.2, R5.1
unnamed: J9.A6 (D+), J9.B6 (D+), R12.1
unnamed: J9.A7 (D-), J9.B7 (D-), R11.1
unnamed: Q1.1 (B), R18.1
unnamed: Q2.1 (B), R19.1
unnamed: Q3.1 (B), R21.1
unnamed: Q4.1 (B), R20.1
unnamed: R6.1, U2.7 (ISEN), U3.3 (+)
unnamed: C13.1, U7.6 (BOOT)
unnamed: C14.2, R8.1, R9.2, U7.4 (FB)
unnamed: C13.2, L1.1, U7.2 (SW)
unnamed: C14.1, C15.1, C30.1, C31.1, C32.1, C33.1, L1.2, R9.1, U6.1 (IN), U6.3 (EN), U12.1 (IN)
