nunosousa/TelescopeMirrorTester/ECAD/LimitSwitchBoard/LimitSwitchBoard.kicad_pcb

## KiCad design ECAD/LimitSwitchBoard/LimitSwitchBoard.kicad_pcb (2025-04-19)

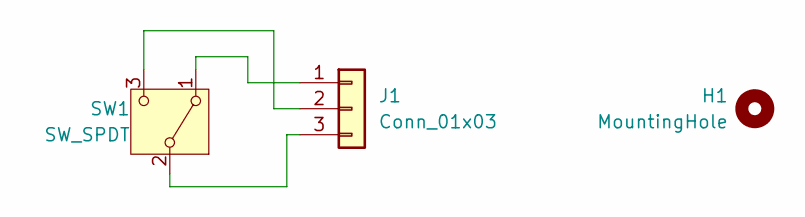
[picture p138: schematic LimitSwitchBoard.kicad_sch]

Parts:
H1: MountingHole; MountingHole_5.3mm_M5
J1: Conn_01x03; PinSocket_1x03_P2.00mm_Vertical
SW1: SW_SPDT; SS075Q102F035V2A

Connections:
unnamed: J1.1, SW1.1 (A)
unnamed: J1.2, SW1.3 (C)
unnamed: J1.3, SW1.2 (B)

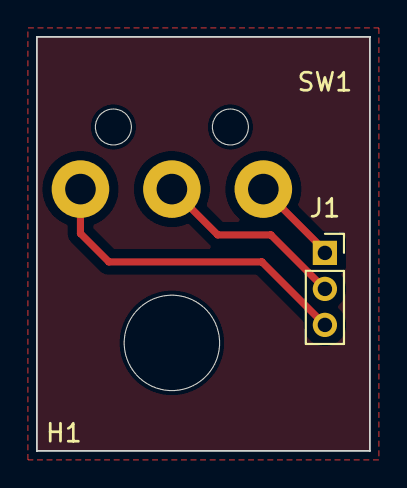
[picture p139: board LimitSwitchBoard.kicad_pcb from above]

Board: 2 copper layers, 18.5 x 23.0 mm, 3 parts (0 on the bottom side), 3 nets.
