nunosousa/TelescopeMirrorTester/ECAD/DataShield_single_RS232/DataShield.kicad_pcb

## KiCad design ECAD/DataShield_single_RS232/DataShield.kicad_pcb (2024-07-16)

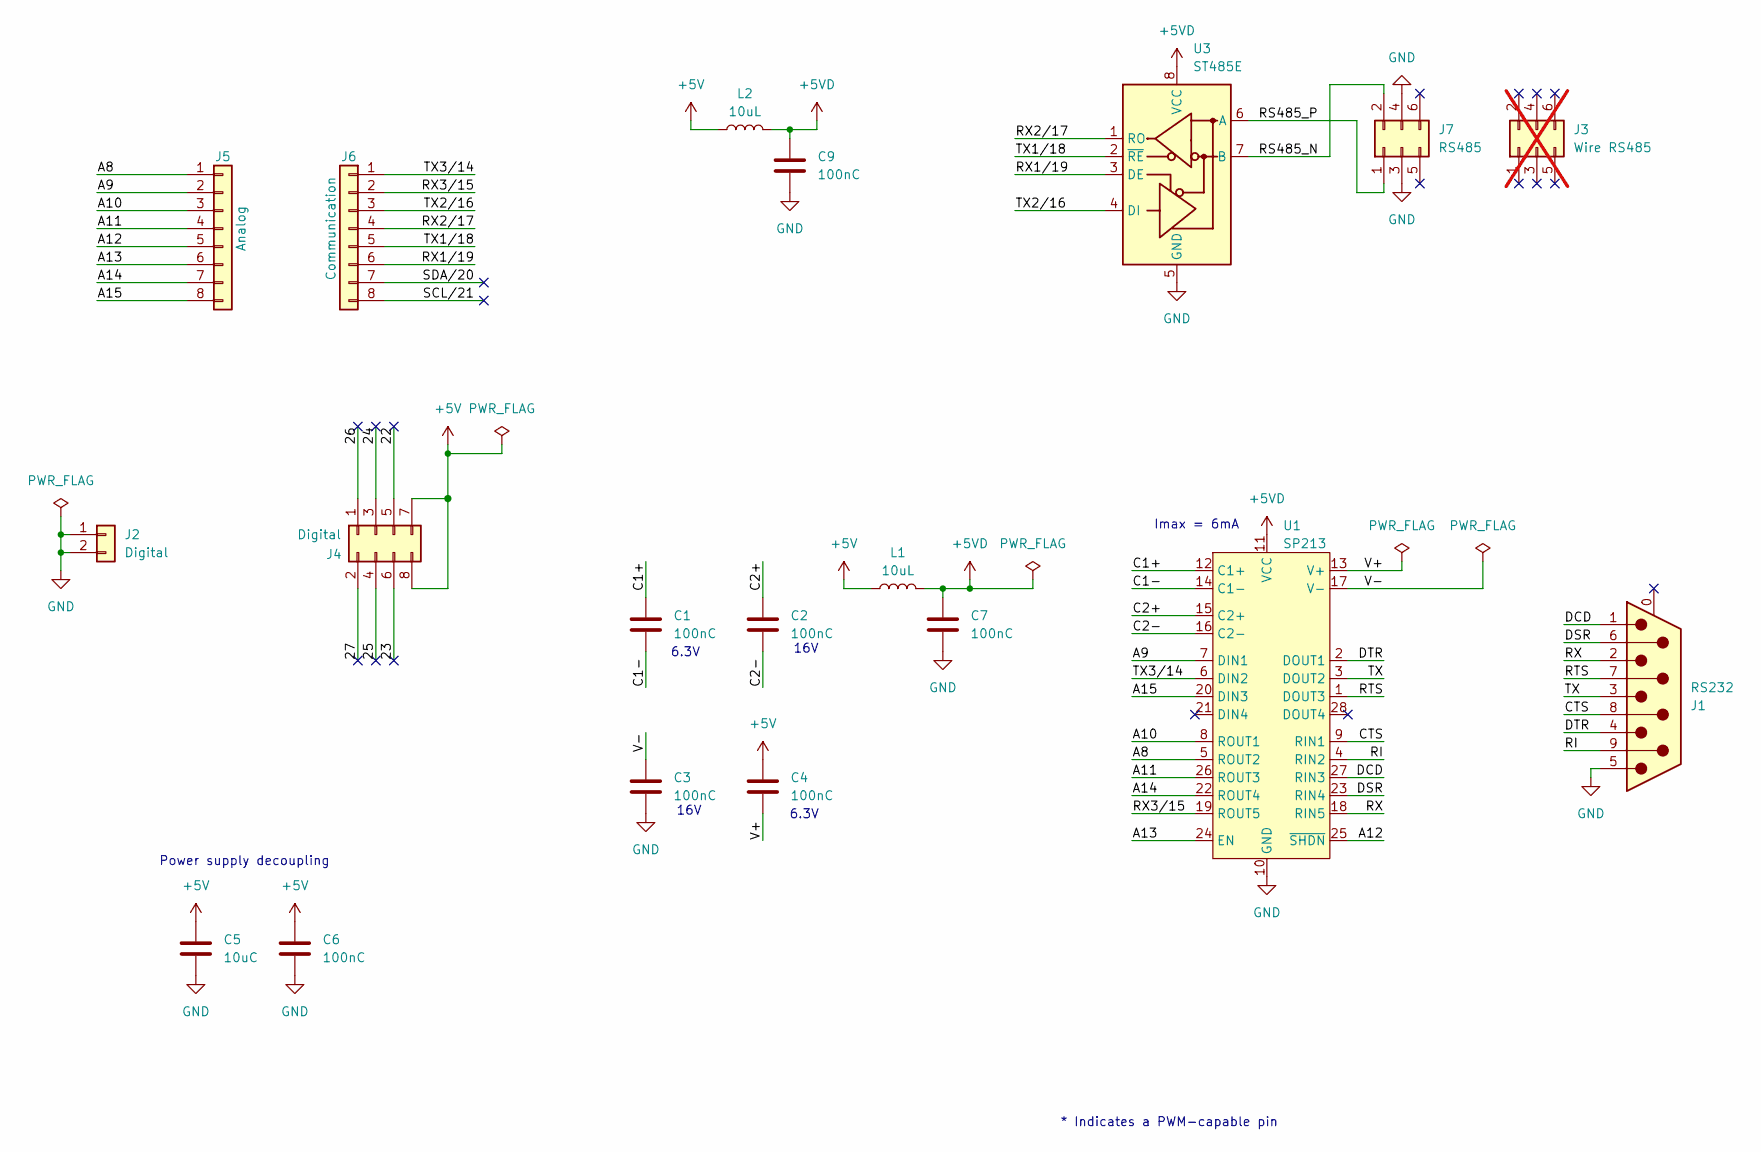
[picture p140: schematic DataShield.kicad_sch]

Parts:
C1, C2, C3, C4, C6, C7, C9: 100nC; C_0805_2012Metric; MPN C0805F104K5RACAUTO
C5: 10uC; C_1206_3216Metric; MPN CL31B106KOHNNNE
J1: RS232; DSUB-9_Male_Horizontal_P2.77x2.84mm_EdgePinOffset4.94mm_Hou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; MPN DT10121-M5W3-4F
J2: Digital; PinSocket_1x02_P2.54mm_Vertical; MPN PM254-1-02-Z-8.5
J3: Wire RS485; IDC-Header_2x03_P2.54mm_Vertical; MPN I254-2*3-G-3-B; not fitted
J4: Digital; PinSocket_2x04_P2.54mm_Vertical; MPN PM254-2-04-Z-8.5
J5: Analog; PinSocket_1x08_P2.54mm_Vertical; MPN PZ254-1-08-Z-8.5
J6: Communication; PinSocket_1x08_P2.54mm_Vertical; MPN PZ254-1-08-Z-8.5
J7: RS485; IDC-Header_2x03_P2.54mm_Vertical; MPN HC-JN254-2-03-Z
L1, L2: 10uL; L_0805_2012Metric; MPN LQM21FN100M80L
U1: SP213; SSOP-28_5.3x10.2mm_P0.65mm; MPN SP213EEA-L/TR
U3: ST485E; SOIC-8_3.9x4.9mm_P1.27mm; MPN ST485EBDR

Connections:
+5V: C4.1, C5.1, C6.1, J4.7, J4.8, L1.1, L2.1
+5VD: C7.1, C9.1, L1.2, L2.2, U1.11 (VCC), U3.8 (VCC)
/22: J4.5
/23: J4.6
/24: J4.3
/25: J4.4
/26: J4.1
/27: J4.2
/A8: J5.1, U1.5 (ROUT2)
/A9: J5.2, U1.7 (DIN1)
/A10: J5.3, U1.8 (ROUT1)
/A11: J5.4, U1.26 (ROUT3)
/A12: J5.5, U1.25 (~SHDN)
/A13: J5.6, U1.24 (EN)
/A14: J5.7, U1.22 (ROUT4)
/A15: J5.8, U1.20 (DIN3)
/C1+: C1.1, U1.12 (C1+)
/C1-: C1.2, U1.14 (C1-)
/C2+: C2.1, U1.15 (C2+)
/C2-: C2.2, U1.16 (C2-)
/CTS: J1.8, U1.9 (RIN1)
/DCD: J1.1, U1.27 (RIN3)
/DSR: J1.6, U1.23 (RIN4)
/DTR: J1.4, U1.2 (DOUT1)
/RI: J1.9, U1.4 (RIN2)
/RS485_N: J7.2, U3.7 (B)
/RS485_P: J7.1, U3.6 (A)
/RTS: J1.7, U1.1 (DOUT3)
/RX: J1.2, U1.18 (RIN5)
/RX1/19: J6.6, U3.3 (DE)
/RX2/17: J6.4, U3.1 (RO)
/RX3/15: J6.2, U1.19 (ROUT5)
/SCL/21: J6.8
/SDA/20: J6.7
/TX: J1.3, U1.3 (DOUT2)
/TX1/18: J6.5, U3.2 (~RE)
/TX2/16: J6.3, U3.4 (DI)
/TX3/14: J6.1, U1.6 (DIN2)
/V+: C4.2, U1.13 (V+)
/V-: C3.1, U1.17 (V-)
GND: C3.2, C5.2, C6.2, C7.2, C9.2, J1.5, J2.1, J2.2, J7.3, J7.4, U1.10 (GND), U3.5 (GND)

Notes on the sheet:
6.3V
Power supply decoupling
16V
Imax = 6mA
* Indicates a PWM-capable pin
