nunosousa/TelescopeMirrorTester/ECAD/DataShield_single_RS232/DataShield.kicad_pcb

## KiCad design ECAD/DataShield_single_RS232/DataShield.kicad_pcb (continued)

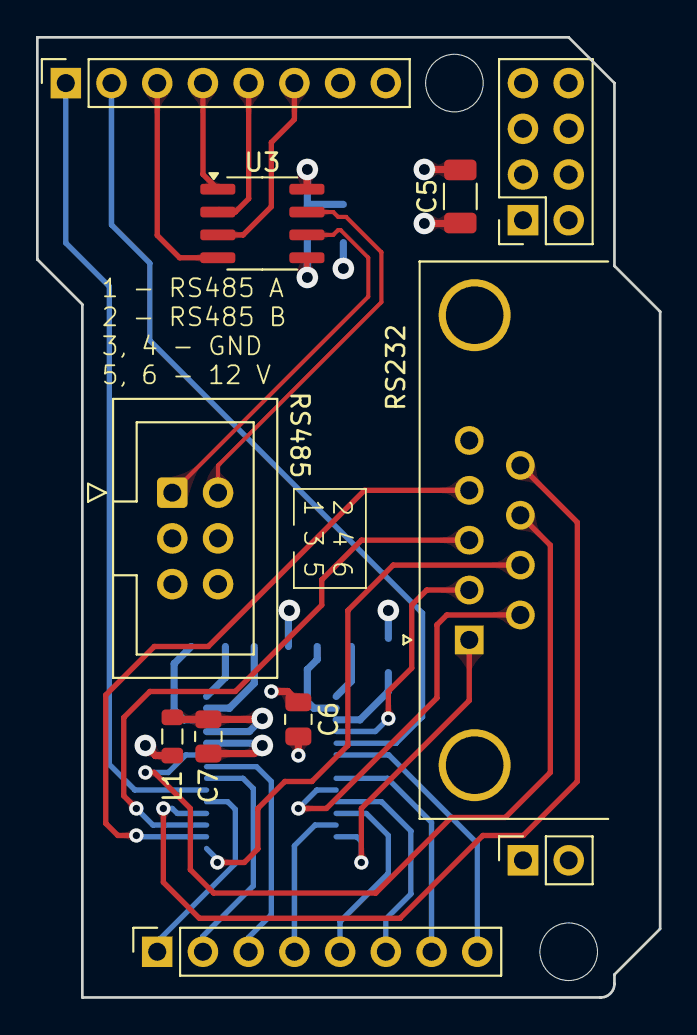
[picture p141: board ECAD/DataShield_single_RS232/DataShield.kicad_pcb from above]

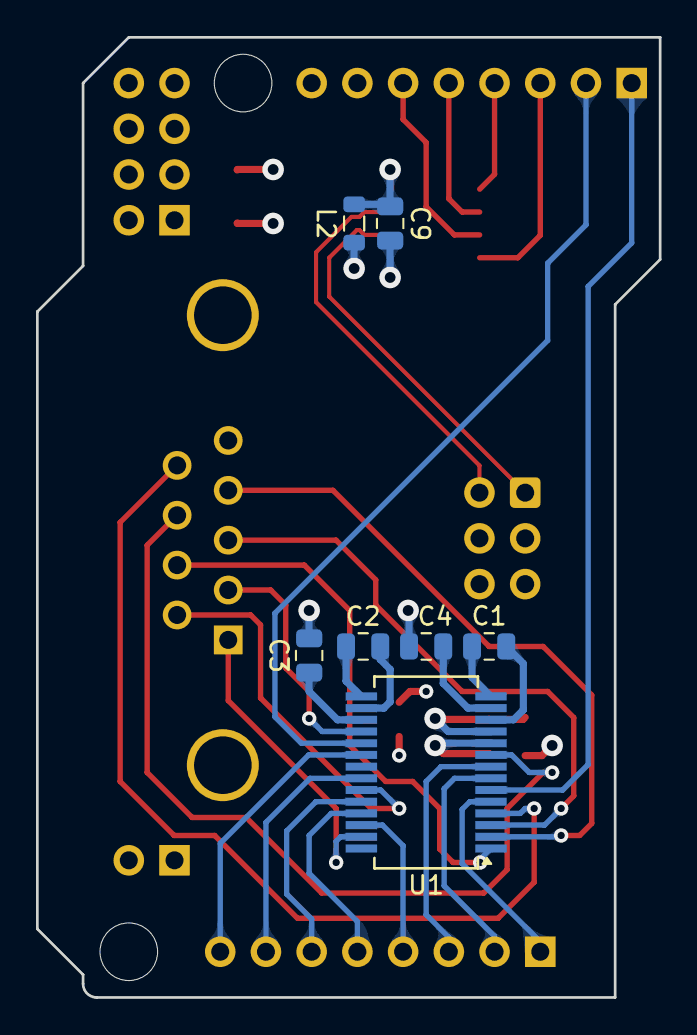
[picture p142: board ECAD/DataShield_single_RS232/DataShield.kicad_pcb from below]

Board: 4 copper layers, 34.6 x 53.3 mm, 20 parts (7 on the bottom side), 33 nets.

Other parts of the board:
MH5, MH6: MountingHole_3.2mm
