nunosousa/TelescopeMirrorTester/ECAD/RS232Board/RS232Board.kicad_pcb

## KiCad design ECAD/RS232Board/RS232Board.kicad_pcb (2024-09-14)

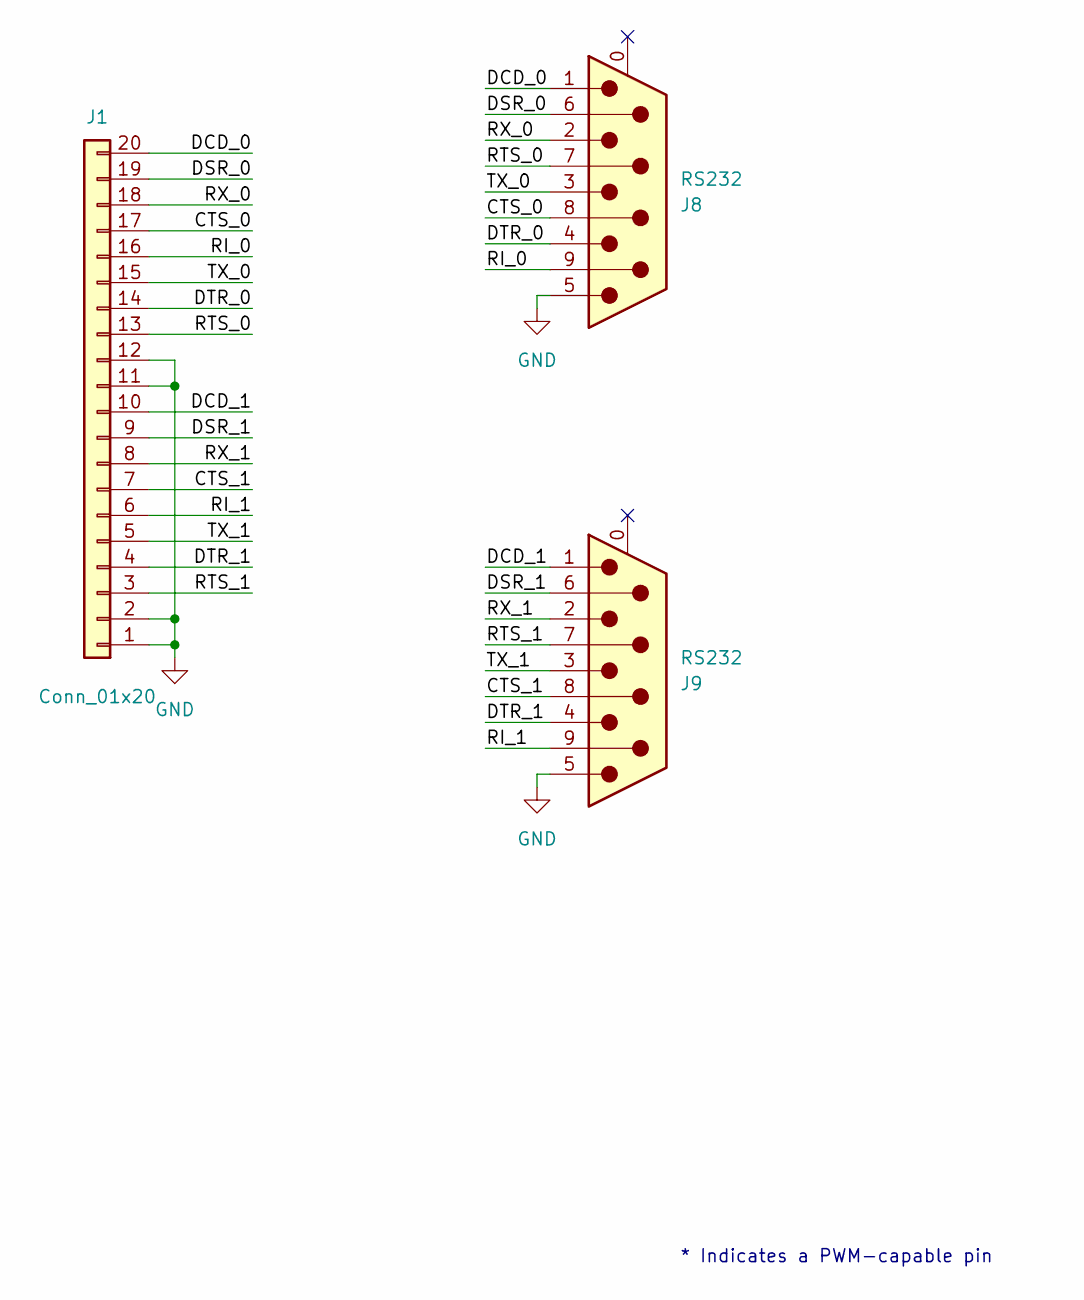
[picture p143: schematic RS232Board.kicad_sch]

Parts:
J1: Conn_01x20; TE_2-84952-0_1x20-1MP_P1.0mm_Horizontal; MPN CT10252-20R-00-D
J8, J9: RS232; DSUB-9_Male_Horizontal_P2.77x2.84mm_EdgePinOffset4.94mm_Hou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; MPN DT10121-M5W3-4F

Connections:
/CTS_0: J1.17, J8.8
/CTS_1: J1.7, J9.8
/DCD_0: J1.20, J8.1
/DCD_1: J1.10, J9.1
/DSR_0: J1.19, J8.6
/DSR_1: J1.9, J9.6
/DTR_0: J1.14, J8.4
/DTR_1: J1.4, J9.4
/RI_0: J1.16, J8.9
/RI_1: J1.6, J9.9
/RTS_0: J1.13, J8.7
/RTS_1: J1.3, J9.7
/RX_0: J1.18, J8.2
/RX_1: J1.8, J9.2
/TX_0: J1.15, J8.3
/TX_1: J1.5, J9.3
GND: J1.1, J1.2, J1.11, J1.12, J8.5, J9.5

Notes on the sheet:
* Indicates a PWM-capable pin

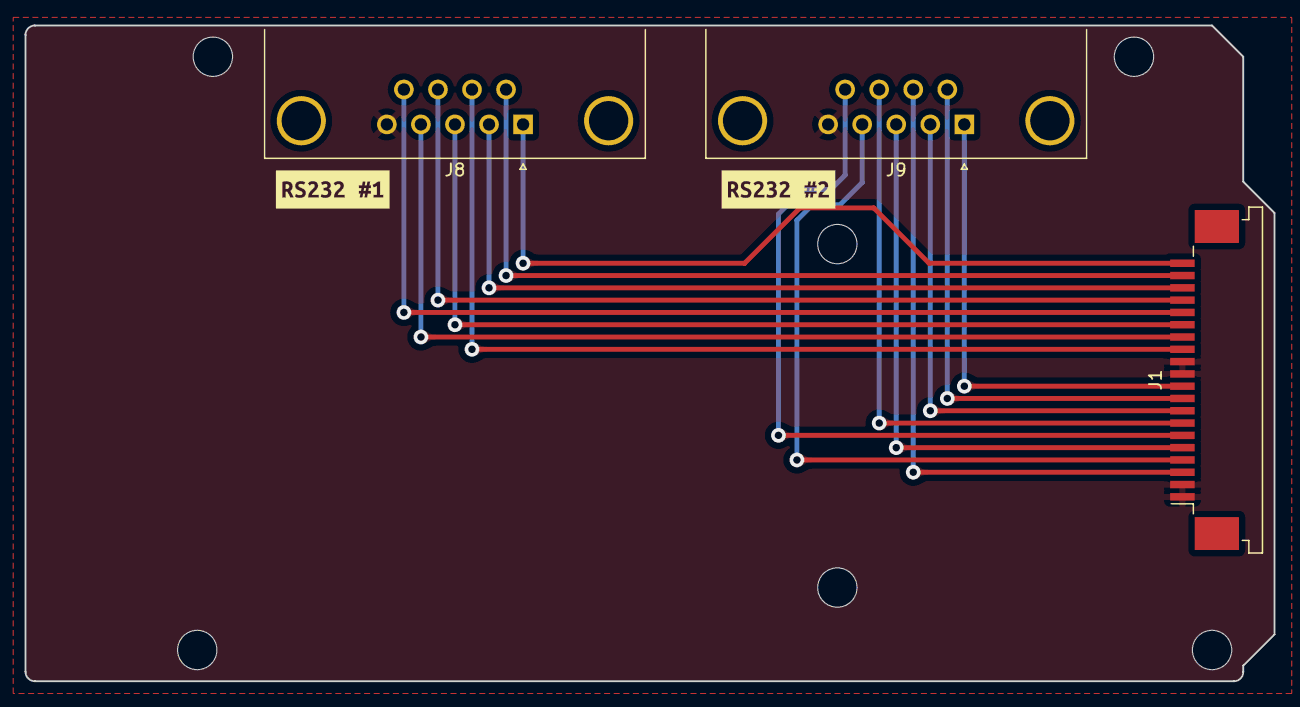
[picture p144: board RS232Board.kicad_pcb from above]

Board: 2 copper layers, 101.6 x 53.3 mm, 11 parts (0 on the bottom side), 17 nets.

Other parts of the board:
MH1, MH2, MH3, MH4, MH5, MH6: MountingHole_3.2mm
kibuzzard-66E5B9FC: G***; kibuzzard-66E5B9FC
kibuzzard-66E5BA0D: G***; kibuzzard-66E5BA0D
