nunosousa/TelescopeMirrorTester/ECAD/RS485Board/RS485Board.kicad_pcb

## KiCad design ECAD/RS485Board/RS485Board.kicad_pcb (2024-09-14)

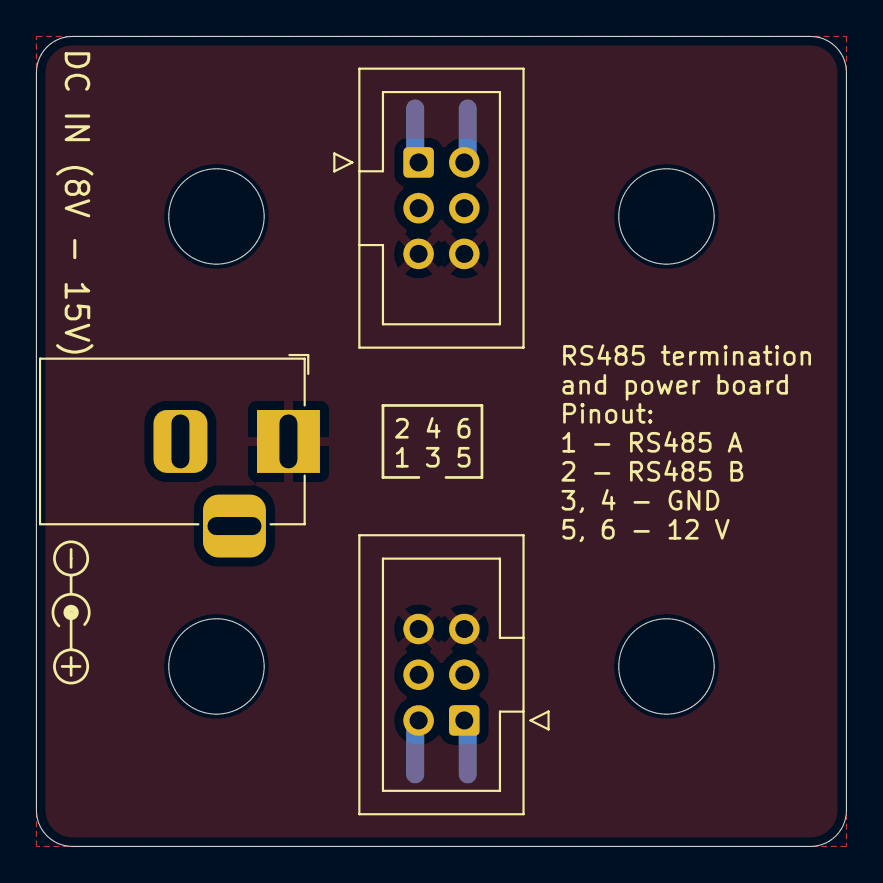
[picture p145: board RS485Board.kicad_pcb from above]

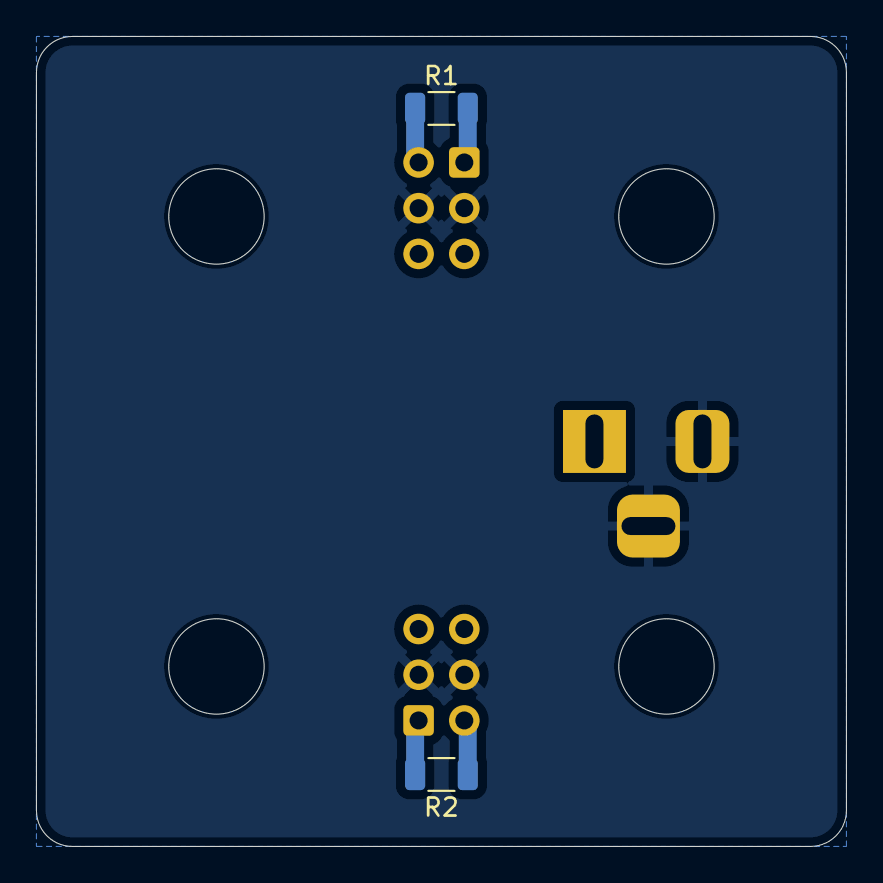
[picture p146: board RS485Board.kicad_pcb from below]

Board: 2 copper layers, 45.0 x 45.0 mm, 9 parts (2 on the bottom side), 6 nets.

Parts:
H1, H2, H3, H4: MountingHole; MountingHole_5.3mm_M5
J1, J2: RS485; IDC-Header_2x03_P2.54mm_Vertical
J3: Barrel_Jack_Switch; BarrelJack_Horizontal
R1, R2: 120R; R_1206_3216Metric

Connections:
+12V: J1.5, J1.6, J2.5, J2.6, J3.1
GND: J1.3, J1.4, J2.3, J2.4, J3.2, J3.3
unnamed: J1.1, R1.2
unnamed: J1.2, R1.1
unnamed: J2.1, R2.2
unnamed: J2.2, R2.1
