nunosousa/TelescopeMirrorTester/ECAD/RotationEncoder/RotationEncoder.kicad_pcb

## KiCad design ECAD/RotationEncoder/RotationEncoder.kicad_pcb (2024-09-14)

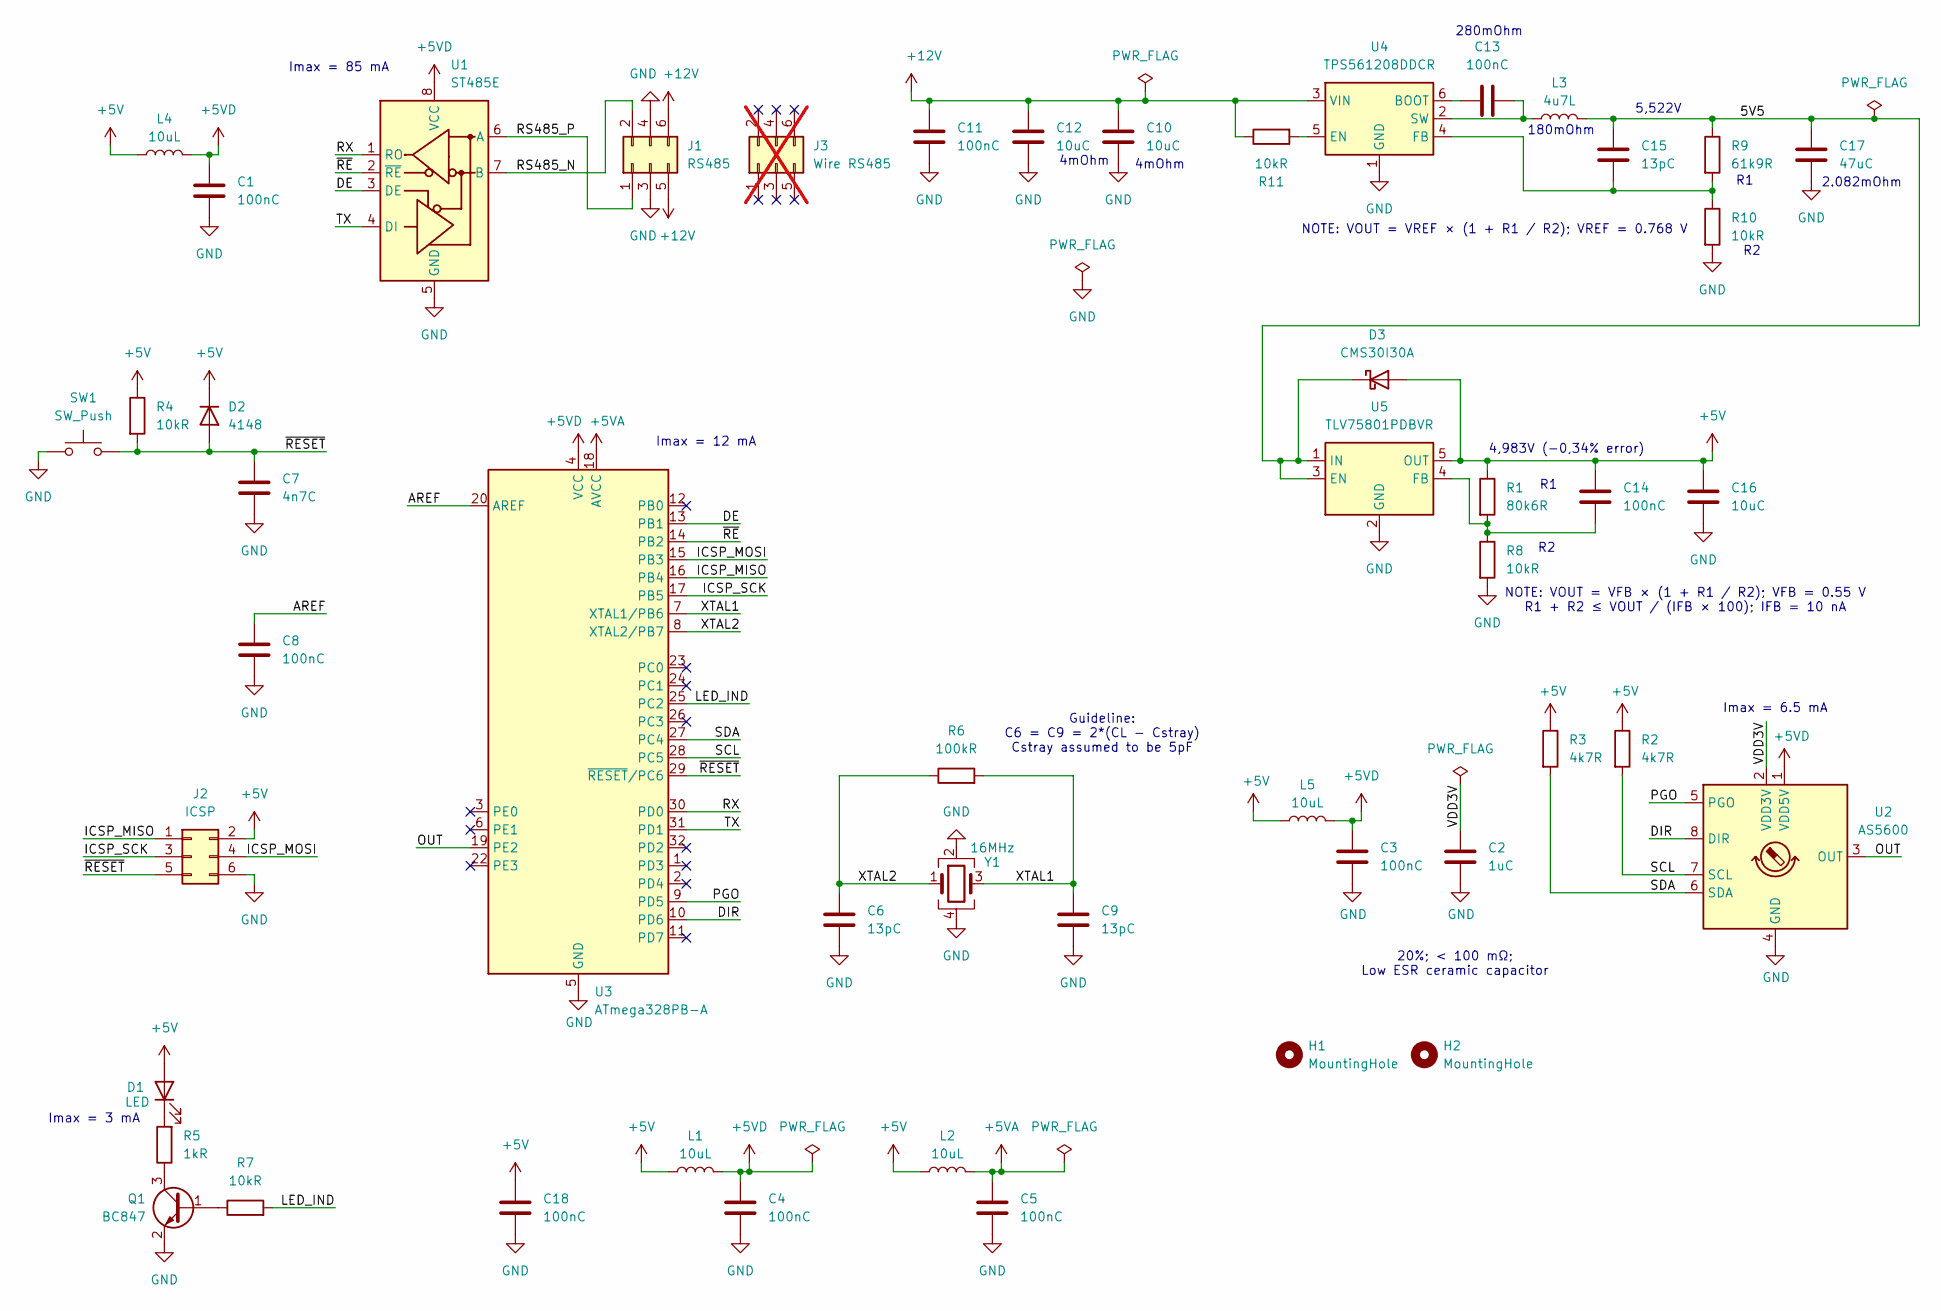
[picture p147: schematic RotationEncoder.kicad_sch]

Parts:
C1, C3, C4, C5, C8, C11, C13, C14, C18: 100nC; C_0805_2012Metric; MPN C0805F104K5RACAUTO
C2: 1uC; C_0805_2012Metric; MPN CL21B105KAFNNNE
C6, C9, C15: 13pC; C_0805_2012Metric; MPN 0805CG130J500NT
C7: 4n7C; C_0805_2012Metric; MPN CC0805JRX7R9BB472
C10, C12, C16: 10uC; C_0805_2012Metric; MPN GRM21BR61E106MA73L
C17: 47uC; C_1210_3225Metric; MPN GRM32ER61C476KE15L
D1: LED; LED_0805_2012Metric; MPN LTST-C171KGKT
D2: 4148; D_SOD-123; MPN MMSD4148T1G
D3: CMS30I30A; D_SOD-128; MPN CMS30I30A(TE12L,QM
H1, H2: MountingHole; MountingHole_3.2mm_M3
J1: RS485; IDC-Header_2x03_P2.54mm_Vertical; MPN HC-JN254-2-03-Z
J2: ICSP; PinHeader_2x03_P2.54mm_Vertical; MPN PZ254-2-03-Z-8.5
J3: Wire RS485; IDC-Header_2x03_P2.54mm_Vertical; MPN I254-2*3-G-3-B; not fitted
L1, L2, L4, L5: 10uL; L_0805_2012Metric; MPN LQM21FN100M80L
L3: 4u7L; L_1008_2520Metric; MPN LQM2HPN4R7MG0L
Q1: BC847; SOT-23; MPN BC847C,215
R1: 80k6R; R_0805_2012Metric; MPN RT0805BRD0780K6L
R2, R3: 4k7R; R_0805_2012Metric; MPN RC0805JR-074K7L
R4, R7, R11: 10kR; R_0805_2012Metric; MPN RC0805JR-0710KL
R5: 1kR; R_0805_2012Metric; MPN RC0805FR-071KL
R6: 100kR; R_0805_2012Metric; MPN RT0805BRD07100KL
R8, R10: 10kR; R_0805_2012Metric; MPN RT0805BRD0710KL
R9: 61k9R; R_0805_2012Metric; MPN PTFR0805B61K9P9
SW1: SW_Push; SW_Push_1P1T_XKB_TS-1187A; MPN TS-1187A-C-E-B
U1: ST485E; SOIC-8_3.9x4.9mm_P1.27mm; MPN ST485EBDR
U2: AS5600; SOIC-8_3.9x4.9mm_P1.27mm; MPN AS5600-ASOT
U3: ATmega328PB-A; TQFP-32_7x7mm_P0.8mm; MPN ATMEGA328PB-AU
U4: TPS561208DDCR; SOT-23-6; MPN TPS561208DDCR
U5: TLV75801PDBVR; SOT-23-5; MPN TLV75801PDBVR
Y1: 16MHz; Crystal_SMD_3225-4Pin_3.2x2.5mm; MPN X1E0000210119

Connections:
+5V: C14.1, C16.1, C18.1, D1.2 (A), D2.1 (K), D3.2 (A), J2.2, L1.1, L2.1, L4.1, L5.1, R1.1, R2.1, R3.1, R4.1, U5.5 (OUT)
+5VA: C5.1, L2.2, U3.18 (AVCC)
+5VD: C1.1, C3.1, C4.1, L1.2, L4.2, L5.2, U1.8 (VCC), U2.1 (VDD5V), U3.4 (VCC)
+12V: C10.1, C11.2, C12.1, J1.5, J1.6, R11.1, U4.3 (VIN)
/5V5: C15.1, C17.1, D3.1 (K), L3.2, R9.1, U5.1 (IN), U5.3 (EN)
/AREF: C8.1, U3.20 (AREF)
/DE: U1.3 (DE), U3.13 (PB1)
/DIR: U2.8 (DIR), U3.10 (PD6)
/ICSP_MISO: J2.1, U3.16 (PB4)
/ICSP_MOSI: J2.4, U3.15 (PB3)
/ICSP_SCK: J2.3, U3.17 (PB5)
/LED_IND: R7.2, U3.25 (PC2)
/OUT: U2.3 (OUT), U3.19 (PE2)
/PGO: U2.5 (PGO), U3.9 (PD5)
/RS485_N: J1.2, U1.7 (B)
/RS485_P: J1.1, U1.6 (A)
/RX: U1.1 (RO), U3.30 (PD0)
/SCL: R2.2, U2.7 (SCL), U3.28 (PC5)
/SDA: R3.2, U2.6 (SDA), U3.27 (PC4)
/TX: U1.4 (DI), U3.31 (PD1)
/VDD3V: C2.1, U2.2 (VDD3V)
/XTAL1: C9.1, R6.2, U3.7 (XTAL1/PB6), Y1.3
/XTAL2: C6.1, R6.1, U3.8 (XTAL2/PB7), Y1.1
/~RESET: C7.1, D2.2 (A), J2.5, R4.2, SW1.2, U3.29 (~RESET/PC6)
/~RE: U1.2 (~RE), U3.14 (PB2)
GND: C1.2, C2.2, C3.2, C4.2, C5.2, C6.2, C7.2, C8.2, C9.2, C10.2, C11.1, C12.2, C16.2, C17.2, C18.2, J1.3, J1.4, J2.6, Q1.2 (E), R8.2, R10.2, SW1.1, U1.5 (GND), U2.4 (GND), U3.5 (GND), U3.21 (GND), U4.1 (GND), U5.2 (GND), Y1.2, Y1.4
unnamed: D1.1 (K), R5.2
unnamed: Q1.1 (B), R7.1
unnamed: Q1.3 (C), R5.1
unnamed: C13.1, U4.6 (BOOT)
unnamed: R11.2, U4.5 (EN)
unnamed: C15.2, R9.2, R10.1, U4.4 (FB)
unnamed: C13.2, L3.1, U4.2 (SW)
unnamed: C14.2, R1.2, R8.1, U5.4 (FB)

Notes on the sheet:
Imax = 12 mA
NOTE: VOUT = VREF × (1 + R1 / R2); VREF = 0.768 V
4mOhm
280mOhm
Imax = 6.5 mA
Imax = 85 mA
Imax = 3 mA
4,983V (-0,34% error)
180mOhm
NOTE: VOUT = VFB × (1 + R1 / R2); VFB = 0.55 V R1 + R2 ≤ VOUT / (IFB × 100); IFB = 10 nA
5,522V
2.082mOhm
20%; < 100 mΩ; Low ESR ceramic capacitor
Guideline: C6 = C9 = 2*(CL - Cstray) Cstray assumed to be 5pF

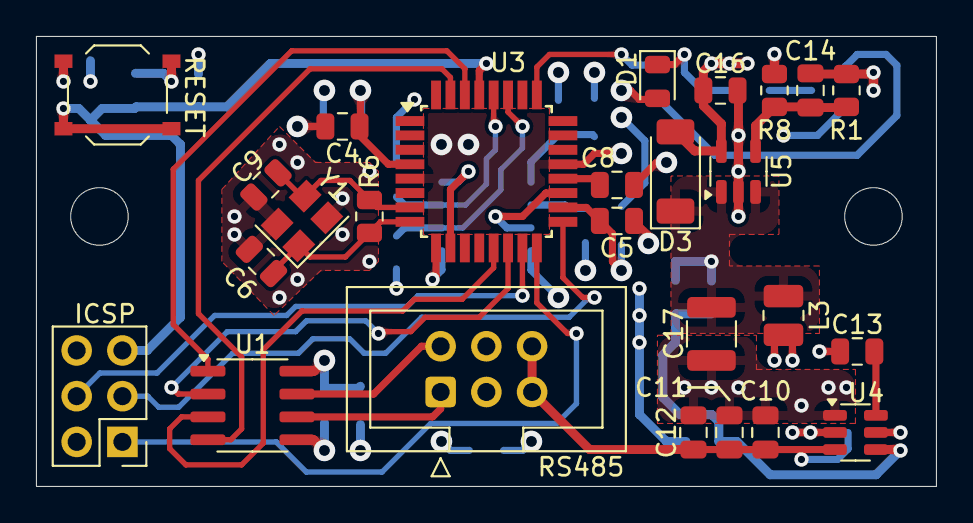
[picture p148: board RotationEncoder.kicad_pcb from above]

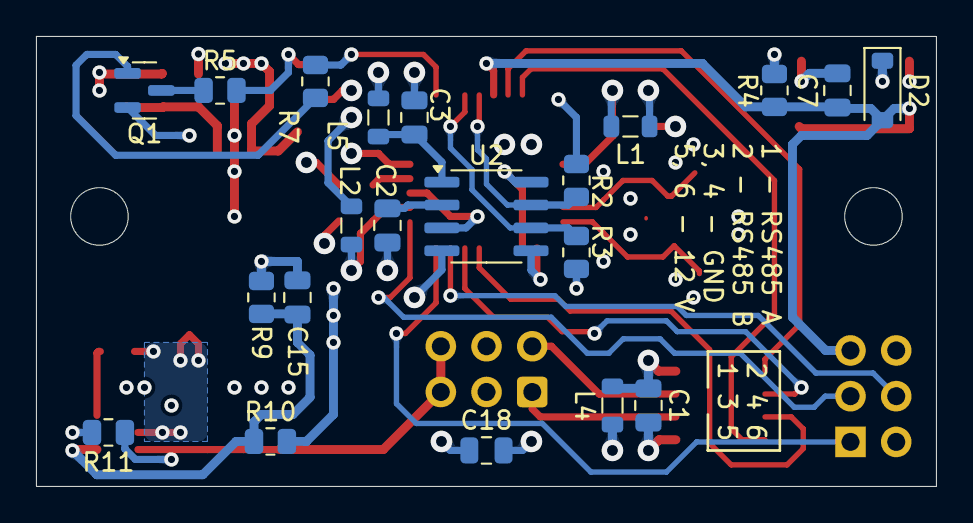
[picture p149: board RotationEncoder.kicad_pcb from below]

Board: 4 copper layers, 50.0 x 25.0 mm, 49 parts (21 on the bottom side), 34 nets.
