nunosousa/TelescopeMirrorTester/ECAD/DataShield/DataShield.kicad_pcb

## KiCad design ECAD/DataShield/DataShield.kicad_pcb (2024-09-14, an earlier design)

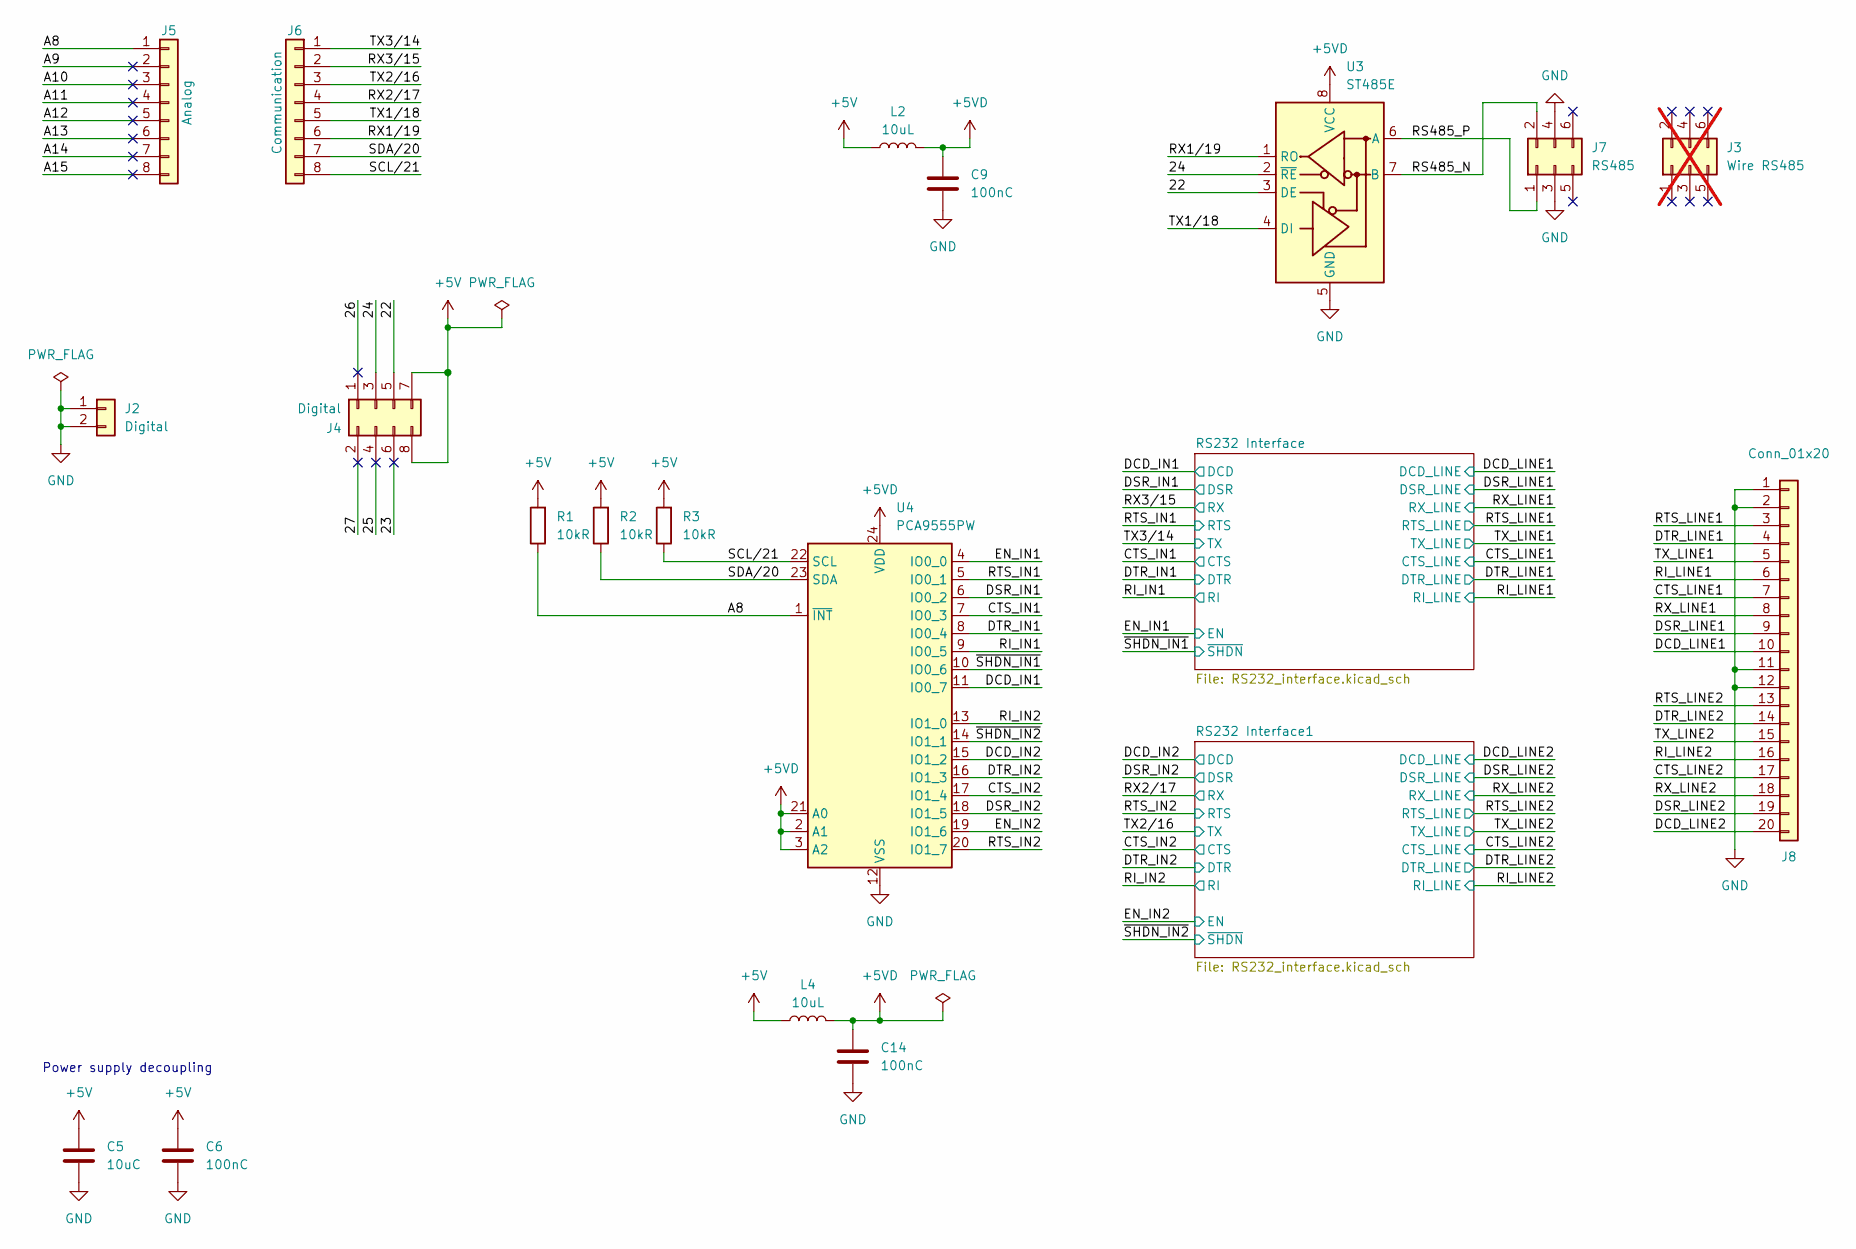
[picture p150: schematic DataShield.kicad_sch]

Parts:
C5: 10uC; C_1206_3216Metric; MPN CL31B106KOHNNNE
C6, C9, C14: 100nC; C_0805_2012Metric; MPN C0805F104K5RACAUTO
J2: Digital; PinSocket_1x02_P2.54mm_Vertical; MPN PM254-1-02-Z-8.5
J3: Wire RS485; IDC-Header_2x03_P2.54mm_Vertical; MPN I254-2*3-G-3-B; not fitted
J4: Digital; PinSocket_2x04_P2.54mm_Vertical; MPN PM254-2-04-Z-8.5
J5: Analog; PinSocket_1x08_P2.54mm_Vertical; MPN PZ254-1-08-Z-8.5
J6: Communication; PinSocket_1x08_P2.54mm_Vertical; MPN PZ254-1-08-Z-8.5
J7: RS485; IDC-Header_2x03_P2.54mm_Vertical; MPN HC-JN254-2-03-Z
J8: Conn_01x20; TE_2-84952-0_1x20-1MP_P1.0mm_Horizontal; MPN CT10252-20R-00-D
L2, L4: 10uL; L_0805_2012Metric; MPN LQM21FN100M80L
R1, R2, R3: 10kR; R_0805_2012Metric; MPN RC0805JR-0710KL
U3: ST485E; SOIC-8_3.9x4.9mm_P1.27mm; MPN ST485EBDR
U4: PCA9555PW; TSSOP-24_4.4x7.8mm_P0.65mm; MPN PCA9555PW,118

Connections:
+5V: C5.1, C6.1, J4.7, J4.8, L2.1, L4.1, R1.2, R2.2, R3.2; also elsewhere on the board
+5VD: C9.1, C14.1, L2.2, L4.2, U3.8 (VCC), U4.2 (A1), U4.3 (A2), U4.21 (A0), U4.24 (VDD); also elsewhere on the board
/22: J4.5, U3.3 (DE)
/23: J4.6
/24: J4.3, U3.2 (~RE)
/25: J4.4
/26: J4.1
/27: J4.2
/A8: J5.1, R1.1, U4.1 (~INT)
/A9: J5.2
/A10: J5.3
/A11: J5.4
/A12: J5.5
/A13: J5.6
/A14: J5.7
/A15: J5.8
/CTS_IN1: U4.7 (IO0_3); also elsewhere on the board
/CTS_IN2: U4.17 (IO1_4); also elsewhere on the board
/CTS_LINE1: J8.7; also elsewhere on the board
/CTS_LINE2: J8.17; also elsewhere on the board
/DCD_IN1: U4.11 (IO0_7); also elsewhere on the board
/DCD_IN2: U4.15 (IO1_2); also elsewhere on the board
/DCD_LINE1: J8.10; also elsewhere on the board
/DCD_LINE2: J8.20; also elsewhere on the board
/DSR_IN1: U4.6 (IO0_2); also elsewhere on the board
/DSR_IN2: U4.18 (IO1_5); also elsewhere on the board
/DSR_LINE1: J8.9; also elsewhere on the board
/DSR_LINE2: J8.19; also elsewhere on the board
/DTR_IN1: U4.8 (IO0_4); also elsewhere on the board
/DTR_IN2: U4.16 (IO1_3); also elsewhere on the board
/DTR_LINE1: J8.4; also elsewhere on the board
/DTR_LINE2: J8.14; also elsewhere on the board
/EN_IN1: U4.4 (IO0_0); also elsewhere on the board
/EN_IN2: U4.19 (IO1_6); also elsewhere on the board
/RI_IN1: U4.9 (IO0_5); also elsewhere on the board
/RI_IN2: U4.13 (IO1_0); also elsewhere on the board
/RI_LINE1: J8.6; also elsewhere on the board
/RI_LINE2: J8.16; also elsewhere on the board
/RS485_N: J7.2, U3.7 (B)
/RS485_P: J7.1, U3.6 (A)
/RTS_IN1: U4.5 (IO0_1); also elsewhere on the board
/RTS_IN2: U4.20 (IO1_7); also elsewhere on the board
/RTS_LINE1: J8.3; also elsewhere on the board
/RTS_LINE2: J8.13; also elsewhere on the board
/RX1/19: J6.6, U3.1 (RO)
/RX2/17: J6.4; also elsewhere on the board
/RX3/15: J6.2; also elsewhere on the board
/RX_LINE1: J8.8; also elsewhere on the board
/RX_LINE2: J8.18; also elsewhere on the board
/SCL/21: J6.8, R3.1, U4.22 (SCL)
/SDA/20: J6.7, R2.1, U4.23 (SDA)
/TX1/18: J6.5, U3.4 (DI)
/TX2/16: J6.3; also elsewhere on the board
/TX3/14: J6.1; also elsewhere on the board
/TX_LINE1: J8.5; also elsewhere on the board
/TX_LINE2: J8.15; also elsewhere on the board
/~SHDN_IN1: U4.10 (IO0_6); also elsewhere on the board
/~SHDN_IN2: U4.14 (IO1_1); also elsewhere on the board
GND: C5.2, C6.2, C9.2, C14.2, J2.1, J2.2, J7.3, J7.4, J8.1, J8.2, J8.11, J8.12, U3.5 (GND), U4.12 (VSS); also elsewhere on the board

Notes on the sheet:
Power supply decoupling

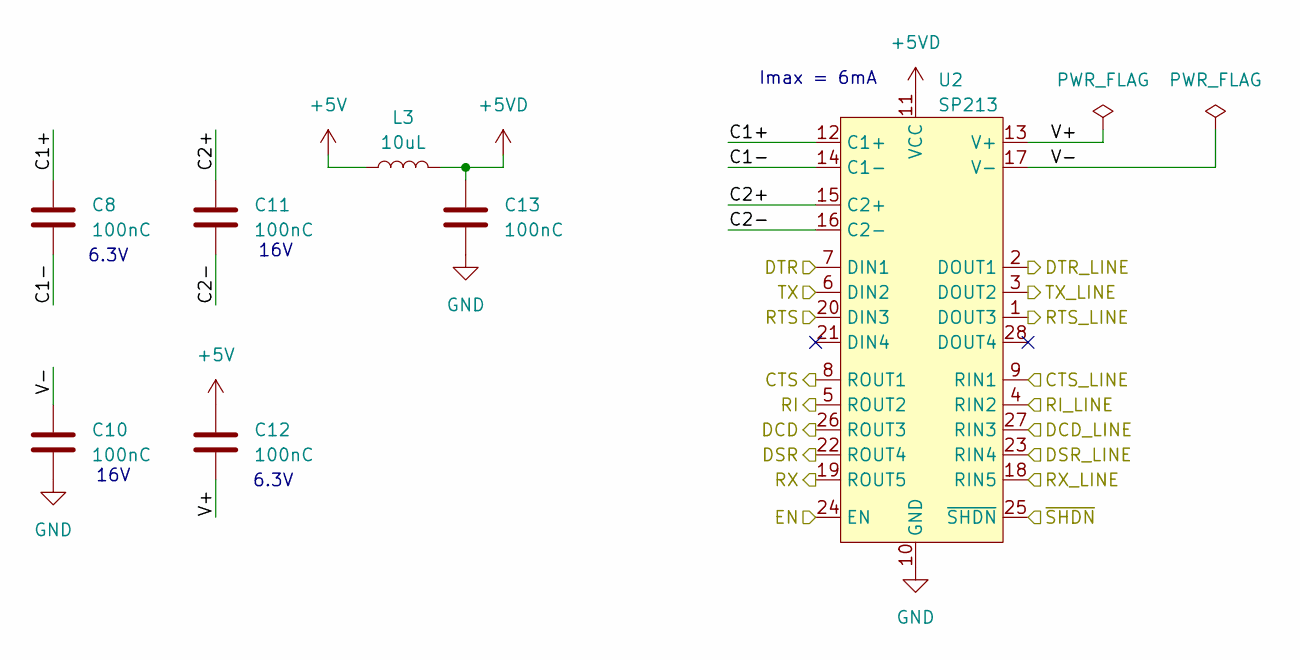
[picture p151: schematic RS232_interface.kicad_sch]

Parts:
C8, C10, C11, C12, C13: 100nC; C_0805_2012Metric; MPN C0805F104K5RACAUTO
L3: 10uL; L_0805_2012Metric; MPN LQM21FN100M80L
U2: SP213; SSOP-28_5.3x10.2mm_P0.65mm; MPN SP213EEA-L/TR

Connections:
+5V: C12.1, L3.1; also elsewhere on the board
+5VD: C13.1, L3.2, U2.11 (VCC); also elsewhere on the board
/CTS_IN2: U2.8 (ROUT1); also elsewhere on the board
/CTS_LINE2: U2.9 (RIN1); also elsewhere on the board
/DCD_IN2: U2.26 (ROUT3); also elsewhere on the board
/DCD_LINE2: U2.27 (RIN3); also elsewhere on the board
/DSR_IN2: U2.22 (ROUT4); also elsewhere on the board
/DSR_LINE2: U2.23 (RIN4); also elsewhere on the board
/DTR_IN2: U2.7 (DIN1); also elsewhere on the board
/DTR_LINE2: U2.2 (DOUT1); also elsewhere on the board
/EN_IN2: U2.24 (EN); also elsewhere on the board
/RI_IN2: U2.5 (ROUT2); also elsewhere on the board
/RI_LINE2: U2.4 (RIN2); also elsewhere on the board
/RS232 Interface1/C1+: C8.1, U2.12 (C1+)
/RS232 Interface1/C1-: C8.2, U2.14 (C1-)
/RS232 Interface1/C2+: C11.1, U2.15 (C2+)
/RS232 Interface1/C2-: C11.2, U2.16 (C2-)
/RS232 Interface1/V+: C12.2, U2.13 (V+)
/RS232 Interface1/V-: C10.1, U2.17 (V-)
/RTS_IN2: U2.20 (DIN3); also elsewhere on the board
/RTS_LINE2: U2.1 (DOUT3); also elsewhere on the board
/RX2/17: U2.19 (ROUT5); also elsewhere on the board
/RX_LINE2: U2.18 (RIN5); also elsewhere on the board
/TX2/16: U2.6 (DIN2); also elsewhere on the board
/TX_LINE2: U2.3 (DOUT2); also elsewhere on the board
/~SHDN_IN2: U2.25 (~SHDN); also elsewhere on the board
GND: C10.2, C13.2, U2.10 (GND); also elsewhere on the board

Parts of its further copies:
C1, C2, C3, C4, C7: 100nC; C_0805_2012Metric; MPN C0805F104K5RACAUTO
L1: 10uL; L_0805_2012Metric; MPN LQM21FN100M80L
U1: SP213; SSOP-28_5.3x10.2mm_P0.65mm; MPN SP213EEA-L/TR

Connections of its further copies:
+5V: C4.1, L1.1; also elsewhere on the board
+5VD: C7.1, L1.2, U1.11 (VCC); also elsewhere on the board
/CTS_IN1: U1.8 (ROUT1); also elsewhere on the board
/CTS_LINE1: U1.9 (RIN1); also elsewhere on the board
/DCD_IN1: U1.26 (ROUT3); also elsewhere on the board
/DCD_LINE1: U1.27 (RIN3); also elsewhere on the board
/DSR_IN1: U1.22 (ROUT4); also elsewhere on the board
/DSR_LINE1: U1.23 (RIN4); also elsewhere on the board
/DTR_IN1: U1.7 (DIN1); also elsewhere on the board
/DTR_LINE1: U1.2 (DOUT1); also elsewhere on the board
/EN_IN1: U1.24 (EN); also elsewhere on the board
/RI_IN1: U1.5 (ROUT2); also elsewhere on the board
/RI_LINE1: U1.4 (RIN2); also elsewhere on the board
/RS232 Interface/C1+: C1.1, U1.12 (C1+)
/RS232 Interface/C1-: C1.2, U1.14 (C1-)
/RS232 Interface/C2+: C3.1, U1.15 (C2+)
/RS232 Interface/C2-: C3.2, U1.16 (C2-)
/RS232 Interface/V+: C4.2, U1.13 (V+)
/RS232 Interface/V-: C2.1, U1.17 (V-)
/RTS_IN1: U1.20 (DIN3); also elsewhere on the board
/RTS_LINE1: U1.1 (DOUT3); also elsewhere on the board
/RX3/15: U1.19 (ROUT5); also elsewhere on the board
/RX_LINE1: U1.18 (RIN5); also elsewhere on the board
/TX3/14: U1.6 (DIN2); also elsewhere on the board
/TX_LINE1: U1.3 (DOUT2); also elsewhere on the board
/~SHDN_IN1: U1.25 (~SHDN); also elsewhere on the board
GND: C2.2, C7.2, U1.10 (GND); also elsewhere on the board

Notes on the sheet:
16V
Imax = 6mA
6.3V

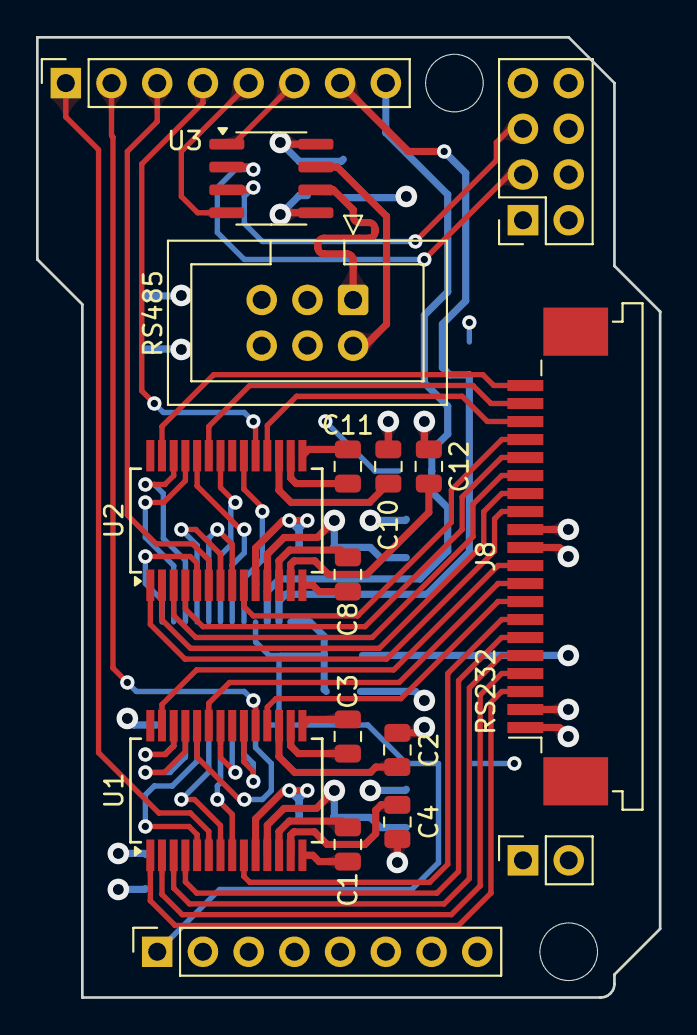
[picture p152: board ECAD/DataShield/DataShield.kicad_pcb from above]

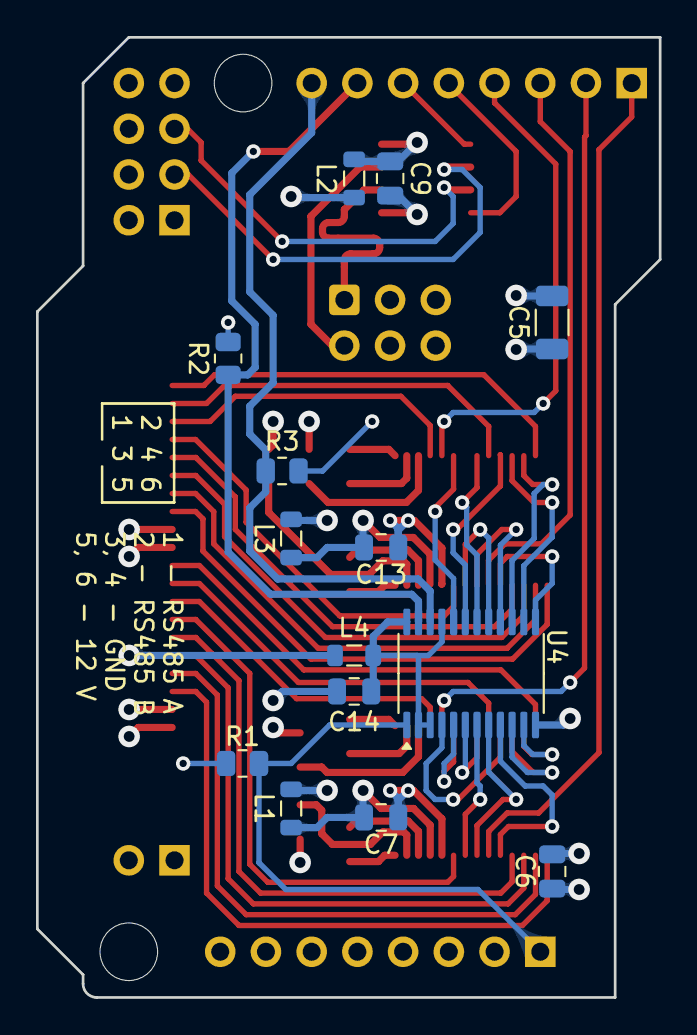
[picture p153: board ECAD/DataShield/DataShield.kicad_pcb from below]

Board: 4 copper layers, 34.6 x 53.3 mm, 33 parts (14 on the bottom side), 60 nets.

Other parts of the board:
MH5, MH6: MountingHole_3.2mm
