nunosousa/TelescopeMirrorTester/ECAD/DataDisplay/DataDisplay.kicad_pcb

## KiCad design ECAD/DataDisplay/DataDisplay.kicad_pcb (2024-06-15)

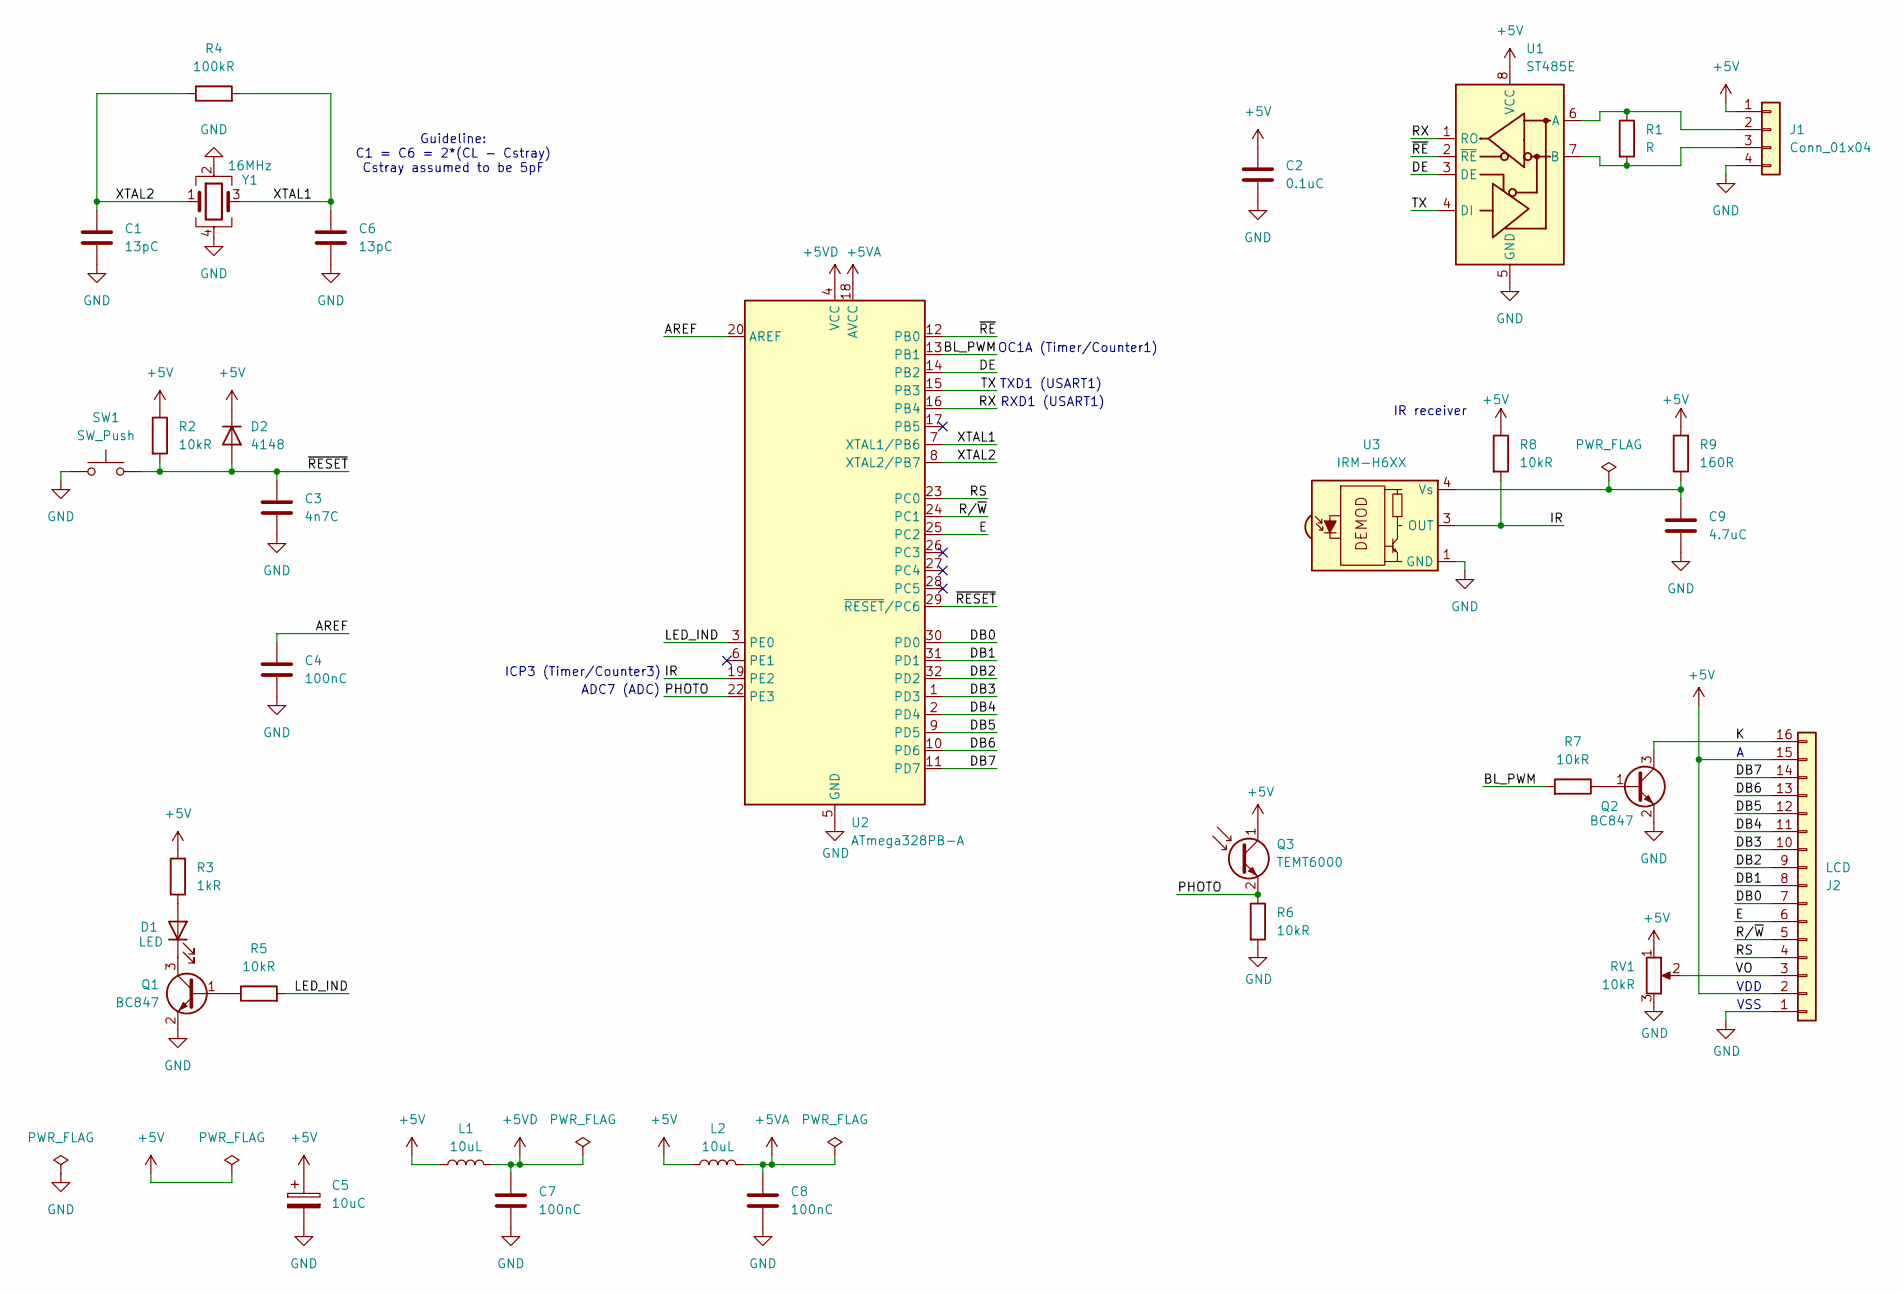
[picture p154: schematic DataDisplay.kicad_sch]

Parts:
C1, C6: 13pC; C_0805_2012Metric
C2: 0.1uC; C_0805_2012Metric
C3: 4n7C; C_0805_2012Metric
C4, C7, C8: 100nC; C_0805_2012Metric
C5: 10uC; CP_Elec_4x5.4; MPN UWX1C100MCL1GB
C9: 4.7uC; C_0805_2012Metric_Pad1.18x1.45mm_HandSolder; MPN CC0805KKX7R8BB475
D1: LED; LED_0805_2012Metric; MPN LTST-C171KGKT
D2: 4148; D_SOD-123; MPN MMSD4148T1G
J1: Conn_01x04; JST_EH_B4B-EH-A_1x04_P2.50mm_Vertical
J2: LCD; PinHeader_1x16_P2.54mm_Vertical
L1, L2: 10uL; L_0805_2012Metric; MPN LQM21FN100M80L
Q1, Q2: BC847; SOT-23; MPN BC847C,215
Q3: TEMT6000; MPN TEMT6000X01
R1: R
R2, R5, R6, R7: 10kR; R_0805_2012Metric
R3: 1kR; R_0805_2012Metric
R4: 100kR; R_0805_2012Metric
R8: 10kR; R_0805_2012Metric; MPN RC0805FR-0710KL
R9: 160R; R_0805_2012Metric_Pad1.20x1.40mm_HandSolder; MPN AC0805FR-7W160RL
RV1: 10kR
SW1: SW_Push; SW_Push_1P1T_XKB_TS-1187A; MPN TS-1187A-C-E-B
U1: ST485E; SOIC-8_3.9x4.9mm_P1.27mm; MPN ST485EBDR
U2: ATmega328PB-A; TQFP-32_7x7mm_P0.8mm
U3: IRM-H6XX; MPN IRM-H638J7/TR2(CLW)
Y1: 16MHz; Crystal_SMD_3225-4Pin_3.2x2.5mm; MPN X1E0000210119

Connections:
+5V: C2.1, C5.1, D2.1 (K), J1.1, J2.2, J2.15, L1.1, L2.1, Q3.1 (C), R2.1, R3.2, R8.1, R9.2, RV1.1, U1.8 (VCC)
+5VA: C8.1, L2.2, U2.18 (AVCC)
+5VD: C7.1, L1.2, U2.4 (VCC)
/AREF: C4.1, U2.20 (AREF)
/BL_PWM: R7.2, U2.13 (PB1)
/DB0: J2.7, U2.30 (PD0)
/DB1: J2.8, U2.31 (PD1)
/DB2: J2.9, U2.32 (PD2)
/DB3: J2.10, U2.1 (PD3)
/DB4: J2.11, U2.2 (PD4)
/DB5: J2.12, U2.9 (PD5)
/DB6: J2.13, U2.10 (PD6)
/DB7: J2.14, U2.11 (PD7)
/DE: U1.3 (DE), U2.14 (PB2)
/E: J2.6, U2.25 (PC2)
/IR: R8.2, U2.19 (PE2), U3.3 (OUT)
/K: J2.16, Q2.3 (C)
/LED_IND: R5.2, U2.3 (PE0)
/PHOTO: Q3.2 (E), R6.1, U2.22 (PE3)
/RS: J2.4, U2.23 (PC0)
/RX: U1.1 (RO), U2.16 (PB4)
/R/~W: J2.5, U2.24 (PC1)
/TX: U1.4 (DI), U2.15 (PB3)
/VO: J2.3, RV1.2
/XTAL1: C6.1, R4.2, U2.7 (XTAL1/PB6), Y1.3
/XTAL2: C1.1, R4.1, U2.8 (XTAL2/PB7), Y1.1
/~RESET: C3.1, D2.2 (A), R2.2, SW1.2, U2.29 (~RESET/PC6)
/~RE: U1.2 (~RE), U2.12 (PB0)
GND: C1.2, C2.2, C3.2, C4.2, C5.2, C6.2, C7.2, C8.2, C9.2, J1.4, J2.1, Q1.2 (E), Q2.2 (E), R6.2, RV1.3, SW1.1, U1.5 (GND), U2.5 (GND), U2.21 (GND), U3.1 (GND), U3.2 (GND), Y1.2, Y1.4
unnamed: D1.2 (A), R3.1
unnamed: D1.1 (K), Q1.3 (C)
unnamed: J1.2, R1.1, U1.6 (A)
unnamed: J1.3, R1.2, U1.7 (B)
unnamed: Q1.1 (B), R5.1
unnamed: Q2.1 (B), R7.1
unnamed: C9.1, R9.1, U3.4 (Vs)

Notes on the sheet:
TXD1 (USART1)
Guideline: C1 = C6 = 2*(CL - Cstray) Cstray assumed to be 5pF
IR receiver
ICP3 (Timer/Counter3)
ADC7 (ADC)
VSS
OC1A (Timer/Counter1)
VDD
RXD1 (USART1)

Board: 2 copper layers, 30 parts (0 on the bottom side), 35 nets, no tracks yet.
