nunosousa/TelescopeMirrorTester/Tester/ECAD/LaserModule/LaserModule.kicad_pcb

## KiCad design _Deprecated/ECAD/LaserModule/LaserModule.kicad_pcb (2020-05-04, an earlier design)

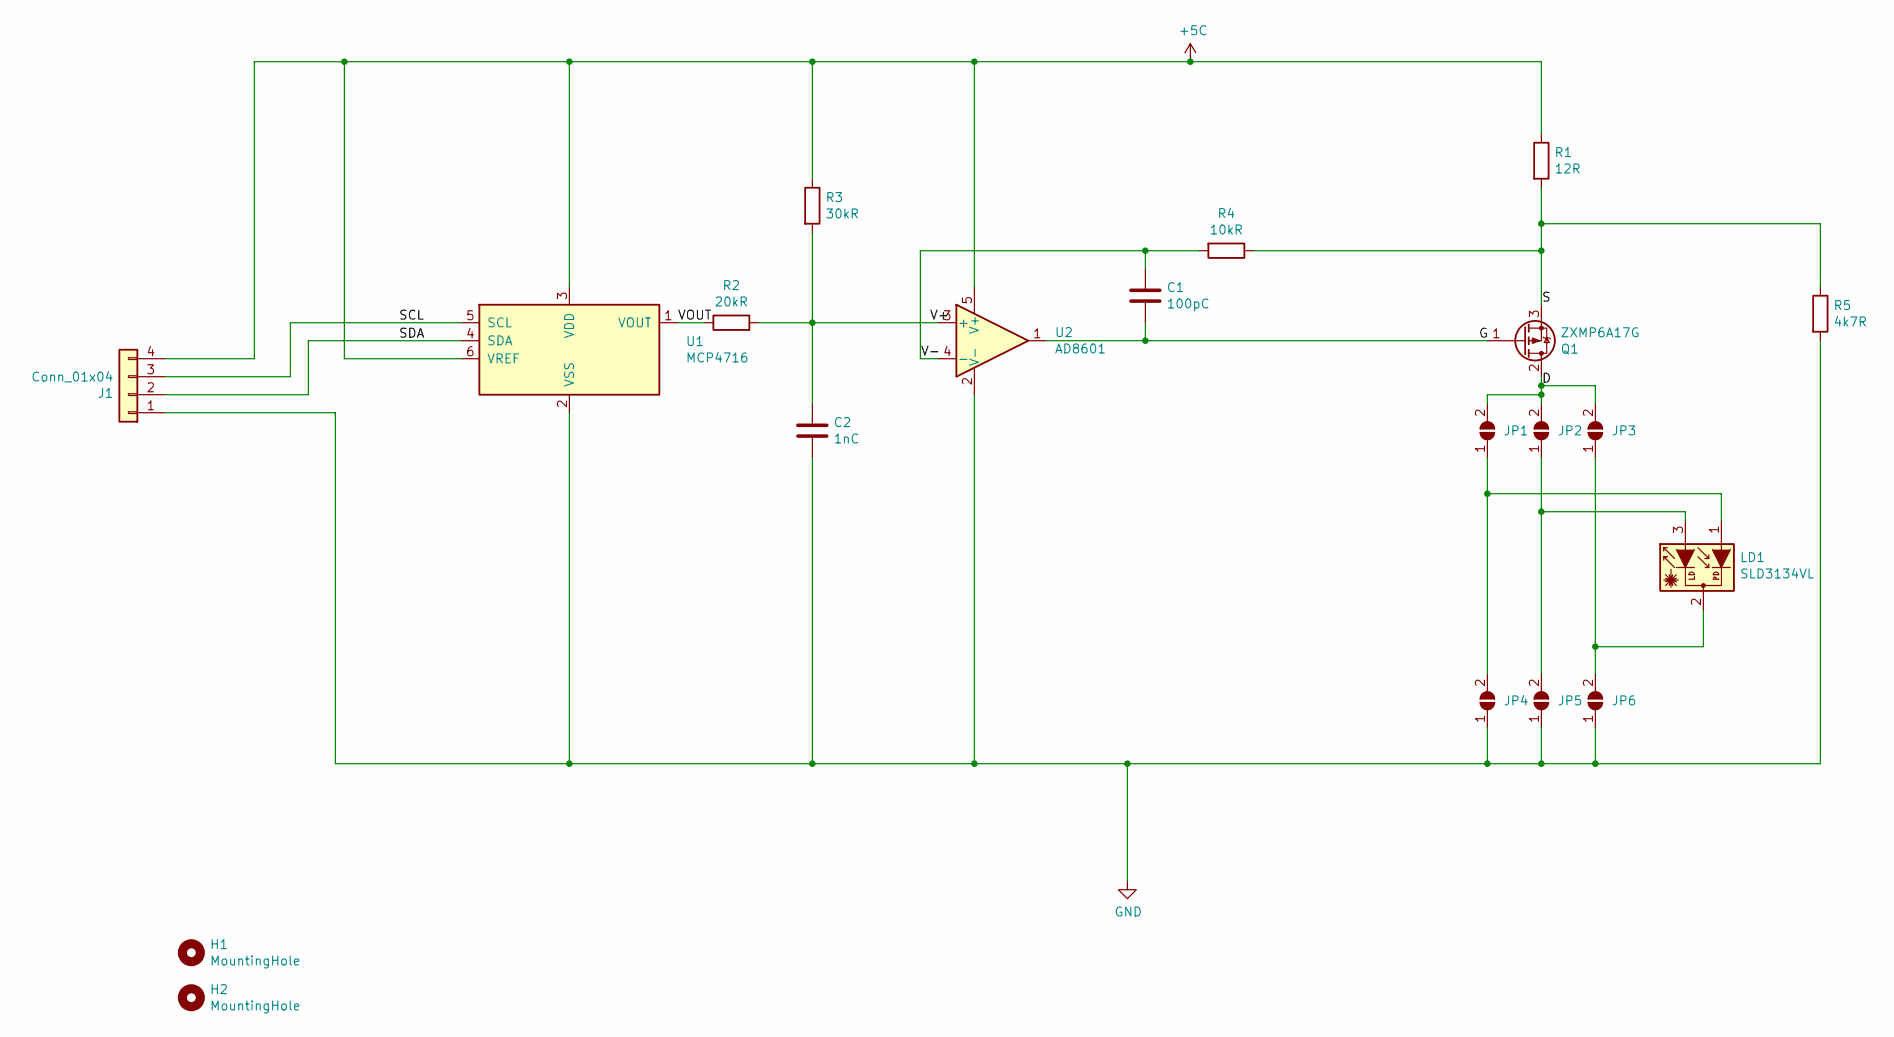
[picture p155: schematic LaserModule.sch]

Parts:
C1: 100pC; C_0805_2012Metric_Pad1.15x1.40mm_HandSolder; Manufacturer Part Number 08055C101KAT2A
C2: 1nC; C_0805_2012Metric_Pad1.15x1.40mm_HandSolder; Manufacturer Part Number CL21B102KBANNNC
H1, H2: MountingHole; MountingHole_3.2mm_M3_Pad
J1: Conn_01x04; JST_PH_S4B-PH-K_1x04_P2.00mm_Horizontal; Manufacturer Part Number S4B-PH-K-S(LF)(SN)
JP1, JP2, JP3, JP4, JP5, JP6: SolderJumper_2_Open; SolderJumper-2_P1.3mm_Open_RoundedPad1.0x1.5mm
LD1: SLD3134VL; LaserDiode_TO18-D5.6-3
Q1: ZXMP6A17G; SOT-223-3_TabPin2; Manufacturer Part Number ZXMP6A17GTA
R1: 12R; R_2512_6332Metric_Pad1.52x3.35mm_HandSolder; Manufacturer Part Number tbd
R2: 20kR; R_0805_2012Metric_Pad1.15x1.40mm_HandSolder; Manufacturer Part Number tbd
R3: 30kR; R_0805_2012Metric_Pad1.15x1.40mm_HandSolder; Manufacturer Part Number tbd
R4: 10kR; R_0805_2012Metric_Pad1.15x1.40mm_HandSolder; Manufacturer Part Number RC0805FR-0710KL
R5: 4k7R; R_0805_2012Metric_Pad1.15x1.40mm_HandSolder; Manufacturer Part Number RC0805FR-074K7L
U1: MCP4716; SOT-23-6_Handsoldering; Manufacturer Part Number MCP4716A3T-E/CH
U2: AD8601; TSOT-23-5; Manufacturer Part Number AD8601WDRTZ-REEL7

Connections:
+5C: J1.4, R1.1, R3.1, U1.3 (VDD), U1.6 (VREF), U2.5 (V+)
/D: JP1.2 (B), JP2.2 (B), JP3.2 (B), Q1.2 (D)
/G: C1.2, Q1.1 (G), U2.1
/S: Q1.3 (S), R1.2, R4.1, R5.1
/SCL: J1.3, U1.5 (SCL)
/SDA: J1.2, U1.4 (SDA)
/V+: C2.1, R2.2, R3.2, U2.3 (+)
/V-: C1.1, R4.2, U2.4 (-)
/VOUT: R2.1, U1.1 (VOUT)
GND: C2.2, J1.1, JP4.1 (A), JP5.1 (A), JP6.1 (A), R5.2, U1.2 (VSS), U2.2 (V-)
unnamed: JP1.1 (A), JP4.2 (B), LD1.1 (PD_cathode)
unnamed: JP2.1 (A), JP5.2 (B), LD1.3 (LD_anode)
unnamed: JP3.1 (A), JP6.2 (B), LD1.2 (Common)

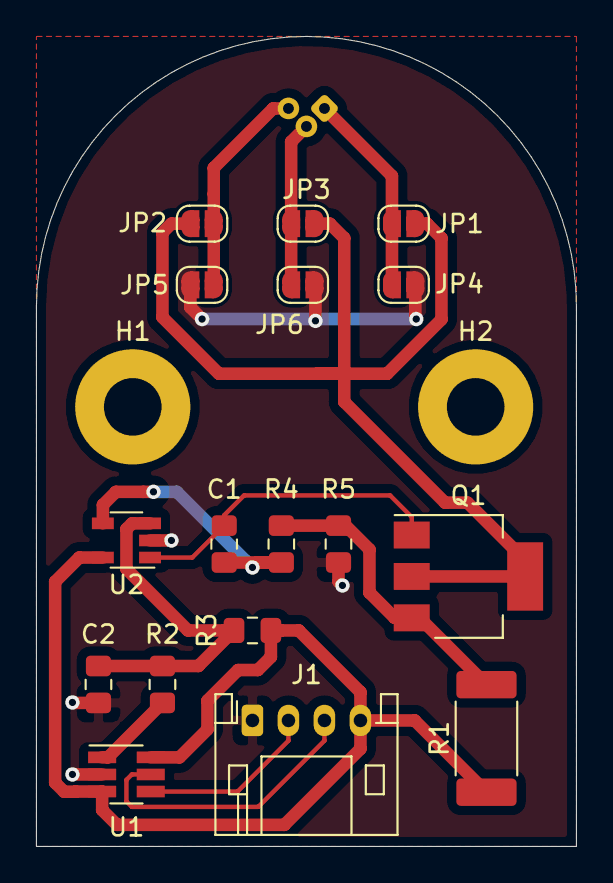
[picture p156: board LaserModule.kicad_pcb from above]

Board: 2 copper layers, 30.0 x 45.0 mm, 20 parts (1 on the bottom side), 13 nets.
