nunosousa/TelescopeMirrorTester/Tester/ECAD/ControllerBoard/ControllerBoard.kicad_pcb

## KiCad design _Deprecated/ECAD/ControllerBoard/ControllerBoard.kicad_pcb (2021-06-25, an earlier design)

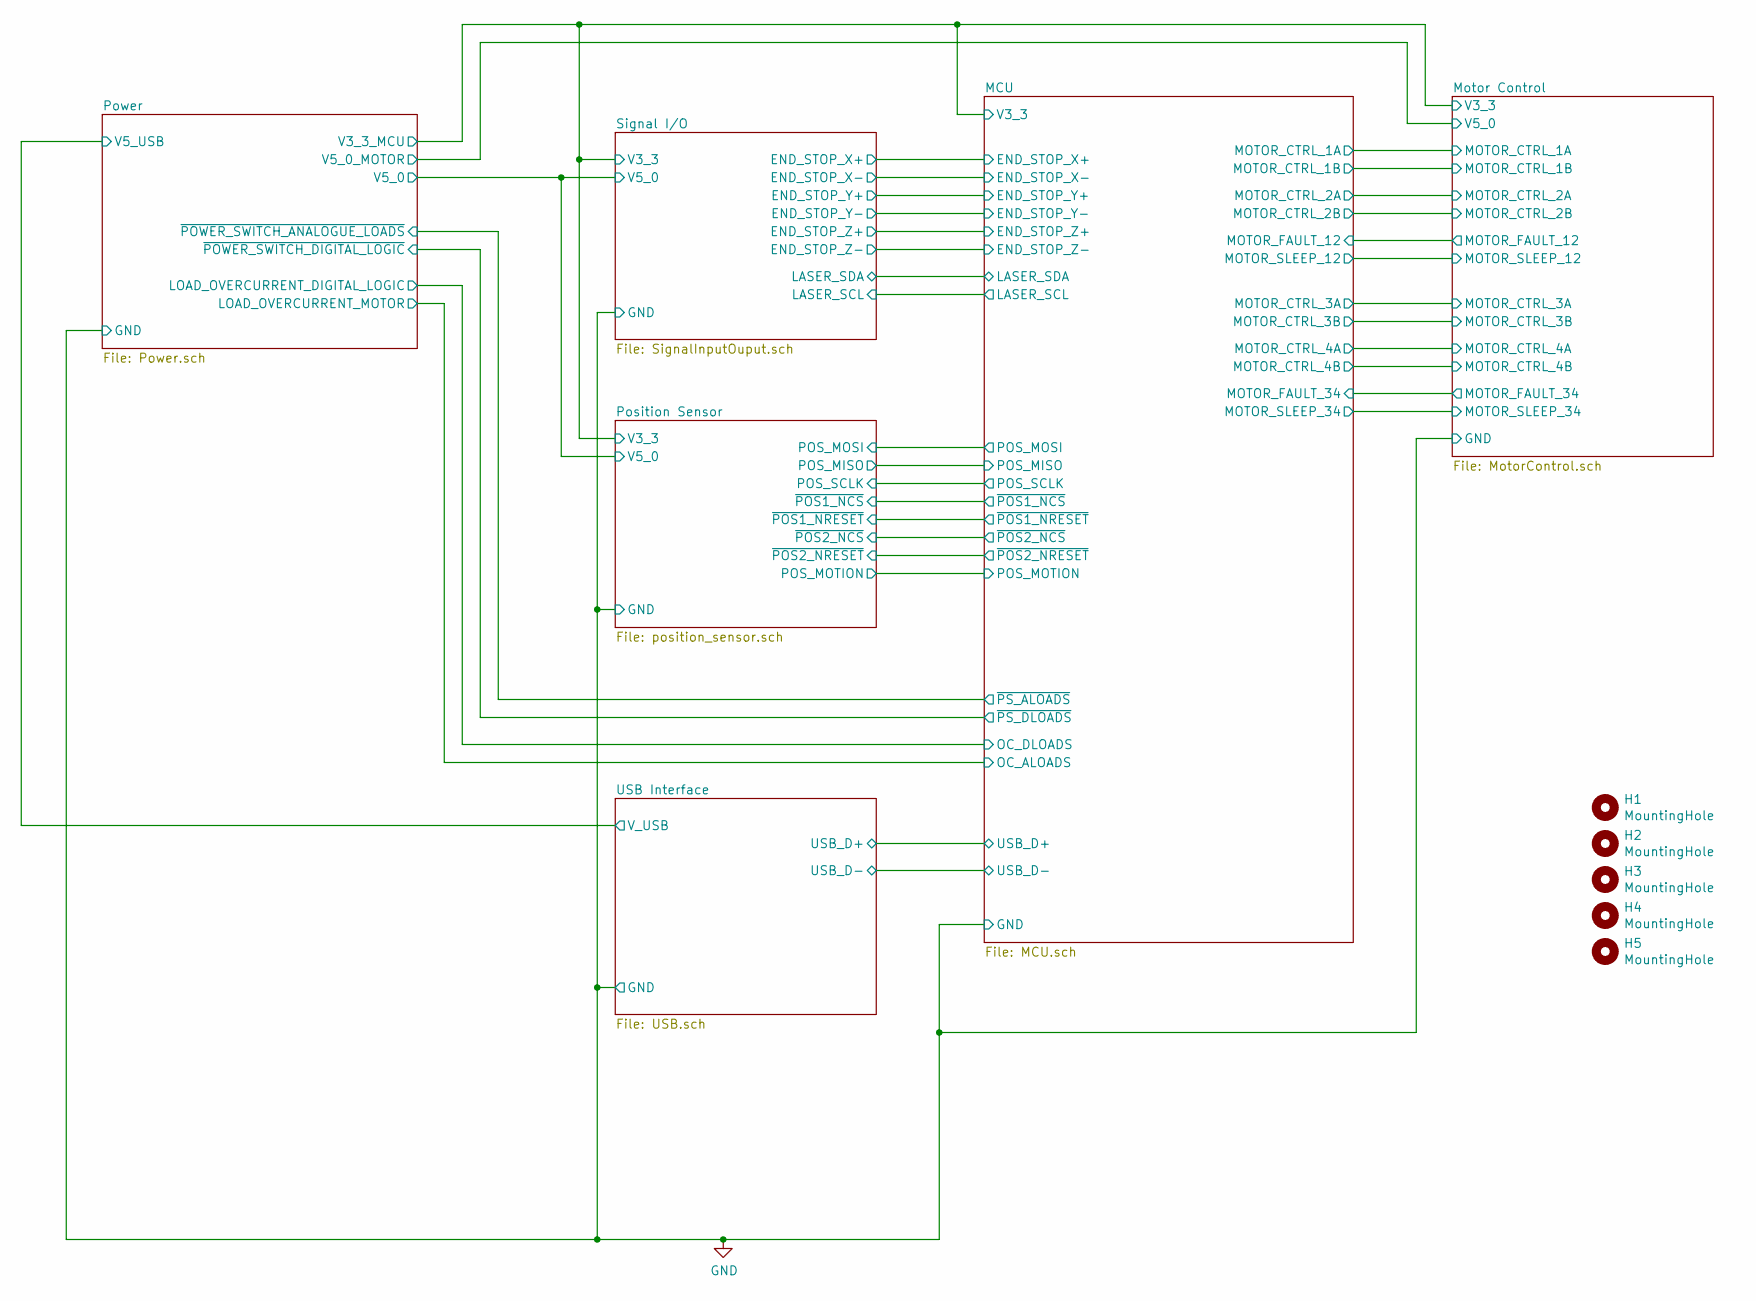
[picture p157: schematic ControllerBoard.sch]

Parts:
H1, H2, H3, H4, H5: MountingHole; MountingHole_3.2mm_M3_Pad

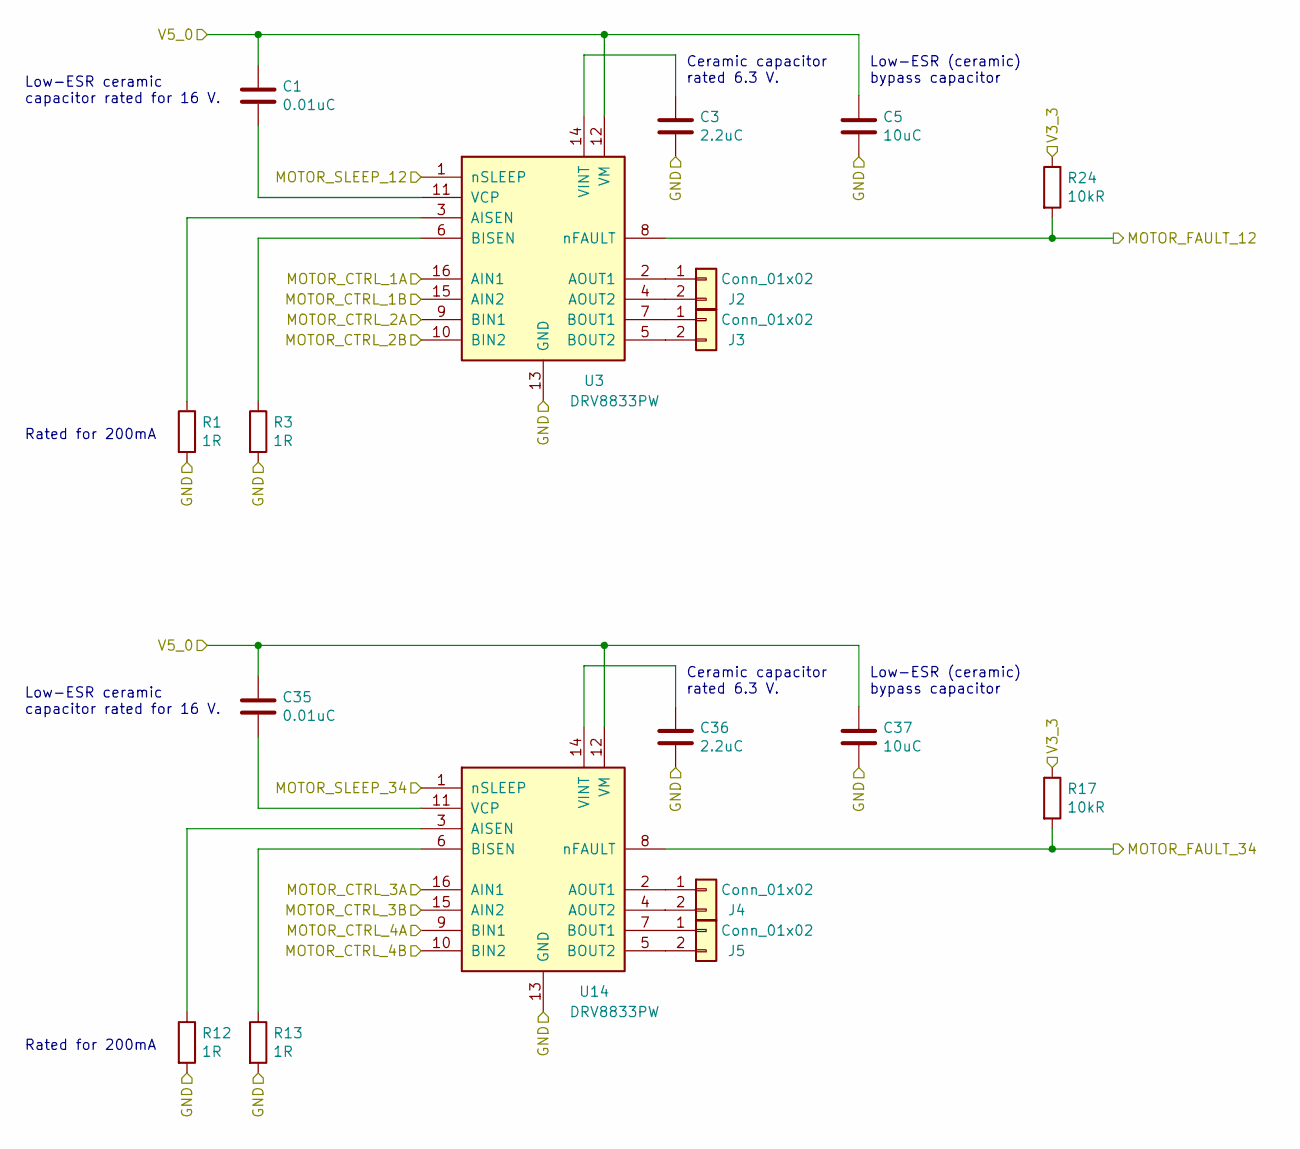
[picture p158: schematic MotorControl.sch]

Parts:
C1, C35: 0.01uC; C_0805_2012Metric_Pad1.15x1.40mm_HandSolder; Manufacturer Part Number CC0805KRX7R9BB103
C3, C36: 2.2uC; C_0805_2012Metric_Pad1.15x1.40mm_HandSolder; Manufacturer Part Number CC0805KRX5R7BB225
C5, C37: 10uC; C_0805_2012Metric_Pad1.15x1.40mm_HandSolder; Manufacturer Part Number CC0805MRX5R6BB106
J2, J3, J4, J5: Conn_01x02; JST_PH_S2B-PH-K_1x02_P2.00mm_Horizontal; Manufacturer Part Number S2B-PH-K-S(LF)(SN)
R1, R3, R12, R13: 1R; R_0805_2012Metric_Pad1.15x1.40mm_HandSolder; Manufacturer Part Number RC0805FR-071RL
R17, R24: 10kR; R_0805_2012Metric_Pad1.15x1.40mm_HandSolder; Manufacturer Part Number RC0805FR-0710KL
U3, U14: DRV8833PW; TSSOP-16_4.4x5mm_P0.65mm; Manufacturer Part Number DRV8833PWR

Connections:
/MCU/MOTOR_CTRL_1A: U3.16 (AIN1); also elsewhere on the board
/MCU/MOTOR_CTRL_1B: U3.15 (AIN2); also elsewhere on the board
/MCU/MOTOR_CTRL_2A: U3.9 (BIN1); also elsewhere on the board
/MCU/MOTOR_CTRL_2B: U3.10 (BIN2); also elsewhere on the board
/MCU/MOTOR_CTRL_3A: U14.16 (AIN1); also elsewhere on the board
/MCU/MOTOR_CTRL_3B: U14.15 (AIN2); also elsewhere on the board
/MCU/MOTOR_CTRL_4A: U14.9 (BIN1); also elsewhere on the board
/MCU/MOTOR_CTRL_4B: U14.10 (BIN2); also elsewhere on the board
/MCU/MOTOR_FAULT_12: R24.2, U3.8 (nFAULT); also elsewhere on the board
/MCU/MOTOR_FAULT_34: R17.2, U14.8 (nFAULT); also elsewhere on the board
/MCU/MOTOR_SLEEP_12: U3.1 (nSLEEP); also elsewhere on the board
/MCU/MOTOR_SLEEP_34: U14.1 (nSLEEP); also elsewhere on the board
/MCU/V3_3: R17.1, R24.1; also elsewhere on the board
/Motor Control/V5_0: C1.1, C5.1, C35.1, C37.1, U3.12 (VM), U14.12 (VM); also elsewhere on the board
GND: C3.2, C5.2, C36.2, C37.2, R1.2, R3.2, R12.2, R13.2, U3.13 (GND), U14.13 (GND); also elsewhere on the board
unnamed: C1.2, U3.11 (VCP)
unnamed: C3.1, U3.14 (VINT)
unnamed: C35.2, U14.11 (VCP)
unnamed: C36.1, U14.14 (VINT)
unnamed: J2.1, U3.2 (AOUT1)
unnamed: J2.2, U3.4 (AOUT2)
unnamed: J3.1, U3.7 (BOUT1)
unnamed: J3.2, U3.5 (BOUT2)
unnamed: J4.1, U14.2 (AOUT1)
unnamed: J4.2, U14.4 (AOUT2)
unnamed: J5.1, U14.7 (BOUT1)
unnamed: J5.2, U14.5 (BOUT2)
unnamed: R1.1, U3.3 (AISEN)
unnamed: R3.1, U3.6 (BISEN)
unnamed: R12.1, U14.3 (AISEN)
unnamed: R13.1, U14.6 (BISEN)

Notes on the sheet:
Rated for 200mA
Low-ESR (ceramic) bypass capacitor
Low-ESR ceramic capacitor rated for 16 V.
Ceramic capacitor rated 6.3 V.

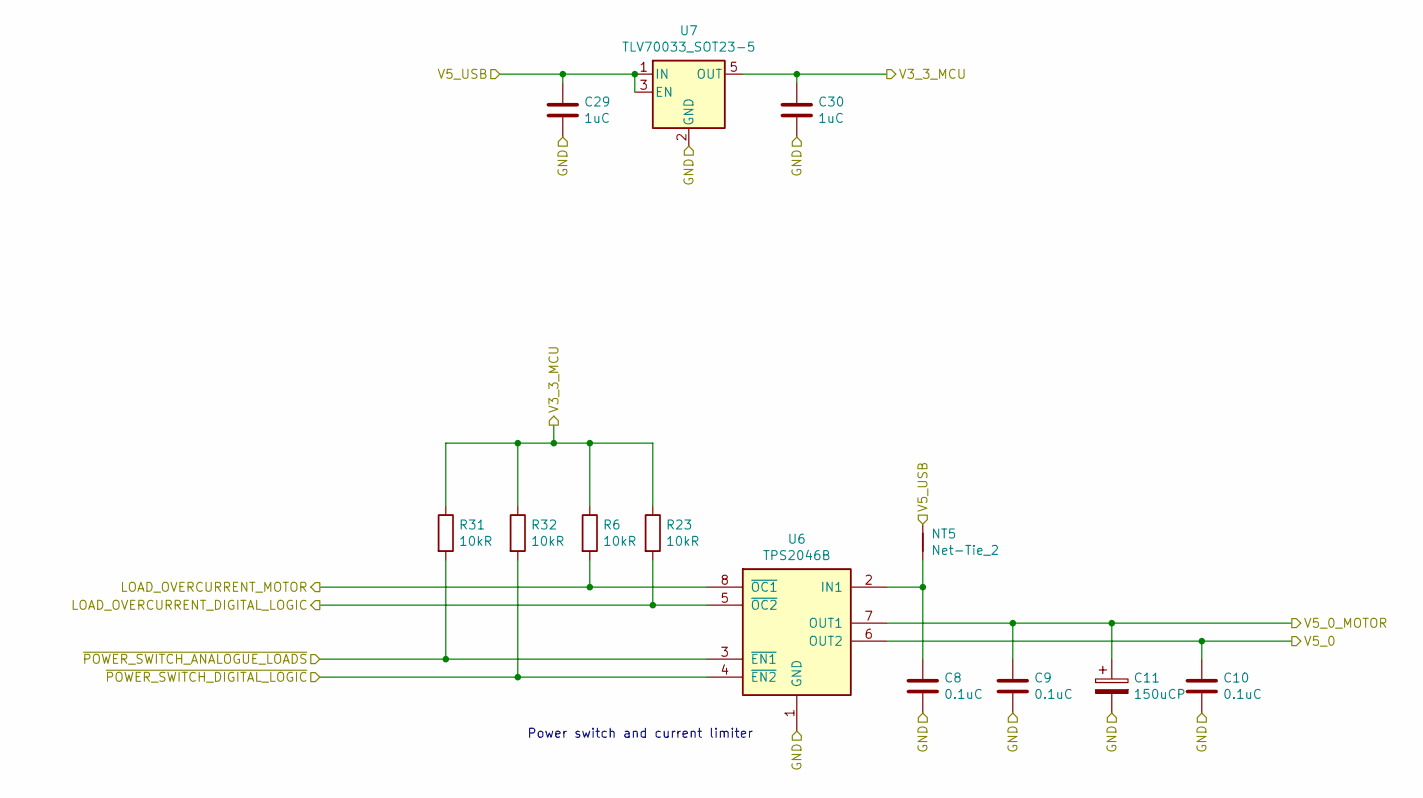
[picture p159: schematic Power.sch]

Parts:
C8, C9, C10: 0.1uC; C_0805_2012Metric_Pad1.15x1.40mm_HandSolder; Manufacturer Part Number AC0805KRX7R7BB104
C11: 150uCP; CP_EIA-7343-31_Kemet-D_Pad2.25x2.55mm_HandSolder; Manufacturer Part Number T495D157K010ATE100
C29, C30: 1uC; C_0805_2012Metric_Pad1.15x1.40mm_HandSolder; Manufacturer Part Number CC0805MKX7R7BB105
NT5: Net-Tie_2; NetTie-2_SMD_Pad0.5mm
R6, R23, R31, R32: 10kR; R_0805_2012Metric_Pad1.15x1.40mm_HandSolder; Manufacturer Part Number RC0805FR-0710KL
U6: TPS2046B; SOIC-8_3.9x4.9mm_P1.27mm; Manufacturer Part Number TPS2046BDR
U7: TLV70033_SOT23-5; SOT-23-5; Manufacturer Part Number TLV70033DDCT

Connections:
/MCU/V3_3: C30.1, R6.1, R23.1, R31.1, R32.1, U7.5 (OUT); also elsewhere on the board
/Motor Control/V5_0: C9.1, C11.1, U6.7 (OUT1); also elsewhere on the board
/Position Sensor/V5_0: C10.1, U6.6 (OUT2); also elsewhere on the board
/Power/LOAD_OVERCURRENT_DIGITAL_LOGIC: R23.2, U6.5 (~OC2); also elsewhere on the board
/Power/LOAD_OVERCURRENT_MOTOR: R6.2, U6.8 (~OC1); also elsewhere on the board
/Power/V5_USB: C29.1, NT5.1, U7.1 (IN), U7.3 (EN); also elsewhere on the board
/Power/~POWER_SWITCH_ANALOGUE_LOADS: R31.2, U6.3 (~EN1); also elsewhere on the board
/Power/~POWER_SWITCH_DIGITAL_LOGIC: R32.2, U6.4 (~EN2); also elsewhere on the board
GND: C8.2, C9.2, C10.2, C11.2, C29.2, C30.2, U6.1 (GND), U7.2 (GND); also elsewhere on the board
unnamed: C8.1, NT5.2, U6.2 (IN1)

Notes on the sheet:
Power switch and current limiter

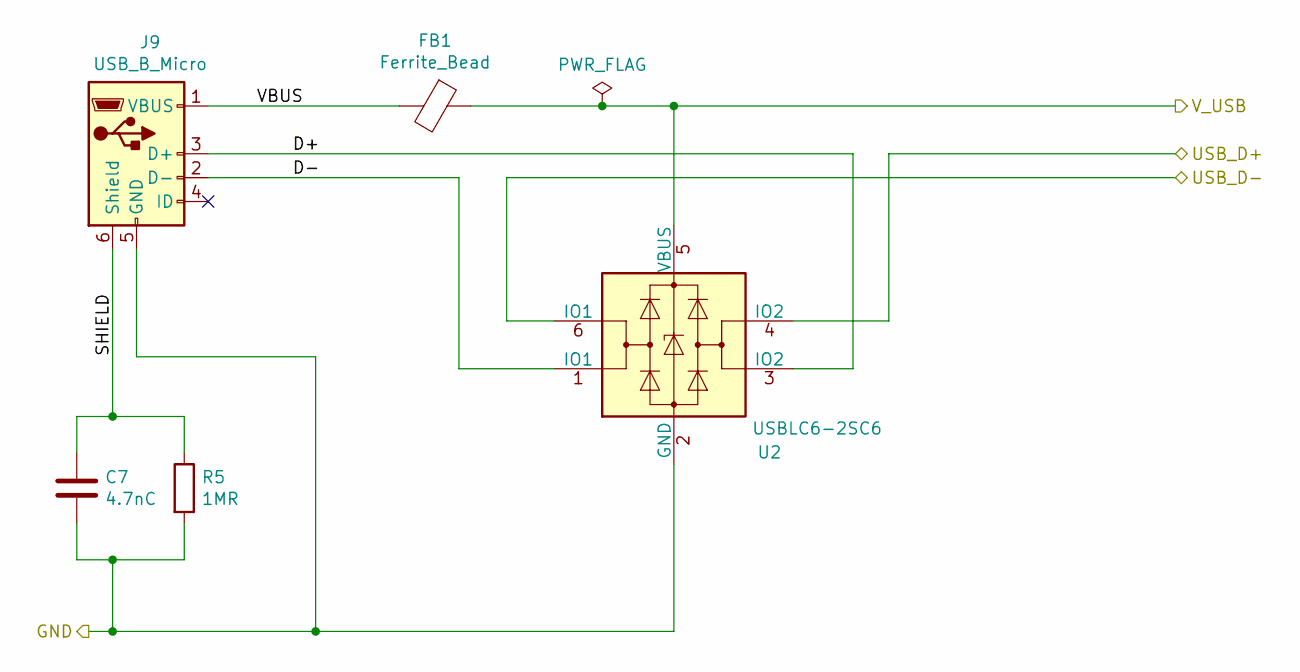
[picture p160: schematic USB.sch]

Parts:
C7: 4.7nC; C_0805_2012Metric_Pad1.15x1.40mm_HandSolder; Manufacturer Part Number C0805C472K3RAC7800
FB1: Ferrite_Bead; L_0805_2012Metric_Pad1.15x1.40mm_HandSolder; Manufacturer Part Number BLM21SP471SH1D
J9: USB_B_Micro; USB_Micro-B_Wuerth_629105150521; Manufacturer Part Number 629105150521
R5: 1MR; R_0805_2012Metric_Pad1.15x1.40mm_HandSolder; Manufacturer Part Number RC0805FR-071ML
U2: USBLC6-2SC6; SOT-23-6; Manufacturer Part Number USBLC6-2SC6

Connections:
/MCU/USB_D+: U2.4 (IO2); also elsewhere on the board
/MCU/USB_D-: U2.6 (IO1); also elsewhere on the board
/Power/V5_USB: FB1.1, U2.5 (VBUS); also elsewhere on the board
/USB Interface/D+: J9.3 (D+), U2.3 (IO2)
/USB Interface/D-: J9.2 (D-), U2.1 (IO1)
/USB Interface/SHIELD: C7.1, J9.6 (Shield), R5.1
/USB Interface/VBUS: FB1.2, J9.1 (VBUS)
GND: C7.2, J9.5 (GND), R5.2, U2.2 (GND); also elsewhere on the board

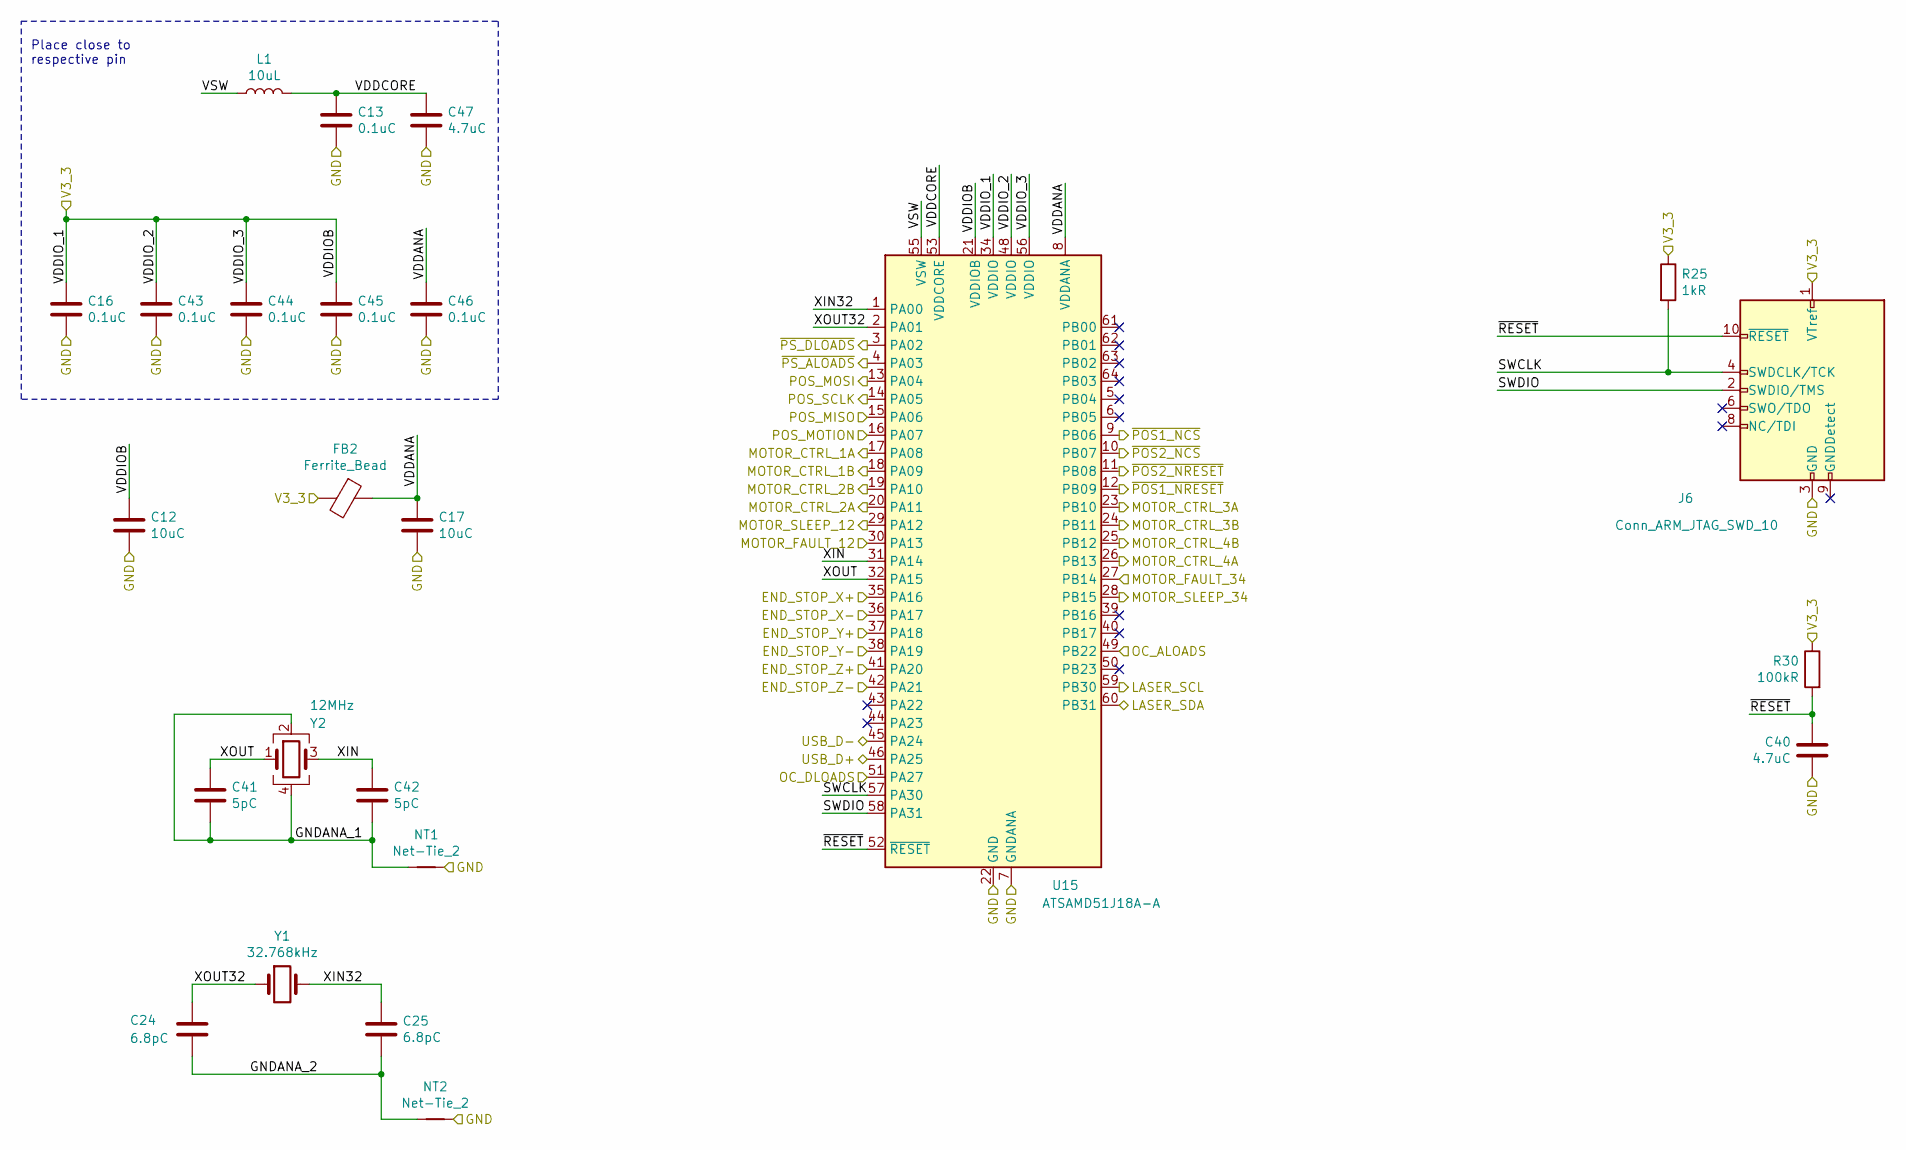
[picture p161: schematic MCU.sch]

Parts:
C12, C17: 10uC; C_0805_2012Metric_Pad1.15x1.40mm_HandSolder; Manufacturer Part Number CC0805MRX5R6BB106
C13, C16, C43, C44, C45, C46: 0.1uC; C_0805_2012Metric_Pad1.15x1.40mm_HandSolder; Manufacturer Part Number AC0805KRX7R7BB104
C24, C25: 6.8pC; C_0805_2012Metric_Pad1.15x1.40mm_HandSolder; Manufacturer Part Number C0805C689J5GACTU
C40, C47: 4.7uC; C_0805_2012Metric_Pad1.15x1.40mm_HandSolder; Manufacturer Part Number C0805C475K9PACTU
C41, C42: 5pC; C_0805_2012Metric_Pad1.15x1.40mm_HandSolder; Manufacturer Part Number 08055A5R0CAT2A
FB2: Ferrite_Bead; L_0805_2012Metric_Pad1.15x1.40mm_HandSolder; Manufacturer Part Number BLM21SP471SH1D
J6: Conn_ARM_JTAG_SWD_10; PinHeader_2x05_P1.27mm_Vertical; Manufacturer Part Number 3220-10-0100-00
L1: 10uL; L_Taiyo-Yuden_MD-3030; Manufacturer Part Number LQH3NPN100MJRL
NT1, NT2: Net-Tie_2; NetTie-2_SMD_Pad0.5mm
R25: 1kR; R_0805_2012Metric_Pad1.15x1.40mm_HandSolder; Manufacturer Part Number RC0805FR-071KL
R30: 100kR; R_0805_2012Metric_Pad1.15x1.40mm_HandSolder; Manufacturer Part Number RC0805FR-07100KL
U15: ATSAMD51J18A-A; TQFP-64_10x10mm_P0.5mm; Manufacturer Part Number ATSAMD51J18A-AUT
Y1: 32.768kHz; Crystal_SMD_2012-2Pin_2.0x1.2mm_HandSoldering; Manufacturer Part Number FC-12M 32.7680KA-X3
Y2: 12MHz; Crystal_SMD_3225-4Pin_3.2x2.5mm_HandSoldering; Manufacturer Part Number LFXTAL071742REEL

Connections:
/MCU/END_STOP_X+: U15.35 (PA16); also elsewhere on the board
/MCU/END_STOP_X-: U15.36 (PA17); also elsewhere on the board
/MCU/END_STOP_Y+: U15.37 (PA18); also elsewhere on the board
/MCU/END_STOP_Y-: U15.38 (PA19); also elsewhere on the board
/MCU/END_STOP_Z+: U15.41 (PA20); also elsewhere on the board
/MCU/END_STOP_Z-: U15.42 (PA21); also elsewhere on the board
/MCU/GNDANA_1: C41.2, C42.2, NT1.1, Y2.2, Y2.4
/MCU/GNDANA_2: C24.2, C25.2, NT2.1
/MCU/LASER_SCL: U15.59 (PB30); also elsewhere on the board
/MCU/LASER_SDA: U15.60 (PB31); also elsewhere on the board
/MCU/MOTOR_CTRL_1A: U15.17 (PA08); also elsewhere on the board
/MCU/MOTOR_CTRL_1B: U15.18 (PA09); also elsewhere on the board
/MCU/MOTOR_CTRL_2A: U15.20 (PA11); also elsewhere on the board
/MCU/MOTOR_CTRL_2B: U15.19 (PA10); also elsewhere on the board
/MCU/MOTOR_CTRL_3A: U15.23 (PB10); also elsewhere on the board
/MCU/MOTOR_CTRL_3B: U15.24 (PB11); also elsewhere on the board
/MCU/MOTOR_CTRL_4A: U15.26 (PB13); also elsewhere on the board
/MCU/MOTOR_CTRL_4B: U15.25 (PB12); also elsewhere on the board
/MCU/MOTOR_FAULT_12: U15.30 (PA13); also elsewhere on the board
/MCU/MOTOR_FAULT_34: U15.27 (PB14); also elsewhere on the board
/MCU/MOTOR_SLEEP_12: U15.29 (PA12); also elsewhere on the board
/MCU/MOTOR_SLEEP_34: U15.28 (PB15); also elsewhere on the board
/MCU/POS_MISO: U15.15 (PA06); also elsewhere on the board
/MCU/POS_MOSI: U15.13 (PA04); also elsewhere on the board
/MCU/POS_MOTION: U15.16 (PA07); also elsewhere on the board
/MCU/POS_SCLK: U15.14 (PA05); also elsewhere on the board
/MCU/SWCLK: J6.4 (SWDCLK/TCK), R25.2, U15.57 (PA30)
/MCU/SWDIO: J6.2 (SWDIO/TMS), U15.58 (PA31)
/MCU/USB_D+: U15.46 (PA25); also elsewhere on the board
/MCU/USB_D-: U15.45 (PA24); also elsewhere on the board
/MCU/V3_3: C12.1, C16.1, C43.1, C44.1, C45.1, FB2.2, J6.1 (VTref), R25.1, R30.1, U15.21 (VDDIOB), U15.34 (VDDIO), U15.48 (VDDIO), U15.56 (VDDIO); also elsewhere on the board
/MCU/VDDANA: C17.1, C46.1, FB2.1, U15.8 (VDDANA)
/MCU/VDDCORE: C13.1, C47.1, L1.2, U15.53 (VDDCORE)
/MCU/VSW: L1.1, U15.55 (VSW)
/MCU/XIN: C42.1, U15.31 (PA14), Y2.3
/MCU/XIN32: C25.1, U15.1 (PA00), Y1.2
/MCU/XOUT: C41.1, U15.32 (PA15), Y2.1
/MCU/XOUT32: C24.1, U15.2 (PA01), Y1.1
/MCU/~POS1_NCS: U15.9 (PB06); also elsewhere on the board
/MCU/~POS1_NRESET: U15.12 (PB09); also elsewhere on the board
/MCU/~POS2_NCS: U15.10 (PB07); also elsewhere on the board
/MCU/~POS2_NRESET: U15.11 (PB08); also elsewhere on the board
/MCU/~RESET: C40.1, J6.10 (~RESET~), R30.2, U15.52 (~RESET)
/Power/LOAD_OVERCURRENT_DIGITAL_LOGIC: U15.51 (PA27); also elsewhere on the board
/Power/LOAD_OVERCURRENT_MOTOR: U15.49 (PB22); also elsewhere on the board
/Power/~POWER_SWITCH_ANALOGUE_LOADS: U15.4 (PA03); also elsewhere on the board
/Power/~POWER_SWITCH_DIGITAL_LOGIC: U15.3 (PA02); also elsewhere on the board
GND: C12.2, C13.2, C16.2, C17.2, C40.2, C43.2, C44.2, C45.2, C46.2, C47.2, J6.3 (GND), J6.5 (GND), NT1.2, NT2.2, U15.7 (GNDANA), U15.22 (GND), U15.33 (GND), U15.47 (GND), U15.54 (GND); also elsewhere on the board

Notes on the sheet:
Place close to respective pin
