nunosousa/TelescopeMirrorTester/Tester/ECAD/ControllerBoard/ControllerBoard.kicad_pcb

## KiCad design _Deprecated/ECAD/ControllerBoard/ControllerBoard.kicad_pcb (continued)

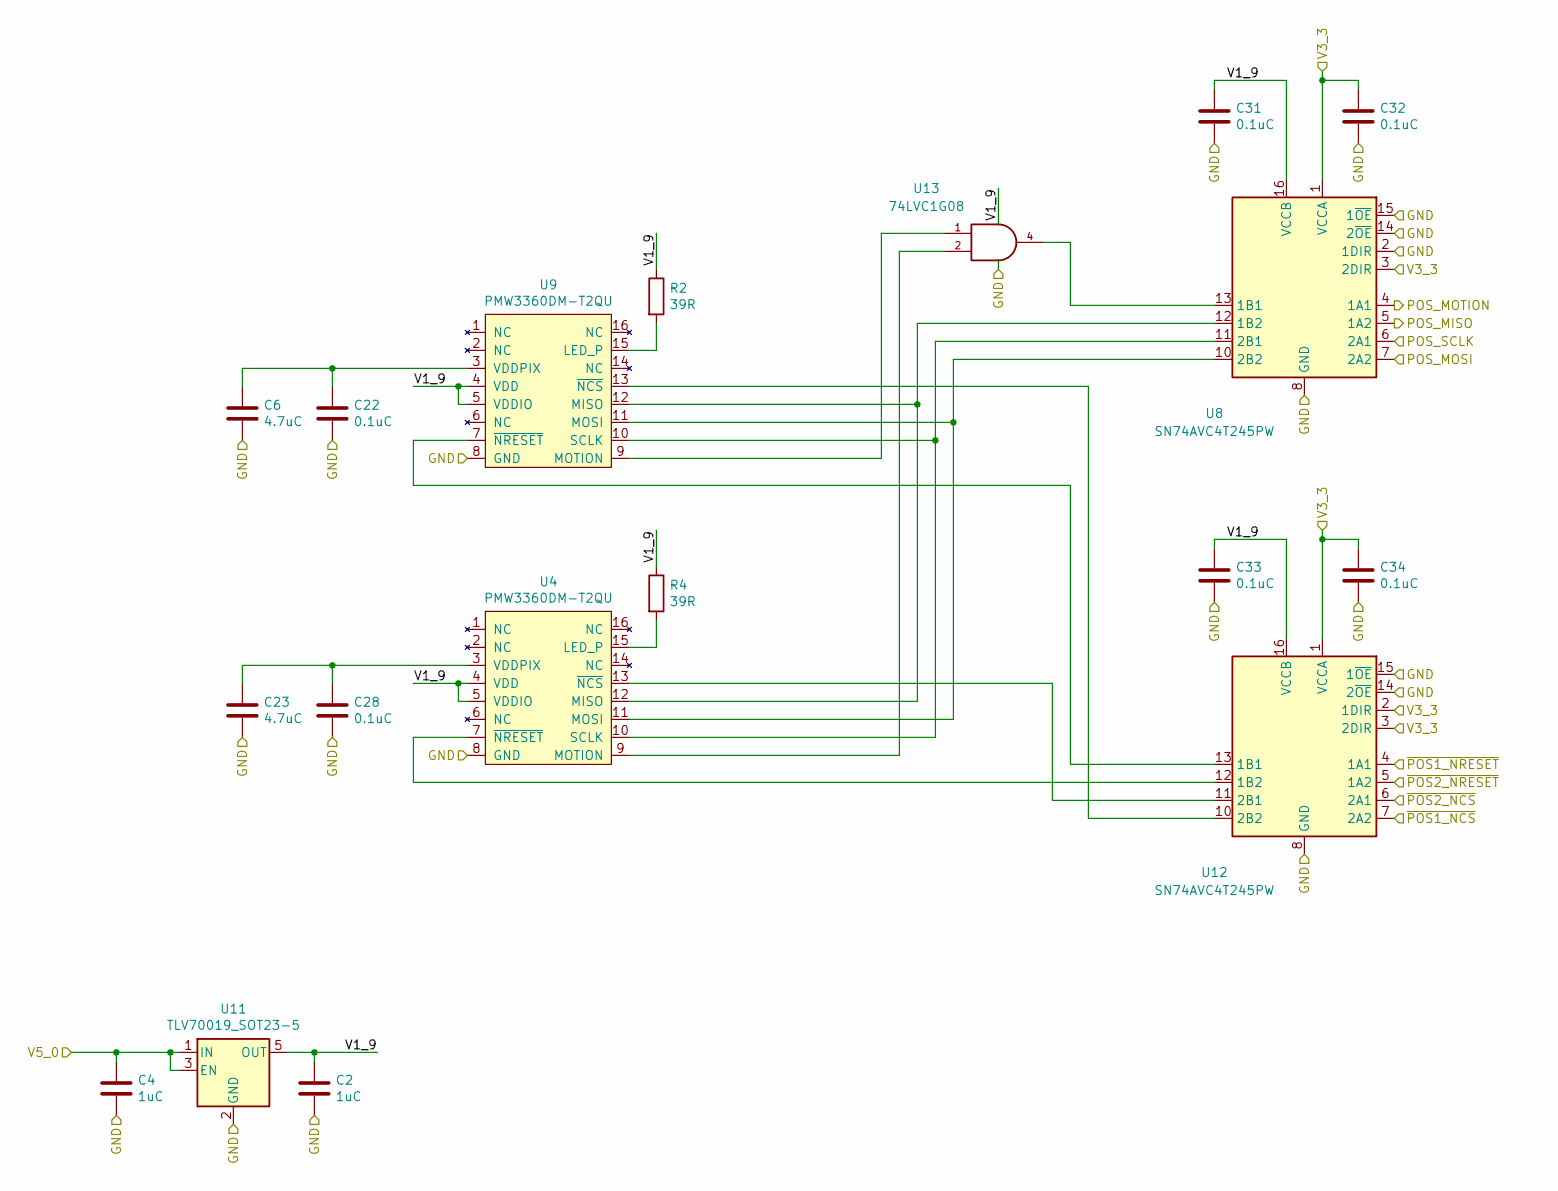
[picture p162: schematic position_sensor.sch]

Parts:
C2, C4: 1uC; C_0805_2012Metric_Pad1.15x1.40mm_HandSolder; Manufacturer Part Number CC0805MKX7R7BB105
C6, C23: 4.7uC; C_0805_2012Metric_Pad1.15x1.40mm_HandSolder; Manufacturer Part Number C0805C475K9PACTU
C22, C28, C31, C32, C33, C34: 0.1uC; C_0805_2012Metric_Pad1.15x1.40mm_HandSolder; Manufacturer Part Number AC0805KRX7R7BB104
R2, R4: 39R; R_0805_2012Metric_Pad1.15x1.40mm_HandSolder; Manufacturer Part Number RC0805FR-0739RL
U4, U9: PMW3360DM-T2QU
U8, U12: SN74AVC4T245PW; SOIC-16_3.9x9.9mm_P1.27mm; Manufacturer Part Number SN74AVC4T245DR
U11: TLV70019_SOT23-5; SOT-23-5; Manufacturer Part Number TLV70019DDCT
U13: 74LVC1G08; SOT-353_SC-70-5_Handsoldering; Manufacturer Part Number 74LVC1G08GW,125

Connections:
/MCU/POS_MISO: U8.5 (1A2); also elsewhere on the board
/MCU/POS_MOSI: U8.7 (2A2); also elsewhere on the board
/MCU/POS_MOTION: U8.4 (1A1); also elsewhere on the board
/MCU/POS_SCLK: U8.6 (2A1); also elsewhere on the board
/MCU/V3_3: C32.1, C34.1, U8.1 (VCCA), U8.3 (2DIR), U12.1 (VCCA), U12.2 (1DIR), U12.3 (2DIR); also elsewhere on the board
/MCU/~POS1_NCS: U12.7 (2A2); also elsewhere on the board
/MCU/~POS1_NRESET: U12.4 (1A1); also elsewhere on the board
/MCU/~POS2_NCS: U12.6 (2A1); also elsewhere on the board
/MCU/~POS2_NRESET: U12.5 (1A2); also elsewhere on the board
/Position Sensor/V5_0: C4.1, U11.1 (IN), U11.3 (EN); also elsewhere on the board
GND: C2.2, C4.2, C6.2, C22.2, C23.2, C28.2, C31.2, C32.2, C33.2, C34.2, U4.8 (GND), U8.2 (1DIR), U8.8 (GND), U8.9 (GND), U8.14 (2~OE), U8.15 (1~OE), U9.8 (GND), U11.2 (GND), U12.8 (GND), U12.9 (GND), U12.14 (2~OE), U12.15 (1~OE), U13.3 (GND); also elsewhere on the board
unnamed: C6.1, C22.1, U9.3 (VDDPIX)
unnamed: C23.1, C28.1, U4.3 (VDDPIX)
unnamed: R2.2, U9.15 (LED_P)
unnamed: R4.2, U4.15 (LED_P)
unnamed: U4.10 (SCLK), U8.11 (2B1), U9.10 (SCLK)
unnamed: U4.11 (MOSI), U8.10 (2B2), U9.11 (MOSI)
unnamed: U4.12 (MISO), U8.12 (1B2), U9.12 (MISO)
unnamed: U9.13 (~NCS), U12.10 (2B2)
unnamed: U4.13 (~NCS), U12.11 (2B1)
unnamed: U4.7 (~NRESET), U12.12 (1B2)
unnamed: U9.7 (~NRESET), U12.13 (1B1)
unnamed: U9.9 (MOTION), U13.1
unnamed: U4.9 (MOTION), U13.2
unnamed: U8.13 (1B1), U13.4
VCC: C2.1, C31.1, C33.1, R2.1, R4.1, U4.4 (VDD), U4.5 (VDDIO), U8.16 (VCCB), U9.4 (VDD), U9.5 (VDDIO), U11.5 (OUT), U12.16 (VCCB), U13.5 (VCC)

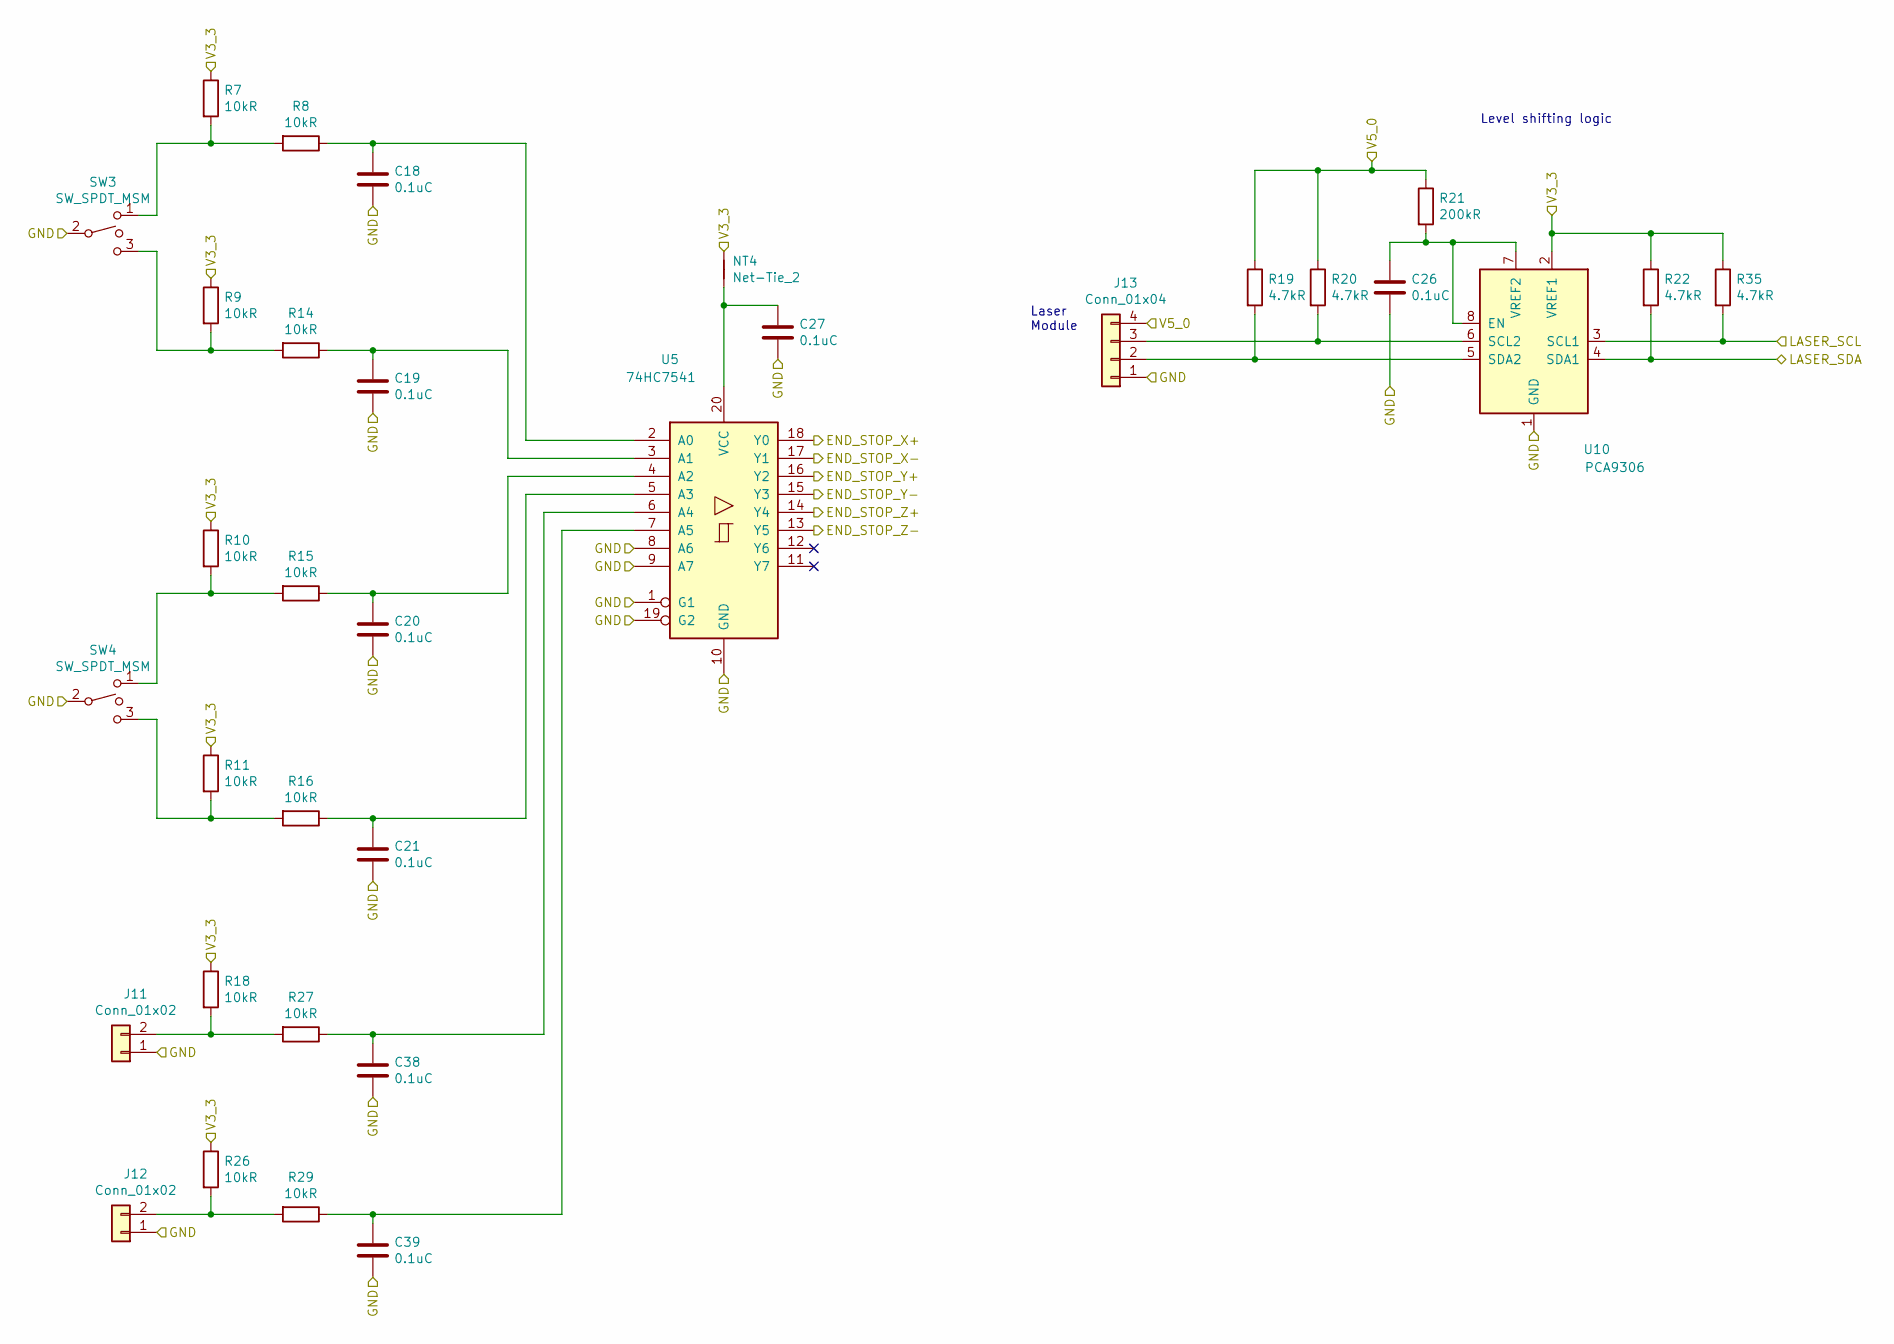
[picture p163: schematic SignalInputOuput.sch]

Parts:
C18, C19, C20, C21, C26, C27, C38, C39: 0.1uC; C_0805_2012Metric_Pad1.15x1.40mm_HandSolder; Manufacturer Part Number AC0805KRX7R7BB104
J11, J12: Conn_01x02; JST_PH_S2B-PH-K_1x02_P2.00mm_Horizontal; Manufacturer Part Number S2B-PH-K-S(LF)(SN)
J13: Conn_01x04; JST_PH_S4B-PH-K_1x04_P2.00mm_Horizontal; Manufacturer Part Number S4B-PH-K-S(LF)(SN)
NT4: Net-Tie_2; NetTie-2_SMD_Pad0.5mm
R7, R8, R9, R10, R11, R14, R15, R16, R18, R26, R27, R29: 10kR; R_0805_2012Metric_Pad1.15x1.40mm_HandSolder; Manufacturer Part Number RC0805FR-0710KL
R19, R20, R22, R35: 4.7kR; R_0805_2012Metric_Pad1.15x1.40mm_HandSolder; Manufacturer Part Number RC0805FR-074K7L
R21: 200kR; R_0805_2012Metric_Pad1.15x1.40mm_HandSolder; Manufacturer Part Number RC0805FR-07200KL
SW3, SW4: SW_SPDT_MSM; ESE24SH1; Manufacturer Part Number ESE-24SH1
U5: 74HC7541; SO-20_12.8x7.5mm_P1.27mm; Manufacturer Part Number 74HC7541D,118
U10: PCA9306; SO-8_3.9x4.9mm_P1.27mm; Manufacturer Part Number PCA9306D,118

Connections:
/MCU/END_STOP_X+: U5.18 (Y0); also elsewhere on the board
/MCU/END_STOP_X-: U5.17 (Y1); also elsewhere on the board
/MCU/END_STOP_Y+: U5.16 (Y2); also elsewhere on the board
/MCU/END_STOP_Y-: U5.15 (Y3); also elsewhere on the board
/MCU/END_STOP_Z+: U5.14 (Y4); also elsewhere on the board
/MCU/END_STOP_Z-: U5.13 (Y5); also elsewhere on the board
/MCU/LASER_SCL: R35.2, U10.3 (SCL1); also elsewhere on the board
/MCU/LASER_SDA: R22.2, U10.4 (SDA1); also elsewhere on the board
/MCU/V3_3: NT4.1, R7.1, R9.1, R10.1, R11.1, R18.1, R22.1, R26.1, R35.1, U10.2 (VREF1); also elsewhere on the board
/Position Sensor/V5_0: J13.4, R19.1, R20.1, R21.1; also elsewhere on the board
GND: C18.2, C19.2, C20.2, C21.2, C26.2, C27.2, C38.2, C39.2, J11.1, J12.1, J13.1, SW3.2, SW4.2, U5.1 (G1), U5.8 (A6), U5.9 (A7), U5.10 (GND), U5.19 (G2), U10.1 (GND); also elsewhere on the board
unnamed: C18.1, R8.1, U5.2 (A0)
unnamed: C19.1, R14.1, U5.3 (A1)
unnamed: C20.1, R15.1, U5.4 (A2)
unnamed: C21.1, R16.1, U5.5 (A3)
unnamed: C26.1, R21.2, U10.7 (VREF2), U10.8 (EN)
unnamed: C27.1, NT4.2, U5.20 (VCC)
unnamed: C38.1, R27.1, U5.6 (A4)
unnamed: C39.1, R29.1, U5.7 (A5)
unnamed: J11.2, R18.2, R27.2
unnamed: J12.2, R26.2, R29.2
unnamed: J13.2, R19.2, U10.5 (SDA2)
unnamed: J13.3, R20.2, U10.6 (SCL2)
unnamed: R7.2, R8.2, SW3.1
unnamed: R10.2, R15.2, SW4.1
unnamed: R11.2, R16.2, SW4.3
unnamed: R9.2, R14.2, SW3.3

Notes on the sheet:
Laser Module
Level shifting logic

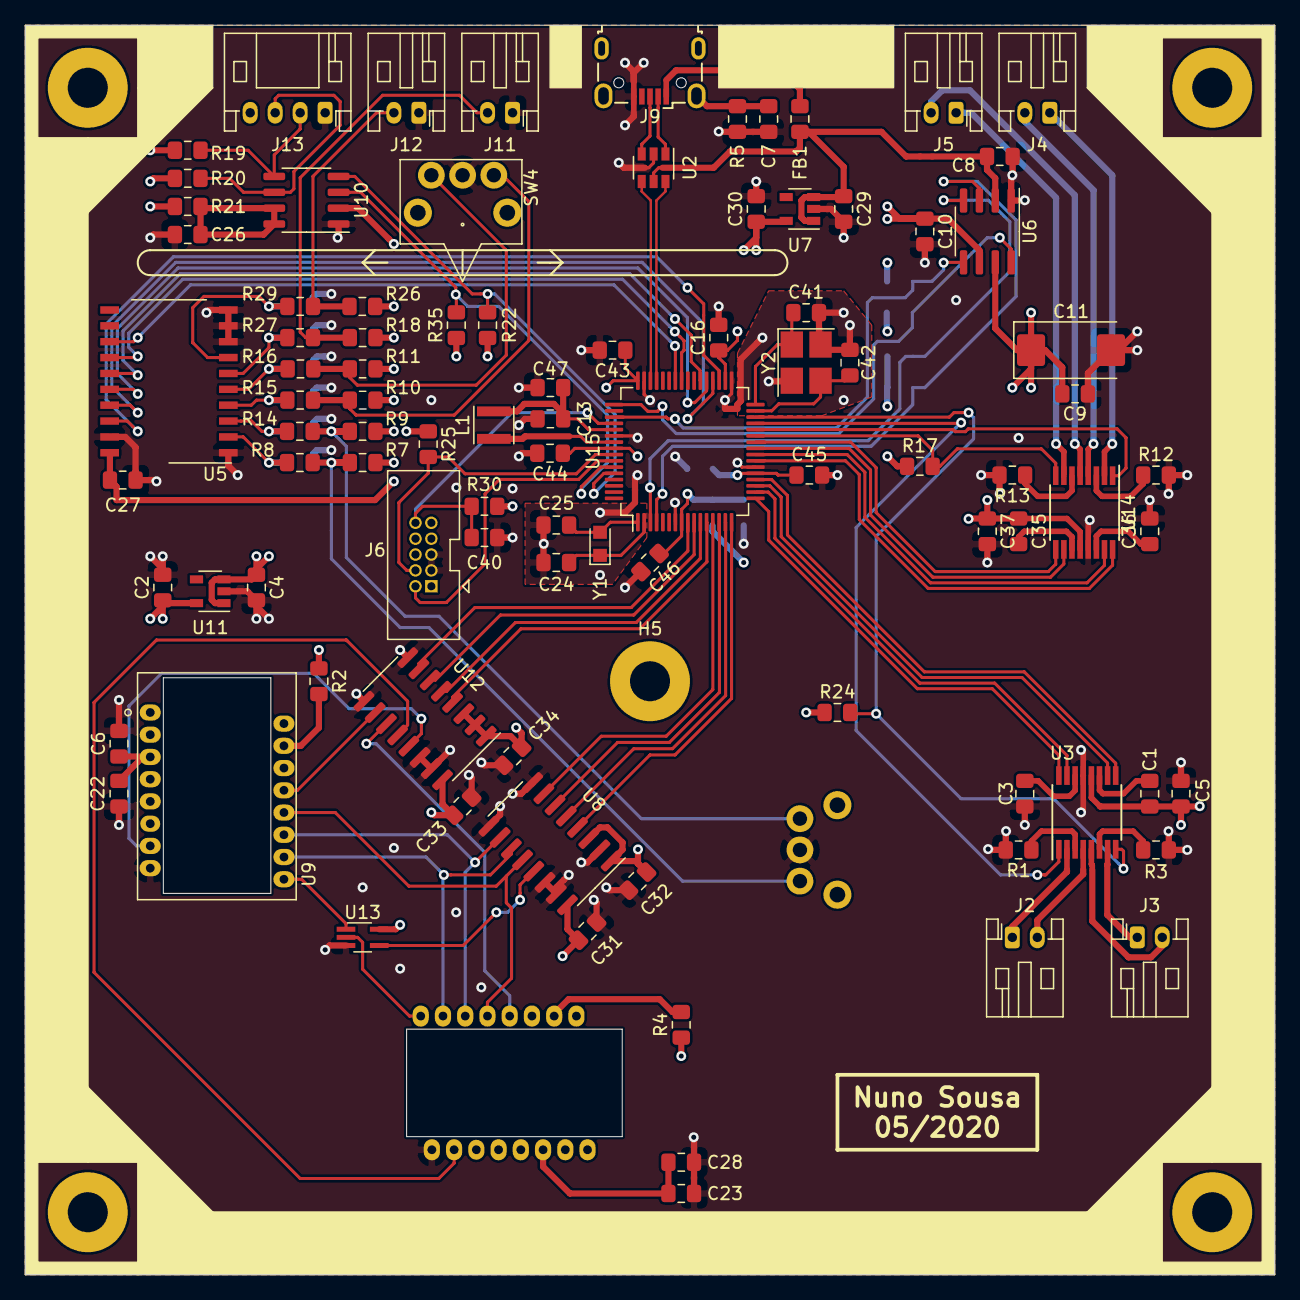
[picture p164: board ControllerBoard.kicad_pcb from above]

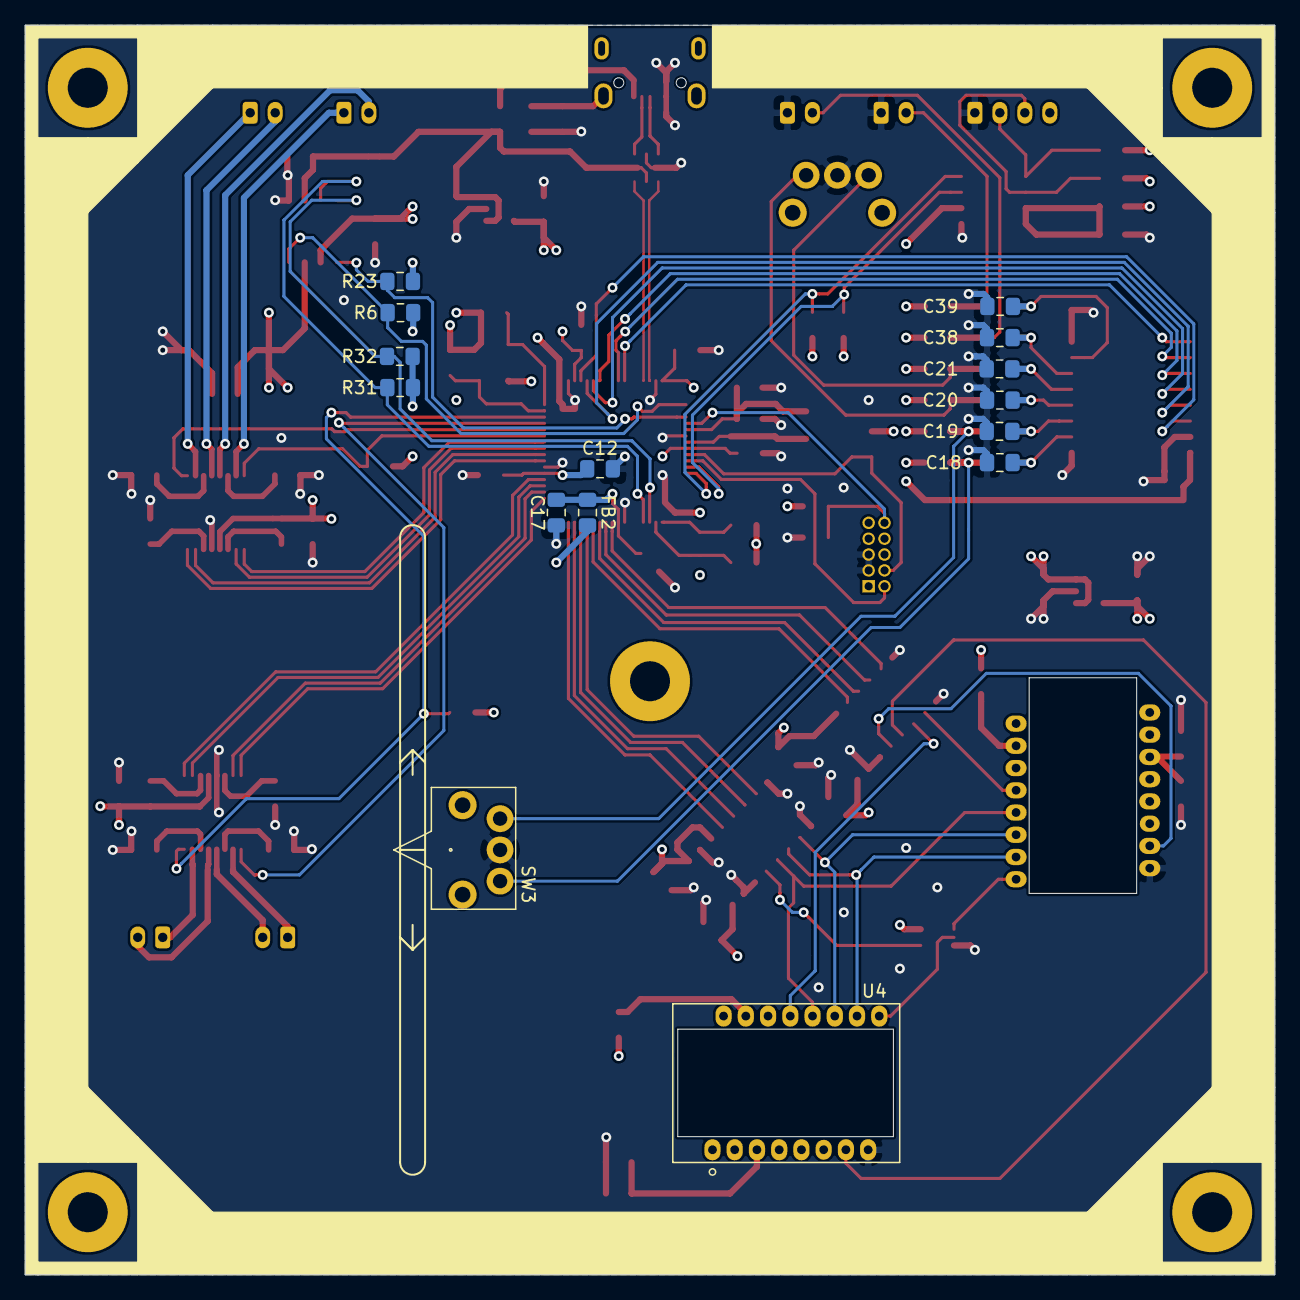
[picture p165: board ControllerBoard.kicad_pcb from below]

Board: 4 copper layers, 100.0 x 100.0 mm, 116 parts (15 on the bottom side), 103 nets.
