nunosousa/TelescopeMirrorTester/ECAD/LightSourceLED/LightSource.kicad_pcb

## KiCad design ECAD/LightSourceLED/LightSource.kicad_pcb (2021-10-22)

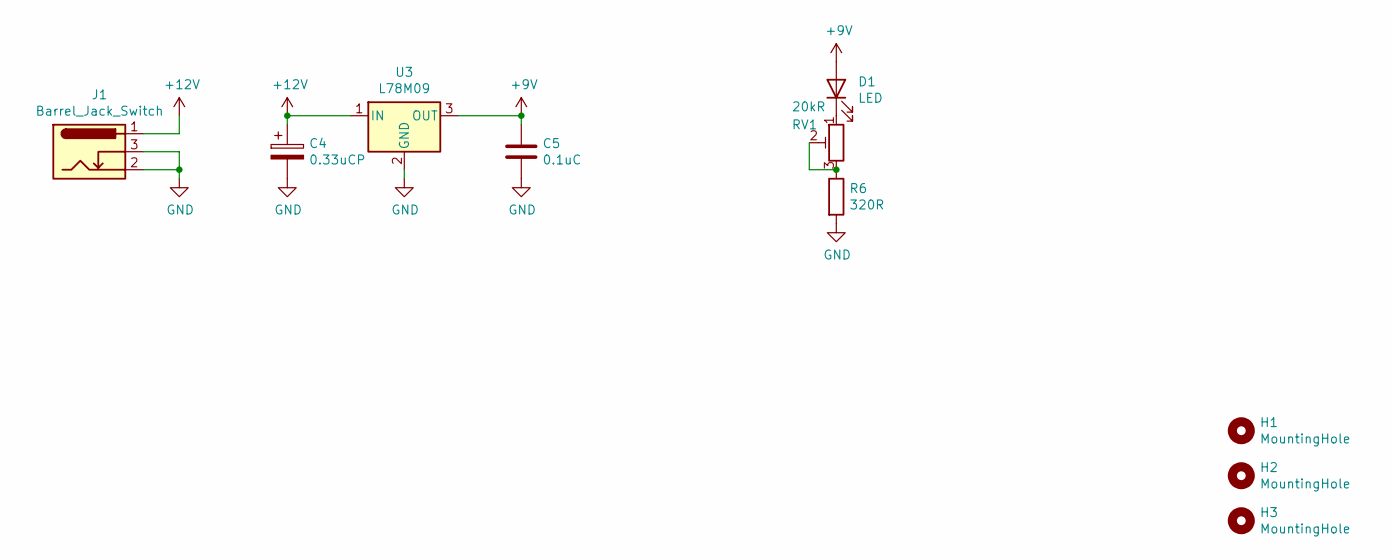
[picture p166: schematic LightSource.sch]

Parts:
C4: 0.33uCP; CP_EIA-3216-18_Kemet-A_Pad1.58x1.35mm_HandSolder; Manufacturer Part Number TAJA334K035RNJ
C5: 0.1uC; C_0805_2012Metric_Pad1.18x1.45mm_HandSolder; Manufacturer Part Number CC0805KRX7R8BB104
D1: LED; LED_D3.0mm; Manufacturer Part Number Varies
H1, H2, H3: MountingHole; MountingHole_3.2mm_M3_Pad; Manufacturer Part Number N/A
J1: Barrel_Jack_Switch; BarrelJack_Horizontal; Manufacturer Part Number DC-005-20A
R6: 320R; R_1206_3216Metric_Pad1.30x1.75mm_HandSolder; Manufacturer Part Number Varies
RV1: 20kR; Potentiometer_Bourns_3362P_Vertical; Manufacturer Part Number 3362P-1-203LF
U3: L78M09; TO-252-2; Manufacturer Part Number L78M09ABDT-TR

Connections:
+9V: C5.1, D1.2 (A), U3.3 (OUT)
+12V: C4.1, J1.1, U3.1 (IN)
GND: C4.2, C5.2, J1.2, J1.3, R6.2, U3.2 (GND)
unnamed: D1.1 (K), RV1.1
unnamed: R6.1, RV1.2, RV1.3

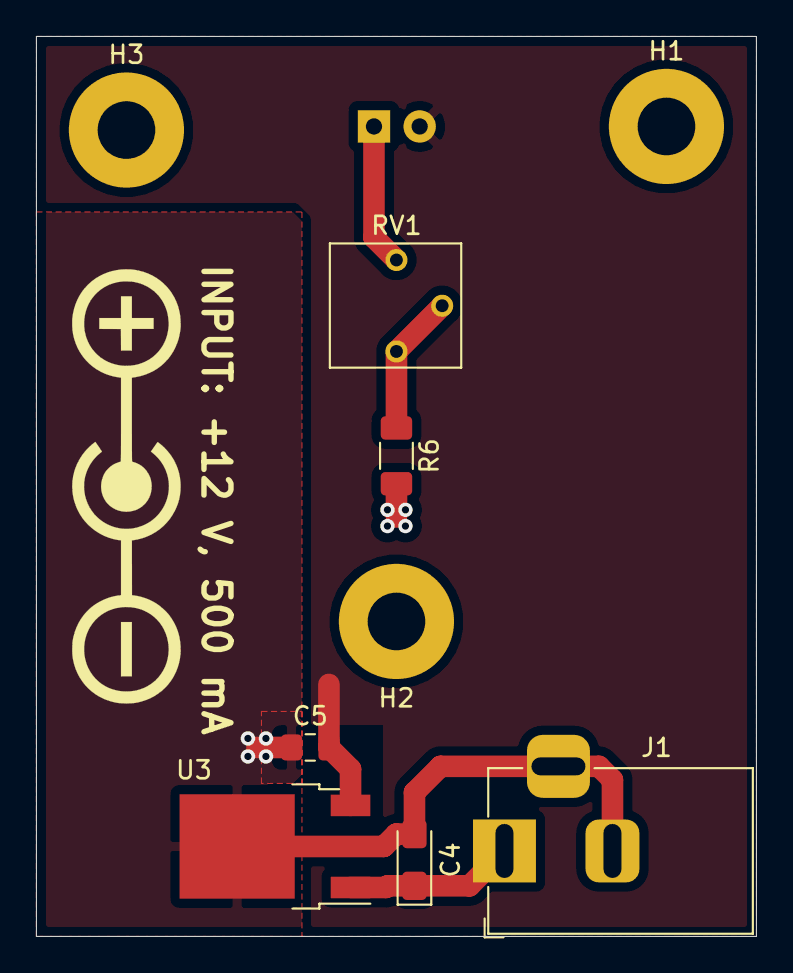
[picture p167: board ECAD/LightSourceLED/LightSource.kicad_pcb from above]

Board: 2 copper layers, 40.0 x 50.0 mm, 10 parts (1 on the bottom side), 5 nets.
