nunosousa/TelescopeMirrorTester/ECAD/BDCMotorControlShield/BDCMotorControlShield.kicad_pcb

## KiCad design ECAD/BDCMotorControlShield/BDCMotorControlShield.kicad_pcb (2022-12-04)

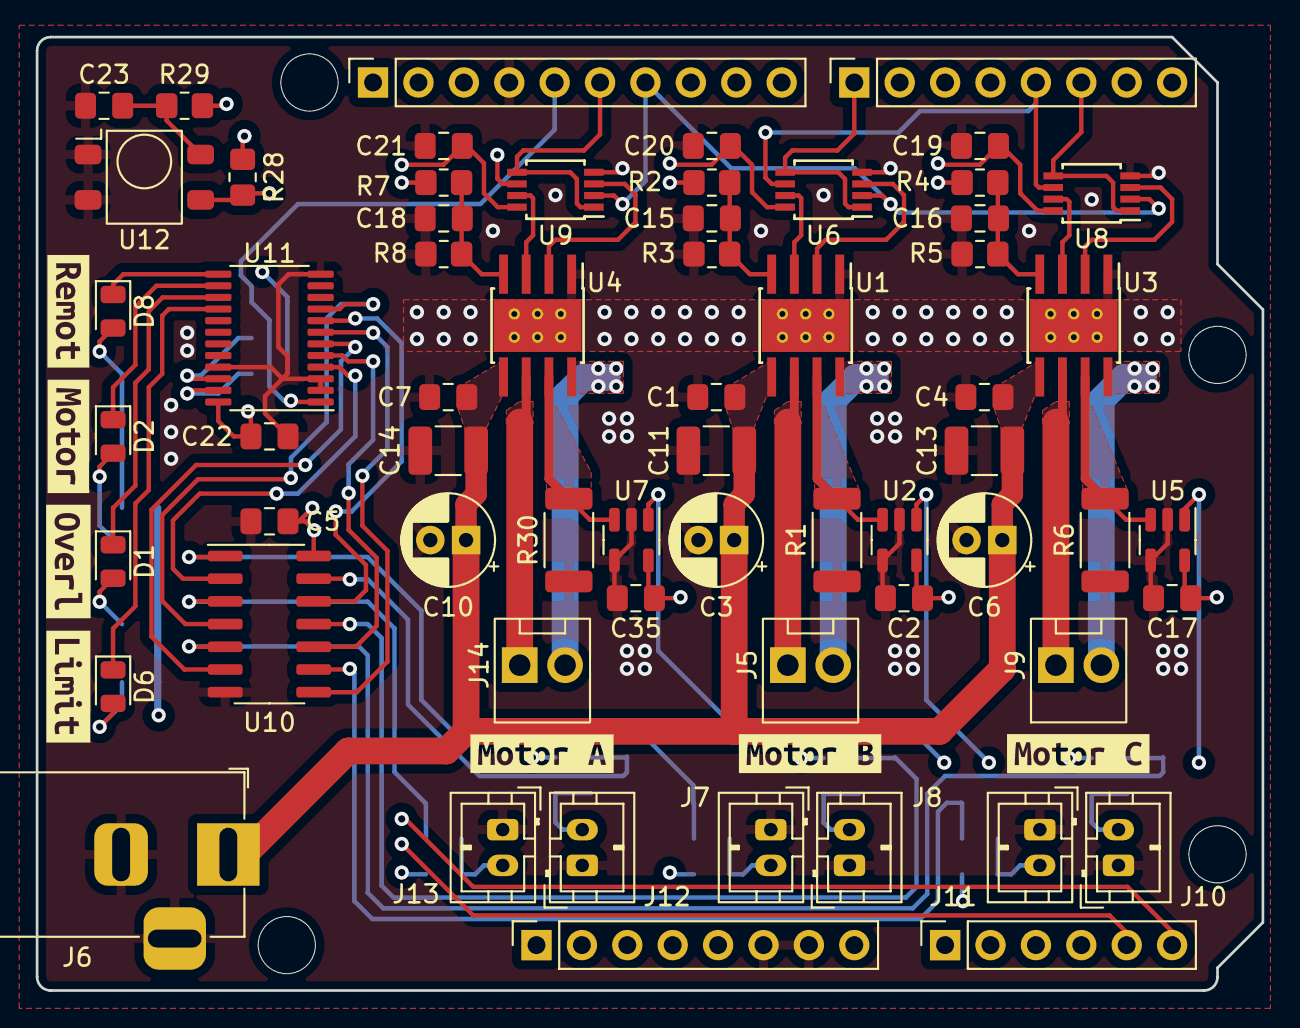
[picture p168: board BDCMotorControlShield.kicad_pcb from above]

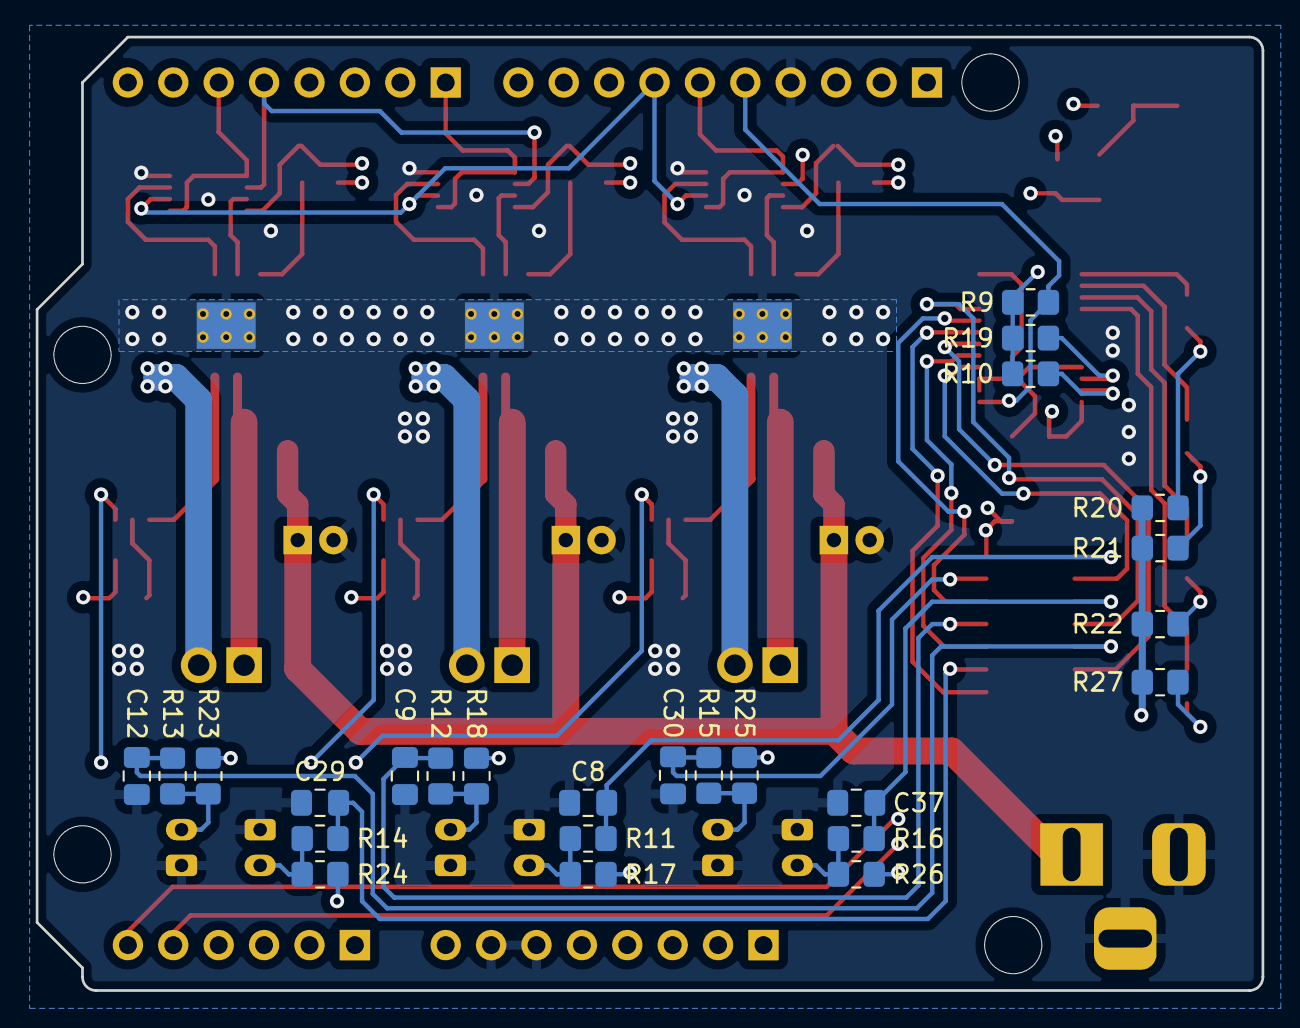
[picture p169: board BDCMotorControlShield.kicad_pcb from below]

Board: 4 copper layers, 68.6 x 53.3 mm, 98 parts (25 on the bottom side), 60 nets.

Parts:
C1, C2, C4, C5, C7, C8, C9, C12, C15, C16, C17, C18, C19, C20, C21, C22, C29, C30, C35, C37: 0.1uC; C_0805_2012Metric_Pad1.18x1.45mm_HandSolder
C3, C6, C10: 47uC; CP_Radial_D5.0mm_P2.00mm
C11, C13, C14: 10uC; C_1210_3225Metric_Pad1.33x2.70mm_HandSolder
C23: 4.7uC; C_0805_2012Metric_Pad1.18x1.45mm_HandSolder
D1, D2, D6, D8: LED; LED_0805_2012Metric
J1: Power; PinSocket_1x08_P2.54mm_Vertical
J2: Digital/PWM; PinSocket_1x10_P2.54mm_Vertical
J3: Analog; PinSocket_1x06_P2.54mm_Vertical
J4: Digital/PWM; PinSocket_1x08_P2.54mm_Vertical
J5, J9, J14: Motor connector; HC-2510-2A
J6: Barrel_Jack_Switch; BarrelJack_Horizontal
J7, J8, J10, J11, J12, J13: Limit switch; JST_PH_B2B-PH-K_1x02_P2.00mm_Vertical
MH1, MH2, MH3, MH4: MountingHole_3.2mm
R1, R6, R30: 250mR; R_2010_5025Metric
R2, R3, R4, R5, R7, R8, R9, R10, R11, R12, R13, R14, R15, R16, R17, R18, R19, R23, R24, R25, R26, R28: 10kR; R_0805_2012Metric_Pad1.20x1.40mm_HandSolder
R20, R21, R22, R27: 1kR; R_0805_2012Metric_Pad1.20x1.40mm_HandSolder
R29: 160R; R_0805_2012Metric_Pad1.20x1.40mm_HandSolder
U1, U3, U4: DRV8870DDA; Texas_HTSOP-8-1EP_3.9x4.9mm_P1.27mm_EP2.95x4.9mm_Mask2.4x3.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
U2, U5, U7: INA180A1; SOT-23-5
U6, U8, U9: 74HC2G08; TSSOP-8_3x3mm_P0.65mm
U10: 74HC14; SO-14_3.9x8.65mm_P1.27mm
U11: PCA9535PW; TSSOP-24_4.4x7.8mm_P0.65mm
U12: IRM-H6XX
kibuzzard-6387CFDB: G***; kibuzzard-6387CFDB
kibuzzard-6387D00C: G***; kibuzzard-6387D00C
kibuzzard-6387D004: G***; kibuzzard-6387D004
kibuzzard-6387D23A: G***; kibuzzard-6387D23A
kibuzzard-6387D063: G***; kibuzzard-6387D063
kibuzzard-6387D241: G***; kibuzzard-6387D241
kibuzzard-6387D249: G***; kibuzzard-6387D249

Connections:
+5V: C2.1, C5.1, C17.1, C19.1, C20.1, C21.1, C22.1, C35.1, J1.5, R2.1, R4.1, R7.1, R9.1, R10.1, R17.1, R18.1, R19.1, R20.1, R21.1, R22.1, R23.1, R24.1, R25.1, R26.1, R27.1, R28.1, R29.2, U2.5 (V+), U5.5 (V+), U6.8 (VCC), U7.5 (V+), U8.8 (VCC), U9.8 (VCC), U10.14 (VCC), U11.24 (VDD)
+12V: C1.1, C3.1, C4.1, C6.1, C7.1, C10.1, C11.1, C13.1, C14.1, J6.1, U1.5 (VM), U3.5 (VM), U4.5 (VM)
/2: J4.6, U8.1, U8.5
/7: J4.1, U6.1, U6.5
/8: J2.10, R28.2, U12.3 (OUT)
/12: J2.6, U9.1, U9.5
/13: J2.5, R9.2, U11.1 (~INT)
/*3: J4.5, U6.6, U8.6, U9.6
/*11: J2.7, U6.2, U8.2, U9.2
/A0: J3.1, U7.1
/A1: J3.2, U2.1
/A2: J3.3, U5.1
/H-bridge #1/PWM1: U1.3 (IN1), U6.7
/H-bridge #1/PWM2: U1.2 (IN2), U6.3
/H-bridge #2/PWM1: U3.3 (IN1), U8.7
/H-bridge #2/PWM2: U3.2 (IN2), U8.3
/H-bridge #3/PWM1: U4.3 (IN1), U9.7
/H-bridge #3/PWM2: U4.2 (IN2), U9.3
/LED00: D8.1 (K), U11.13 (IO1_0)
/LED01: D2.1 (K), U11.14 (IO1_1)
/LED02: D1.1 (K), U11.15 (IO1_2)
/LED03: D6.1 (K), U11.16 (IO1_3)
/LIM_SW00: U10.2, U11.4 (IO0_0)
/LIM_SW01: U10.10, U11.5 (IO0_1)
/LIM_SW02: U10.6, U11.6 (IO0_2)
/LIM_SW03: U10.8, U11.7 (IO0_3)
/LIM_SW04: U10.12, U11.8 (IO0_4)
/LIM_SW05: U10.4, U11.9 (IO0_5)
/SCL/A5: J2.1, J3.6, R19.2, U11.22 (SCL)
/SDA/A4: J2.2, J3.5, R10.2, U11.23 (SDA)
GND: C1.2, C2.2, C3.2, C4.2, C5.2, C6.2, C7.2, C8.2, C9.2, C10.2, C11.2, C12.2, C13.2, C14.2, C15.2, C16.2, C17.2, C18.2, C19.2, C20.2, C21.2, C22.2, C23.2, C29.2, C30.2, C35.2, C37.2, J1.6, J1.7, J2.4, J6.2, J6.3, J7.1, J8.1, J10.1, J11.1, J12.1, J13.1, R1.1, R3.2, R5.2, R6.1, R8.2, R30.1, U1.1 (GND), U1.9 (GND), U2.2 (GND), U2.4 (-), U3.1 (GND), U3.9 (GND), U4.1 (GND), U4.9 (GND), U5.2 (GND), U5.4 (-), U6.4 (GND), U7.2 (GND), U7.4 (-), U8.4 (GND), U9.4 (GND), U10.7 (GND), U11.2 (A1), U11.3 (A2), U11.12 (VSS), U11.21 (A0), U12.1 (GND), U12.2 (GND)
unnamed: C8.1, R11.2, U10.1
unnamed: C9.1, R12.2, U10.11
unnamed: C12.1, R13.2, U10.5
unnamed: C15.1, R2.2, R3.1, U1.4 (VREF)
unnamed: C16.1, R4.2, R5.1, U3.4 (VREF)
unnamed: C18.1, R7.2, R8.1, U4.4 (VREF)
unnamed: C23.1, R29.1, U12.4 (Vs)
unnamed: C29.1, R14.2, U10.9
unnamed: C30.1, R15.2, U10.13
unnamed: C37.1, R16.2, U10.3
unnamed: D1.2 (A), R22.2
unnamed: D2.2 (A), R21.2
unnamed: D6.2 (A), R27.2
unnamed: D8.2 (A), R20.2
unnamed: J5.1, U1.6 (OUT1)
unnamed: J5.2, U1.8 (OUT2)
unnamed: J7.2, R11.1, R17.2
unnamed: J8.2, R12.1, R18.2
unnamed: J9.1, U3.6 (OUT1)
unnamed: J9.2, U3.8 (OUT2)
unnamed: J10.2, R13.1, R23.2
unnamed: J11.2, R14.1, R24.2
unnamed: J12.2, R15.1, R25.2
unnamed: J13.2, R16.1, R26.2
unnamed: J14.1, U4.6 (OUT1)
unnamed: J14.2, U4.8 (OUT2)
unnamed: R1.2, U1.7 (ISEN), U2.3 (+)
unnamed: R6.2, U3.7 (ISEN), U5.3 (+)
unnamed: R30.2, U4.7 (ISEN), U7.3 (+)
