nunosousa/TelescopeMirrorTester/ECAD/PowerDeliveryBoard/PowerDeliveryBoard.kicad_pcb

## KiCad design ECAD/PowerDeliveryBoard/PowerDeliveryBoard.kicad_pcb (2022-12-02)

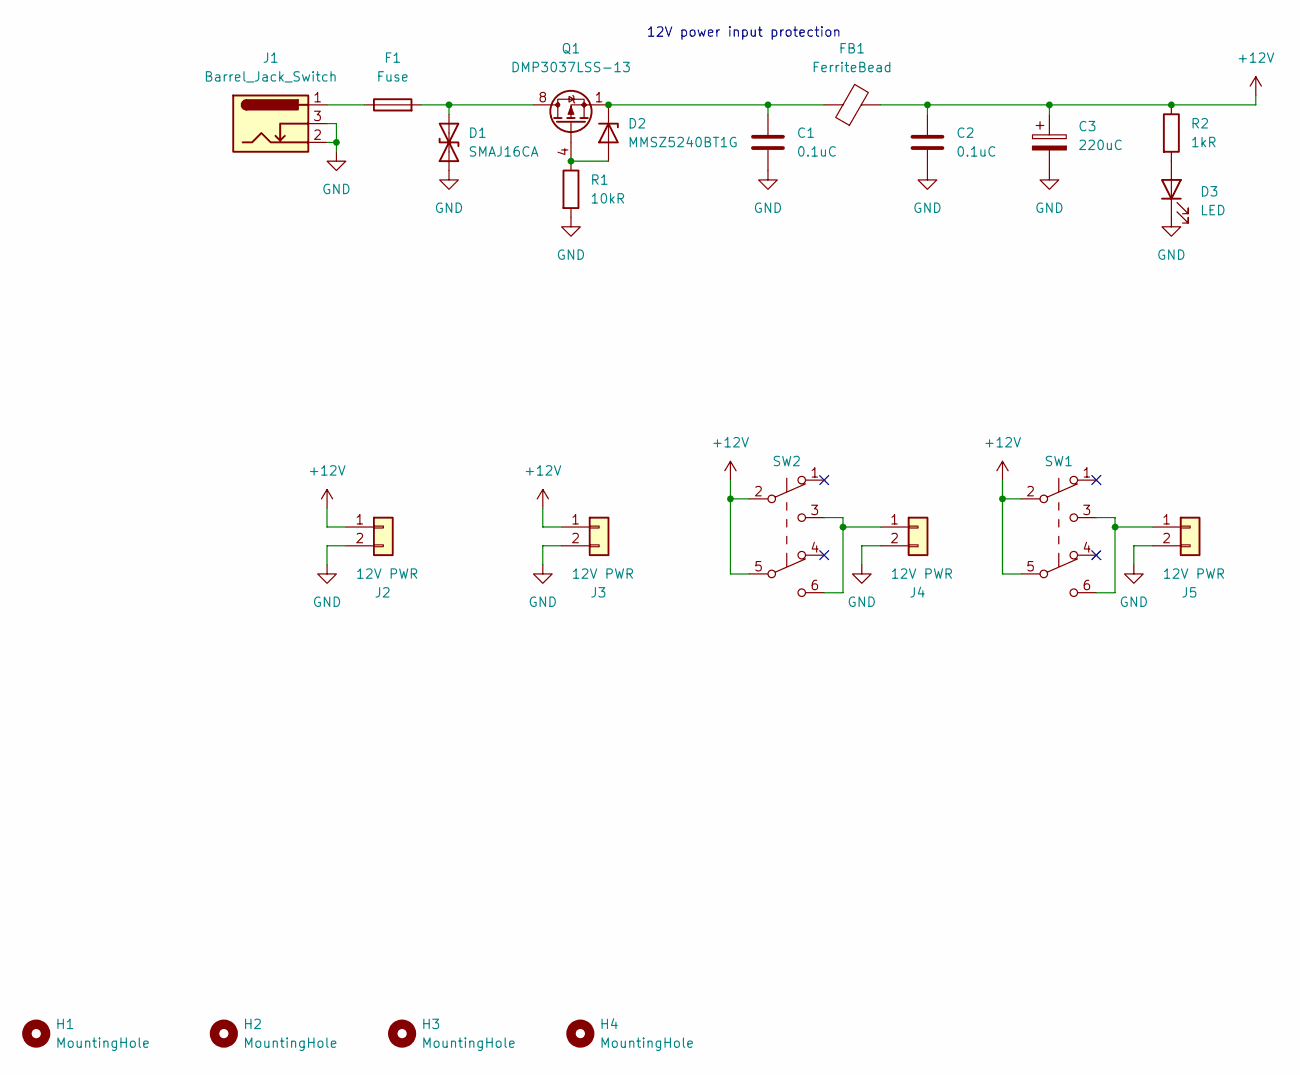
[picture p170: schematic PowerDeliveryBoard.kicad_sch]

Parts:
C1, C2: 0.1uC; C_0805_2012Metric_Pad1.18x1.45mm_HandSolder; MPN CL21B104KBCNNNC
C3: 220uC; CP_Radial_D8.0mm_P3.50mm; MPN 25YXF220MEFC8X11.5
D1: SMAJ16CA; D_SMA; MPN SMAJ16CA-13-F
D2: MMSZ5240BT1G; D_SOD-123; MPN MMSZ5240BT1G
D3: LED; D_0805_2012Metric_Pad1.15x1.40mm_HandSolder; MPN 17-21SYGC/S530-E3/TR8
F1: Fuse; Fuseholder_Cylinder-5x20mm_Stelvio-Kontek_PTF78_Horizontal_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; MPN PTF-77
FB1: FerriteBead; L_1806_4516Metric; MPN BLM41PG600SN1L
H1, H2, H3, H4: MountingHole; MountingHole_5.3mm_M5; MPN N/A
J1: Barrel_Jack_Switch; BarrelJack_DC-042C-W-2.5_Horizontal; MPN DC-042C-W-2.5
J2, J3, J4, J5: 12V PWR; HC-2510-2A; MPN HC-2510-2A
Q1: DMP3037LSS-13; SOIC-8_3.9x4.9mm_P1.27mm; MPN DMP3037LSS-13
R1: 10kR; R_0805_2012Metric_Pad1.20x1.40mm_HandSolder; MPN RC0805FR-0710KL
R2: 1kR; R_0805_2012Metric_Pad1.20x1.40mm_HandSolder; MPN AC0805FR-7W1KL
SW1, SW2: SW_Push_DPDT; SW_Push_2P2T_Toggle_Generic_5_8_x_5_8; MPN PB22E60L

Connections:
+12V: C2.2, C3.1, FB1.2, J2.1, J3.1, R2.1, SW1.2 (B), SW1.5 (B), SW2.2 (B), SW2.5 (B)
GND: C1.1, C2.1, C3.2, D1.1 (A1), D3.1 (K), J1.2, J1.3, J2.2, J3.2, J4.2, J5.2, R1.2
unnamed: C1.2, D2.1 (K), FB1.1, Q1.1 (S), Q1.2 (S), Q1.3 (S)
unnamed: D1.2 (A2), F1.2, Q1.5 (D), Q1.6 (D), Q1.7 (D), Q1.8 (D)
unnamed: D2.2 (A), Q1.4 (G), R1.1
unnamed: F1.1, J1.1
unnamed: J4.1, SW2.3 (C), SW2.6 (C)
unnamed: J5.1, SW1.3 (C), SW1.6 (C)
unnamed: D3.2 (A), R2.2

Notes on the sheet:
12V power input protection

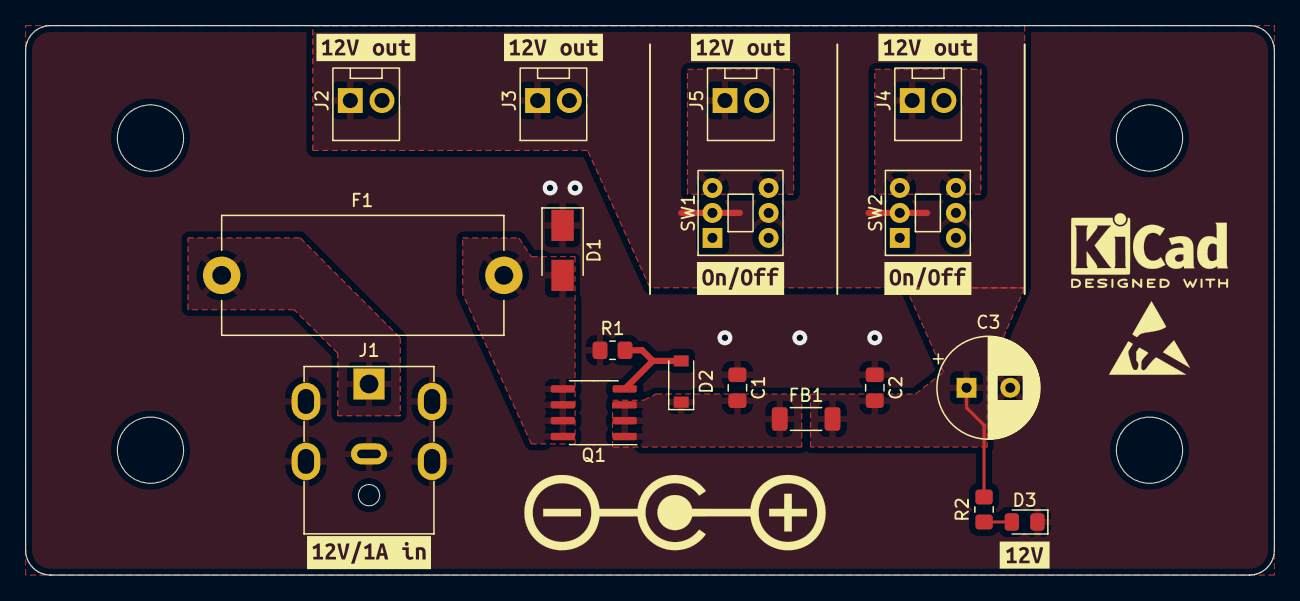
[picture p171: board PowerDeliveryBoard.kicad_pcb from above]

Board: 2 copper layers, 100.0 x 44.0 mm, 30 parts (0 on the bottom side), 9 nets.

Other parts of the board:
kibuzzard-6388F516: G***; kibuzzard-6388F516
kibuzzard-63891CDB: G***; kibuzzard-63891CDB
kibuzzard-638910D3, kibuzzard-638910D3#2: G***; kibuzzard-638910D3
kibuzzard-638911E5: G***; kibuzzard-638911E5
kibuzzard-638911EA: G***; kibuzzard-638911EA
kibuzzard-6389104C, kibuzzard-6389104C#2: G***; kibuzzard-6389104C
