nunosousa/TelescopeMirrorTester/ECAD/LightSource/LightSource.kicad_pcb

## KiCad design ECAD/LightSource/LightSource.kicad_pcb (2021-10-22)

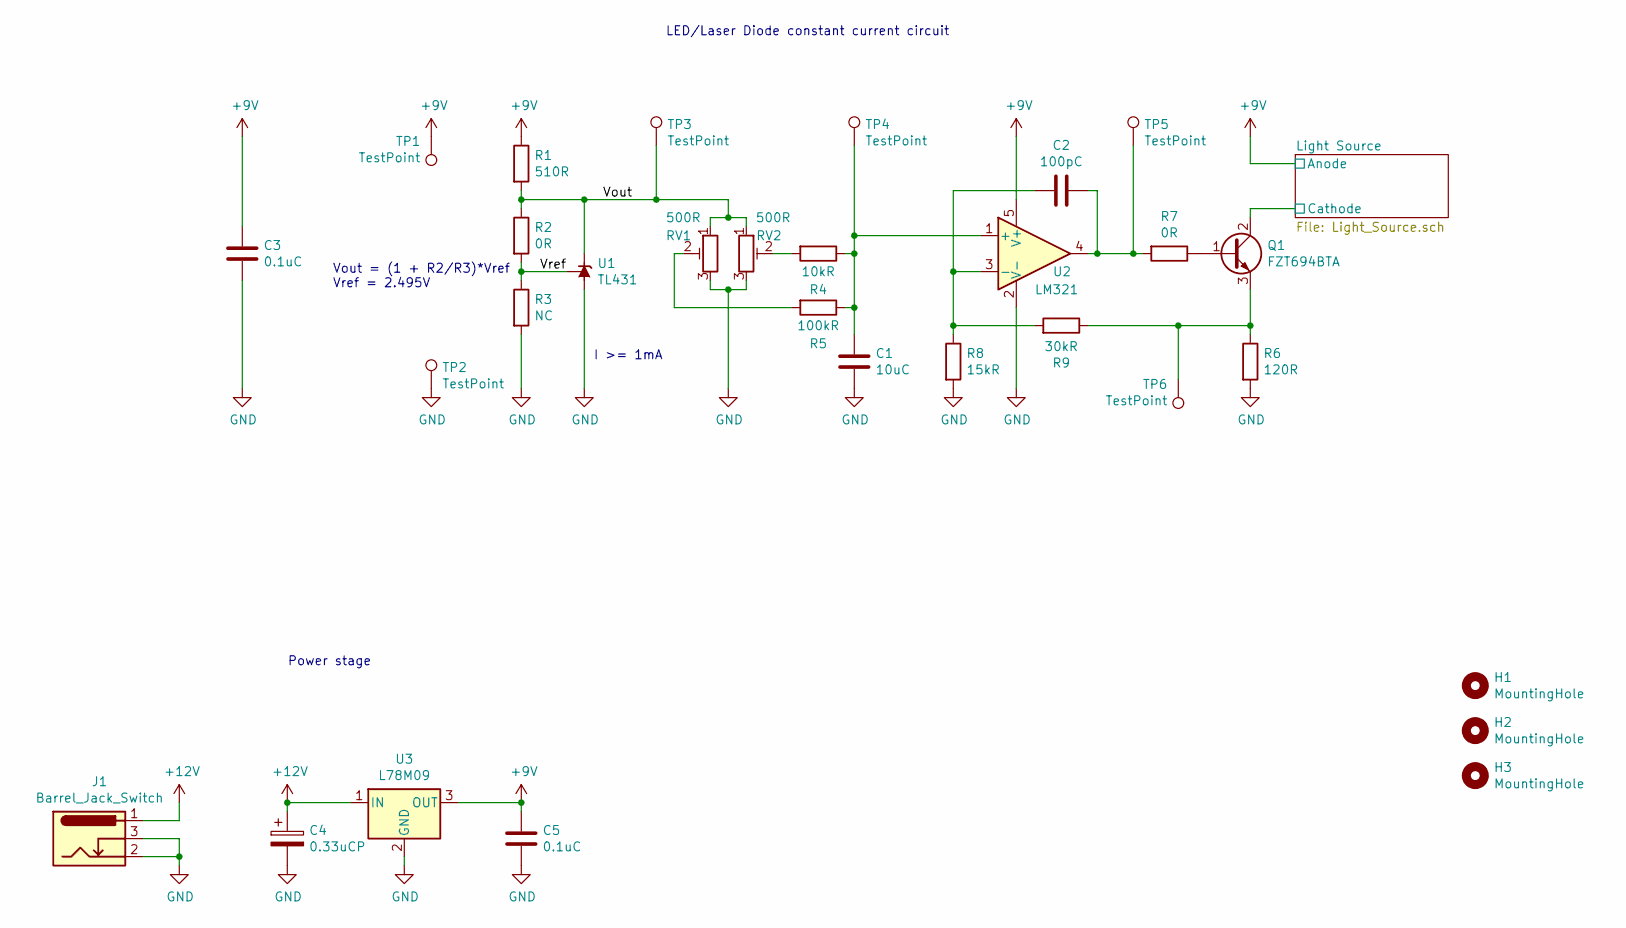
[picture p172: schematic LightSource.sch]

Parts:
C1: 10uC; C_0805_2012Metric_Pad1.18x1.45mm_HandSolder; Manufacturer Part Number CL21A106KAYNNNE
C2: 100pC; C_0805_2012Metric_Pad1.18x1.45mm_HandSolder; Manufacturer Part Number CL21C101JBANNNC
C3, C5: 0.1uC; C_0805_2012Metric_Pad1.18x1.45mm_HandSolder; Manufacturer Part Number CC0805KRX7R8BB104
C4: 0.33uCP; CP_EIA-3216-18_Kemet-A_Pad1.58x1.35mm_HandSolder; Manufacturer Part Number TAJA334K035RNJ
H1, H2, H3: MountingHole; MountingHole_3.2mm_M3_Pad; Manufacturer Part Number N/A
J1: Barrel_Jack_Switch; BarrelJack_Horizontal; Manufacturer Part Number DC-005-20A
Q1: FZT694BTA; SOT-223-3_TabPin2; Manufacturer Part Number FZT694BTA
R1: 510R; R_0805_2012Metric_Pad1.20x1.40mm_HandSolder; Manufacturer Part Number RC0805JR-07510RL
R2, R7: 0R; R_0805_2012Metric_Pad1.20x1.40mm_HandSolder; Manufacturer Part Number RC0805JR-070RL
R3: NC; R_0805_2012Metric_Pad1.20x1.40mm_HandSolder; Manufacturer Part Number N/A
R4: 10kR; R_0805_2012Metric_Pad1.20x1.40mm_HandSolder; Manufacturer Part Number RC0805JR-0710KL
R5: 100kR; R_0805_2012Metric_Pad1.20x1.40mm_HandSolder; Manufacturer Part Number RC0805JR-07100KL
R6: 120R; R_1206_3216Metric_Pad1.30x1.75mm_HandSolder; Manufacturer Part Number Varies
R8: 15kR; R_0805_2012Metric_Pad1.20x1.40mm_HandSolder; Manufacturer Part Number Varies
R9: 30kR; R_0805_2012Metric_Pad1.20x1.40mm_HandSolder; Manufacturer Part Number Varies
RV1, RV2: 500R; Potentiometer_Bourns_3362P_Vertical; Manufacturer Part Number 3362P-1-501LF
TP1, TP2, TP3, TP4, TP5, TP6: TestPoint; TestPoint_Pad_D2.0mm; Manufacturer Part Number N/A
U1: TL431; SOT-23; Manufacturer Part Number TL431IL3T
U2: LM321; SOT-23-5; Manufacturer Part Number LM321MFX/NOPB
U3: L78M09; TO-252-2; Manufacturer Part Number L78M09ABDT-TR

Connections:
+9V: C3.1, C5.1, R1.1, TP1.1, U2.5 (V+), U3.3 (OUT); also elsewhere on the board
+12V: C4.1, J1.1, U3.1 (IN)
/Light Source/Cathode: Q1.2 (C); also elsewhere on the board
/Vout: R1.2, R2.1, RV1.1, RV2.1, TP3.1, U1.1 (K)
/Vref: R2.2, R3.1, U1.2 (REF)
GND: C1.2, C3.2, C4.2, C5.2, J1.2, J1.3, R3.2, R6.2, R8.2, RV1.3, RV2.3, TP2.1, U1.3 (A), U2.2 (V-), U3.2 (GND)
unnamed: C1.1, R4.1, R5.1, TP4.1, U2.1 (+)
unnamed: C2.1, R7.2, TP5.1, U2.4
unnamed: C2.2, R8.1, R9.2, U2.3 (-)
unnamed: Q1.1 (B), R7.1
unnamed: Q1.3 (E), R6.1, R9.1, TP6.1
unnamed: R4.2, RV2.2
unnamed: R5.2, RV1.2

Notes on the sheet:
I >= 1mA
Vout = (1 + R2/R3)*Vref Vref = 2.495V
LED/Laser Diode constant current circuit
Power stage

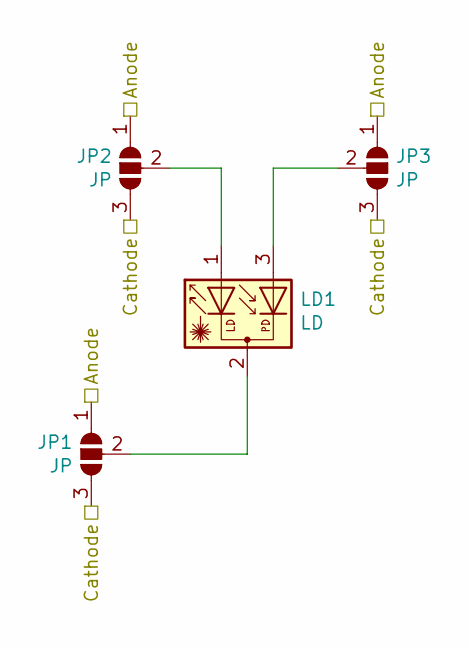
[picture p173: schematic Light_Source.sch]

Parts:
JP1, JP2, JP3: JP; SolderJumper-3_P2.0mm_Open_TrianglePad1.0x1.5mm; Manufacturer Part Number N/A
LD1: LD; LaserDiode_TO18-D5.6-3; Manufacturer Part Number Varies

Connections:
+9V: JP1.1 (A), JP2.1 (A), JP3.1 (A); also elsewhere on the board
/Light Source/Cathode: JP1.3 (B), JP2.3 (B), JP3.3 (B); also elsewhere on the board
unnamed: JP1.2 (C), LD1.2
unnamed: JP2.2 (C), LD1.1
unnamed: JP3.2 (C), LD1.3

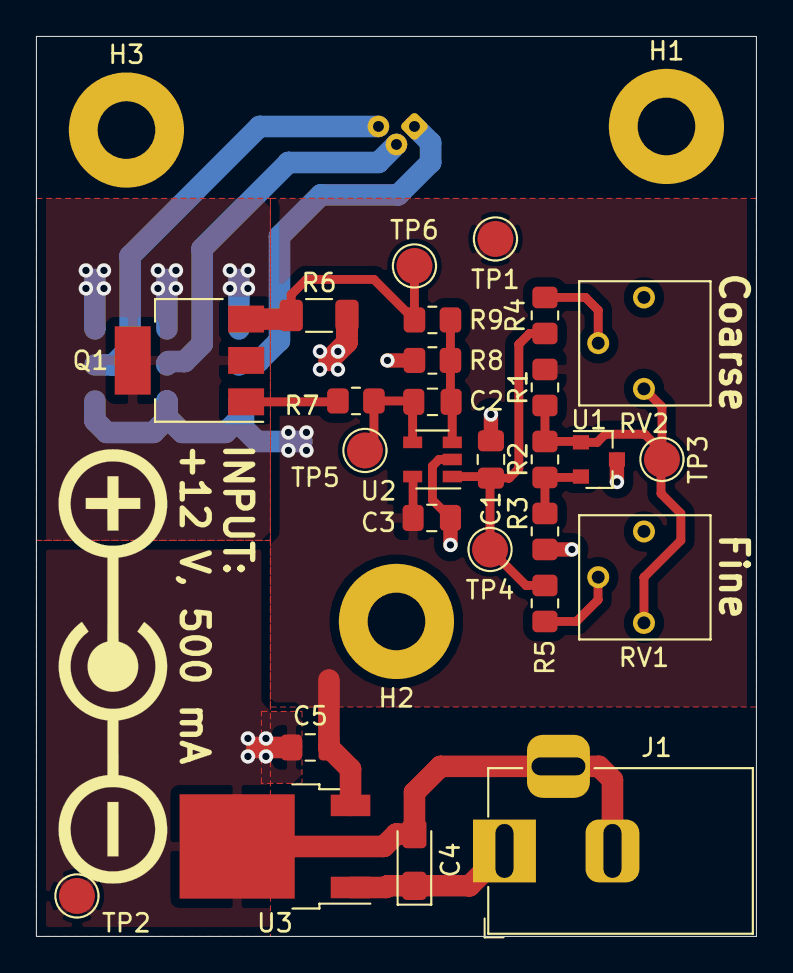
[picture p174: board ECAD/LightSource/LightSource.kicad_pcb from above]

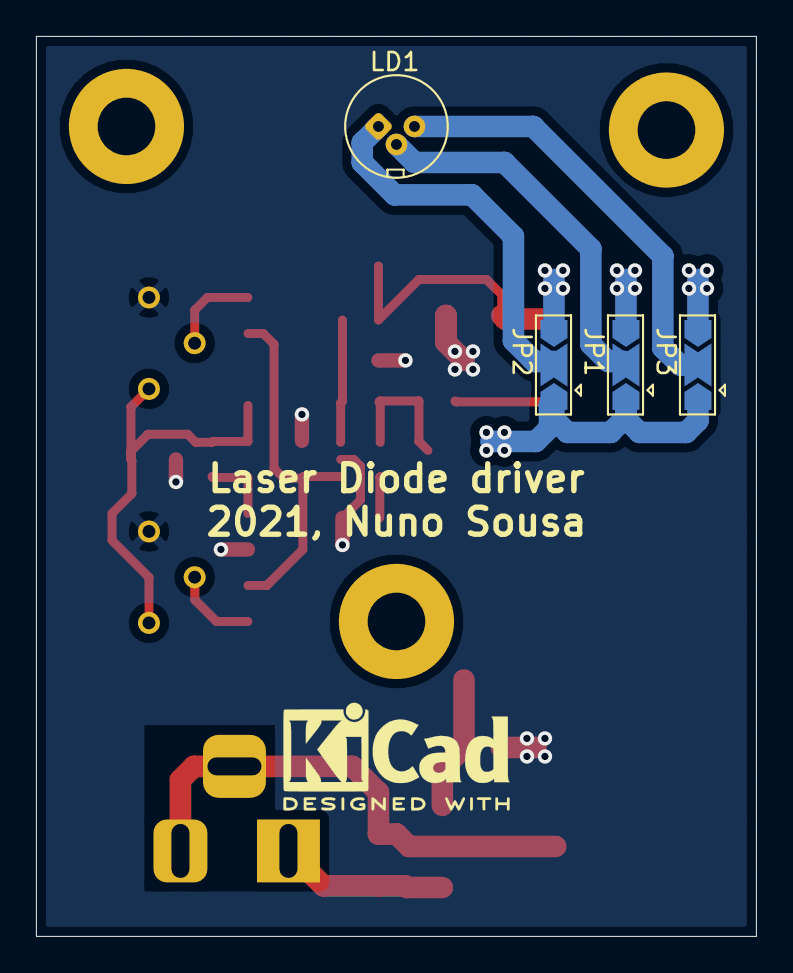
[picture p175: board ECAD/LightSource/LightSource.kicad_pcb from below]

Board: 2 copper layers, 40.0 x 50.0 mm, 34 parts (4 on the bottom side), 16 nets.
