nunosousa/TelescopeMirrorTester/(commit log)

2020-01-13 Progressed mirror test data error analysis.
    [Mirror.py, TelescopeMirrorTester.py]
2020-01-17 Fixed ODE solver issue.
    [Mirror.py, TelescopeMirrorTester.py]
2020-01-31 Trying to fix fitting parameters.
    [Mirror.py]
2020-02-09 Created schematic for the tester optic position sensor.
    [OpticPositionSensor.kicad_pcb, OpticPositionSensor.sch]
2020-02-09 Assigned footprints.
    [OpticPositionSensor.sch]
2020-02-09 Progressed PCD pad.
    [OpticPositionSensor.sch]
2020-02-09 Progressed PCB design.
    [OpticPositionSensor.kicad_pcb, OpticPositionSensor.sch]
2020-02-09 Progressed PCB layout.
    [OpticPositionSensor.kicad_pcb]
2020-02-10 Edited PMW sensor footprint.
    [OpticPositionSensor.kicad_pcb]
2020-02-10 Updated PMW footprint.
2020-02-10 Progresses position sensor pcb.
    [OpticPositionSensor.kicad_pcb]
2020-02-11 Minor PCB update.
    [OpticPositionSensor.kicad_pcb]
2020-02-12 PCB layout
    [OpticPositionSensor.kicad_pcb]
2020-02-12 Minor updates.
    [OpticPositionSensor.kicad_pcb]
2020-02-13 Updates DRC.
    [OpticPositionSensor.kicad_pcb]
2020-02-13 Generated Gerber files.
    [OpticPositionSensor.kicad_pcb]
2020-02-13 Created new laser module project.
    [LaserModule.kicad_pcb, LaserModule.sch]
2020-02-13 Updated Laser Module project.
    [LaserModule.sch]
2020-02-13 Laser diode symbol updates.
    [LaserModule.sch]
2020-02-14 Updated schematic.
    [LaserModule.sch]
2020-02-15 Progressed laser module schematic.
    [LaserModule.sch]
2020-02-15 Minor Laser module updates.
    [LaserModule.sch]
2020-02-16 Reworked Optical Sensor PCB.
    [LaserModule.sch, OpticPositionSensor.kicad_pcb, OpticPositionSensor.sch]
2020-02-19 Progressed laser module layout.
    [LaserModule.kicad_pcb, LaserModule.sch]
2020-02-20 Progressed laser module.
    [LaserModule.kicad_pcb, LaserModule.sch]
2020-02-20 Created ControllerBoard project.
    [ControllerBoard.kicad_pcb, ControllerBoard.sch]
2020-02-20 Updated DRC.
    [LaserModule.kicad_pcb]
2020-02-20 Generated laser module gerbers.
    [LaserModule.kicad_pcb]
2020-02-21 Progressed controller board schematic,
    [ControllerBoard.sch, MCU.sch, MotorControl.sch, SignalInputOuput.sch]
2020-02-22 Progressed motor control.
    [MotorControl.sch]
2020-02-23 Progressed motor control PCB.
    [ControllerBoard.sch, MCU.sch, MotorControl.sch]
2020-02-24 Added the Manufacturer Part Number component field.
    [ControllerBoard.sch, LaserModule.sch, MCU.sch, MotorControl.sch, OpticPositionSensor.sch, SignalInputOuput.sch]
2020-02-24 Progressed component assignment.
    [ControllerBoard.sch, MCU.sch, MotorControl.sch]
2020-02-24 Progressed component assigment.
    [ControllerBoard.sch, MCU.sch, MotorControl.sch, SignalInputOuput.sch]
2020-02-24 Component assigment cont.
    [ControllerBoard.sch, MotorControl.sch, SignalInputOuput.sch]
2020-02-24 Progressed design.
    [ControllerBoard.kicad_pcb, MotorControl.sch]
2020-02-25 Progressed control board schematic.
    [ControllerBoard.sch, MCU.sch, MotorControl.sch, Power.sch, SignalInputOuput.sch]
2020-02-26 Progressed circuit layout.
    [ControllerBoard.sch, MCU.sch, Power.sch, SignalInputOuput.sch]
2020-02-26 Progressed circuit design.
    [ControllerBoard.sch, MCU.sch, Power.sch, SignalInputOuput.sch]
2020-03-03 Started changes for USB powered device.
    [ControllerBoard.sch, USB.sch]
2020-03-07 Added crystal footprint.
    [MCU.sch]
2020-03-18 Generated pcb gerbers.
    [ControllerBoard.kicad_pcb, MCU_PIN_MAPPING.ods]
2020-03-18 Added solder jumpers.
    [LaserModule.kicad_pcb, LaserModule.sch]
2020-03-19 Updated gerbers.
2020-03-19 Added BOM components.
    [LaserModule.sch, OpticPositionSensor.sch]
2020-03-20 Added missing 3d models.
    [ControllerBoard.kicad_pcb, MotorControl.sch, SignalInputOuput.sch, USB.sch]
2020-03-20 Added 3D models.
    [LaserModule.kicad_pcb, LaserModule.sch, OpticPositionSensor.kicad_pcb, OpticPositionSensor.sch]
2020-04-22 Progressed circuit updates.
    [ControllerBoard.kicad_pcb, ControllerBoard.sch, MCU.sch, MotorControl.sch, Power.sch, SignalInputOuput.sch, position_sensor.sch]
2020-04-26 Porogressed pcb.
    [ControllerBoard.kicad_pcb, MCU.sch]
2020-04-27 Porgressed circuit layout.
    [ControllerBoard.kicad_pcb, ControllerBoard.sch]
2020-04-29 Added switch footprint.
    [ControllerBoard.kicad_pcb, SignalInputOuput.sch]
2020-04-29 Removed optics sensor pcb.
    [OpticPositionSensor.kicad_pcb, OpticPositionSensor.sch]
2020-05-01 Upgraded MCU.
    [ControllerBoard.kicad_pcb, MCU.sch]
2020-05-01 Progressed layout.
    [Crystal.xlsx, MCU.sch, MCU_PIN_MAPPING.ods]
2020-05-02 Progressed pcb.
    [ControllerBoard.kicad_pcb]
2020-05-02 Progressec circuit layout.
    [ControllerBoard.kicad_pcb, ControllerBoard.sch]
2020-05-04 Final design updates.
    [ControllerBoard.kicad_pcb, MCU.sch]
2020-05-04 Final updates.
    [LaserModule.kicad_pcb]
2020-09-20 Updated BOM.
    [MCU.sch, Power.sch, SignalInputOuput.sch, position_sensor.sch]
2021-03-28 Copy adafruit board config
2021-03-29 device tree work
2021-03-29 progressed device tree
2021-03-29 progressed device tree file
2021-03-30 progressed device tree and added pmw3360 driver
2021-03-31 Successfull USB UART test.
2021-04-04 Progressec experimental work.
    [SerialCommands.ods]
2021-04-21 Replaced previous logic with built in shell.
    [main.c]
2021-04-24 Experimented with device tree
2021-04-29 progressed pin control
2021-05-01 progressed pwm
2021-05-02 progressed motor control
2021-05-06 progressed dac driver
2021-05-07 progressed driver
2021-05-12 update i2c config
2021-05-14 progressed driver test
2021-05-15 Progressed DAC driver.
2021-05-15 Completed laser driver.
2021-05-21 Progressed driver updates.
2021-05-22 progressed position sensor
2021-06-04 Progressed driver.
2021-06-14 progressed driver demo
2021-06-17 updated driver
2021-06-19 updated pmw3360 3d model
    [PMW3360.FCStd]
2021-06-24 progressed cad
    [3D_Model.FCStd]
2021-06-24 Updated footprins and CAD
    [3D_Stage_Assembly.FCStd, ControllerBoard.kicad_pcb, USB.sch]
2021-09-25 Created new all in one light source.
    [LightSource.kicad_pcb, LightSource.sch, LightSources.sch]
2021-09-26 progressed circuit design
    [LightSource.sch, LightSources.sch]
2021-09-29 progressed schematic
    [LightSource.sch]
2021-10-03 progressed circuit
    [LightSource.sch]
2021-10-21 Created LED source project
    [LightSource.kicad_pcb, LightSource.sch, Light_Source.sch]
2022-01-31 Progressed 3d stage
    [Base.kicad_pcb, Base.kicad_sch, SK12-Body.step, SK12.FCStd, SK8-Body.step, SK8.FCStd, SupportedMicrometer.FCStd]
2022-02-22 updated files
    [3D_Model.FCStd]
2022-02-22 added rod support models
    [SHF12-BodyPad.step, SHF12.FCStd, SHF8-BodyPad.step, SHF8.FCStd]
2022-04-01 Progressed cad.
    [Micrometer.FCStd]
2022-06-13 Added Exported CAD files
    [Limit_Switch_Board-Limit_Switch_PCB_Body.iges, Translation_Stage_XYZ_b-Base_Plate.iges, Translation_Stage_XYZ_b-Elevation_Plate.iges, Translation_Stage_XYZ_b-Foot.iges, Translation_Stage_XYZ_b-Foot001.iges, Translation_Stage_XYZ_b-Foot002.iges, Translation_Stage_XYZ_b-Foot003.iges, Translation_Stage_XYZ_b-Mid_Plate.iges]
2022-06-13 Added more CAD files
    [Position_screw_assembly_w_Motor-Motor_support.iges, Position_screw_assembly_w_Motor-Translation_support.iges]
2022-06-23 Removed files
    [Bearing.FCStd, Belt_Size_Test.FCStd, Handle.FCStd, Hex_Nut_M5_8_15.FCStd, Plastic_Spacer.FCStd, Position_screw_assembly.FCStd, Screw_100mm_5mm.FCStd, Translation_Stage_XYZ_a.FCStd]
2022-07-16 FreeCAD 0.20
    [Foucault_Assembly.FCStd]
2022-07-17 Adjusted - Recomputed
    [Foucault_Assembly.FCStd]
2022-07-17 Progressed CAD; Created ECAD project
    [Foucault_Assembly.FCStd, TranslationStageControl.kicad_pcb, TranslationStageControl.kicad_sch]
2022-07-26 Progressed ECAD
    [TranslationStageControl.kicad_sch]
2022-07-29 Removed project
    [Base.kicad_pcb, Base.kicad_sch]
2022-08-10 Added new project
    [BrushedMotorDriver.kicad_pcb, BrushedMotorDriver.kicad_sch]
2022-08-20 Progressed ECAD.
    [BrushedMotorDriver.kicad_sch, TranslationStageControl.kicad_sch, USB_RS232_Adapter.kicad_sch, h_bridge.kicad_sch]
2022-08-31 Added limit switch board
    [Limit_Switch_Board.kicad_sch]
2022-09-01 Minor updates
    [Position_screw_assembly_w_Motor.FCStd]
2022-10-03 progress ECAD
    [BDCMotorControlBoard.kicad_pcb, BDCMotorControlBoard.kicad_sch, h_bridge.kicad_sch]
2022-11-23 Progessed ECAD
    [BDCMotorControlShield.kicad_pcb, BDCMotorControlShield.kicad_sch, h_bridge.kicad_sch]
2022-12-02 Added fabrication files
    [bom.csv, designators.csv, positions.csv]
2022-12-04 Final version for production
    [BDCMotorControlShield.kicad_pcb, LimitSwitchBoard.kicad_pcb, LimitSwitchBoard.kicad_sch, bom.csv, designators.csv, positions.csv]
2022-12-08 Added schematics.
2023-01-05 Cleaned folder structure
    [35mm_slide.FCStd, 4040_profile.FCStd, Adjusting_screw_assembly.FCStd, Adjusting_screw_assembly_Colapsed.FCStd, ArduinoMount.FCStd, BDCMotorControlShield.kicad_pcb, BDCMotorControlShield.kicad_sch, Base_X_Translation_Assembly_w_Motor.FCStd]
2023-01-22 Create Motor Control.docx
2023-03-26 started on pwm
2023-03-27 Progressed pwm code
2023-03-29 added timer functionality
2023-03-31 added motor process code
2023-04-01 progresses motor control code
2023-04-05 Added adc code.
2023-04-07 progressed adc code
2023-04-08 progress motor limit switch logic
2023-04-09 added low pass filter
2023-04-11 progressed limit switch logic
2023-04-12 progressed led code
2023-04-15 pwm bug fix
2023-04-16 print current in float with printf
2023-04-16 minor change printf float
2023-04-19 Updated ADC sampling logic
2023-04-20 LED behaviour change
2023-04-27 updated motor speed step
2023-05-13 removed wrong line terminators
    [uart.c]
2023-05-29 updated motor speed reading
2023-05-30 first pid tests
2023-06-01 progressed pid
2023-06-06 updated pid gains
2023-06-07 minor motor state status updates
2023-06-21 progressed camera capture script
2023-06-25 progress frame processor
2023-07-04 progressed new foucault assembly
    [Foucault_test_head_improved.FCStd, Knife.FCStd, Knife_long.FCStd]
2023-07-15 new cad files
    [Foucault_test_head_extra_improved.FCStd]
2024-04-28 Created data collecting shield
    [DataShield.kicad_pcb, DataShield.kicad_sch]
2024-04-28 Added new PCB project.
    [RotationEncoder.kicad_pcb, RotationEncoder.kicad_sch]
2024-09-14 Added Gerbers.
    [DataShield-B_Cu.gbl, DataShield-B_Mask.gbs, DataShield-B_Paste.gbp, DataShield-B_Silkscreen.gbo, DataShield-Edge_Cuts.gm1, DataShield-F_Cu.gtl, DataShield-F_Mask.gts, DataShield-F_Paste.gtp]
2025-03-09 Restored DataShield board original version.
    [DataShield.csv, DataShield.kicad_pcb, DataShield.kicad_sch]
2025-04-12 Generated Encoder Mount files.
    [Encoder_KP08-EncoderMountBack.iges, Encoder_KP08-EncoderMountFront.iges]
2025-04-12 Minor improvements.
    [Encoder_KP08-EncoderMountBack.iges]
2025-04-12 Minor adjustments.
    [Encoder_KP08-EncoderMountBack.iges, Encoder_KP08-EncoderMountBack.step, Encoder_KP08-EncoderMountFront.iges, Encoder_KP08-EncoderMountFront.step]
2025-04-12 Added new encoder support.
    [Encoder_KFL08.FCStd]
2025-04-13 Added new encoder mount.
2025-04-13 Progressed Encoder_KFL08.FCStd
2025-04-17 Progressed Encoder_Elevation_Plate.FCStd
2025-07-12 Added new BDCMotorControlShield board version
    [BDCMotorControlShieldv2.kicad_pcb, BDCMotorControlShieldv2.kicad_sch, h_bridge.kicad_sch]
2025-07-13 Added BDCMotorControlShieldMega board
    [BDCMotorControlShieldMega.kicad_pcb, BDCMotorControlShieldMega.kicad_sch, h_bridge.kicad_sch]
2025-08-05 Added NAND logic alternatives
    [BDCMotorControlShieldMega.kicad_sch, h_bridge.kicad_sch, motor_control.kicad_sch]
2025-08-10 Update ADC clipper.asc
2025-09-13 Added new board.
    [BDCMotorController.kicad_pcb, BDCMotorController.kicad_sch, adc_input.kicad_sch, external_ram.kicad_sch, h_bridge.kicad_sch, ir_receiver.kicad_sch, lim_sw.kicad_sch, mcu.kicad_sch]
2026-01-20 Changed PCB to 90mm.
    [UM90S.FCStd]
2026-04-01 Progress ECAD.
    [serial_ports.kicad_sch]
2026-04-23 Updated schematic from kicad version 9.0 to 10.0.
    [BDCMotorController.kicad_sch, adc_input.kicad_sch, encoder_mon.kicad_sch, h_bridge.kicad_sch, ir_receiver.kicad_sch, lcd.kicad_sch, lim_sw.kicad_sch, mcu.kicad_sch]
2026-05-30 Motor Control Board Rev A
